flipoyo/MOLONARI1D/hardware/specs/README.md

# Hardware Specifications

This directory contains the hardware specifications and designs for MOLONARI1D monitoring devices.

## Contents

- **v1-until-2024/**: specifications of the first version of the MOLONARI1D device (v1) with all the developpments until 2024 
- **v2-2025/**: all the specifications of the new MOLONARI1D system (v2) developped by the 2025 team

For programming and firmware, see the `hardware/firmware/` subdirectory.
