flipoyo/MOLONARI1D/hardware/specs/v2-2025/sensors/README.md

# Specifications of the MOLONARI 1D device's sensors 

The sensors are all connected to one box that remains under water. The electronics is detailed in **hardware/firmware**

## Contents 

- **box/**: Building of the metal box 
- **differential pressure sensor/**: Specifications of the pressure sensor with calibration
- **shaft/**: Specifications and 3D printing files for the shaft
- **temperature sensor/**: Specifications of the temperature sensor with calibration
