flipoyo/MOLONARI1D/hardware/specs/v2-2025/relay/README.md

# Specifications of the relay 

The relay is constituted of a box on the riverbank in which an electronic circuit with an antenna and a 3.7V Li-ion battery is put. 

Here is a picture of the box on the riverbank : 

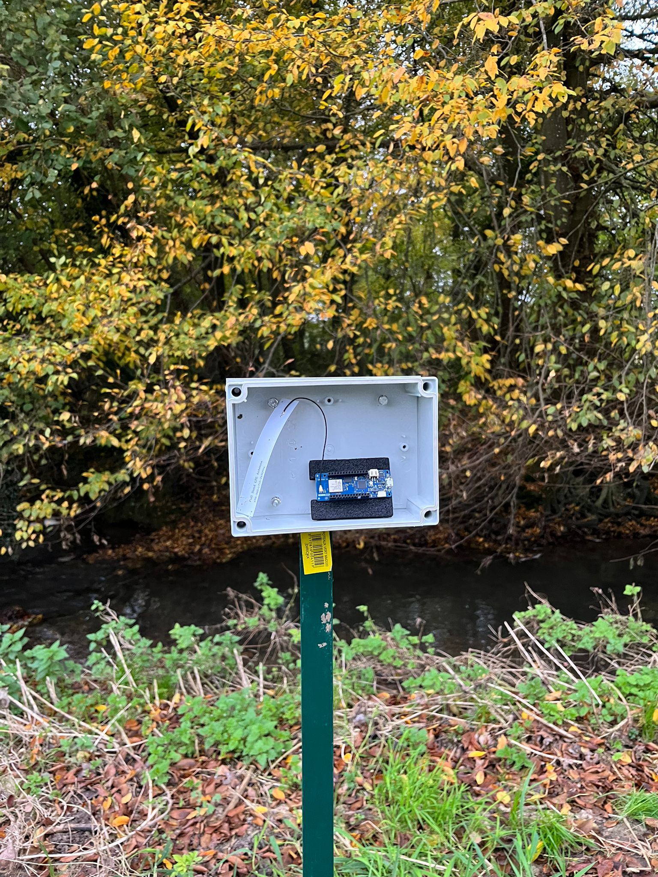
[picture p10: hardware/specs/v2-2025/relay/relai_box.jpeg]
Relay box


For specifications of the electronic circuit, please consult 'hardware/specs/v2-2025/electronic connexion/Readme.md'.
