flipoyo/MOLONARI1D/hardware/specs/v1-until-2024/differentialPressureSensor/README.md

# Building the differential pressure sensor

Find the component list in XXXX

The building scheme in XXXX

The device includes a pressure differential measurement system that needs a sacrificial tip. Its dimensions are given in dimensionSacrificialTip.JPG
