flipoyo/MOLONARI1D/hardware/specs/v1-until-2024/distributedTemperatureSensor/README.md

# Building the distributed temperature sensor

Find the component list in XXXX

3D printing files and dimensions for the thermometer shaft are available in the "shaft" folder.
