flipoyo/MOLONARI1D/hardware/docs/5bis - Gateway and server configurations.md

# Backup on the server

After having understood the Lora communication and managed to receive the data in our relay, we must continue with the following communication stages: *communicate with the gateway and send the information to the server*.

First, the configuration of the Gateway, the device we will use to connect our Relay (which is next to the river) with the Server (on the internet).

Second, the configuration of the Server, necessary to receive and process the information without needing to go to the field.

# Materials

The materials we will need are:

- A computer that allows ethernet connection (the classroom computer at Mines can be used)
- Two ethernet cables (one to connect the Gateway to the PC and another to connect to the internet)
- An antenna
- A power supply that provides between 9 and 60V DC

# Gateway Configuration (Robustel R3000 - LG4LA)

The steps to achieve a satisfactory connection with the Gateway are:

0) Start and connect to the Gateway
1) Update Firmware and Applications
2) Establish the internet connection
3) Configure the connection type
4) Extra configurations
5) Error visualization

It is **VERY IMPORTANT** to emphasize from the beginning that, for step (2) if you have any kind of problem, it is necessary to talk to the school's IT department, specifically with Riaz SYED, since the school blocks all types of connections outside the most common ports. Therefore, only they can enable internet connections through different ports.

**Email: riaz.syed@minesparis.psl.eu**

(We strongly recommend contacting Riaz SYED in case of any eventuality, we started talking to him late and if we had done it earlier, we would have saved a lot of time)

## Step 0 - Start and connect to the Gateway

To start, the first thing we need to do is connect the Gateway to the power supply.

Then we need to connect the ethernet cables:
- ETH1 port: connect it to the PC
- ETH0 port: connect it to the Internet

Once this is done, go to a browser and type in the search bar: 192.168.0.1

This should give us access to the Gateway's online interface.

Connection failure: if entering the IP in the browser does not find the page, reverse the connection of the cables in the ethernet ports, this will probably solve the error.

## Step 1 - Update Firmware and Applications

Next, we need to log in to the Gateway's online interface, for which the username and password will be:

- Username: admin
- Password: admin

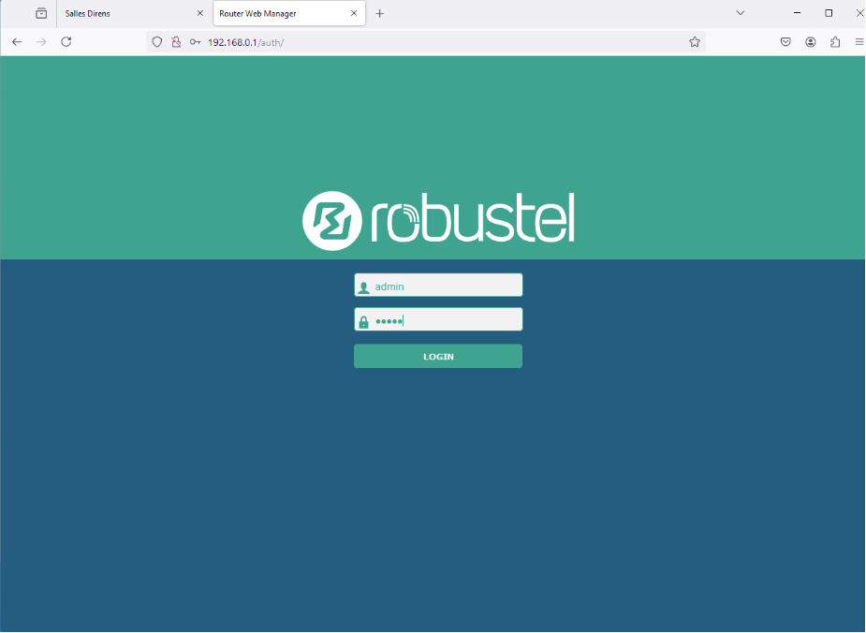
[picture p20: hardware/docs/Images/Robustel_login.png]


Once inside, we will look for the Firmware and applications version.

The Firmware version is in the "Status" section, which opens by default when entering the online interface. Therefore, in the "System Information" section, we can read "Firmware Version".

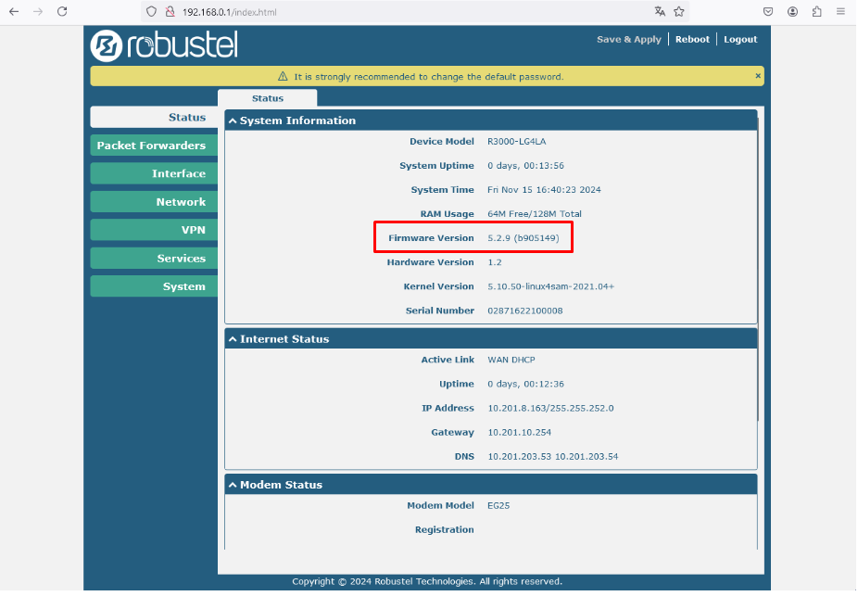
[picture p21: hardware/docs/Images/Firmware_version.png]


The applications version is in the "System" section, in the "App Center" sub-section. There we will see a table called "Installed Apps", where one of the columns is "Version".

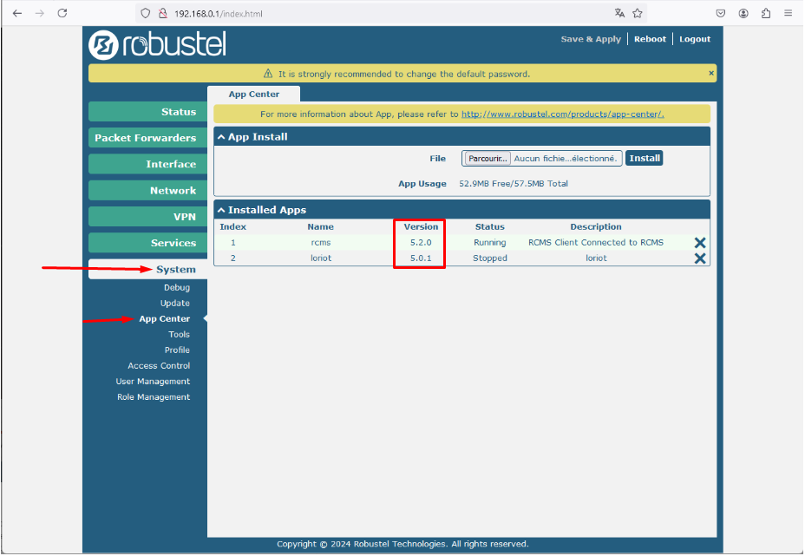
[picture p22: hardware/docs/Images/App_version.png]


Now that we know the versions installed on our device, we need to go to the following provider page:

https://rcms-cloud.robustel.net/rcms/index

Where we need to create an account (with the MINES email it is possible).

Once logged into the page, in the top bar there is a section called "App Center".

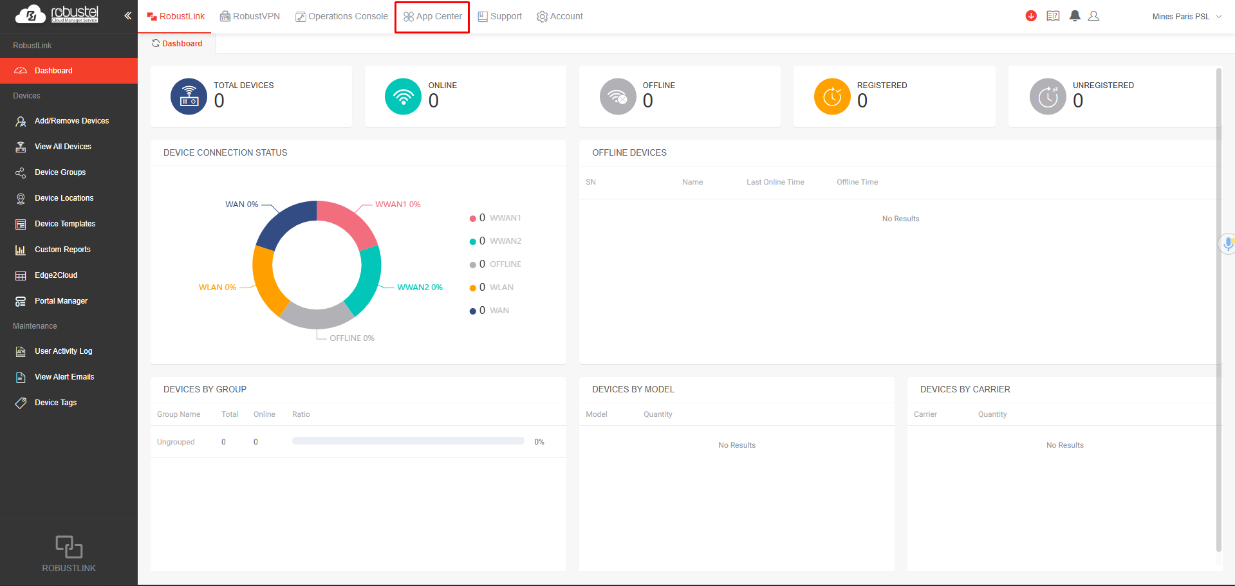
[picture p23: hardware/docs/Images/Robustel_page.png]


Inside there, we have three sections, of which the ones we are interested in are: Firmware and RobustOS App.

In both sections of interest, we must filter by "Series", choosing the option "R3000 LG Series". And what we will do, whether in Firmware or RobustOS App, is to see what is the latest available version compatible with our device.

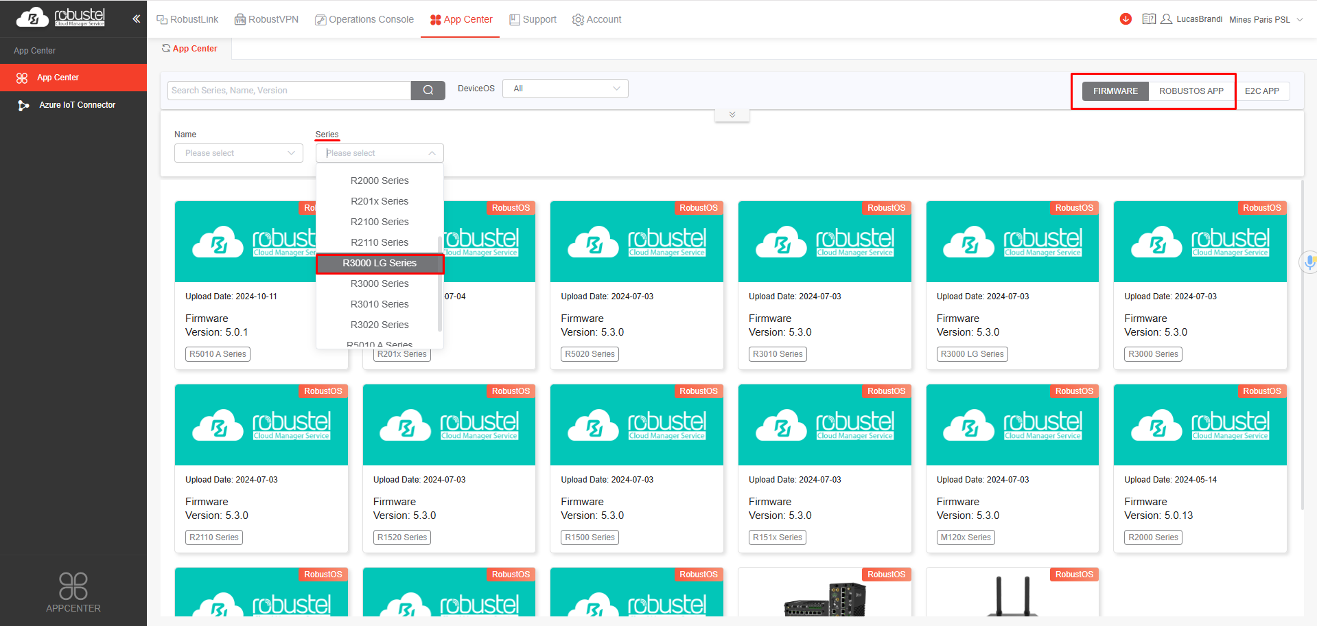
[picture p24: hardware/docs/Images/Uses_app_robustel.png]


If the installed version we saw before matches the latest available version compatible with our Gateway, this section ends here, you can move on to the next one.

If the installed version we saw before does not match the latest available version compatible with our Gateway, what we need to do is the following:

For the Firmware case, we will go to the "System" section, "Update" sub-section. Inside there, we will go to the "Firmware Update" tab, where we will upload the file we downloaded, by clicking on "Browse.." and then update by clicking on "Update".

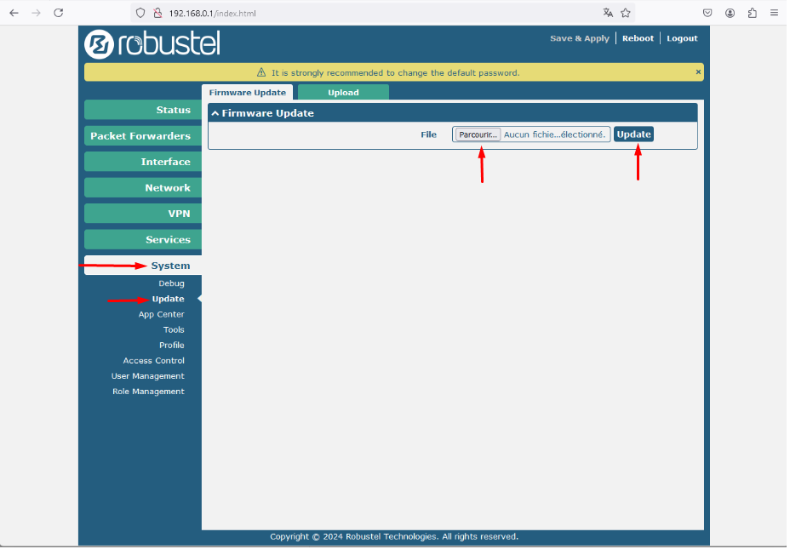
[picture p25: hardware/docs/Images/update_firmware.png]


For the applications case, we will go again to the "System" section, "App Center" sub-section, and there in the "Installed Apps" table we need to do the following:

First, click on the cross on the right to delete the installed versions.

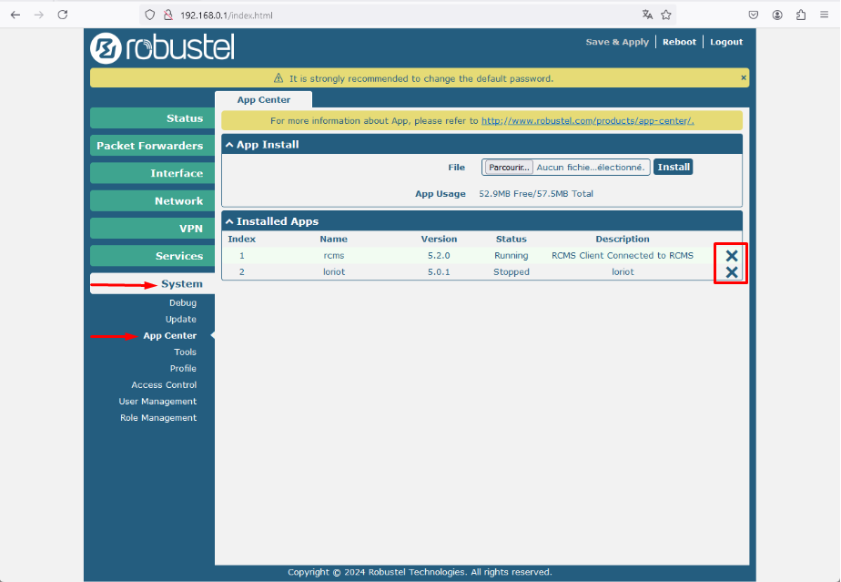
[picture p26: hardware/docs/Images/delete_apps.png]


Then, upload the downloaded files to install them. To do this, click on "Browse.." and then install by clicking on "Install".

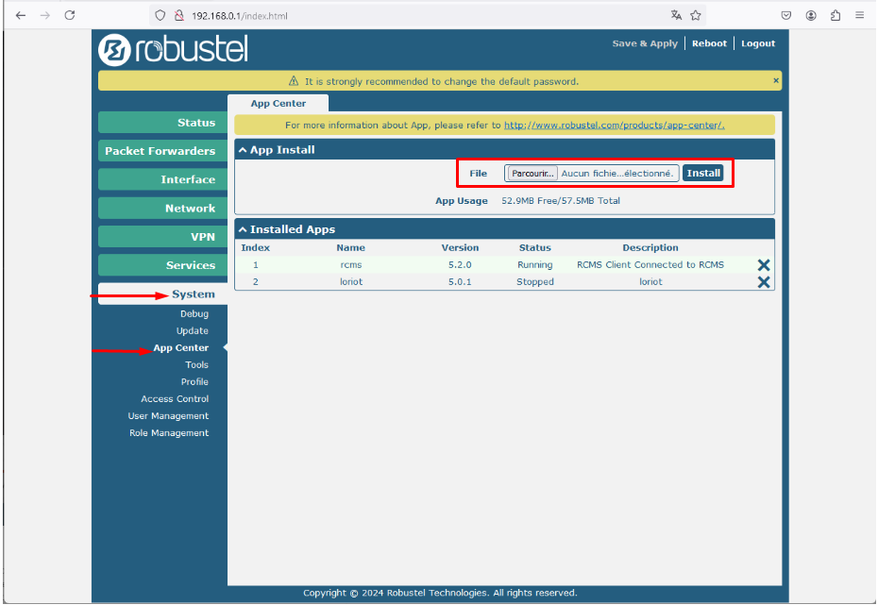
[picture p27: hardware/docs/Images/put_apps.png]


## Step 2 - Establish the internet connection

To verify internet access, we need to go back to the "Status" section of the Gateway's online interface and observe the "Internet Status" part. If it is blank as in the following image:

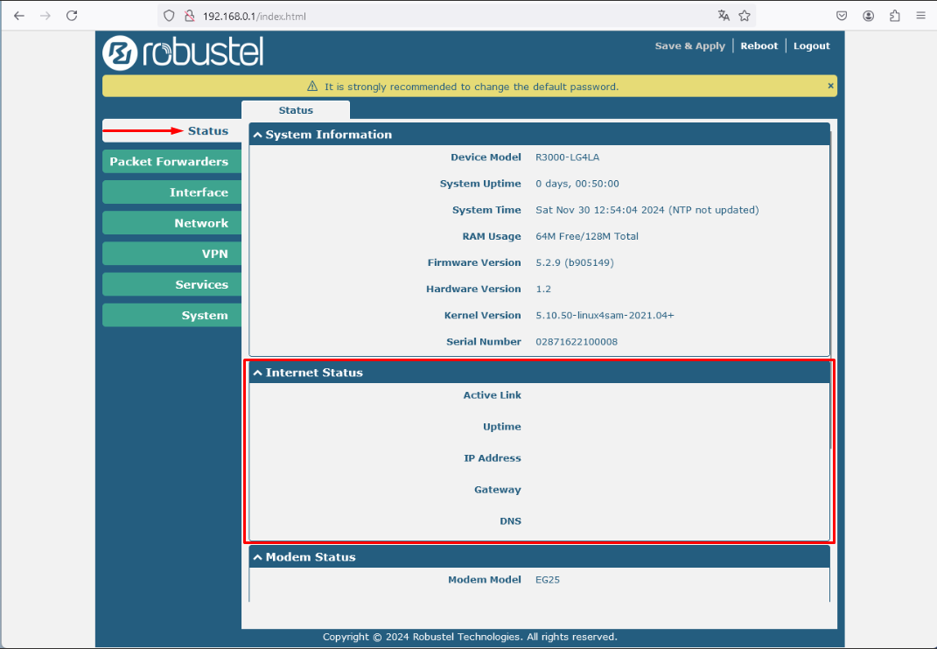
[picture p28: hardware/docs/Images/status_internet.png]


We need to configure the connection as indicated below.

If we see values, as in the following image:

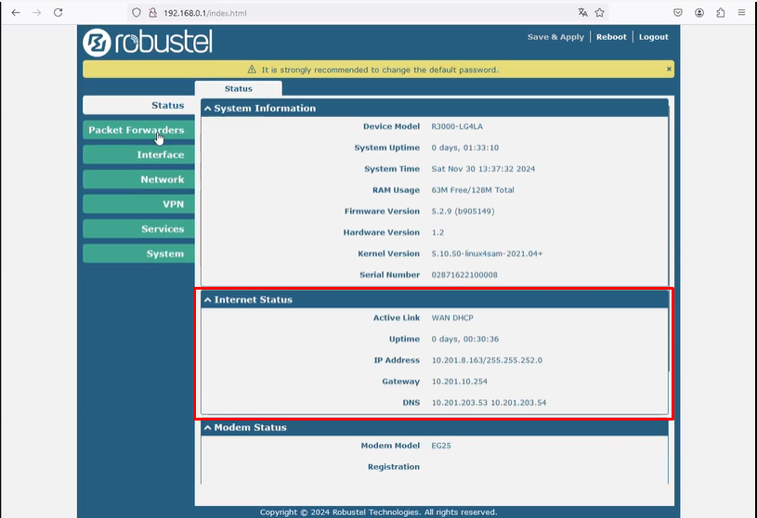
[picture p29: hardware/docs/Images/internet_connection2.png]


It means the connection is established. We can skip the next section and go directly to Verification using Ping.

### Connection configuration

To configure the internet connection, we need to go to the "Interface" section, "Ethernet" sub-section.

Once there, we will see a table called "Port Settings", where each row indicates the characteristics of each ethernet port. This table should look like the following image:

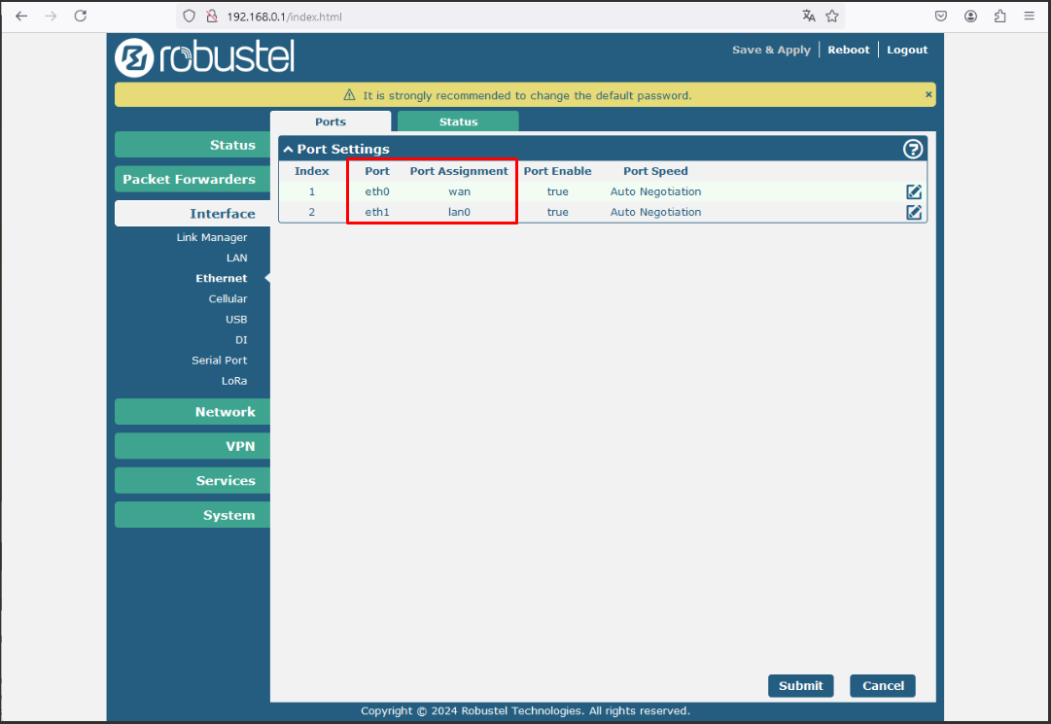
[picture p30: hardware/docs/Images/port_ethernet.png]


Where the most important thing is what the "Port Assignment" column indicates for each of the ports.

If you do not see a table identical to the one above, what we need to do is:

In the row of the "eth0" port, click on the pencil symbol on the right:

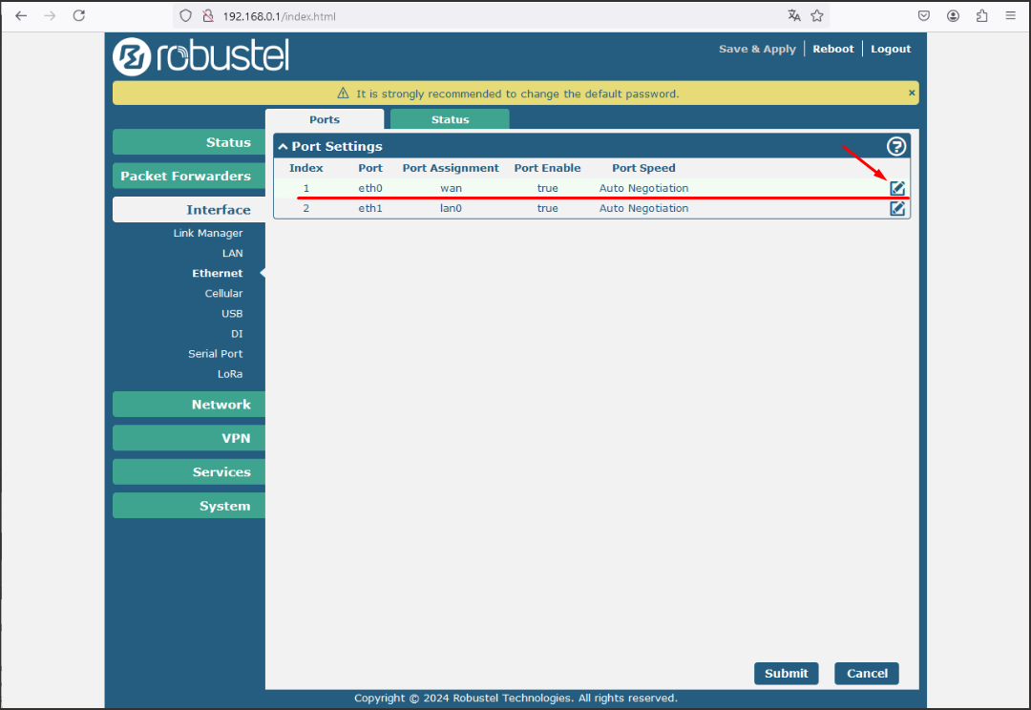
[picture p31: hardware/docs/Images/pencil_eth0.png]


This will open a window called "Port Settings", where what we are interested in is modifying the "Port Assignment", for which we must display the list of options and choose "wan".

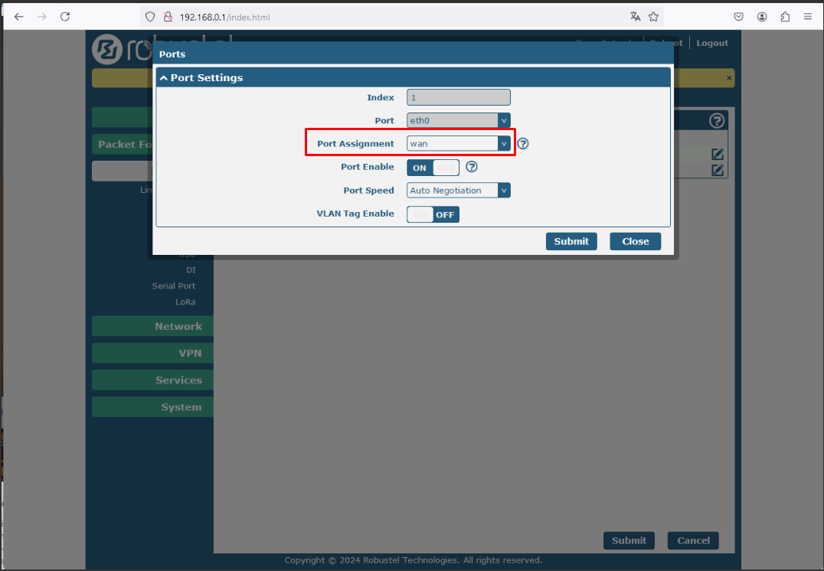
[picture p32: hardware/docs/Images/port_assignement.png]


Then, click on "Submit", and to finish, we must click on "Save & Apply" which we will see in yellow.

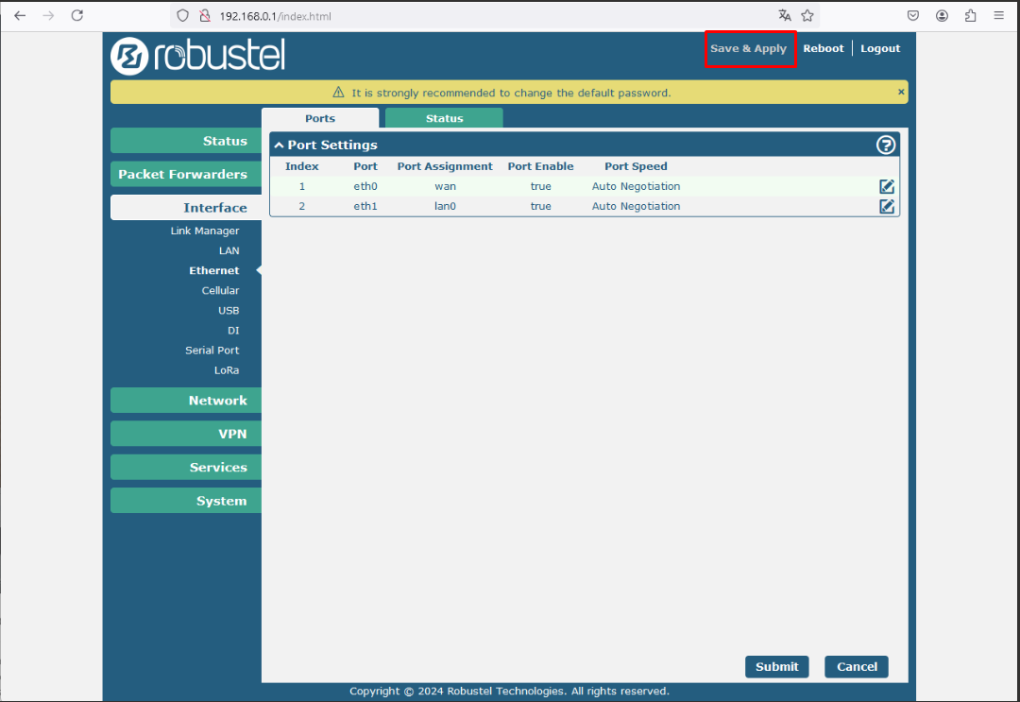
[picture p33: hardware/docs/Images/save_apply.png]


By doing this, the gateway will lose connection to the computer. What we need to do is reverse the connection of the ethernet cables in the ports, being the new connection as follows:

- ETH1 port: connect it to the PC
- ETH0 port: connect it to the Internet

Once this is done, we would have a connection to the Gateway's online interface again, and an internet connection.

To verify it, for safety, the steps indicated in Verification using Ping must be performed.

### Verification using Ping

We will perform the following verification for safety:

We will go to the "System" section, "Tools" sub-section, and in the "Ping" window, we must enter the value: 8.8.8.8 in IP Address.
Then click on "Start".

If the message we get is like the following:

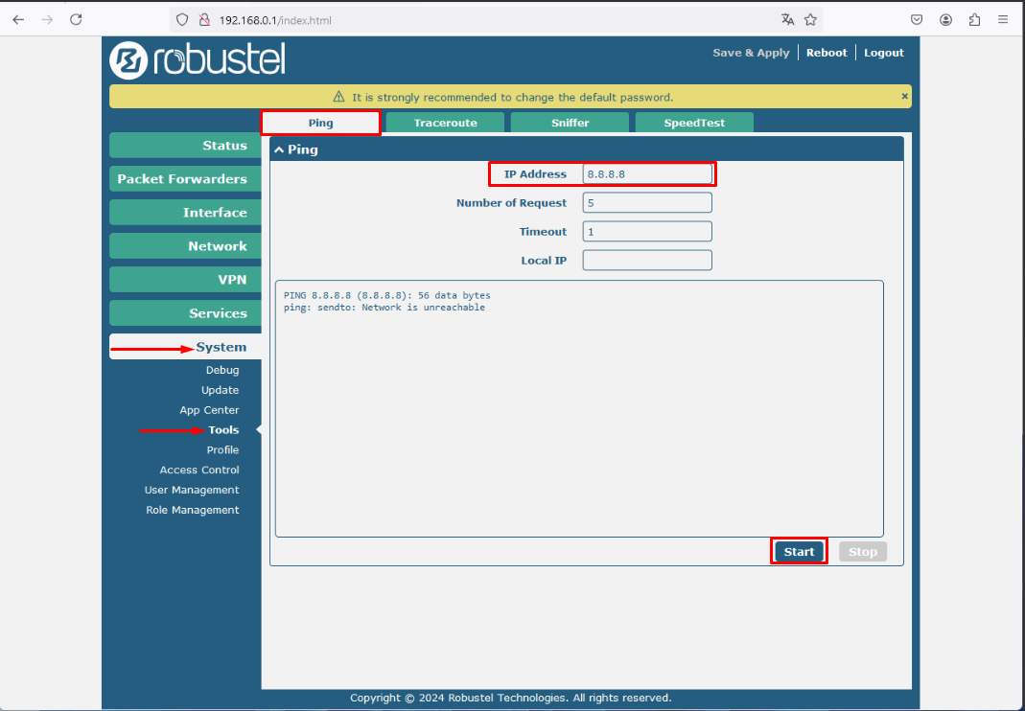
[picture p34: hardware/docs/Images/ping_try.png]


It means the connection was not successful, it is necessary to talk to Riaz SYED, because there is a connection problem and it is probably the school's Firewall.

If the message we get is like the following:

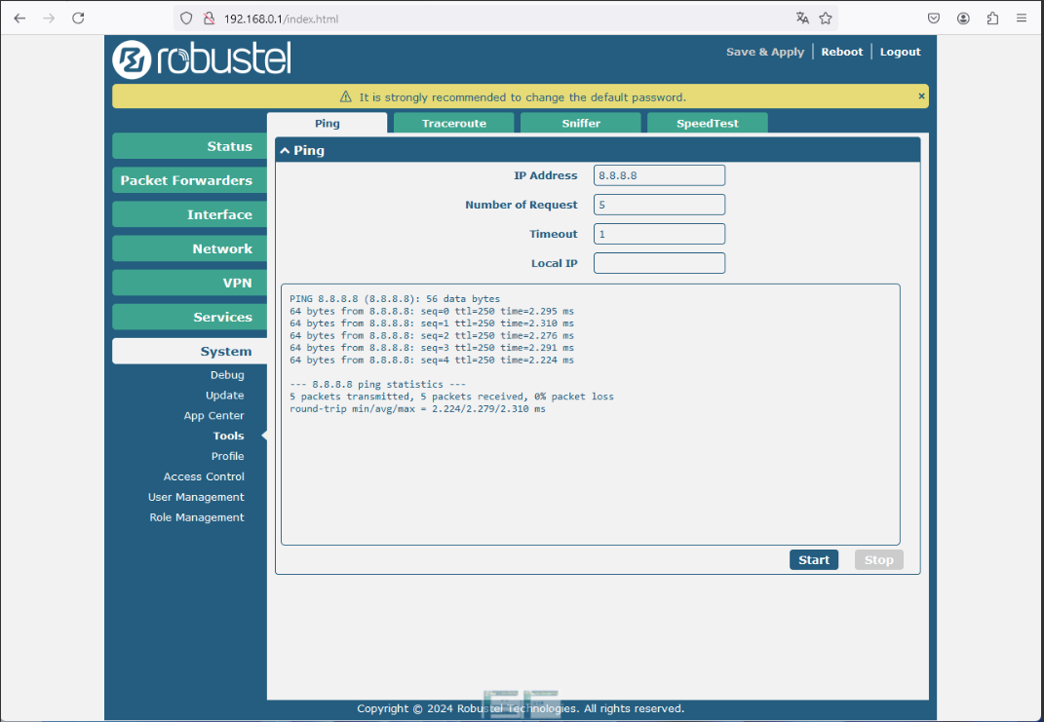
[picture p35: hardware/docs/Images/ping_works.png]


The connection was successful, no configuration changes are necessary, you can move on to the next section.

## Step 3 - Configure the connection type

Here we will configure the type of connection that will be established between the network and the Gateway.

To do this, we must go to the "Packet Forwarders" section, and the first thing we need to do is disable both "Loriot" and "Semtech UDP Forwarder" which we will not use. To do this, we will enter the corresponding sub-sections, and where it says "Enable" we must verify that it is indicated "OFF".

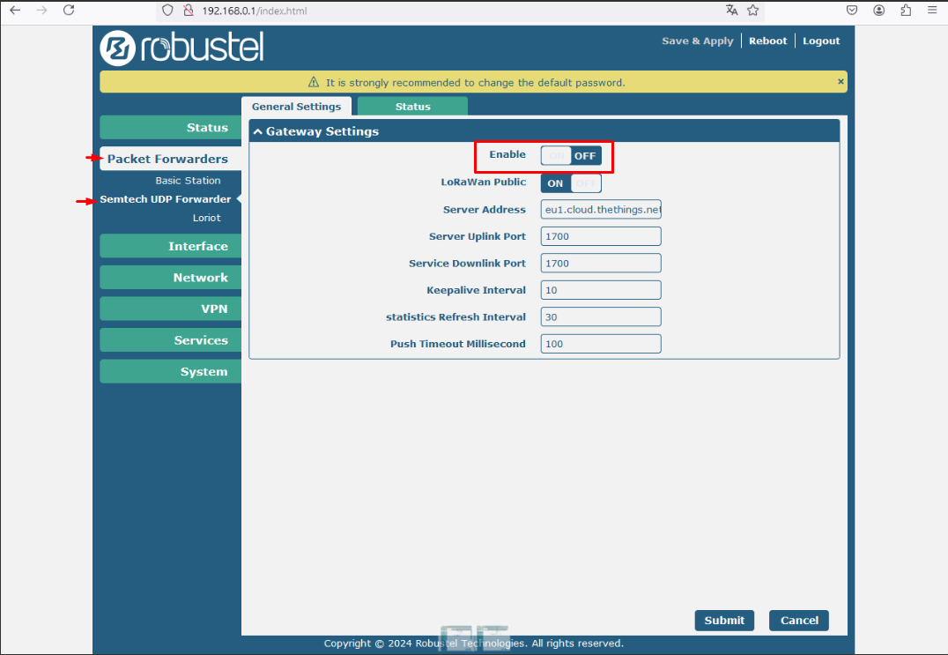
[picture p36: hardware/docs/Images/off_semtech.png]


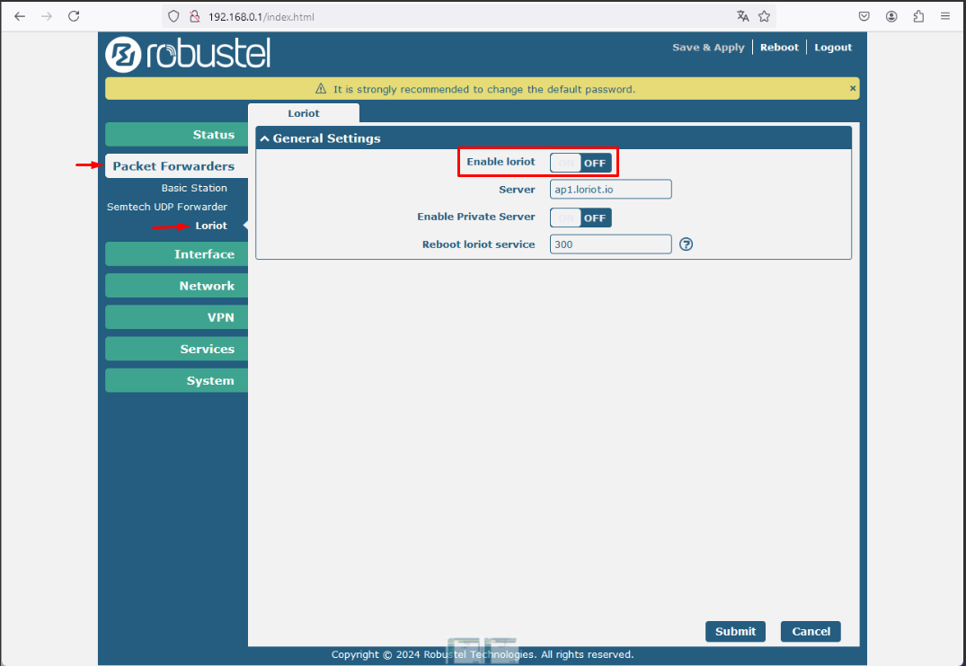
[picture p37: hardware/docs/Images/loriot_off.png]


Once this is done, we will go to the "Basic Station" section which is of interest. And there the necessary configuration is as follows:

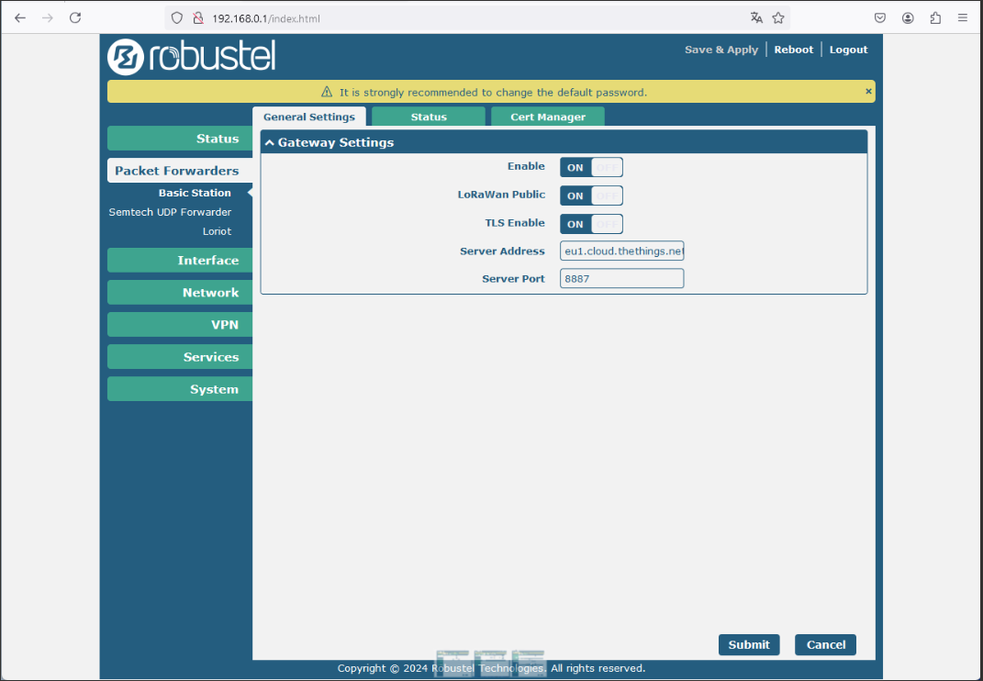
[picture p38: hardware/docs/Images/basic_station.png]


The information to complete is:

- Server Address: eu1.cloud.thethings.network
- Server Port: 8887

And it must be "ON" as seen in the image: Enable, LoRaWan Public, and TLS Enable.

Then, we must go to the "Cert Manager" tab, and there we must upload the "CA Cert" and the "Client Key".

To obtain the "CA Cert" we must go to the following link:

https://letsencrypt.org/certificates/

And download the file provided by the page by clicking on "pem", as indicated in the following image:

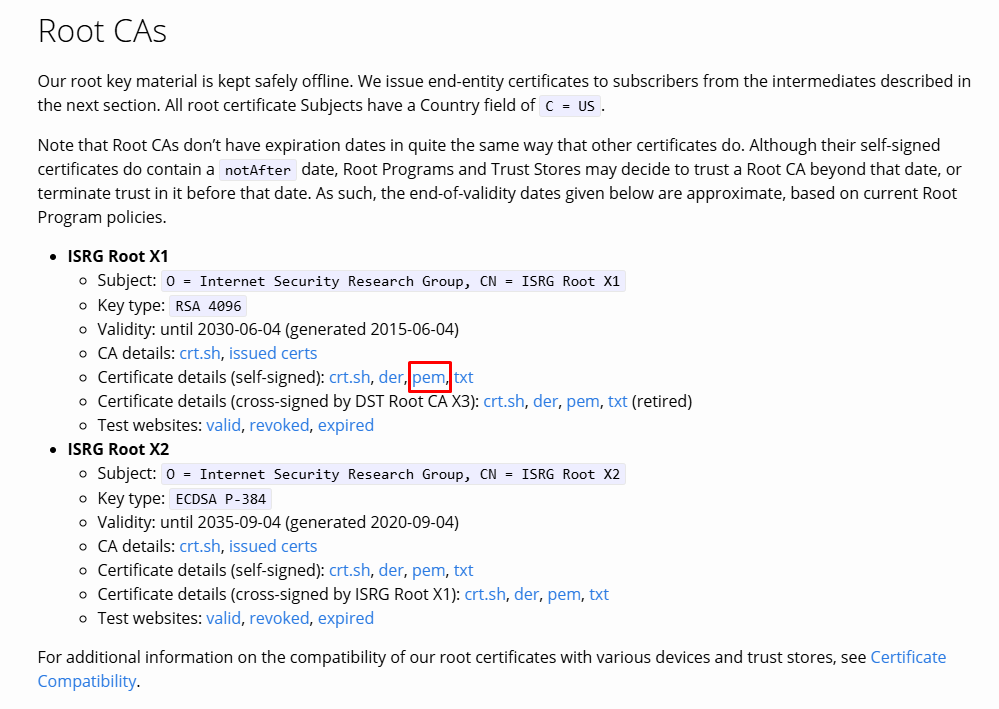
[picture p39: hardware/docs/Images/root_pem.png]


And to generate the "Client Key", we must follow the steps indicated in the following tutorial:

https://www.thethingsindustries.com/docs/gateways/concepts/lora-basics-station/lns/

With these two files downloaded/generated, we can upload them to our Gateway. To do this, we must click on "Browse" and then on "Import".

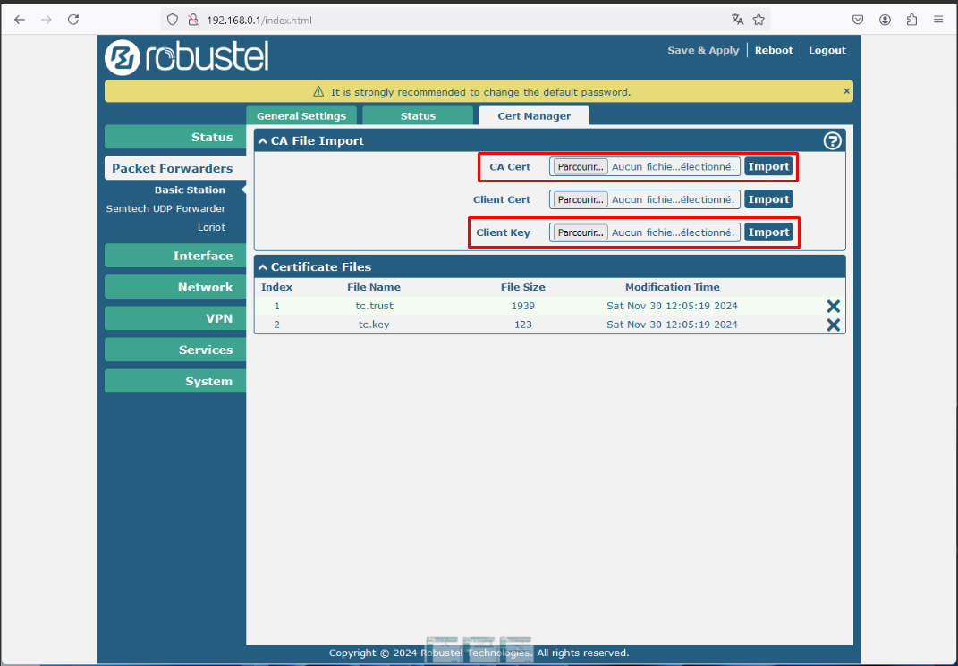
[picture p40: hardware/docs/Images/Cert_manager.png]


And finish by clicking on "Save & Apply", then on "Reboot".

Finally, it is necessary to contact Riaz SYED to request that the selected port associated with the server's IP address be enabled. Therefore, we must send him an email with:

- Server Address: eu1.cloud.thethings.network
- Server Port: 8887

And once Riaz SYED confirms that it has been enabled, we will consider this section finished.

## Step 4 - Extra configurations

Here we will detail some additional configurations that must be made for optimal operation.

An additional configuration for the better operation of the Gateway is to modify the NTP. To do this, we must go to the "Services" section, "NTP" sub-section.

There we will modify the "Time Zone" to: "UTC+01:00"

And in "NTP Client Setting", we must set "Enable" to "ON", and in "Primary NTP Server" the IP will be: pool.ntp.org

The configuration will be:

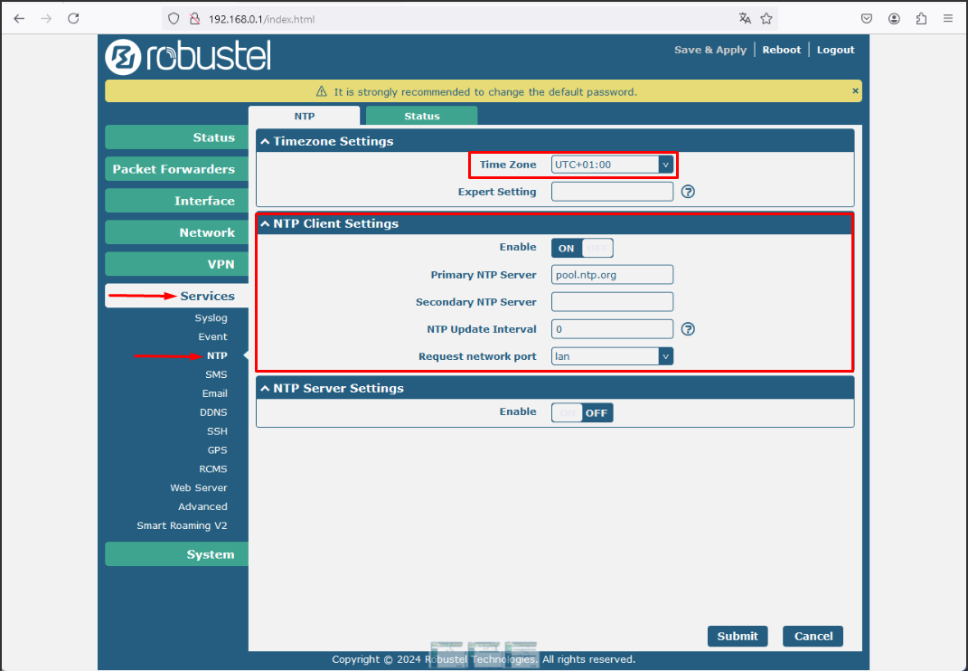
[picture p41: hardware/docs/Images/ntp_config.png]


Here we need to contact Riaz SYED again, because to access this server we need to enable UDP Port 123. Therefore, we must send him an email with the information:

- Server Address: pool.ntp.org
- Server Port: 123

To enable this server.

Another additional configuration, to avoid unnecessary error messages, is to disable the GPS that we will not use, for that we will go to the "Services" section, "GPS" sub-section, and disable all options:

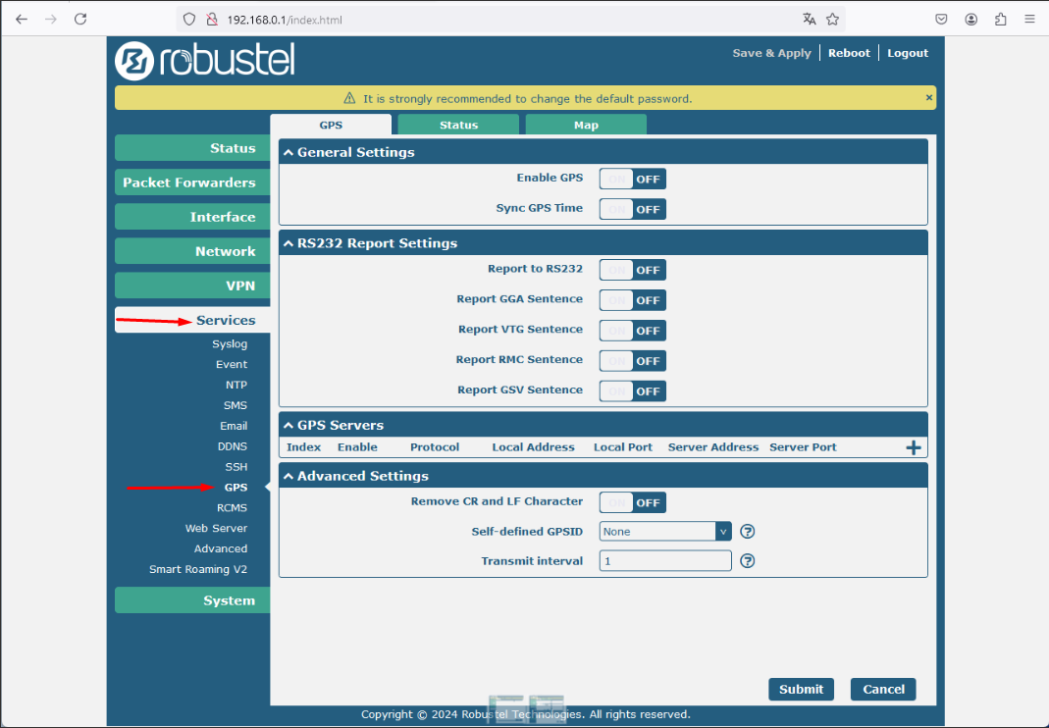
[picture p42: hardware/docs/Images/gps_off.png]


## Step 5 - Error visualization

To visualize that there are no errors, or what type of errors we are having, we must use the "Debug" tab.

To do this, we will go to the "System" section, "Debug" sub-section, and then click on the "Refresh" button to see the existing errors.

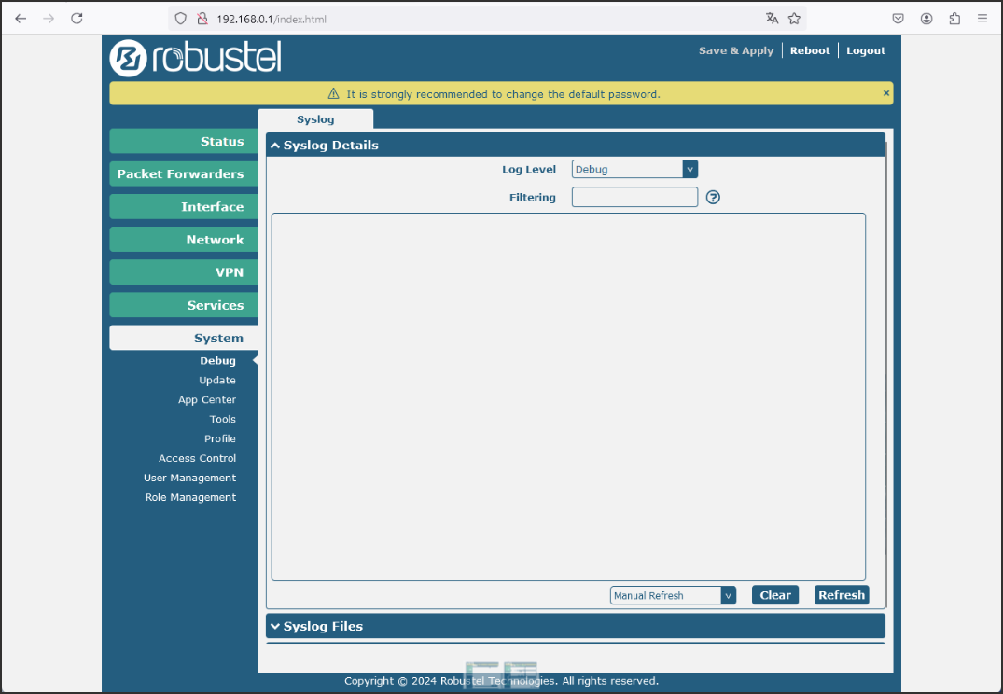
[picture p43: hardware/docs/Images/debug.png]


# Server - The Things Stack SANDBOX

## Server Configuration

### Create a TTN account

First, what we need to do is create an account on The Things Stack Network, for this we will enter the following link:

https://www.thethingsnetwork.org/

And in the upper right corner, click on "Login".

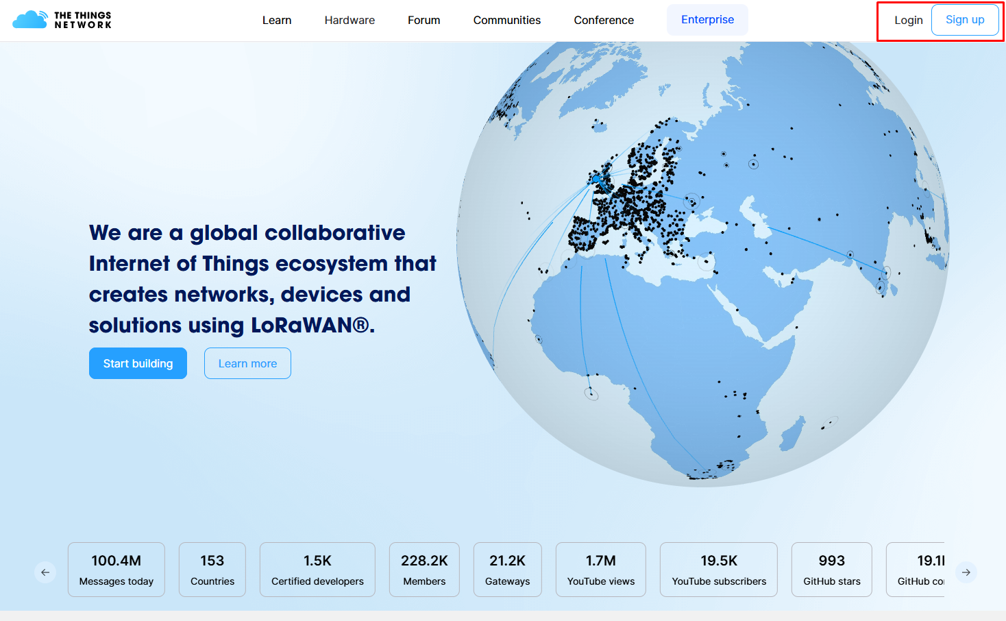
[picture p44: hardware/docs/Images/TTN_login.png]


Then, we choose the option "Login to The Things Network", and there we create an account.

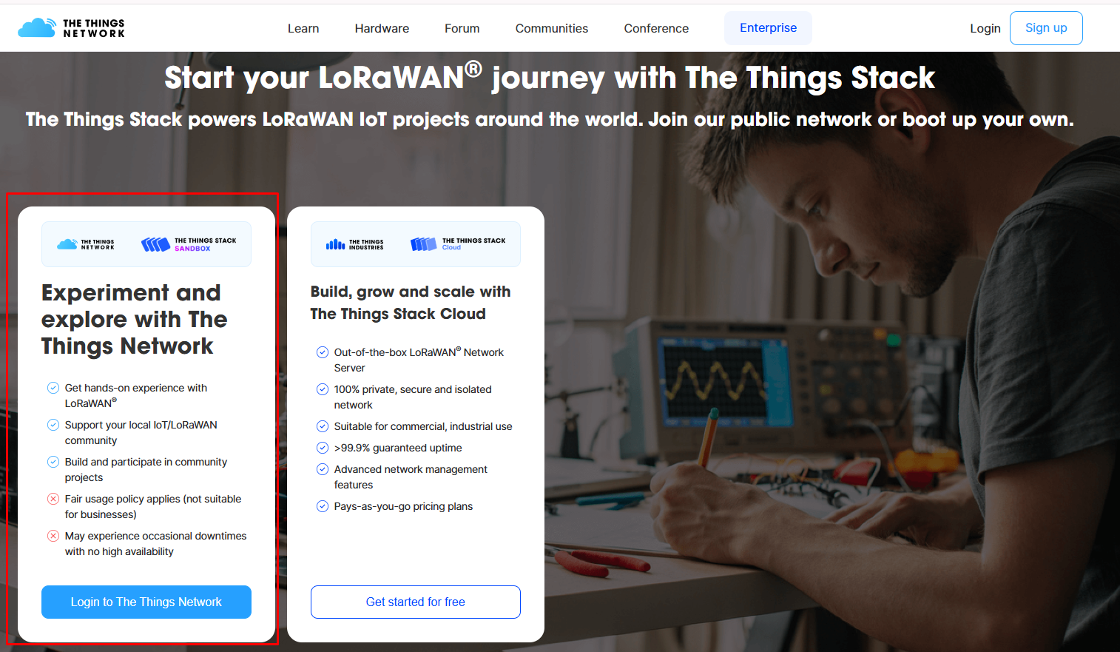
[picture p45: hardware/docs/Images/ttn_login_sesion.png]


Once the account is created, we must go to the upper right margin where the name we gave to the account appears, click, and choose the "Console" option. 

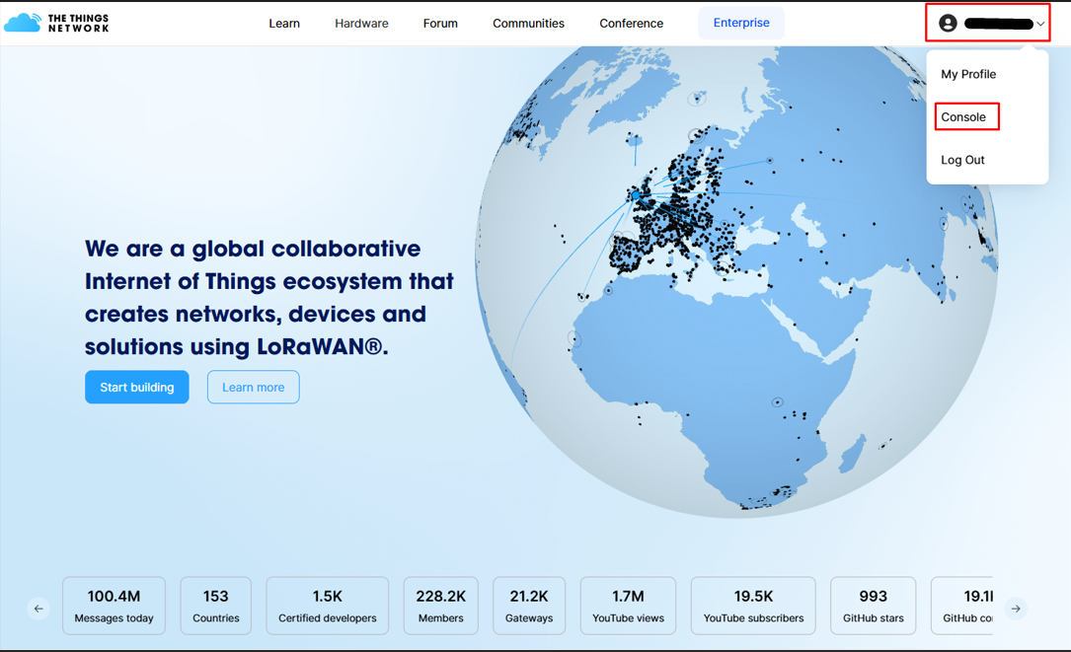
[picture p46: hardware/docs/Images/console2.png]


There, within the "Existing Clusters" we choose: Europe1

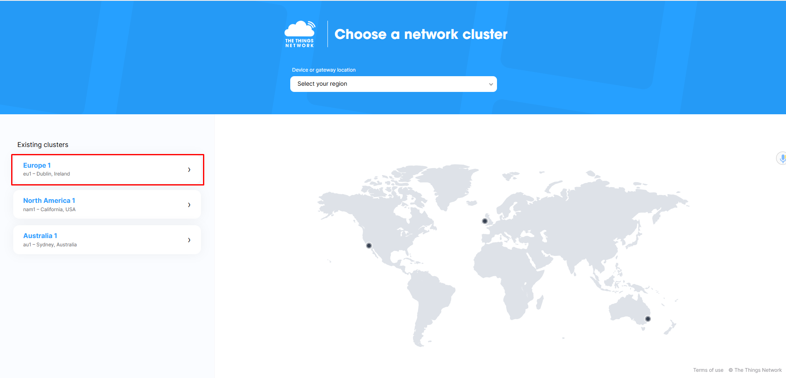
[picture p47: hardware/docs/Images/europe1.png]


Only here can we start configuring the devices, applications, and Gateway within the Server.

### Create the aplication

The first thing we will do is create an application, for this, on the left side we will see three options: Home, Applications, Gateways.

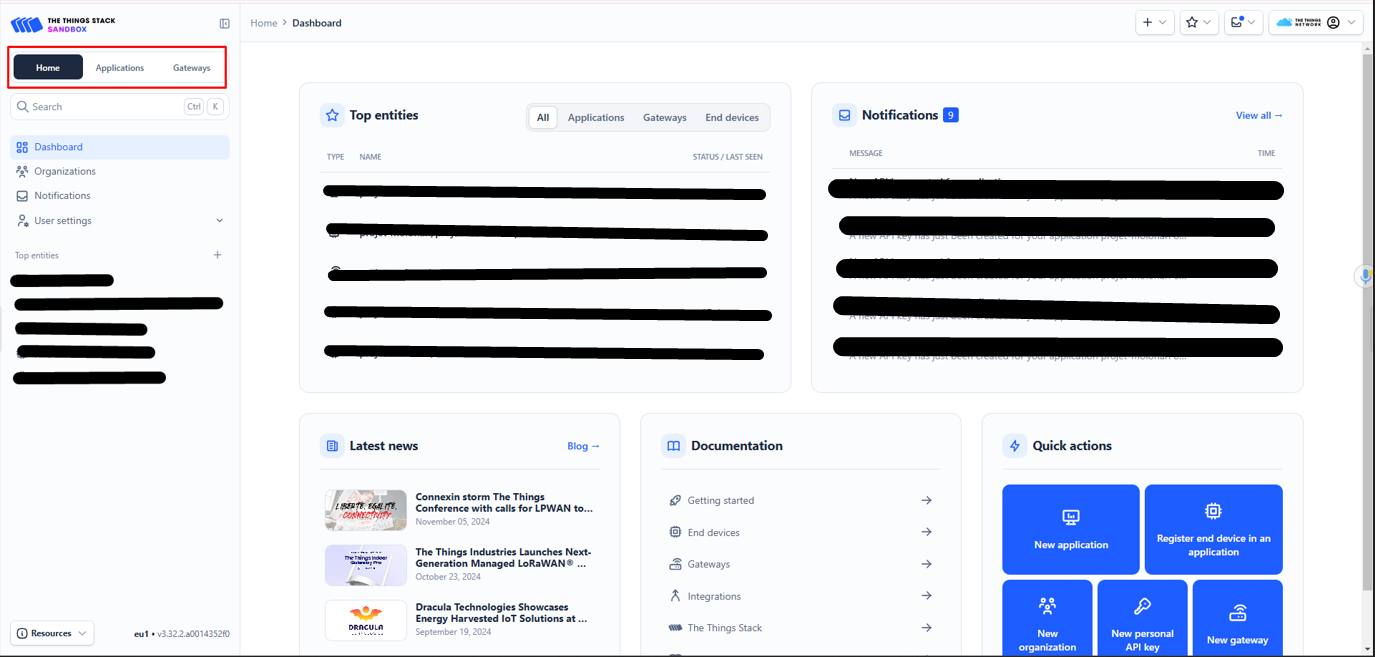
[picture p48: hardware/docs/Images/mainpage_TTN2.png]


Clicking on "Applications" and then on the "Add application" button.

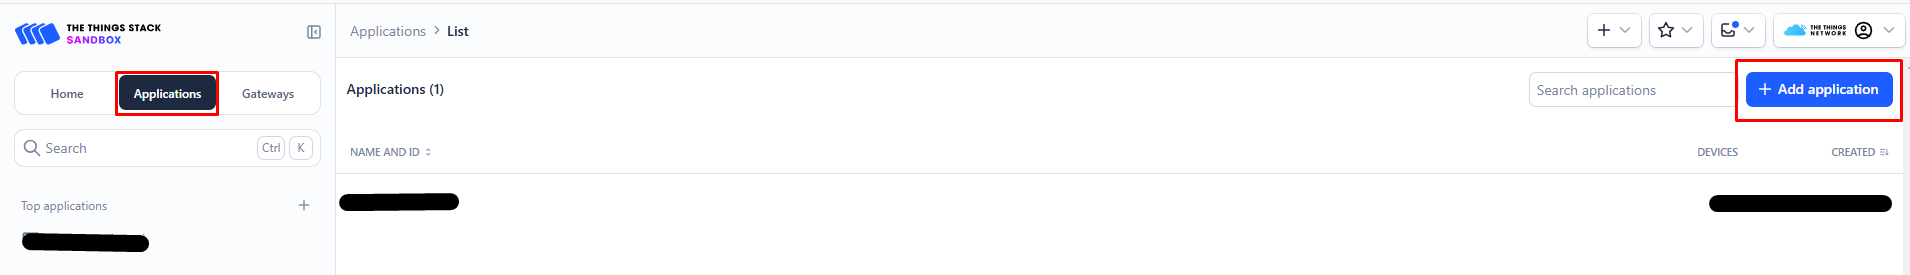
[picture p49: hardware/docs/Images/add_app.png]


We will give the application a name, the one we like the most (for example: "Molonari-Project") and to finish click on "Create application".

### Register the End Devices (the arduinos)

Once the application is created, within it we must register the "End devices", which in our case will be the Arduino that plays the role of the Relay. For this, in the right column, we will find the "End Devices" section, click there, and then on "Register End Device".

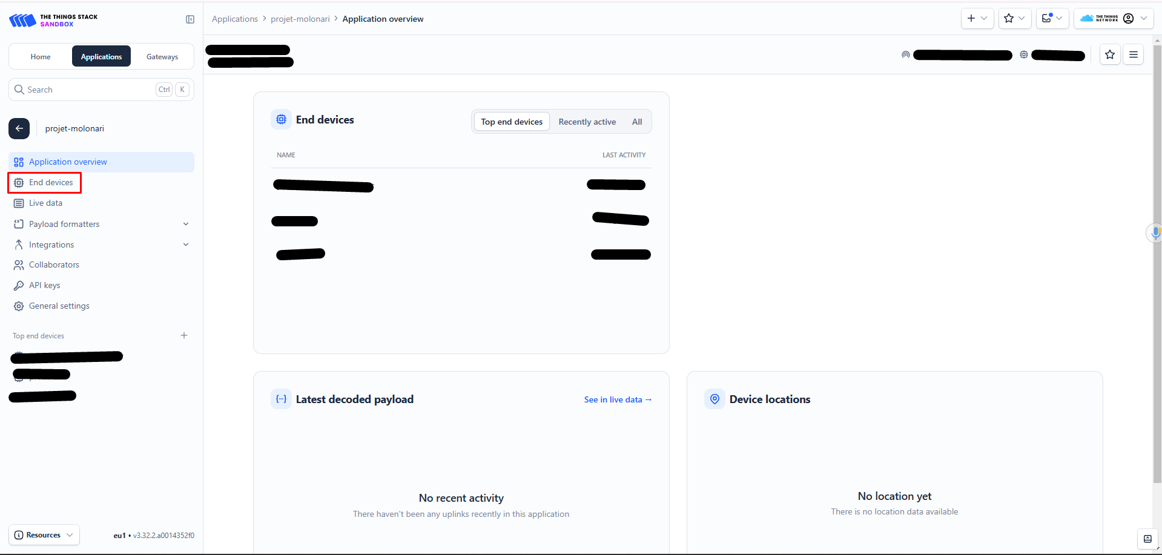
[picture p50: hardware/docs/Images/end_devices.png]


Once inside, we will choose the option "Enter end device specifics manually". And in the options they give us, we will put:

- Frequency plan: Europe 863-870 MHz (SF9 for RX2 - recommended)
- LoRaWAN version: LoRaWAN Specification 1.0.3

Then, within the "Provisioning information" section:

- JoinEUI: 00 00 00 00 00 00 00 00
- DevEUI: the value obtained by using the "DevEUI" code (found in the "Test Codes" folder, inside "testArduinoLoRaWAN") on the Arduino that will be our Relay.
- AppKey: we will generate it by clicking on "Generate"
- End device ID: we will give it the name we want (for example: Molonari-relay)

We will finish by pressing "Register end device".

It is IMPORTANT to emphasize here that the values of JoinEUI, AppKey, and DevEUI will be used in the Relay code to establish a connection with the server, so they must be saved and noted, to later place them in the Relay code. If these parameters are not modified in the code, the connection with the server will not be established.

### Register the Gateway

Finally, we must register the Gateway, for this in the right column we will change the section, and choose the "Gateways" option.

Once inside, click on the "Register gateway" button. 

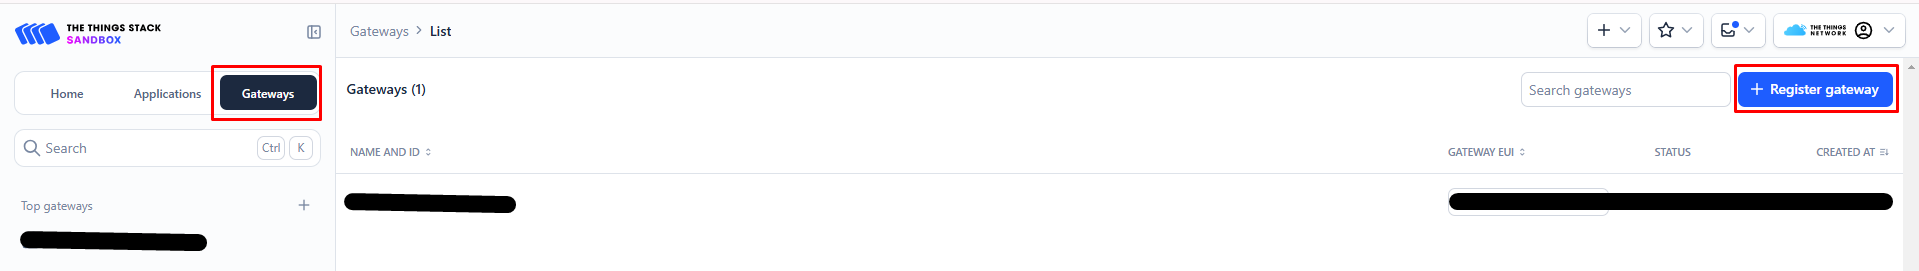
[picture p51: hardware/docs/Images/gateway_ttn.png]


There we must load:

Gateway EUI: this value will be found in the Gateway's online interface, in the "Interface" section, "LoRa" sub-section, it is the value called "Default Gateway ID".

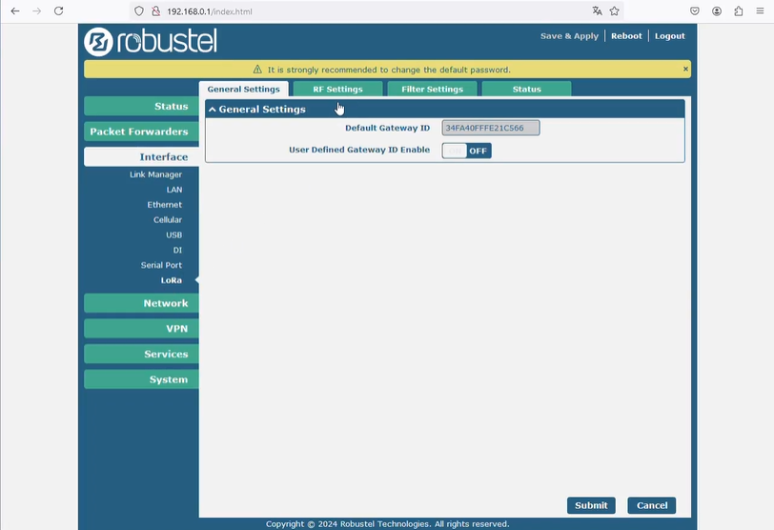
[picture p52: hardware/docs/Images/gateway_ID.png]


Once this value is registered, we must confirm it, and then complete:

- Gateway ID: we put the name we want (for example: Molonari-Gateway)
- Frequency plan: Europe 863-870 MHz (SF9 for RX2 - recommended)
- Require authenticated connection: we must check this option
- Share gateway information: both options are checked by default, we leave it that way.

With all this done, we will have our Gateway and Arduino registered, as well as our application created.
