flipoyo/MOLONARI1D/hardware/specs/v2-2025/README__#Overview_hardware_Molonari_1D_v2.0.md

# V2 Hardware Specifications

This directory contains the hardware specifications and designs for the version of MOLONARI1D monitoring devices (v2) developed by the 2025 team.

## Contents 

- **sensors/**: Specifications related to the pressure and temperature sensors
- **relay/**: Specifications of the relay
- **gateway/**: All the specifications related to the gateway
- **costs/**: Documents related to the costs audit
- **electronic connexion/**: Specifications of the electronic circuits (Arduino+Adalogger) used for the telecommunication and the taking of measurements 

## Overview of the complete MOLONARI1D System

## In the riverbed
### Metal Box with weight, seal and cover

Metal box with weight 

Seal and cover 

### Plastic hosepipe

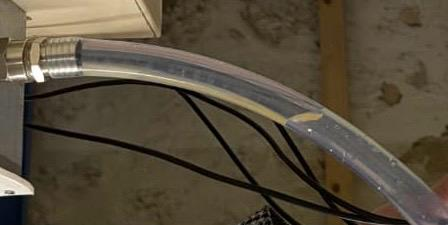
[picture p55: hardware/specs/v2-2025/Images/hose_pipe.jpg]
Hosepipe


It connects the shaft to the metal box.

### Shaft 

Shaft

### 5 Temperature Sensors

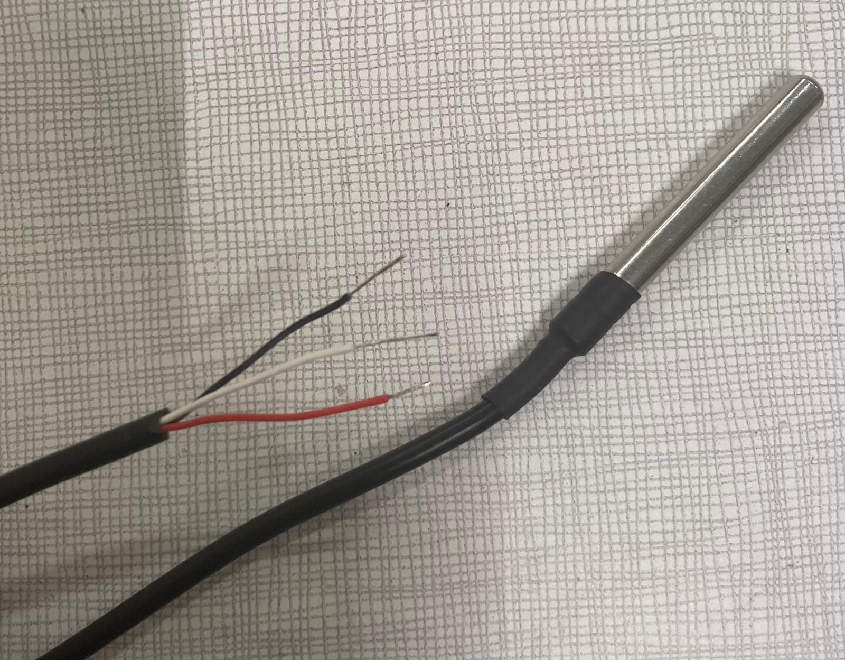
[picture p56: hardware/specs/v2-2025/Images/capteur_temperature_avec_cables.jpg]
Temperature sensor


### Electronic circuit with battery and waterproof antenna

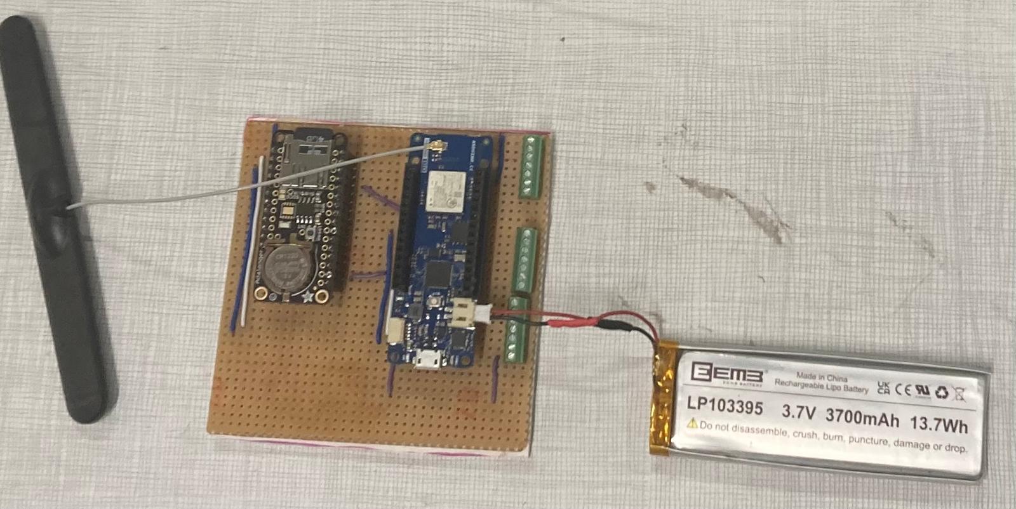
[picture p57: hardware/specs/v2-2025/Images/circuit_capteurs_avec_antenne_et_batterie.jpg]
Electronic circuit


It is inside the metal box.

### Pressure Sensor 

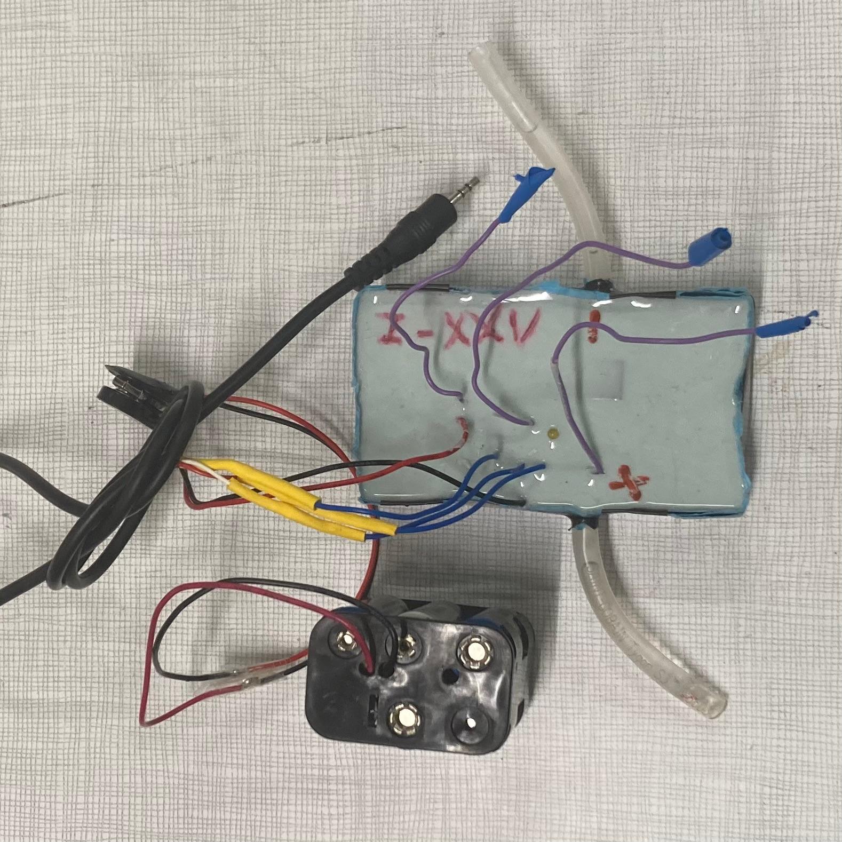
[picture p58: hardware/specs/v2-2025/Images/capteur_de_pression_avec_piles.jpg]
Pressure sensor


It is inside the metal box. 

### All components together

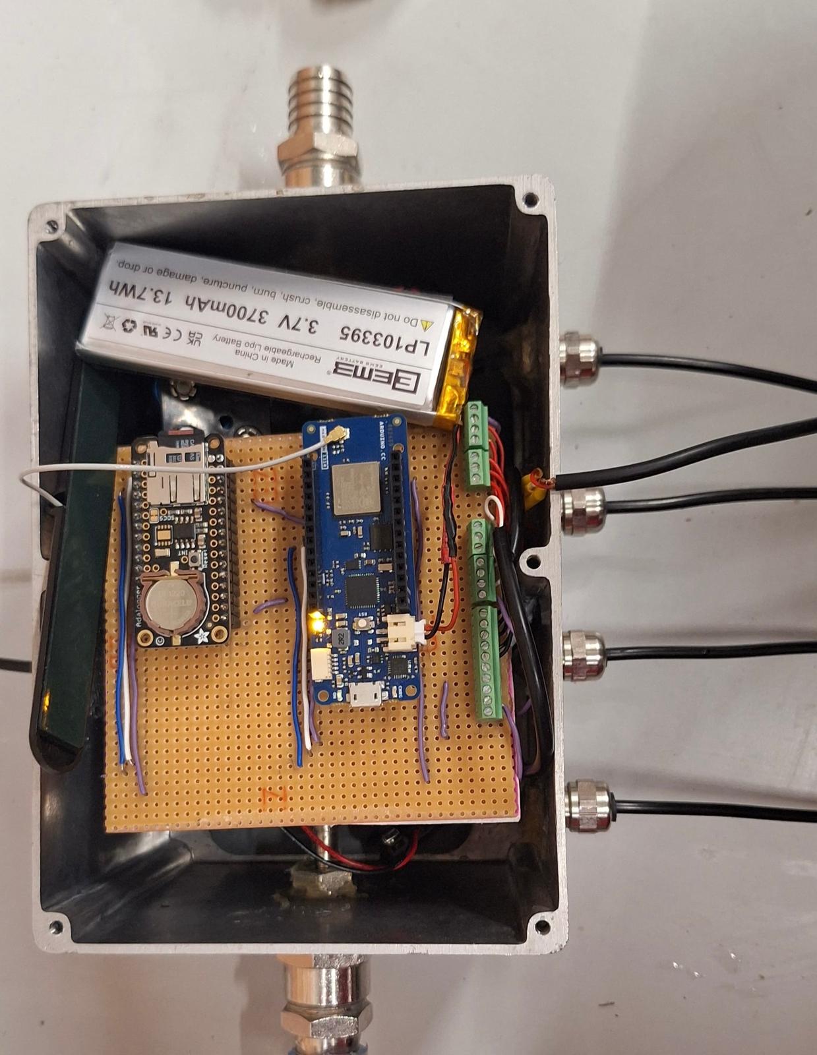
[picture p59: hardware/specs/v2-2025/Images/box_inside_1.jpg]
Box from inside


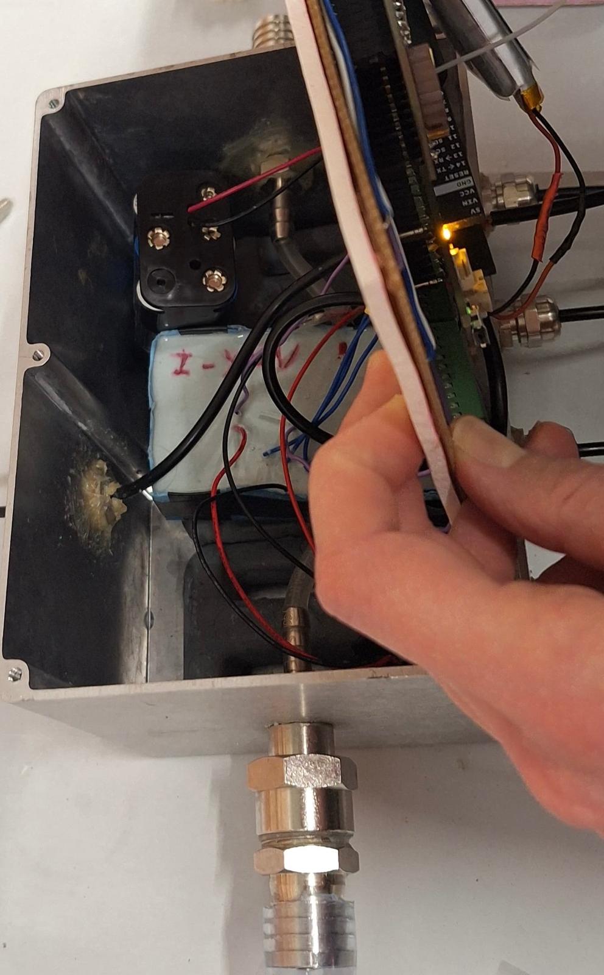
[picture p60: hardware/specs/v2-2025/Images/box_inside_2.jpg]
Box from inside 2


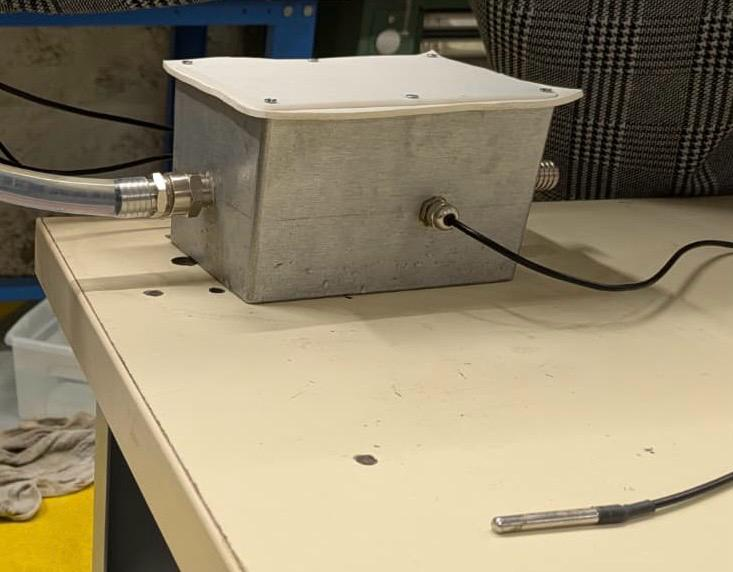
[picture p61: hardware/specs/v2-2025/Images/box_outside.jpg]
Box from outside


Complete MOLONARI1D System tested in laboratory

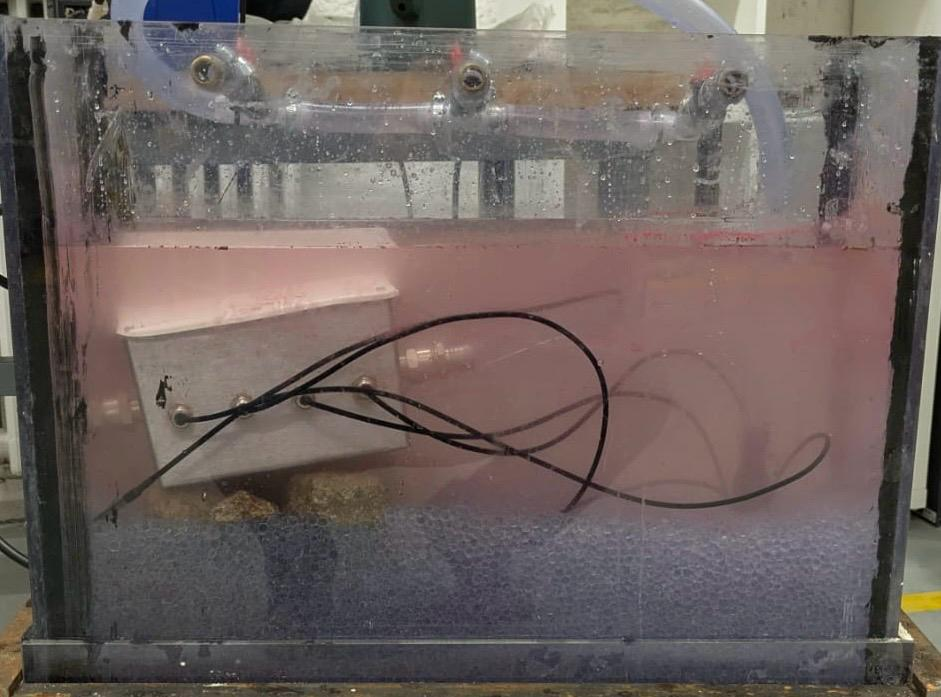
[picture p62: hardware/specs/v2-2025/Images/complete_molonari_system.jpg]
full system


## On the riverbank

### Electronic circuit with battery and antenna

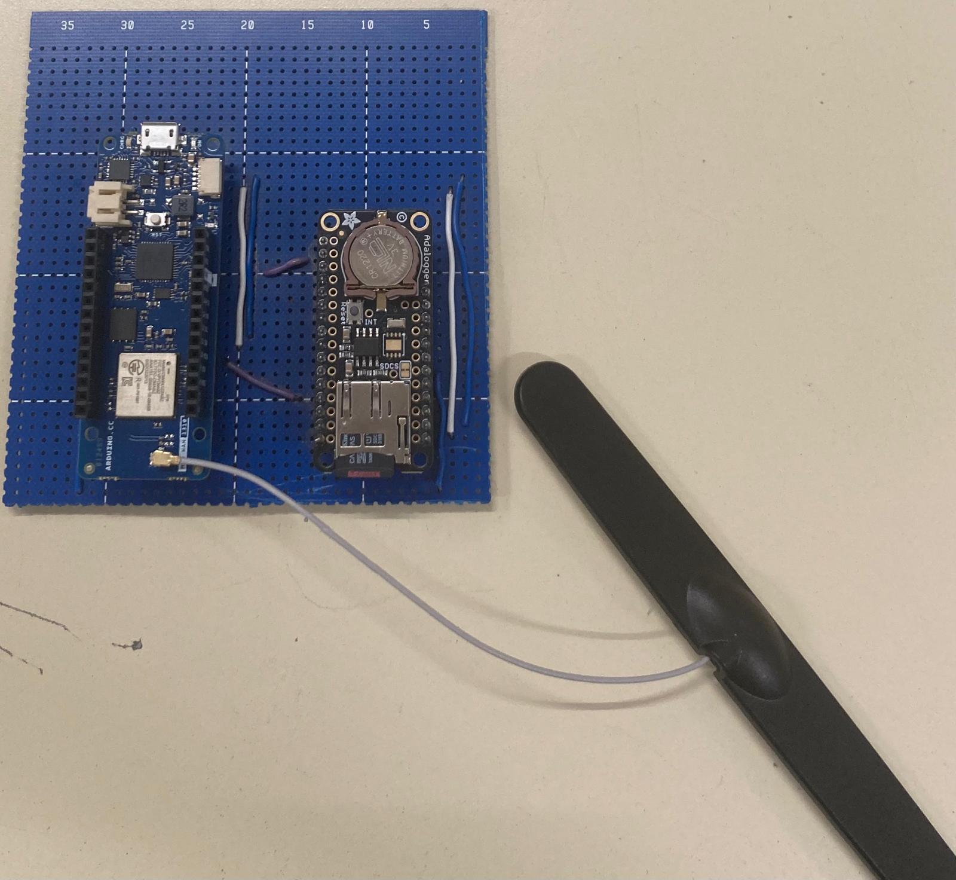
[picture p63: hardware/specs/v2-2025/Images/circuit_relai_antenne.jpg]
Electronic circuit


Relai picture
