flipoyo/MOLONARI1D/FUTURE_INITIATIVES.md

# Future Development Initiatives for MOLONARI1D

This document outlines additional initiatives and improvements that could further enhance the MOLONARI ecosystem for better collaboration and functionality.

## Completed in This Reorganization

✅ **Hardware Programming Restructure**: Organized into logical subprojects with shared libraries  
✅ **CI/CD for Hardware**: Arduino compilation validation and protocol testing  
✅ **Documentation Overhaul**: Comprehensive guides for different developer types  
✅ **Repository Structure**: Clear separation between hardware, software, and data components  
✅ **Shared Library System**: Eliminated code duplication across Arduino projects  

## Recommended Additional Initiatives

### 1. Advanced CI/CD Enhancements

**Hardware Testing Automation**
- [ ] **Hardware-in-the-Loop Testing**: Automated testing with real Arduino hardware
- [ ] **Power Consumption Validation**: Automated battery life estimation in CI
- [ ] **Communication Range Testing**: Automated LoRa range validation with test setups
- [ ] **Memory Usage Analysis**: Track firmware memory usage and optimize for constraints

**Software Quality Assurance**
- [ ] **Code Coverage Reports**: Track test coverage for Python components
- [ ] **Performance Benchmarking**: Automated performance regression testing for pyheatmy
- [ ] **Security Scanning**: Automated vulnerability scanning for all components
- [ ] **Documentation Generation**: Auto-generate API docs from code comments

### 2. Development Environment Improvements

**Containerized Development**
- [ ] **Docker Containers**: Standardized development environments for all components
- [ ] **Arduino Development Container**: Include Arduino CLI, libraries, and tools
- [ ] **Python Development Container**: Pre-configured environment with all dependencies
- [ ] **Database Development**: Containerized database for Molonaviz development

**IDE Integration**
- [ ] **VS Code Extensions**: Custom extensions for MOLONARI development
- [ ] **Arduino Debugging**: Hardware debugging support with proper breakpoints
- [ ] **Python Language Server**: Enhanced IntelliSense for scientific computing
- [ ] **Project Templates**: New project templates for sensors, analysis, etc.

### 3. Communication Protocol Enhancements

**Protocol Validation Framework**
- [ ] **Protocol Simulation**: Software simulation of LoRa network behavior
- [ ] **Automated Protocol Testing**: Test protocol edge cases and failure scenarios
- [ ] **Performance Analysis**: Measure protocol efficiency and reliability
- [ ] **Security Analysis**: Validate protocol security and implement encryption

**Advanced Networking Features**
- [ ] **Mesh Networking**: Multi-hop communication between sensors and relays
- [ ] **Adaptive Protocols**: Dynamic protocol adjustment based on conditions
- [ ] **Quality of Service**: Prioritized data transmission for critical measurements
- [ ] **Network Topology Discovery**: Automatic network mapping and optimization

### 4. Data Security and Quality Initiatives

**Data Integrity and Security**
- [ ] **End-to-End Encryption**: Secure data transmission from sensor to server
- [ ] **Digital Signatures**: Verify data authenticity and detect tampering
- [ ] **Audit Logging**: Complete audit trail for all data operations
- [ ] **Access Control**: Role-based access control for data and system management

**Advanced Data Quality Control**
- [ ] **Real-Time Anomaly Detection**: ML-based anomaly detection for sensor data
- [ ] **Automated Quality Flags**: Intelligent data quality assessment
- [ ] **Cross-Validation**: Validate measurements across multiple sensors
- [ ] **Metadata Management**: Enhanced metadata tracking for data provenance

### 5. Scientific Computing Enhancements

**Algorithm Development**
- [ ] **Advanced MCMC Methods**: Implement newer sampling algorithms (NUTS, HMC)
- [ ] **Parallel Computing**: Multi-core and GPU acceleration for large datasets
- [ ] **Uncertainty Propagation**: Enhanced uncertainty quantification methods
- [ ] **Model Comparison**: Automated model selection and comparison frameworks

**Research Integration**
- [ ] **Jupyter Integration**: Seamless integration with Jupyter notebooks
- [ ] **Data Visualization**: Advanced visualization tools for scientific analysis
- [ ] **External Tool Integration**: Connect with other hydrological modeling tools
- [ ] **Publication Support**: Export results in formats suitable for scientific publication

### 6. Hardware Ecosystem Expansion

**Additional Sensor Types**
- [ ] **pH Sensors**: Water chemistry monitoring capabilities
- [ ] **Conductivity Sensors**: Electrical conductivity measurement
- [ ] **Turbidity Sensors**: Water clarity and sediment monitoring
- [ ] **Flow Sensors**: Direct water velocity measurement

**Power Management Improvements**
- [ ] **Energy Harvesting**: Solar, thermal, and kinetic energy collection
- [ ] **Advanced Sleep Modes**: Ultra-low power modes for extended operation
- [ ] **Wireless Charging**: Inductive charging for underwater sensors
- [ ] **Battery Health Monitoring**: Predictive battery replacement scheduling

**Environmental Resilience**
- [ ] **Extreme Weather Hardening**: Enhanced protection for severe weather
- [ ] **Ice-Resistant Designs**: Hardware designed for freezing conditions
- [ ] **Self-Cleaning Mechanisms**: Automated sensor cleaning and maintenance
- [ ] **Redundant Systems**: Backup communication and power systems

### 7. User Experience and Interface Improvements

**Molonaviz GUI Enhancements**
- [ ] **Mobile Application**: Companion mobile app for field operations
- [ ] **Web Interface**: Browser-based access to system monitoring
- [ ] **Real-Time Dashboards**: Live monitoring and alert systems
- [ ] **3D Visualization**: 3D site visualization and sensor placement tools

**Installation and Configuration**
- [ ] **Automated Setup**: One-click installation and configuration scripts
- [ ] **Configuration Wizards**: Guided setup for new deployments
- [ ] **Remote Configuration**: Update sensor configurations remotely
- [ ] **Bulk Management**: Manage multiple deployments from single interface

### 8. Community and Collaboration Features

**Open Science Initiatives**
- [ ] **Data Sharing Platform**: Standardized data sharing with research community
- [ ] **Model Repository**: Share and version control scientific models
- [ ] **Collaboration Tools**: Multi-institution collaboration support
- [ ] **Educational Resources**: Teaching materials and tutorials

**Community Development**
- [ ] **Plugin Architecture**: Allow third-party extensions and sensors
- [ ] **API Development**: RESTful APIs for external tool integration
- [ ] **Documentation Website**: Comprehensive documentation portal
- [ ] **Community Forum**: Discussion forum for users and developers

### 9. Deployment and Operations Automation

**Field Deployment Support**
- [ ] **Deployment Planning Tools**: Site survey and deployment planning software
- [ ] **GPS Integration**: Automated location tracking and mapping
- [ ] **Maintenance Scheduling**: Automated maintenance reminder system
- [ ] **Field Technician App**: Mobile app for field personnel

**System Monitoring and Alerting**
- [ ] **Predictive Maintenance**: ML-based failure prediction
- [ ] **Health Monitoring**: Comprehensive system health dashboards
- [ ] **Alert Management**: Intelligent alert routing and escalation
- [ ] **Performance Analytics**: Long-term system performance analysis

### 10. Integration with External Systems

**Environmental Monitoring Networks**
- [ ] **USGS Integration**: Connect with USGS water monitoring systems
- [ ] **Weather Service Integration**: Integrate meteorological data
- [ ] **Satellite Data**: Incorporate satellite-based environmental data
- [ ] **IoT Platform Integration**: Connect with broader IoT ecosystems

**Research Tool Integration**
- [ ] **GIS Integration**: Geographic Information System connectivity
- [ ] **Statistical Software**: Direct integration with R, MATLAB, etc.
- [ ] **Cloud Computing**: Integration with cloud-based computing platforms
- [ ] **Machine Learning Platforms**: Connect with ML/AI development tools

## Implementation Priorities

### Phase 1 (Short-term, 3-6 months)
1. **Hardware-in-the-Loop Testing**: Improve hardware validation reliability
2. **Docker Development Environment**: Standardize development setup
3. **Protocol Simulation Framework**: Validate communication protocols
4. **Mobile Field App**: Basic field operation support

### Phase 2 (Medium-term, 6-12 months)
1. **Advanced Data Quality Control**: ML-based anomaly detection
2. **Additional Sensor Types**: pH and conductivity sensors
3. **Energy Harvesting**: Solar power for relay stations
4. **Real-Time Dashboards**: Enhanced monitoring interfaces

### Phase 3 (Long-term, 12+ months)
1. **Mesh Networking**: Advanced communication topologies
2. **Predictive Maintenance**: AI-based system health monitoring
3. **Community Platform**: Data sharing and collaboration tools
4. **Advanced Scientific Computing**: GPU acceleration and new algorithms

## Resource Requirements

### Human Resources
- **Hardware Engineers**: For advanced sensor development and power systems
- **Software Developers**: For GUI, mobile apps, and platform integration
- **DevOps Engineers**: For CI/CD, containerization, and automation
- **Data Scientists**: For ML-based quality control and predictive analytics
- **Field Technicians**: For deployment testing and validation

### Infrastructure
- **Test Hardware**: Arduino boards, sensors, and communication equipment
- **CI/CD Infrastructure**: Runners for automated testing and deployment
- **Cloud Resources**: Computing and storage for development and testing
- **Field Test Sites**: Locations for real-world validation and testing

### Partnerships
- **Academic Institutions**: Collaboration with hydrology and engineering departments
- **Technology Companies**: Partnerships for advanced sensors and communication
- **Environmental Agencies**: Collaboration with monitoring organizations
- **Open Source Community**: Engagement with broader scientific computing community

## Contribution Guidelines

For teams interested in implementing these initiatives:

1. **Select Initiative**: Choose an initiative that aligns with your expertise and interests
2. **Create Implementation Plan**: Develop detailed technical specifications
3. **Community Discussion**: Discuss approach with community via GitHub issues
4. **Proof of Concept**: Develop small-scale proof of concept
5. **Testing and Validation**: Validate approach with existing system
6. **Documentation**: Create comprehensive documentation and examples
7. **Integration**: Integrate with main codebase following review process

## Measuring Success

### Technical Metrics
- **System Reliability**: Uptime and failure rates
- **Data Quality**: Accuracy and completeness of collected data
- **Development Velocity**: Speed of new feature development
- **Community Engagement**: Number of contributors and users

### Scientific Impact
- **Research Publications**: Papers using MOLONARI data and tools
- **Deployment Scale**: Number and size of monitoring installations
- **Data Availability**: Amount of high-quality data available to researchers
- **Tool Adoption**: Usage by other research groups and institutions

### Educational Outcomes
- **Student Involvement**: Number of students participating in development
- **Skill Development**: Technical skills gained by contributors
- **Knowledge Transfer**: Dissemination to broader scientific community
- **Collaborative Projects**: Multi-institution collaborative research

This roadmap provides a framework for continued development of the MOLONARI ecosystem, ensuring it remains at the forefront of environmental monitoring technology while serving the needs of the research community.
