flipoyo/MOLONARI1D/dataAnalysis/README.md

# MOLONARI_projet
Ce code a été réalisé par les étudiants du groupe terrain dans le cadre du TI MOLONARI 2023. 
Voir la notice d'utilisation [Notice et interprétation.pdf](https://github.com/flipoyo/MOLONARI1D/dataAnalysis/NoticeEtInterpretation.pdf)
