flipoyo/MOLONARI1D/molonari.io/deployment/vps115892/INCIDENT_20260817.md

# MOLONARI.io — Note d’incident

**Date :** 18 août 2026
**VPS :** `vps115892.serveur-vps.net` — HOST
**Service affecté :** `https://molonari.io`
**Statut :** certificat TLS recréé ; remise en service nginx à confirmer
**Nature :** récidive d’un incident de disparition des certificats Let's Encrypt

## 1. Symptôme

Nouvel incident d’accès public à `molonari.io`.

Diagnostic système :

```text
● dovecot.service loaded failed failed Dovecot IMAP/POP3 email server
● nginx.service   loaded failed failed A high performance web server and a reverse proxy server
```

Le test de configuration nginx identifie immédiatement la cause du blocage :

```text
cannot load certificate "/etc/letsencrypt/live/molonari.io/fullchain.pem":
No such file or directory

nginx: configuration file /etc/nginx/nginx.conf test failed
```

**Conséquence directe : nginx refuse de démarrer et MOLONARI.io devient inaccessible en HTTPS.**

---

## 2. Diagnostic Let's Encrypt

État initial du répertoire :

```text
/etc/letsencrypt/live/
└── README
```

Aucun répertoire `molonari.io` n’est présent.

Confirmation par Certbot :

```text
sudo certbot certificates

No certificates found.
```

Il ne s’agit donc **pas simplement d’un lien symbolique cassé ou d’un certificat expiré**.

L’ensemble de la *certificate lineage* `molonari.io` n’est plus enregistré par Certbot :

```text
/etc/letsencrypt/live/molonari.io/
/etc/letsencrypt/archive/molonari.io/
/etc/letsencrypt/renewal/molonari.io.conf
```

étaient absents.

---

## 3. Configuration nginx

La configuration nginx n’a pas été récemment modifiée :

```text
/etc/nginx/sites-enabled/molonari.io
    -> /etc/nginx/sites-available/molonari.io

Modification : 29 octobre 2025
```

nginx continue donc normalement à rechercher :

```text
/etc/letsencrypt/live/molonari.io/fullchain.pem
```

**La panne n’est pas provoquée par une modification récente du virtual host nginx.**

---

## 4. Certbot automatique

Le journal système montre une exécution automatique de Certbot :

```text
18 août 13:22:11 Starting certbot.service
18 août 13:22:11 certbot.service: Deactivated successfully.
18 août 13:22:11 Finished certbot.service
```

Cette exécution s’est terminée normalement.

À ce stade, aucune preuve n’indique que cette exécution a supprimé le certificat. Au contraire, l’hypothèse la plus probable est que Certbot ne disposait déjà plus de la configuration `molonari.io` et n’avait donc aucun certificat à renouveler.

---

## 5. Restauration du certificat

Un nouveau certificat `molonari.io` a été demandé à Let's Encrypt via Certbot.

À **17:23**, l’arborescence Certbot a été recréée :

```text
/etc/letsencrypt/archive/molonari.io/
/etc/letsencrypt/renewal/molonari.io.conf
/etc/letsencrypt/live/molonari.io/
```

Cette opération restaure la structure nécessaire au fonctionnement HTTPS de nginx.

La validation finale doit être effectuée par :

```bash
sudo nginx -t
sudo systemctl restart nginx
sudo systemctl status nginx --no-pager
curl -I https://molonari.io
```

---

## 6. Incident Dovecot associé

`dovecot.service` est également en échec.

Les journaux montrent de manière répétée :

```text
postfix/smtpd:
SASL: Connect to Dovecot auth socket 'private/auth' failed:
Connection refused
```

Ces erreurs étaient déjà présentes avant l’exécution automatique de Certbot à 13:22.

Dovecot pouvant lui aussi dépendre de certificats TLS Let's Encrypt, **une origine commune aux pannes nginx et Dovecot est plausible mais non encore démontrée**.

---

## 7. Caractère récurrent

Cet incident présente le **même symptôme fondamental que l’incident précédent de MOLONARI.io** :

> disparition de l’état Certbot associé à `molonari.io` → certificat attendu par nginx absent → échec du démarrage nginx → indisponibilité HTTPS.

La répétition de cette disparition constitue désormais le problème principal.

Un simple échec de renouvellement Let's Encrypt n’explique normalement pas la disparition complète de la configuration et des certificats existants.

---

## 8. Cause racine — non déterminée

À ce stade, **aucune preuve ne permet d’attribuer formellement la suppression à HOST**.

Cependant, compte tenu :

* de la récidive d’un incident similaire ;
* de la disparition complète de la *certificate lineage* Certbot ;
* de l’absence de modification récente de la configuration nginx ;
* du fonctionnement normal apparent du timer Certbot ;
* de la panne simultanée de Dovecot ;

l’hypothèse d’une **opération d’administration, maintenance, restauration ou modification de l’environnement VPS** doit être investiguée.

HOST devra notamment indiquer si des opérations ont été effectuées sur le VPS autour des périodes concernées : maintenance de l’hôte, migration, restauration de snapshot, modification du système ou toute intervention susceptible d’affecter `/etc/letsencrypt`.

---

## 9. Actions différées

Lorsque du temps pourra être consacré à l’incident :

1. confirmer le fonctionnement de nginx et de `https://molonari.io` après restauration ;
2. diagnostiquer et redémarrer Dovecot ;
3. tester le renouvellement avec `certbot renew --dry-run` ;
4. analyser les journaux Certbot et système autour de l’incident précédent et de celui du 18 août ;
5. demander à HOST l’historique des interventions effectuées sur le VPS ;
6. mettre en place une surveillance indépendante de `/etc/letsencrypt` afin d’horodater toute suppression future ;
7. réévaluer le maintien du VPS MOLONARI chez HOST si l’intégrité de l’état système ne peut pas être garantie.

## Conclusion

**Incident technique identifié et réparable ; cause racine non résolue.**

La panne immédiate est due à la disparition du certificat TLS `molonari.io`, qui empêche nginx de démarrer.

Le caractère désormais **récurrent** de la disparition de l’état Certbot transforme toutefois cet incident en problème d’infrastructure. Une investigation de l’administration du VPS, notamment côté HOST, est nécessaire avant de considérer le problème comme définitivement clos.
