flipoyo/MOLONARI1D/API_MOLONARI.docx

# Application Programming Interface - 2022

Projet MOLONARI

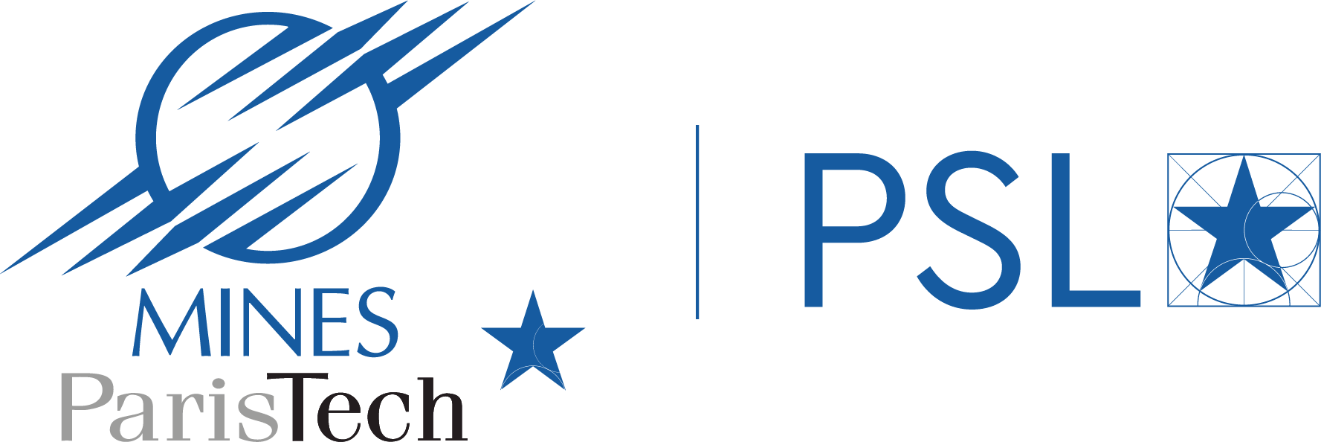
[picture p69: figure]
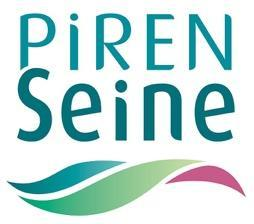
[picture p70: figure]
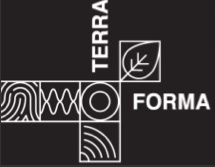
[picture p71: figure]

# Table des matières

Table des matières 2

Introduction 3

IHM vers Calcul 4

Classe Prior 4

Classe Layer 4

Fonction layersListCreator 5

Classe Column 5

Calcul vers IHM 9

Méthodes disponibles après un appel du modèle direct 9

Méthodes disponibles après un appel de la MCMC 12

# Introduction

Cette bibliothèque spécifie les interfaces d’échanges entre les trois pôles capteurs, calculs et IHM afin de mener le projet à bien.

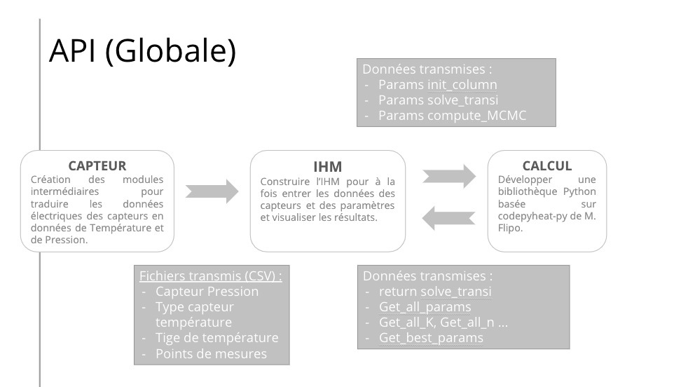
[picture p72: figure]

# IHM vers Calcul

Cette partie décrit les informations que IHM doit envoyer à Calcul pour définir les objets et utiliser les méthodes de calcul principales.

Les seuls objets que IHM a besoin de définir sont :

- Les instances de la classe Column. C’est la classe principale. Elle regroupe les mesures de charge et de températures réalisées sur un point de mesure, puis elle permet d’exécuter le modèle direct et d’exécuter une MCMC. À l’issue de ces calculs, elle contient les informations utiles, que l’on peut récupérer avec des méthodes décrites dans la partie suivante.
- Les instances de la classe Layer. Cette classe sert à définir une strate du milieu. Elle est utilisée par le modèle stratifié.
- Les instances de la classe Prior. Cette classe sert à définir, dans le cadre de la MCMC, les informations utiles pour un paramètre : son intervalle de variations (range), l’écart type de la marche aléatoire pour ce paramètre (sigma), et, dans le cas où sa loi a priori n’est pas uniforme, sa densité (density).

## Classe Prior

- Définition d’un objet Prior :

Paramètres :

- range : tuple, intervalle dans lequel le paramètre peut varier
- sigma : float, écart type de la gaussienne utilisée pour la marche aléatoire pour ce paramètre
- density : callable, densité de la loi a priori. Par défaut, c’est une fonction constante, correspondant à une loi uniforme.

Remarque : Le seul moment où l’utilisateur a potentiellement besoin de définir lui-même un Prior est pour la MCMC avec estimation du paramètre sigma2 (voir exemple ci-après).

## Classe Layer

- Définition d’un objet Layer :

Paramètres :

- name : string
- zLow : float, profondeur en m du bas de la couche (attention, repère orienté du haut vers le bas, donc il s’agit d’un nombre positif qui grandit à mesure que l’on s’enfonce dans le sol)
- moinslog10K : float, valeur de -log10(K) où K est la perméabilité
- n : float, porosité
- lambda_s : float
- rhos_cs : float

Exemple :

my_layer = Layer(“Couche 1”, 0.2, 4.0, 0.1, 2.0, 4e6)

Remarque : le groupe IHM créera des objets de la classe Layer uniquement via la fonction layersListCreator décrite ci-après.

## Fonction layersListCreator

Pour définir directement une liste d’objets de la classe Layer, on dispose de la fonction layersListCreator. Attention, ce n’est pas une méthode de la classe Layer.

- Définition d’une liste d’objets de Layer avec la fonction layersListCreator

Paramètres :

- layersListInput : list, liste de tuples où chaque tuple contient les six arguments nécessaires à la définition d’un objet Layer

Retourne :

- une liste d’objets de la classe Layer

Exemple :

my_layer_list = layersListCreator(

[(“Couche 1”, 0.1, 4, 0.1, 2, 4e6),

(“Couche 2”, 0.25, 4.2, 0.1, 3, 4e7)]

)

Remarque : c’est cette liste d’objets de la classe Layer qui est utilisée par la suite dans le code.

## Classe Column

- Définition d’un objet Column avec la méthode de classe from_dict :

On peut définir un objet de la classe Column à partir d’un dictionnaire à l’aide de la méthode de classe from_dict :

Paramètres : un dictionnaire de la forme (format clé : valeurs) :

- river_bed : float, altitude du lit de la rivière, en m (inutilisé actuellement)
- depth_sensors : Sequence[float], liste des profondeurs des capteurs de la tige (au nombre de 4), en m
- offset : float, enfoncement excédentaire de la tige, en m (si la tige est enfoncée 10 cm trop profondément, offset = 0.1)
- dH_measures : list, liste contenant des tuples avec la date, la charge et la température au sommet de la colonne (voir exemple)
- T_measures : list, liste contenant des tuples avec la date, les températures aux points de mesure sur la tige (voir exemple)
- sigma_meas_P : float, erreur de mesure sur la pression (inutilisé actuellement)
- sigma_meas_T : float, erreur de mesure sur la température (inutilisé actuellement)
- inter_mode : str, définit le type d’interpolation utilisé pour calculer les températures initiales le long de la colonne. Deux modes possibles : “linear” (par défaut), et “lagrange”

Retourne : objet de type Column

Exemple :

dH_measures = [

(Timestamp('2016-06-28 06:45:00'), (0.84556517, 287.165)),

(Timestamp('2016-06-28 07:00:00'), (0.84559872, 287.159)),

…

]

T_measures = [

(Timestamp('2016-06-28 06:45:00'), array([287.272, 287.344, 287.272, 287.08 ])),

(Timestamp('2016-06-28 07:00:00'), array([287.248, 287.32 , 287.272, 287.08 ]))

]

col_dict = {

“river_bed”: 1.,

“depth_sensors”: [.1, .2, .3, .4],

“offset”: .0,

“dH_measures”: dH_measures,

“T_measures”: T_measures,

“sigma_meas_P”: None, #float

“sigma_meas_T”: None, #float

“inter_mode” : “linear”

}

col = Column.from_dict(col_dict)

- Appel du modèle direct via la méthode compute_solve_transi :

Cette méthode exécute le modèle direct, en version stratifiée (si on donne une liste d’objets de type Layer en argument) ou en homogène (si on donne seulement un tuple contenant les 4 paramètres). Cette méthode met à jour les attributs de l’objet de type Column, elle ne renvoie rien. D’autres méthodes “getteurs” permettront de récupérer ces résultats.

Paramètres :

- layersList : liste d’objets de la classe Layer (créée par la fonction layersListCreator par exemple) ou tuple avec les 4 paramètres
- nb_cells : int : nombre de cellules de la discrétisation
- verbose : booléen

Retourne :

- rien (calcul du modèle direct avec les paramètres associés aux layers de layersList)

Exemple :

# Appel en homogène avec un tuple de paramètres

col.compute_solve_transi((4, 0.1, 2, 4e6), 100)

# Appel en stratifié avec une liste d’objets Layer

col.compute_solve_transi(my_layer_list, 100)

- Calcul de l’inversion bayésienne via la méthode compute_mcmc :

Cette méthode réalise la MCMC. Elle ne renvoie rien, mais elle stocke la liste des états qu’elle a créés. Des “getteurs” permettront de récupérer les résultats.

Paramètres :

- nb_iter : int, nombre d’itérations
- all_priors : list, dont chaque élément est une liste de la forme [Nom de couche, zLow de la couche, et un dictionnaire décrivant les priors des paramètres de la couche]
- nb_cells : int,
- quantile : tuple,
- sigma2 : float, None par défaut. Si sigma2 vaut None, la MCMC est lancée en estimant sigma2, dont la distribution a priori est donnée par sigma2_temp_prior. Sinon, la MCMC est lancée avec sigma2 fixé.
- sigma2_temp_prior : Prior, distribution a priori de sigma2

Retourne :

- rien (calcul de l’inversion bayésienne)

Exemple : pour une colonne à deux strates, de profondeur 0.4m

priors_couche_1 = {

“moinslog10K”: ((1.5, 6), .01),

“n”: ((.01, .25), .01),

“lambda_s”: ((1, 5), .1),

“rhos_cs”: ((1e6,1e7), 1e5),

}

priors_couche_2 = {

“moinslog10K”: ((1.5, 6), .01),

“n”: ((.01, .25), .01),

“lambda_s”: ((1, 5), .1),

“rhos_cs”: ((1e6,1e7), 1e5),

}

all_priors = [

[“Couche 1”, 0.2, priors_couche_1],

[“Couche 2”, 0.4, priors_couche_2]

]

# MCMC sans estimation de sigma2

col.compute_mcmc(

nb_iter = 5000,

all_priors = all_priors,

nb_cells = 100,

quantile = (0.05, 0.5, 0.95),

sigma2 = 1.0

)

# MCMC avec estimation de sigma2

col.compute_mcmc(

nb_iter = 5000,

all_priors = all_priors,

nb_cells = 100,

quantile = (0.05, 0.5, 0.95),

sigma2_temp_prior = Prior((0.1, np.inf), 0.1, lambda x : 1/x)

)

# Calcul vers IHM

Cette partie décrit les méthodes que IHM peut utiliser sur un objet de type Column pour récupérer des informations issues des méthodes de calcul décrites précédemment.

## Méthodes disponibles après un appel du modèle direct

Ces méthodes permettent de récupérer les informations calculées par le dernier appel du modèle direct, que cet appel ait été lancé par l’utilisateur directement (via compute_solve_transi) ou indirectement (via compute_mcmc). Les fonctions détaillées dans cette partie sont des méthodes de la classe Column, et elles ne peuvent pas être utilisées avant d’avoir appelé le modèle direct une première fois.

- Récupérer les indices des cellules contenant un capteur : get_id_sensors

Paramètres :

- aucun

Retourne :

- liste des indices des cellules contenant des capteurs (hors capteurs rivière et aquifère).

Exemple :

>>> col.get_id_sensors()

[24, 49, 74]

- Récupérer les RMSE : get_RMSE

Paramètres :

- aucun

Retourne :

- array contenant les RMSE pour chaque capteur, puis la RMSE globale.

Exemple :

>>> col.get_RMSE()

array([0.0763115 , 0.09875992, 0.04563868, 0.0767243])

- Récupérer les profondeurs des milieux des cellules : get_depths_solve

Paramètres :

- aucun

Retourne :

- array contenant les profondeurs des milieux des cellules.

Exemple :

>>> col.get_depths_solve()

array([0.002, 0.006, 0.01 , 0.014, …, 0.394, 0.398])

- Récupérer les temps : get_times_solve

Paramètres :

- aucun

Retourne :

- self._times : liste contenant les dates des mesures (et donc les dates où les températures sont calculées)

Exemple :

>>> col.get_times_solve()

[Timestamp('2016-06-28 06:45:00'),

Timestamp('2016-06-28 07:00:00'),

…,

Timestamp('2016-07-11 21:45:00')]

- Récupérer les températures : get_temps_solve

Paramètres :

- z : float, profondeur à laquelle on souhaite récupérer les températures calculées. Argument optionnel (voir ci-après).

Retourne :

- si z est précisé : array unidimensionnel contenant les températures au cours du temps à la profondeur z. Si z n’est pas fourni, renvoie le tableau bidimensionnel des températures pour toutes les profondeurs et tous les temps. Une ligne de ce tableau correspond à une profondeur fixée, une colonne est une date fixée.

Exemple :

>>> col.get_temps_solve(0.12)

array([287.29245, 287.16483, 287.1529 , ..., 289.0312 , 288.9903 ,

288.94864], dtype=float32)

- Récupérer les flux advectifs : get_advec_flows_solve

Paramètres :

- aucun

Retourne :

- array bidimensionnel contenant les flux advectifs. Une ligne de ce tableau correspond à une profondeur fixée, une colonne est une date fixée.

Exemple :

>>> col.get_advec_flows_solve()

array([[254048.15919553, 254022.16654971, 254048.32720796, ...,

261296.83775776, 261262.13761012, 261198.36194832],

[254049.67349804, 254021.29928274, 254047.85319433, ...,

261298.47274618, 261265.90944973, 261197.28451545],

...,

[253990.50543789, 254190.74094686, 254150.33887346, ...,

261391.05108739, 261367.21750146, 261317.35701802],

[253975.52151344, 254124.1002343 , 254101.98530373, ...,

261054.38735068, 261032.7279476 , 261001.42568484]])

- Récupérer les flux conductifs : get_conduc_flows_solve

Paramètres :

- aucun

Retourne :

- array bidimensionnel contenant les flux advectifs. Une ligne de ce tableau correspond à une profondeur fixée, une colonne est une date fixée.

Exemple :

>>> col.get_conduc_flows_solve(0.12)

array([[ 1.1068530e+00, -3.5365844e-01, 1.4527908e-01, ...,

3.7912127e-01, 3.8149682e-01, 3.6746627e-01],

[ 1.3292813e+00, -3.5493898e-01, 1.1135341e-01, ...,

3.6885816e-01, 3.6885816e-01, 3.6885816e-01],

...,

[-3.8695312e+00, -1.1552916e+00, 8.0731219e-01, ...,

-1.7398970e-01, -7.6555468e-02, 0.0000000e+00],

[-3.8561687e+00, -6.3866383e+01, -5.0049278e+01, ...,

-3.3558313e+02, -3.3403745e+02, -3.1533536e+02]])

- Récupérer les débits : get_flows_solve

Paramètres :

- z : float, profondeur à laquelle on souhaite récupérer les débits calculés. Argument optionnel (voir ci-après).

Retourne :

- si z est précisé : array unidimensionnel contenant les débits au cours du temps à la profondeur z. Si z n’est pas fourni, renvoie le tableau bidimensionnel des débits pour toutes les profondeurs et tous les temps. Une ligne de ce tableau correspond à une profondeur fixée, une colonne est une date fixée.

Exemple :

>>> col.get_conduc_flows_solve(0.12)

array([0.00021139, 0.00021139, 0.0002114 , ..., 0.00021605, 0.00021605,

0.00021603], dtype=float32)

## Méthodes disponibles après un appel de la MCMC

Ces méthodes permettent de récupérer les informations calculées par la MCMC. Les fonctions détaillées dans cette partie sont des méthodes de la classe Column, et elles ne peuvent pas être utilisées avant d’avoir appelé la MCMC une première fois.

- Récupérer les profondeurs des milieux des cellules : get_depths_mcmc

Paramètres :

- aucun

Retourne :

- array contenant les profondeurs des milieux des cellules utilisées dans la MCMC.

Exemple :

>>> col.get_depths_mcmc()

array([0.002, 0.006, 0.01 , 0.014, …, 0.394, 0.398])

- Récupérer les temps : get_times_mcmc

Paramètres :

- aucun

Retourne :

- self._times : liste contenant les dates des mesures (et donc les dates où les températures sont calculées)

Exemple :

>>> col.get_times_mcmc()

[Timestamp('2016-06-28 06:45:00'),

Timestamp('2016-06-28 07:00:00'),

…,

Timestamp('2016-07-11 21:45:00')]

- Récupérer des paramètres aléatoirement : sample_param

Paramètres :

- aucun

Retourne :

- liste dont le n-ième élément est un named tuple contenant les 4 paramètres de la n-ième couche, pour un état de la MCMC choisi aléatoirement.

Exemple :

>>> col.sample_param()

[Parametres(moinslog10K=5.829515999088784, n=0.13098899589086638, lambda_s=4.575026012425696, rhos_cs=1986067.5639966507),

Parametres(moinslog10K=5.977343374859448, n=0.02849317033859023, lambda_s=3.6471541965577563, rhos_cs=9082662.883385323),

Parametres(moinslog10K=5.9652309551915135, n=0.02789212956577023, lambda_s=4.783013898493102, rhos_cs=3841935.090947748)]

- Récupérer le meilleur sigma2 : get_best_sigma2

Paramètres :

- aucun

Retourne :

- float correspondant au sigma2 du “meilleur” état de la MCMC : celui d’énergie minimale, le maximum a posteriori (MAP).

Exemple :

>>> col.get_best_sigma2()

1.0

- Récupérer les meilleurs layers : get_best_layers

Paramètres :

- aucun

Retourne :

- liste de layers, correspondant aux layers du “meilleur” état de la MCMC : celui d’énergie minimale, le maximum a posteriori (MAP).

Exemple :

>>> col.get_best_layers()

[Couche 1 : ends at 0.15 m. Parametres(moinslog10K=5.978658479245687, n=0.09435452260035626, lambda_s=4.030363094208517, rhos_cs=4535824.342980439),

Couche 2 : ends at 0.25 m. Parametres(moinslog10K=5.987688039256958, n=0.05392840931238012, lambda_s=4.842472761269677, rhos_cs=2980844.628387417),

Couche 3 : ends at 0.4 m. Parametres(moinslog10K=5.974161875812504, n=0.02942429514593753, lambda_s=3.3324680740689945, rhos_cs=9492712.639617197)]

- Récupérer tous les paramètres : get_all_params

Paramètres :

- aucun

Retourne :

- liste dont le n-ième élément est une matrice correspondant au n-ième layer. Cette matrice a 4 colonnes, une pour chaque paramètre, qui contiennent donc les distributions de ce paramètre.

Exemple :

>>> col.get_all_params()[0]

[[8.56239173e+00 1.93875163e-01 5.37909268e+00 8.27597016e+06],

[8.46043895e+00 1.94392128e-01 5.42383332e+00 8.27329793e+06],

…,

[8.46043895e+00 1.94392128e-01 5.42383332e+00 8.27329793e+06],

[8.56239173e+00 1.93875163e-01 5.37909268e+00 8.27597016e+06]]

- Récupérer tous les moinslog10K : get_all_moinslog10K

Paramètres :

- aucun

Retourne :

- liste dont le n-ième élément est une liste contenant les moinslog10K de chaque layer du n-ième état de la MCMC.

Exemple :

>>> col.get_all_moinslog10K()

[[5.975034735454937, 5.964062746233368, 5.933199009193335],

[5.975034735454937, 5.964062746233368, 5.933199009193335],

…,

[5.977080913309422, 5.974830357957307, 5.924773341826041]]

- Récupérer tous les n : get_all_n

Paramètres :

- aucun

Retourne :

- liste dont le n-ième élément est une liste contenant les n de chaque layer du n-ième état de la MCMC.

Exemple :

>>> col.get_all_n()

[[0.09770101340142129, 0.05446545145441365, 0.03449298581974063],

[0.09770101340142129, 0.05446545145441365, 0.03449298581974063],

…,

[0.0980698732891378, 0.04571794145513558, 0.023430662346356088]]

- Récupérer tous les lambda_s : get_all_lambda_s

Paramètres :

- aucun

Retourne :

- liste dont le n-ième élément est une liste contenant les lambda_s de chaque layer du n-ième état de la MCMC.

Exemple :

>>> col.get_all_lambda_s()

[[1.7652159243433618, 4.896081607512383, 3.3698558559669176],

[1.7652159243433618, 4.896081607512383, 3.3698558559669176],

…,

[1.8533628159142332, 4.931031104270697, 3.2884156594266707]]

- Récupérer tous les rhos_cs : get_all_rhos_cs

Paramètres :

- aucun

Retourne :

- liste dont le n-ième élément est une liste contenant les rhos_cs de chaque layer du n-ième état de la MCMC.

Exemple :

>>> col.get_all_rhos_cs()

[[4163009.985443604, 2838640.4878082406, 1213370.888916834],

[4163009.985443604, 2838640.4878082406, 1213370.888916834],

…,

[4041559.6303990236, 2870287.58466214, 1242895.5038242743]]

- Récupérer tous les sigma2 : get_all_sigma2

Paramètres :

- aucun

Retourne :

- liste dont le n-ième élément est le sigma2 du n-ième état de la MCMC.

Exemple :

>>> col.get_all_sigma2()

[1.0,

…,

1.0]

- Récupérer toutes les énergies : get_all_energy

Paramètres :

- aucun

Retourne :

- liste dont le n-ième élément est l’énergie du n-ième état de la MCMC.

Exemple :

>>> col.get_all_energy()

[584.5139625238698,

…,

522.2160627948176]

- Récupérer tous les acceptance ratio : get_all_acceptance_ratio

Paramètres :

- aucun

Retourne :

- array dont le n-ième élément est l’acceptance ratio à la n-ième itération de la MCMC (la proportion d’états acceptés à cet instant).

Exemple :

>>> col.get_all_acceptance_ratio()

array([0. , 0.5 , 0.33333333, 0.25 , 0.2 ,

…,

0.33333333, 0.28571429, 0.25 , 0.22222222, 0.2 ]

- Récupérer les quantiles : get_quantiles

Paramètres :

- aucun

Retourne :

- objet contenant les quantiles que l’utilisateur a donné lors de la MCMC.

Exemple :

>>> quantiles = col.get_quantiles()

>>> for q in quantiles:

… print(q)

0.25

0.5

0.95

- Récupérer un quantile de température : get_temps_quantile

Paramètres :

- quantile : float, quantile que l’on souhaite récupérer. Ce quantile devait faire partie de l’argument quantiles de la MCMC.

Retourne :

- array bidimensionnel des températures pour toutes les profondeurs et tous les temps. Une ligne de ce tableau correspond à une profondeur fixée, une colonne est une date fixée.

Exemple :

>>> col.get_temps_quantile(0.5)

array([[287.16714478, 287.16143799, 287.1600647 , ..., 289.01049805,

288.96957397, 288.92938232],

[287.17141724, 287.16622925, 287.16427612, ..., 289.01473999,

288.9760437 , 288.93743896],

...,

[287.09152222, 287.09268188, 287.09283447, ..., 287.99795532,

287.98400879, 287.99719238],

[287.08383179, 287.08425903, 287.08432007, ..., 287.97644043,

287.95648193, 287.97613525]])

- Récupérer un quantile de débit : get_flows_quantile

Paramètres :

- quantile : float, quantile que l’on souhaite récupérer. Ce quantile devait faire partie de l’argument quantiles de la MCMC.

Retourne :

- array bidimensionnel des débits pour toutes les profondeurs et tous les temps. Une ligne de ce tableau correspond à une profondeur fixée, une colonne est une date fixée.

Exemple :

>>> col.get_flows_quantile(0.5)

array([[3.22657797e-06, 3.22676533e-06, 3.22708661e-06, ...,

3.29926229e-06, 3.29849968e-06, 3.29725276e-06],

[3.22656911e-06, 3.22674373e-06, 3.22708479e-06, ...,

3.29921249e-06, 3.29854151e-06, 3.29726799e-06],

...,

[2.26208385e-06, 2.26209750e-06, 2.26214274e-06, ...,

2.31107947e-06, 2.31133708e-06, 2.31154718e-06],

[2.26208385e-06, 2.26209750e-06, 2.26214229e-06, ...,

2.31107947e-06, 2.31133731e-06, 2.31154672e-06]])

- Récupérer la RMSE d’un quantile : get_RMSE_quantile

Paramètres :

- quantile : float, quantile dont on souhaite calculer la RMSE. Ce quantile devait faire partie de l’argument quantiles de la MCMC.

Retourne :

- array contenant les RMSE pour chaque capteur, puis la RMSE globale.

Exemple :

>>> col.get_RMSE_quantile(0.5)

array([0.14360852, 0.16400421, 0.08305708, 0.13468391])

- détail données transmis / Return solve_transi :

Return get_..._solve() | Exemple

pas de retours lors de l’appel de la fonction compute_solve_transi qui prend comme argument params compute_solve_transi mais on peut accéder à la liste des profondeurs / temps et matrices des Températures / débits en faisant comme dans l’exemple à droite

- Liste des profondeurs
- Liste des Temps
- Matrice des températures en fonction de la profondeur (en ligne) et du temps (en colonnes)
- Matrice des débits en fonction de la profondeur et du temps
- Matrice des flux de chaleurs Advectifs
- Matrice des flux de chaleurs conductifs

→ format numpy.array

- Pas de noms

#il faut compute_solve_transi avant et les valeurs récupérées après sont les dernières compute

depths = get_depths_solve()

[0, 02, 04, …], listes_indices_capteurs (unité m)

times = get_times_solve()

[…](unité s)

temps= get_temps_solve()

[[123, 123, 123, …], température pour profondeur 0

[123, 123, 123, …], …

[123, 123, 123, …], en °C

…

]

flows = get_flows_solve()

[[d1, d2 ….] débit à la profondeur 0

[...]

… en m^3.s-1

]

advec = get_advec_flows_solve()

[[1, 3, 1, …], température pour profondeur 0

[ …], … en °C.s-1

…

]

conduc = get_conduc_flows_solve()

[[1, 3, 1, …], température pour profondeur 0

[ …], … en °C.s-1

…

]

- détail données transmis / get_quantile() :

Return get_quantile(...) | Exemple
Méthode à suivre pour récupérer les quantiles voulu - Liste des profondeurs - Liste des temps - Matrices des températures pour les quantiles demandés - liste de Matrices des débits pour les quantiles demandés - Paramètres pour les quantiles 🡪 format numpy.array | #il faut compute_mcmc avant avec les quantiles mis en paramètres lors du compute depths = get_depths_mcmc() [0, 02, 04, …] (unité m) times = get_times_mcmc() […](unité s) flows50 = get_flows_quantile(0.5) pour le quantile à 50% des débits [[d1, d2 ….] débit à la profondeur 0 [...] … en m^3.s-1 ], temps95 = get_temps_quantile(0.95) pour le quantile à 95% des températures [[T1, T2 ….] température à la profondeur 0 [...] … en K ], moinslog10K_50 = get_moinslog10K_quantile(0.5) par ex pour K

# Générateur des données et visualisation de la solution analytique

Cette partie décrit deux modules développés en 2022 qui pourront être ajoutés dans de futures versions de MOLONARI à l’IHM pour permettre à l’utilisateur de préparer des simulations de réponses de signaux.

Le module gen_test.py permet de préparer des chroniques de signaux pour les conditions aux bords de l’objet column de core.py, c’est-à-dire des chroniques de température pour la rivière et pour l’aquifère et des chroniques de différence de charge qui permettent de simuler des conditions météo. Le format de sortie de la classe time_series de gen_test.py sont au bon format pour initialiser l’objet column.

L’utilisateur aura également accès aux solutions analytiques proposées par Goto et al. dans la classe val_analy.py et il pourra comparer des sorties de température entre ces valeurs analytiques de température et ces valeurs de modèle direct.

Les deux modules sont aussi documentés dans deux notebook de démo : demo_gen_test.ipynd et demo_val_direct.ipynb. Le second présente l’accord en termes de RMSE entre les résultats du modèle direct et la solution analytique de Goto et al. selon une excitation bien particulière.

## Générateur des données

- Définir un objet time_series() : Certains paramètres de l’init ressemblent à ceux de colonne. Si les prochains développeurs de calcul souhaitent changer cette rchitecture, c’est possible sans trop de difficulté.

Paramètres :

- offset : un float, même signification que pour Column
- depth_sensors : la liste de float des profondeurs des capteurs, la même que pour Column
- param_time_dates : [t_debut, t_fin, dt], les paramètres de la fenêtre temporelle. Le format demandé pour t_debut et t_fin est celui-ci : (y,m,d,h,mn,s) compatible avec la librairie datetime, dt est un scalaire exprimé en seconde
- param_dH_signal : [dH_amp, P_dh, dH_offset], avec des scalaires permettant de calibrer le signal sinusoïdal
- param_T_riv_signal : [T_riv_amp, P_T_riv, T_riv_offset]
- param_T_aq_signal : [T_aq_amp, P_T_aq, T_aq_offset]
- sigma_meas_P : float, indique l’erreur de mesure simulée par un bruit gaussien sur les chroniques de pression
- sigma_meas_T : float, indique l’erreur de mesure simulée par un bruit gaussien sur les chroniques de température

Retourne :

- un objet time_series() avec de nombreux attribut qui seront explicités plus bas.

Exemple :

"""Fenêtre temporelle"""

# le format demandé est celui-ci : (y,m,d,h,mn,s) compatible avec la librairie datetime

t_debut = (2010, 1, 1)

t_fin = (2010, 5, 30, 23, 59, 59)

dt = 15*60 # pas de temps en (s) # A AMELIORER AVEC UN CONVERTISSEUR AUTOMATIQUE D'UNITES

"""Conditions limites"""

# Température de la rivière

T_riv_amp = 5

T_riv_offset = 20 +K_offset

P_T_riv = 28*24*4*dt

# Température de l'aquifère

T_aq_amp = 0

T_aq_offset = 12 + K_offset

P_T_aq = -9999 # à mettre dans le init

# Pression différentielle

dH_amp = 0

dH_offset = 1

P_dh = -9999 #14*24*4*dt

"""Bruit de mesure"""

sigma_meas_P = 0.5

sigma_meas_T = 0.5

"""Instanciation de l'objet Time_series"""

# un dictionnaire qui facilite le paramétrage avec des variables globales définies plus haut

time_series_dict_user1 = {

"offset":.0,

"depth_sensors":[.25, .5, .75, 1],

"param_time_dates": [t_debut, t_fin, dt],

"param_dH_signal": [dH_amp, P_dh, dH_offset],

"param_T_riv_signal": [T_riv_amp, P_T_riv, T_riv_offset],

"param_T_aq_signal": [T_aq_amp, P_T_aq, T_aq_offset],

"sigma_meas_P": sigma_meas_P,

"sigma_meas_T": sigma_meas_T, #float

}

# instanciation du simulateur de données

emu_observ_test_user1 = Time_series.from_dict(time_series_dict_user1)

NB : le formatage du pas de temps est à revoir, donner par exemple le choix d’une variable dt_day == un pas de temps en jour, dt_hour == un pas de temps en heures, dt_min == un pas de temps en minutes, dt_s == un pas de temps en seconde. L’utilisateur choisit un pas de temps et le simulateur fait la somme des dt et fait les calculs avec un dt en secondes.

- Générer les dates des chroniques au bon format : generate_dates_series()

Paramètres :

- méthode sans paramètres, les attributs self._dates et self._time_array se mettent à jour grâce au init

Retourne :

- l’objet time_series avec les dates mises au bon format dans self._dates et self._time_array

Exemple :

>>>emu_observ_test_user1._dates # il n'y a pas de date encore

array([None], dtype=object)

>>>emu_observ_test_user1._generate_dates_series()

emu_observ_test_user1._dates # les dates sont remplies au format demandé par la classe colonne

>>>emu_observ_test_user1._dates # retourne les dates sont remplies au format demandé par la classe colonne

array([datetime.datetime(2010, 1, 1, 0, 0),

datetime.datetime(2010, 1, 1, 0, 15),

datetime.datetime(2010, 1, 1, 0, 30), ...,

datetime.datetime(2010, 5, 30, 23, 15),

datetime.datetime(2010, 5, 30, 23, 30),

datetime.datetime(2010, 5, 30, 23, 45)], dtype=object)

>>>emu_observ_test_user1._time_array #retourne un array avec les dates depuis le début de l’expérience en seconde

array([ 0, 900, 1800, ..., 12957300, 12958200, 12959100])

- Générer les chroniques de pression/charge : _generate_dH_series()

Paramètres :

- méthode sans paramètres

Retourne :

- l’objet time_series avec les attributs self._dH et self._time_array mis à jour au format array = chronique de charge au cours du temps.

Exemple :

>>>emu_observ_test_user1._dH #ici on a mis une différence de charge constante au cours du temps

array([1., 1., 1., ..., 1., 1., 1.])

- Générer les chroniques de température de la rivière : _generate_Temp_riv_series()

Paramètres :

- méthode sans paramètres

Retourne :

- l’objet time_series avec les attributs self._T_riv, self._dates et self._time_array mis à jour au format array = chronique de charge au cours du temps.

Exemple :

>>>emu_observ_test_user1._T_riv #ici on a mis une température sinusoïdale

array([293.15 , 293.16168746, 293.17337486, ..., 297.08092218,

297.07368868, 297.06643375]) # ici températures en Kelvin

- Générer le fichier de chroniques de pression/température du capteur de pression différentielle MOLONARI au format du datalogger: _generate_T_riv_dH_series()

Paramètres :

- méthode sans paramètres

Retourne :

- l’objet time_series avec les attributs self._T_riv, self._dH, self._dates et self._time_array mis à jour au format array = chronique cours du temps.
- l’attribut self._T_riv_dH_measures est mis à jour et peut être utilisé pour instancier un objet Column dans l’init “dH_measure”

Exemple :

emu_observ_test_user1._T_riv_dH_measures

[(datetime.datetime(2010, 1, 1, 0, 0), (1.0, 293.15)),

(datetime.datetime(2010, 1, 11, 9, 45), (1.0, 296.759124700894)),

...]

- Générer les chroniques de températures sur les capteurs du shaft au format du datalogger :_generate_Shaft_Temp_series()

Paramètres :

- méthode sans paramètres

Retourne :

- l’objet time_series avec les attributs self._T_shaft, self._dates et self._time_array mis à jour au format array = chronique cours du temps.
- l’attribut self._T_shaft_measures, est mis à jour et peut être utilisé pour instancier un objet Column dans l’init “T_measures”

Exemple :

>>>col._T_measures # valeurs par défaut très élevée à 9e5 des températures des capteurs T1, T2 et T3

array([[2.91150e+02, 2.89150e+02, 2.87150e+02],

[9.59595e+05, 9.59595e+05, 9.59595e+05],

[9.59595e+05, 9.59595e+05, 9.59595e+05],

...,

[9.59595e+05, 9.59595e+05, 9.59595e+05],

[9.59595e+05, 9.59595e+05, 9.59595e+05],

[9.59595e+05, 9.59595e+05, 9.59595e+05]])

# valeurs maj des températures de T_shaft np.array([[T1, T2, T3, Taq](t=0), [T1, T2, T3, Taq](t=1), ... ])

>>>emu_observ_test_user1._T_Shaft

array([[291.15 , 289.15 , 287.15 , 285.15 ],

[291.19003296, 289.19003296, 287.19003296, 285.15 ],

[291.19006348, 289.19003296, 287.19009399, 285.15 ],

...,

[294.45544434, 291.38296509, 288.27304077, 285.15 ],

[294.45306396, 291.38290405, 288.27349854, 285.15 ],

[294.45068359, 291.3828125 , 288.27386475, 285.15 ]])

>>>emu_observ_test_user1._T_Shaft_measures # le fichier de température du shaft par défaut au format de la colonne

[(datetime.datetime(2010, 1, 1, 0, 0),

array([291.15, 289.15, 287.15, 285.15])),

(datetime.datetime(2010, 1, 1, 0, 15),

array([9.59595e+05, 9.59595e+05, 9.59595e+05, 2.85150e+02])),

(datetime.datetime(2010, 1, 1, 0, 30),

array([9.59595e+05, 9.59595e+05, 9.59595e+05, 2.85150e+02])),

(datetime.datetime(2010, 1, 1, 0, 45),

array([9.59595e+05, 9.59595e+05, 9.59595e+05, 2.85150e+02])),

(datetime.datetime(2010, 1, 1, 1, 0),

array([9.59595e+05, 9.59595e+05, 9.59595e+05, 2.85150e+02])),

(datetime.datetime(2010, 1, 1, 1, 15),

array([9.59595e+05, 9.59595e+05, 9.59595e+05, 2.85150e+02])),

…

(datetime.datetime(2010, 1, 1, 1, 30),

array([9.59595e+05, 9.59595e+05, 9.59595e+05, 2.85150e+02]))]

- Générer le fichier de chroniques de température du shaft MOLONARI au format du datalogger avec perturbations de mesures de température avec erreur de mesures de température simulée: _generate_perturb_Shaft_Temp_series()

Paramètres :

- méthode sans paramètres

Retourne :

- l’objet time_series avec les attributs self._T_shaft_perturb, self._dates et self._time_array mis à jour au format array = chronique cours du temps.
- l’attribut self._T_shaft_measures_perturb, est mis à jour et peut être utilisé pour instancier un objet Column dans l’init “T_measures”

Exemple :

>>>emu_observ_test_user1._generate_perturb_Shaft_Temp_series()

>>>emu_observ_test_user1._T_shaft_measures_perturb

array([[18.31054887, 17.07740364, 15.58220471, 14.13629319],

[18.42680324, 16.85507814, 15.53947417, 13.90031993],

[18.45884315, 17.02728014, 15.62675485, 13.96020251],

...,

[21.03653478, 18.56741759, 16.0042066 , 13.9411373 ],

[21.01353776, 18.28902244, 16.01057728, 14.14870168],

[21.14024195, 18.50122474, 15.95205776, 14.09108076]])

- Générer le fichier de chroniques de température du capteur de pression/température MOLONARI au format du datalogger avec erreur de mesures de température/pression simulées: _generate_perturb_T_riv_dH_series()

Paramètres :

- méthode sans paramètres

Retourne :

- l’objet time_series avec les attributs self._dH_perturb, self._T_riv_perturb, self._dates et self._time_array mis à jour au format array = chronique cours du temps.
- l’attribut self.self._T_riv_dH_perturb, est mis à jour et peut être utilisé pour instancier un objet Column dans l’init “T_measures”

Exemple :

>>>emu_observ_test_user1._generate_perturb_T_riv_dH_series()

>>>emu_observ_test_user1._T_riv_dH_measures_perturb() # ici charge constante à 1 m perturbée

[(datetime.datetime(2011, 8, 1, 0, 0),

(0.9662380752020394, 20.07225019743682)),

(datetime.datetime(2011, 8, 1, 0, 15),

(0.9855601212803974, 20.131963026647753)),

(datetime.datetime(2011, 8, 1, 0, 30),

(1.0164725331138886, 20.22847129485494)),

(datetime.datetime(2011, 8, 1, 0, 45),

(0.9891967134434072, 20.156322318820703)),

(datetime.datetime(2011, 8, 1, 1, 0),

(1.0297360996475038, 20.360987284654527)),

(datetime.datetime(2011, 8, 1, 1, 15),

(0.9688234643816331, 20.392391087765752)),

(datetime.datetime(2011, 8, 1, 1, 30),

(0.9719296831820816, 20.41472299672638))]

- Interaction entre time_series et les objets Layers(), Column() et Time_series() pour mettre à jour l’objet Column() avec les profils de température calculés par le modèle direct à partir des observations simulées :_measures_column_one_layer()

Paramètres :

- Coulumn, un objet colonne
- liste de Layer,
- nb_cells, le nombre de cellules pour le modèle direct

Retourne :

- aucun retour, les objets sont mis à jour notamment pour Time_series qui met à jour avec les valeur de compute_solve_transi : self._T_measures, self._T_Shaft, self._T_Shaft_measures

Exemple :

>>>emu_observ_test_user1._T_Shaft_measures # le fichier de température du shaft par défaut au format de la colonne

[(datetime.datetime(2010, 1, 1, 0, 0),

array([291.15, 289.15, 287.15, 285.15])),

(datetime.datetime(2010, 1, 1, 0, 15),

array([9.59595e+05, 9.59595e+05, 9.59595e+05, 2.85150e+02])),

(datetime.datetime(2010, 1, 1, 0, 30),

array([9.59595e+05, 9.59595e+05, 9.59595e+05, 2.85150e+02])),

(datetime.datetime(2010, 1, 1, 0, 45),

array([9.59595e+05, 9.59595e+05, 9.59595e+05, 2.85150e+02])),

(datetime.datetime(2010, 1, 1, 1, 0),

array([9.59595e+05, 9.59595e+05, 9.59595e+05, 2.85150e+02])),

(datetime.datetime(2010, 1, 1, 1, 15),

array([9.59595e+05, 9.59595e+05, 9.59595e+05, 2.85150e+02])),

…

(datetime.datetime(2010, 1, 1, 1, 30),

array([9.59595e+05, 9.59595e+05, 9.59595e+05, 2.85150e+02]))]

>>>emu_observ_test_user1._measures_column_one_layer(col, layers_list, nb_cells)

>>>emu_observ_test_user1._T_Shaft_measures # les mesures d’observations sont bien mises à jour et peuvent être utilisées par la MCMC

[(datetime.datetime(2010, 1, 1, 0, 0),

array([291.15, 289.15, 287.15, 285.15])),

(datetime.datetime(2010, 1, 1, 0, 15),

array([291.19003296, 289.19003296, 287.19003296, 285.15 ])),

(datetime.datetime(2010, 1, 1, 0, 30),

array([291.19006348, 289.19003296, 287.19009399, 285.15 ])),

(datetime.datetime(2010, 1, 1, 0, 45),

array([291.19012451, 289.19006348, 287.19015503, 285.15 ])),

(datetime.datetime(2010, 1, 1, 1, 0),

array([291.19015503, 289.19006348, 287.19018555, 285.15 ])),

(datetime.datetime(2010, 1, 1, 1, 15),

array([291.19021606, 289.19012451, 287.19024658, 285.15 ])),

(datetime.datetime(2010, 1, 1, 1, 30),

array([291.19024658, 289.19015503, 287.19024658, 285.15 ])),

(datetime.datetime(2010, 1, 1, 1, 45),

## Solution analytique

Ces méthodes permettent de visualiser la solution analytique et la comparer avec des données sorties du modèle direct. Les fonctions détaillées dans cette partie sont des méthodes de la classe Column, et elles ne peuvent pas être utilisées avant d’avoir appelé le modèle direct une première fois.

La solution analytique en cas général est :

θ(z,t)=θ_μ +θ_(amp) ∗e^(−az) ∗cos((2π)/Pt−bz)

avec a=1/(2κ_e) , b=1/(2κ_e) , v_t =−α_e (∂H)/(∂z)

La solution analytique en cas conductif est :

θ(z,t)=θ_μ +θ_(amp) ∗e^(−√())

- Définir un objet Analy_Sol() :

Paramètres :

- column_exp
- time_series
- monolayer
- nb_cells

Retourne :

- un objet analy_sol avec certains attributs.

Exemple :

analy_sol_dict = {

"column_exp" : colonne_exp,

"time_series" : time_series,

"monolayer" : monolayer,

"nb_cells" : nb_cells,

- Récupérer les coefficients utilisés dans la solution analytique : compute_a, compute_b

Paramètres :

- aucun

Retourne :

- valeur des coefficients calculés d’après les propriétés hydro-thermiques et la période de signal.

Exemple :

>>> analy_sol_exp.compute_a()

3.3823968938956313

>>> analy_sol_exp.compute_b()

3.3825115862919444

- Calculer la température calculée par la solution analytique en cas général : compute_temps_general

Paramètres :

- aucun

Retourne :

- tableau des températures calculées analytiquement en cas général.

Exemple :

>>> analy_sol_exp.compute_temp_general()

array([[19.93348742, 19.97025726, 20.00702969, ..., 21.86397401,

21.83151255, 21.79889098],

[19.80717211, 19.842684 , 19.87820964, ..., 21.91417479,

21.88337573, 21.85241202],

[19.68954571, 19.72380338, 19.75808519, ..., 21.95685757,

21.9276803 , 21.89833451],

...,

[20.02302351, 20.02165697, 20.02028854, ..., 19.91251124,

19.91362946, 19.91475523],

[20.02701995, 20.02570645, 20.0243907 , ..., 19.9115726 ,

19.91262644, 19.91368792],

[20.03069522, 20.02943418, 20.02817058, ..., 19.91089097,

19.91188231, 19.91288135]])

- Calculer la température calculée par la solution analytique en cas conductif : compute_temp_cond

Paramètres :

- aucun

Retourne :

- tableau des températures calculées analytiquement en cas conductif.

Exemple :

>>> analy_sol_exp.compute_temp_cond()

array([[19.93348746, 19.97025727, 20.00702969, ..., 21.86397294,

21.8315115 , 21.79888994],

[19.80717244, 19.84268427, 19.87820985, ..., 21.9141715 ,

21.88337249, 21.85240884],

[19.6895466 , 19.72380417, 19.75808588, ..., 21.95685196,

21.92767477, 21.89832907],

...,

[20.02302094, 20.02165455, 20.02028627, ..., 19.91252102,

19.91363912, 19.91476476],

[20.0270169 , 20.02570355, 20.02438794, ..., 19.91158259,

19.91263631, 19.91369767],

[20.03069171, 20.02943082, 20.02816736, ..., 19.91090114,

19.91189236, 19.91289129]])

- Calculer la RMSE du modèle direct par rapport aux solutions analytiques sur des conditions aux limites simples et dans un cas de monocouche : generate_RMSE_analytical

Paramètres :

- time_series : déjà expliqué dans la partie précédente
- colonne_exp : un objet de Colonne
- monolayer : un objet de Layer

Retourne :

- array contenant les RMSE du modèle direct par rapport aux solutions analytiques.

Exemple :

"""Colonne"""

col_dict = {

"river_bed": 1.,

"depth_sensors": depth_sensors, #En vrai y aura une 4e valeur ici mais ca prendra en charge pareil

"offset": .0,

"dH_measures": time_series._T_riv_dH_measures,

"T_measures": time_series._T_Shaft_measures,

"sigma_meas_P": time_series._sigma_P, #float

"sigma_meas_T": time_series._sigma_T, #float

}

colonne_exp = Column.from_dict(col_dict)

"""Layer"""

monolayer_dict = {

"name": "sable",

"zLow": depth_sensors[-1],

"moinslog10K": moinslog10K,

"n": n,

"lambda_s": lambda_s,

"rhos_cs": rho_cs

}

monolayer = Layer.from_dict(monolayer_dict)

>>> analy_sol_exp.generate_RMSE_analytical(time_series, colonne_exp, monolayer)

--- Compute Solve Transi ---

One layer : moinslog10K = 12, n = 0.1, lambda_s = 2, rhos_cs = 4000000.0

Done.

array([0.00123811, 0.00315148, 0.00548253, 0.00372034])

NB : Dans le module val_analy.py nous n’avons pas créé des plotteurs. Cependant, nous avons créé une démo où nous faisons la comparaison visuelle du modèle direct et de la solution analytique avec une durée choisie.

Exemple :

>>> t_fin =1500

>>> for i,id_sens in enumerate(analy_sol_exp._id_sensors) : plt.plot(analy_sol_exp.analy_temp_general[id_sens,:t_fin],label="Tanaly{}".format(i+1))

plt.plot(time_series._T_Shaft[:t_fin,i],linestyle="--",label="Tmd{}".format(i+1))

plt.legend()

plt.grid()

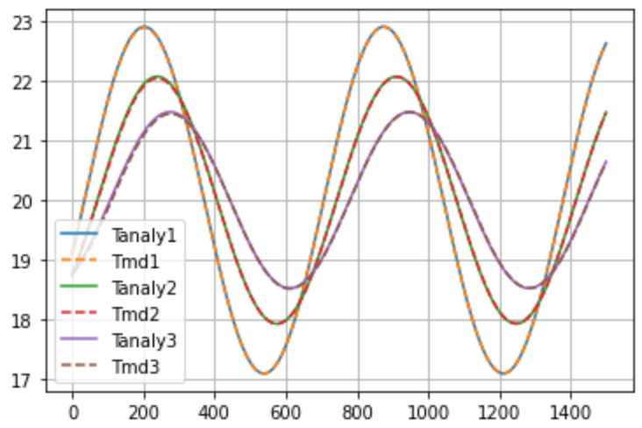
[picture p73: figure]
