flipoyo/MOLONARI1D/hardware/archived/deployment_v1/Kit_Système_MOLONARI.md

# This document review all the components of the MOLONARI System and paths to find how to design them 

## Components 
### To put in the RiverBed
- 3D printed shaft (glue needed?)
- Plastic piece of tube (to connect the shaft to the box) 
- Metallic box 
- Temperature sensors
- Pressure sensor
- Arduino Electronic Circuit with a Waterproof Antenna and a battery 
- Spec sheet with parameters for pressure sensor's and temperature sensors' calibration 
### To put in the relay 
- Arduino Electronic Circuit with a Waterproof Antenna and a battery 
### To get the datas remotly 
- Gateway
