flipoyo/MOLONARI1D/data/Laboratory/pressure_sensors/2024-1.jpg

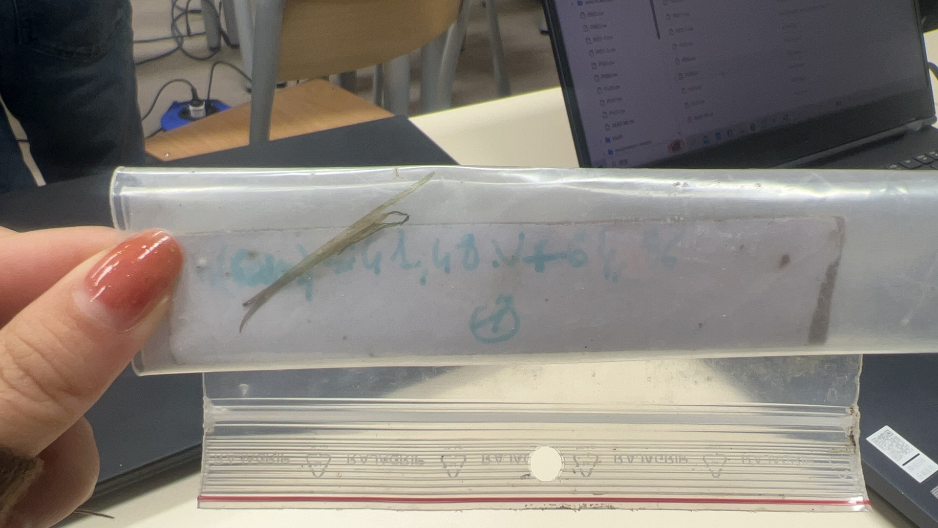
data/Laboratory/pressure_sensors/2024-1.jpg
