flipoyo/MOLONARI1D/data/Laboratory/pressure_sensors/2024-2.jpg

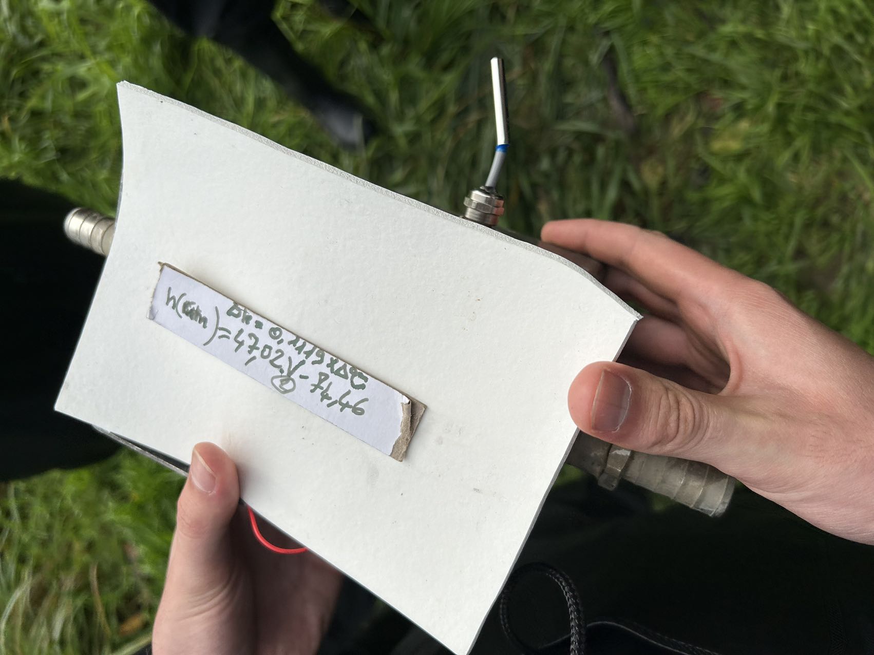
data/Laboratory/pressure_sensors/2024-2.jpg
