flipoyo/MOLONARI1D/data/SamplingPoints/Point034/point34_schema.png

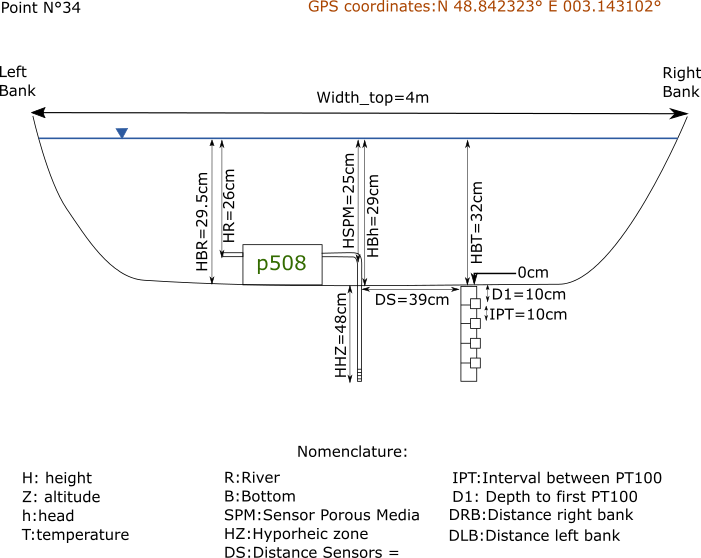
data/SamplingPoints/Point034/point34_schema.png
