flipoyo/MOLONARI1D/data/SamplingPoints/Point047/point47_schema.png

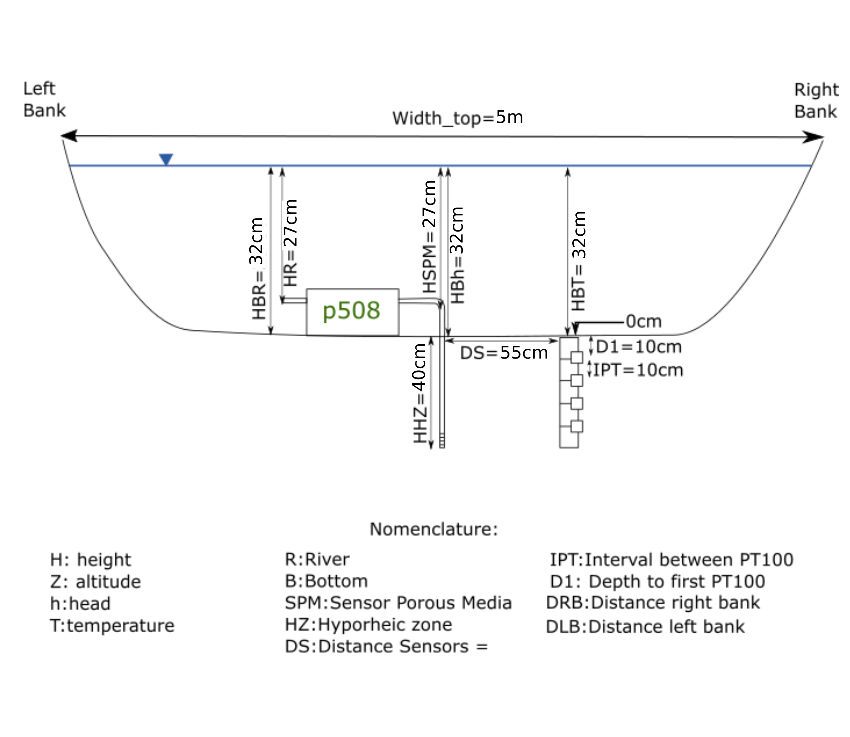
data/SamplingPoints/Point047/point47_schema.png
