flipoyo/MOLONARI1D/data/SamplingPoints/Point051-1/point051-1_schema.png

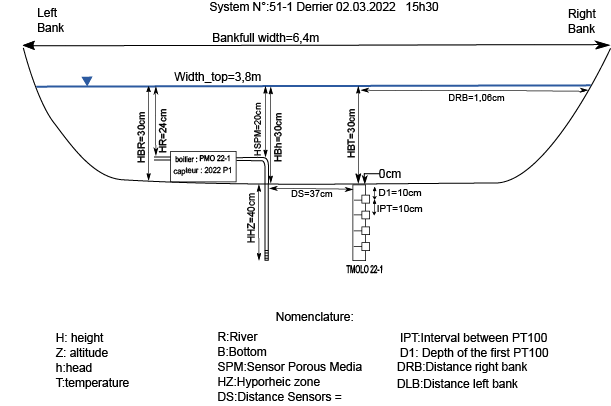
data/SamplingPoints/Point051-1/point051-1_schema.png
