flipoyo/MOLONARI1D/data/SamplingPoints/Point051-2/point051-2_schema.png

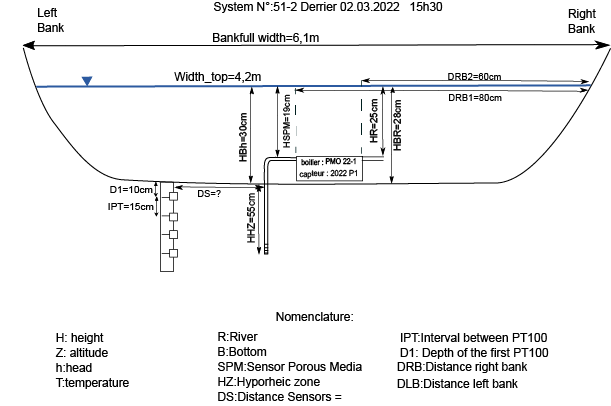
data/SamplingPoints/Point051-2/point051-2_schema.png
