flipoyo/MOLONARI1D/data/SamplingPoints/point53_13_10_23_pressureBrokenAfterMonitoring/point52_schema.png

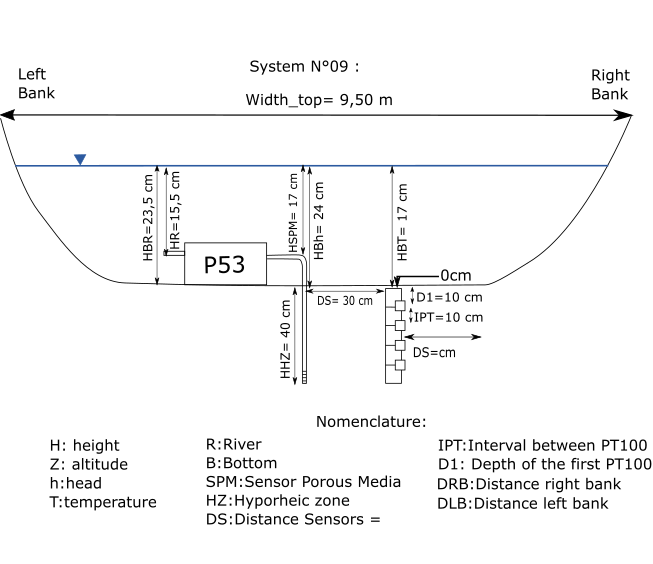
data/SamplingPoints/point53_13_10_23_pressureBrokenAfterMonitoring/point52_schema.png
