flipoyo/MOLONARI1D/data/SamplingPoints/Point2024-1(up_gauche)/point2024-1_schema.png

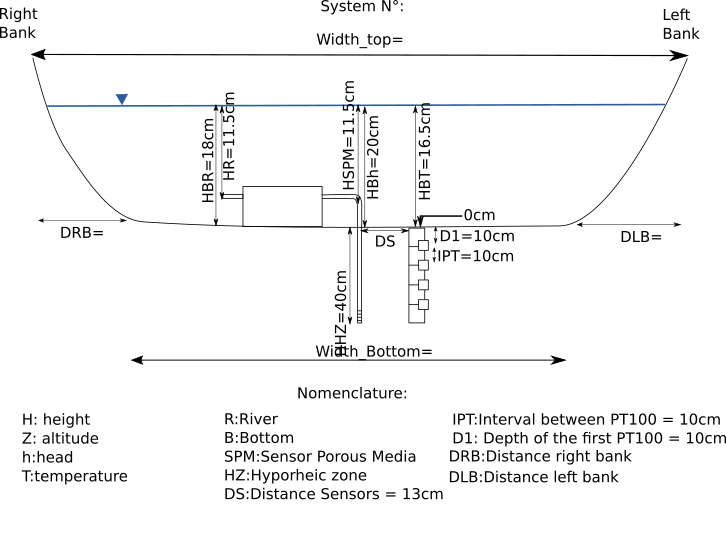
data/SamplingPoints/Point2024-1(up_gauche)/point2024-1_schema.png
