flipoyo/MOLONARI1D/dataAnalysis/inversion/Inversé/Point_13/calculs.png

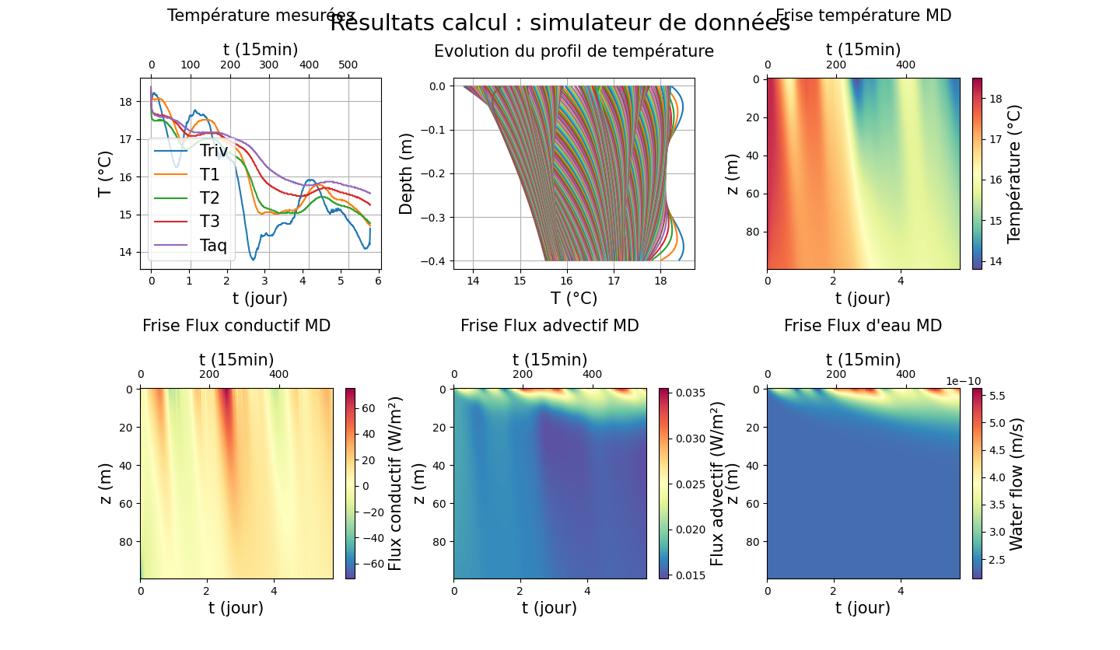
dataAnalysis/inversion/Inversé/Point_13/calculs.png
