flipoyo/MOLONARI1D/dataAnalysis/inversion/Inversé/Point_13/distrib.png

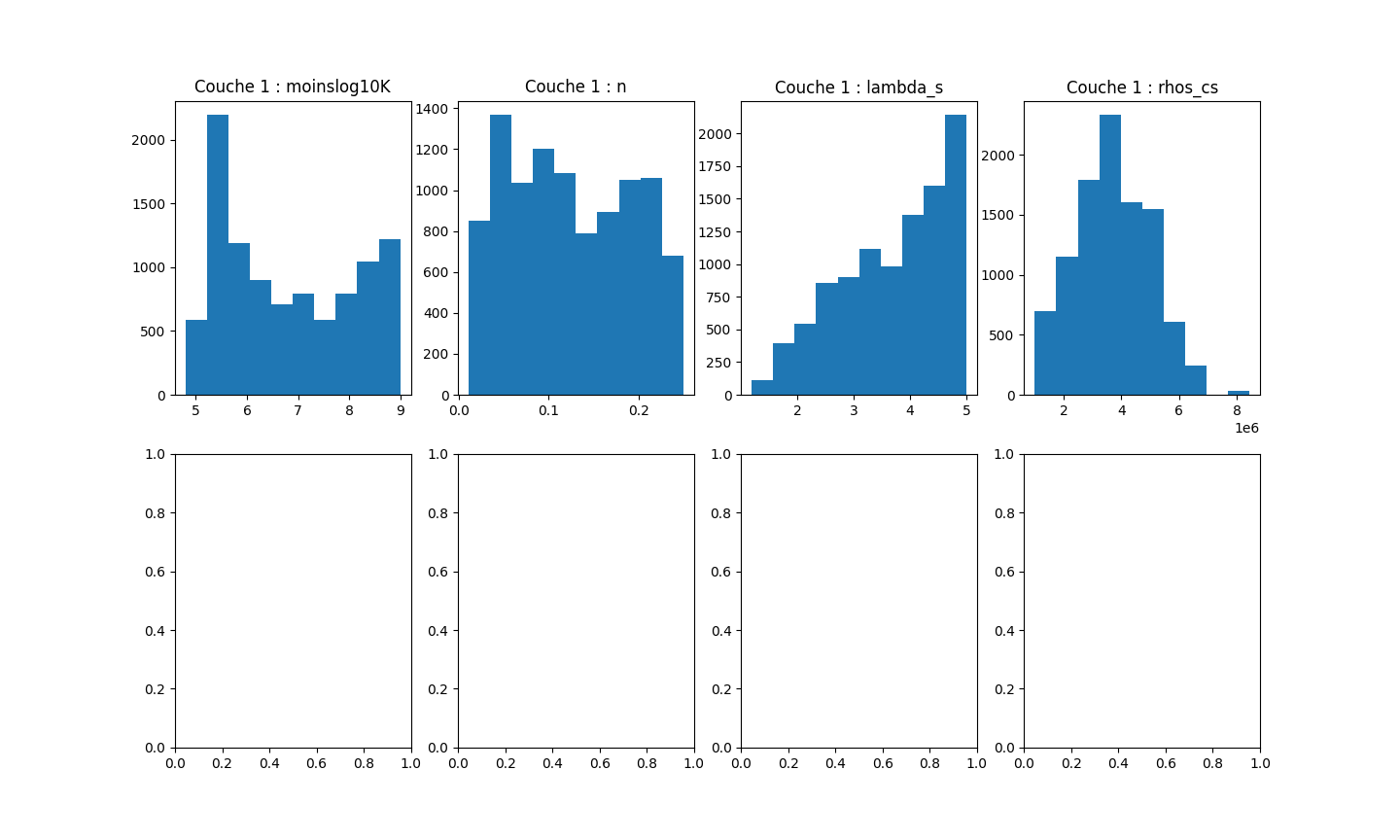
dataAnalysis/inversion/Inversé/Point_13/distrib.png
