flipoyo/MOLONARI1D/dataAnalysis/inversion/Inversé/Point_13/modele.png

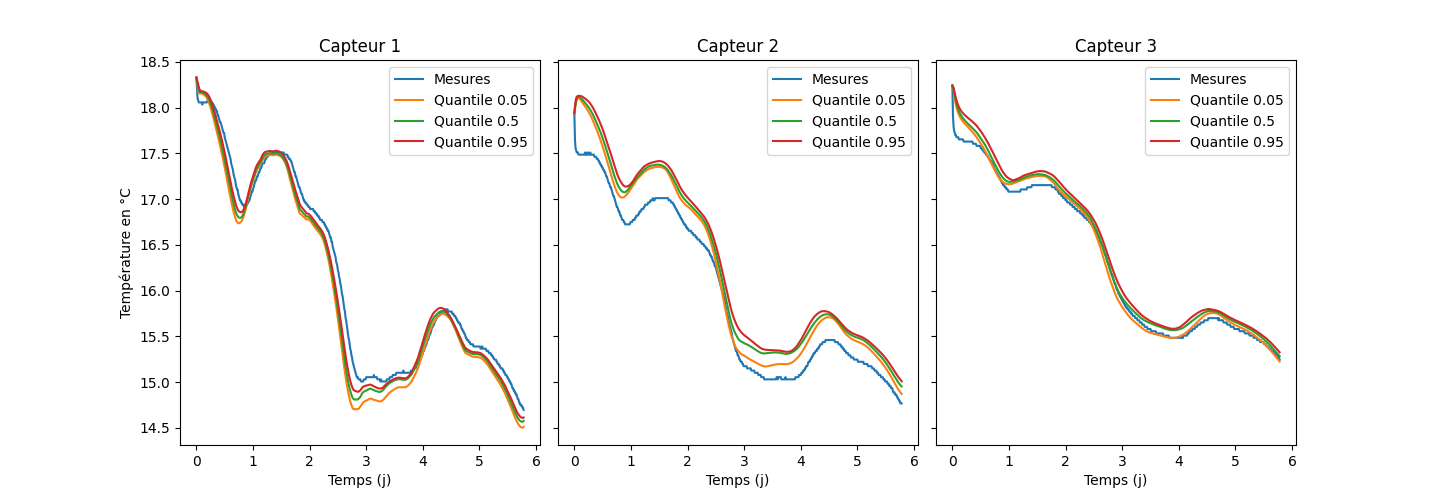
dataAnalysis/inversion/Inversé/Point_13/modele.png
