flipoyo/MOLONARI1D/dataAnalysis/inversion/Inversé/Point_13/quantiles.png

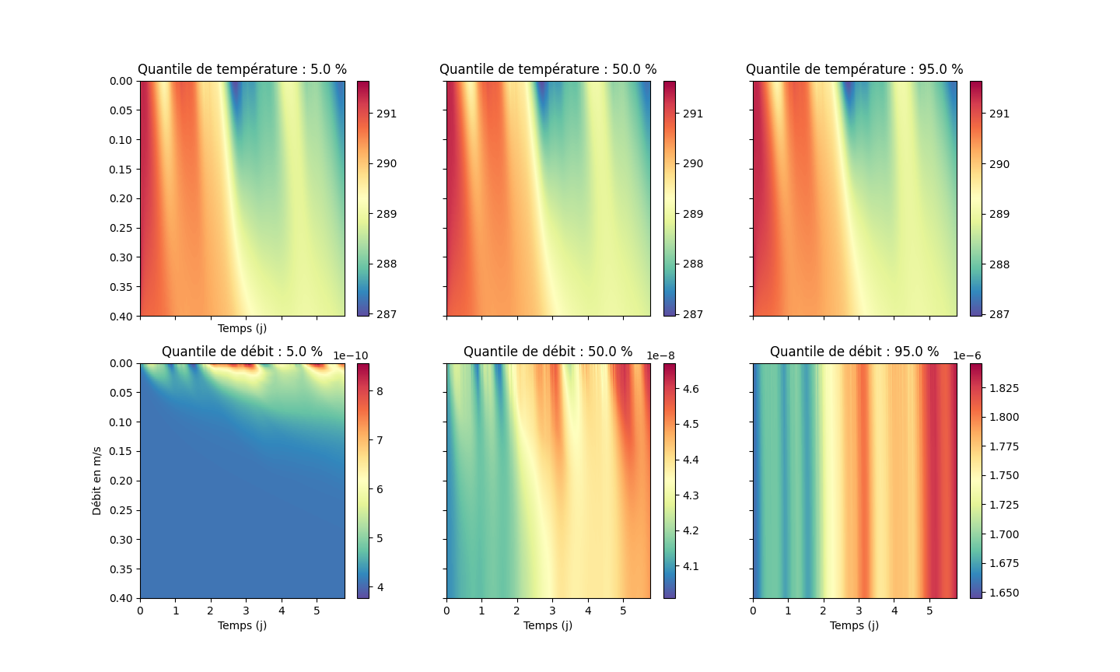
dataAnalysis/inversion/Inversé/Point_13/quantiles.png
