flipoyo/MOLONARI1D/dataAnalysis/inversion/Inversé/Point_14/calculs.png

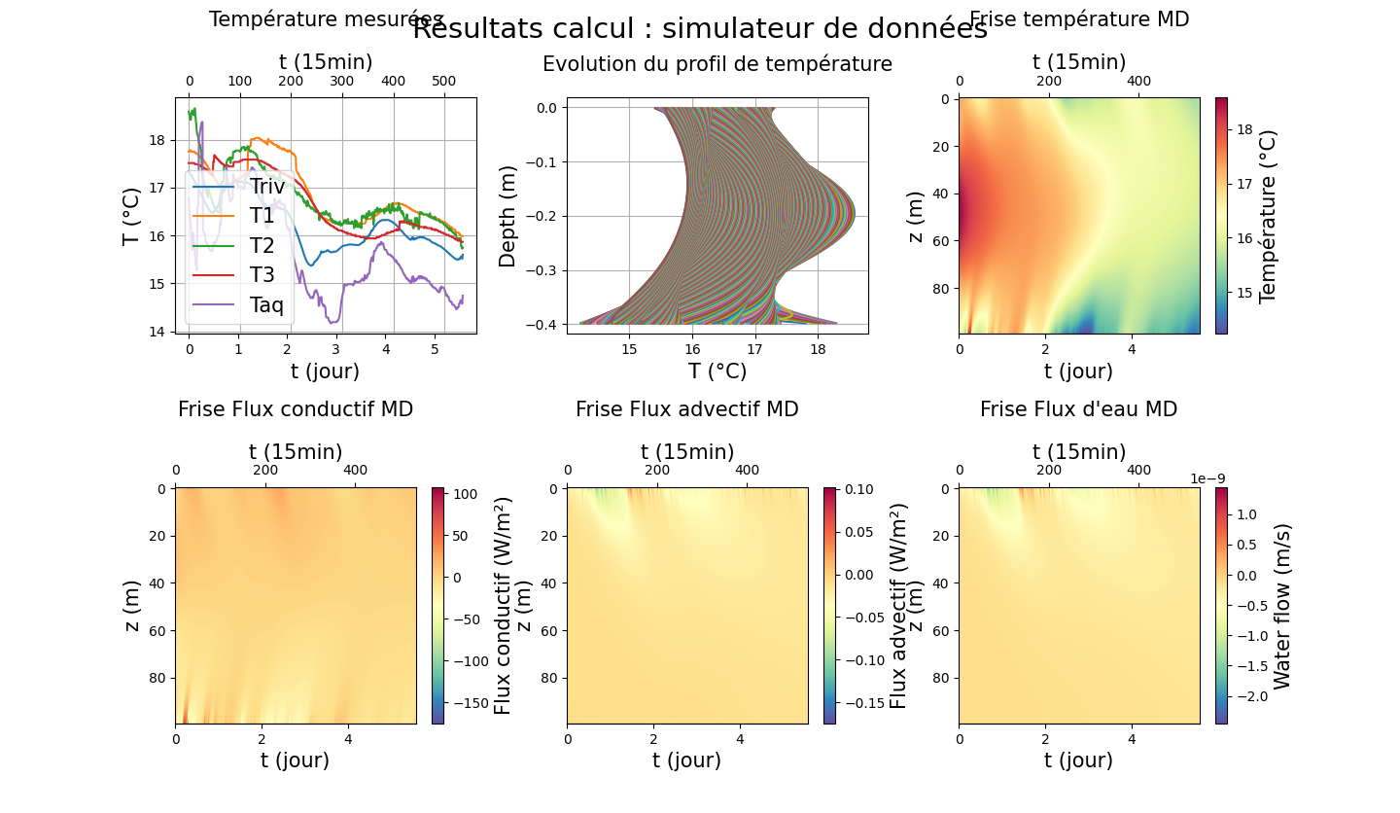
dataAnalysis/inversion/Inversé/Point_14/calculs.png
