flipoyo/MOLONARI1D/dataAnalysis/inversion/Inversé/Point_14/distrib.png

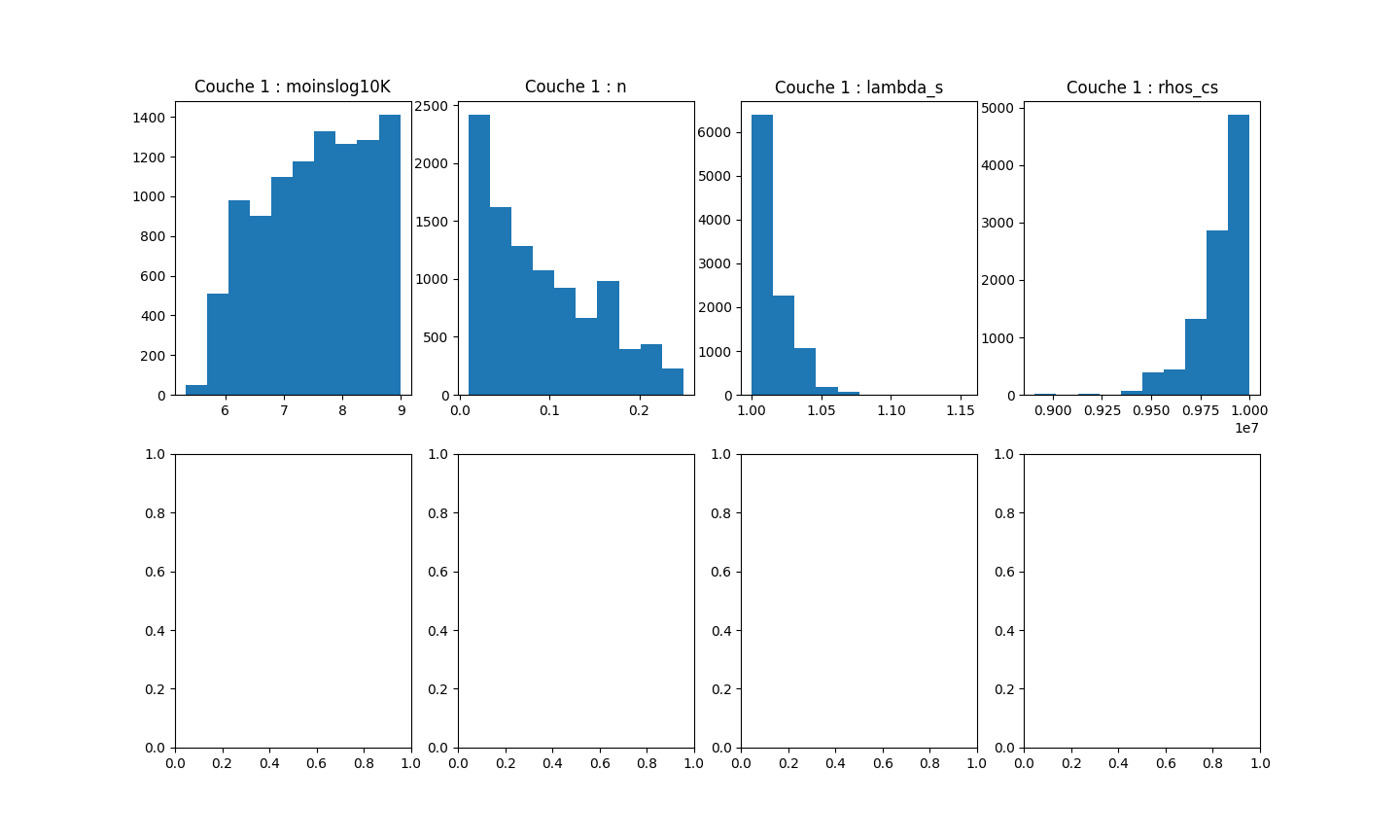
dataAnalysis/inversion/Inversé/Point_14/distrib.png
