flipoyo/MOLONARI1D/dataAnalysis/inversion/Inversé/Point_14/modele.png

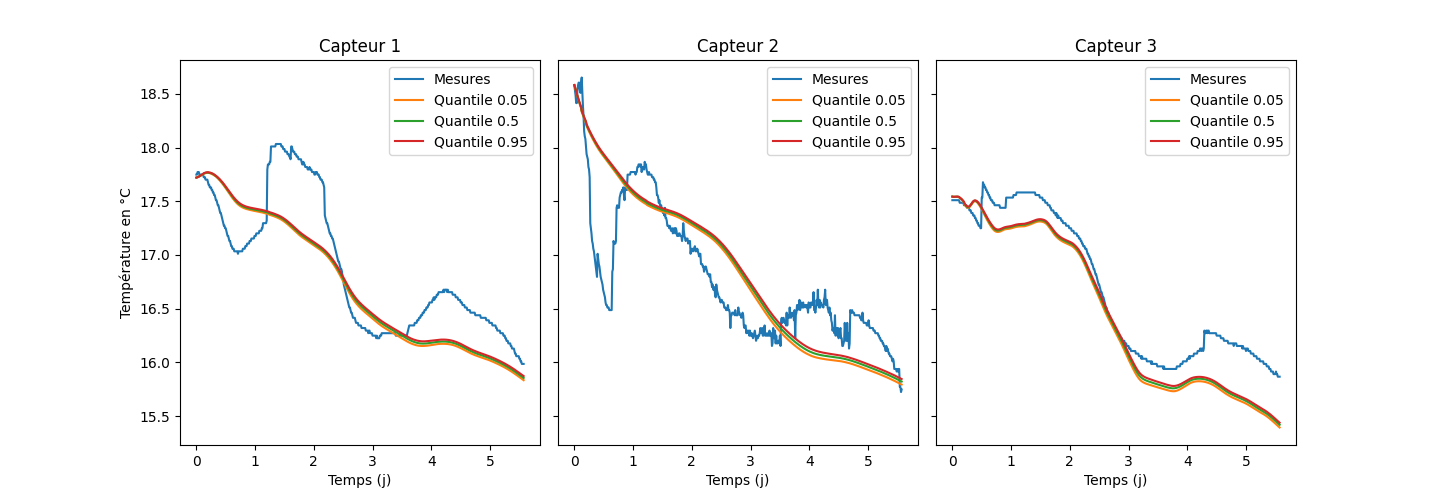
dataAnalysis/inversion/Inversé/Point_14/modele.png
