flipoyo/MOLONARI1D/dataAnalysis/inversion/Inversé/Point_14/q_débits.png

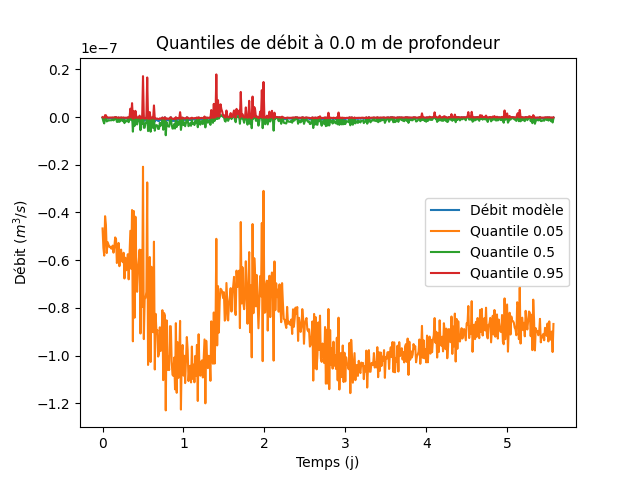
dataAnalysis/inversion/Inversé/Point_14/q_débits.png
