flipoyo/MOLONARI1D/dataAnalysis/inversion/Inversé/Point_14/quantiles.png

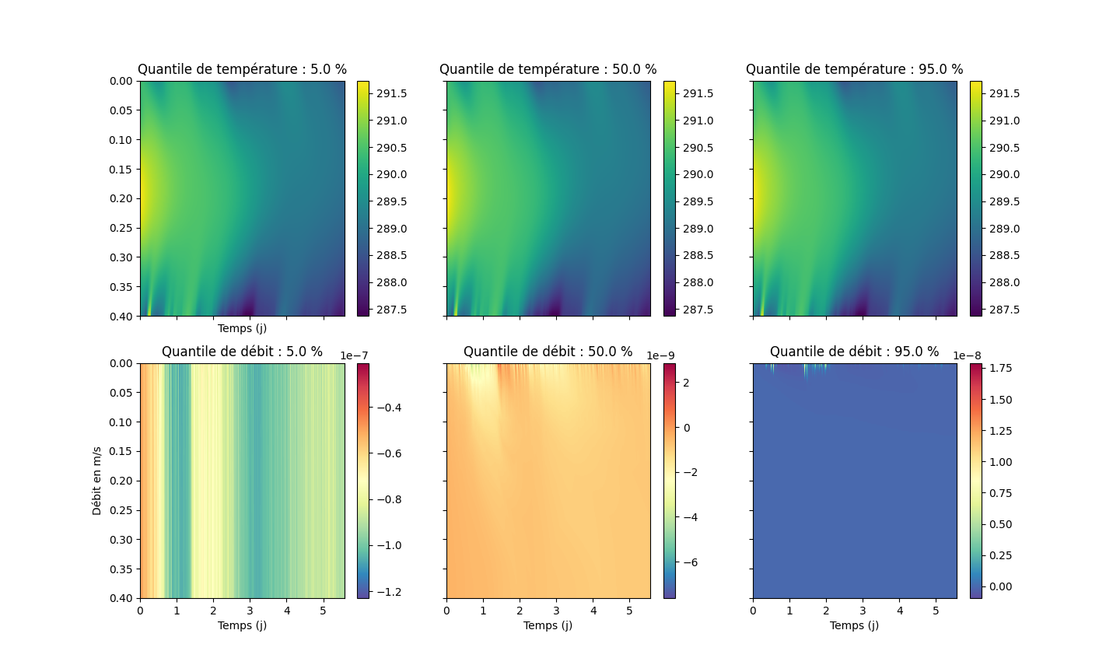
dataAnalysis/inversion/Inversé/Point_14/quantiles.png
