flipoyo/MOLONARI1D/dataAnalysis/inversion/Inversé/Point_34/calculs.png

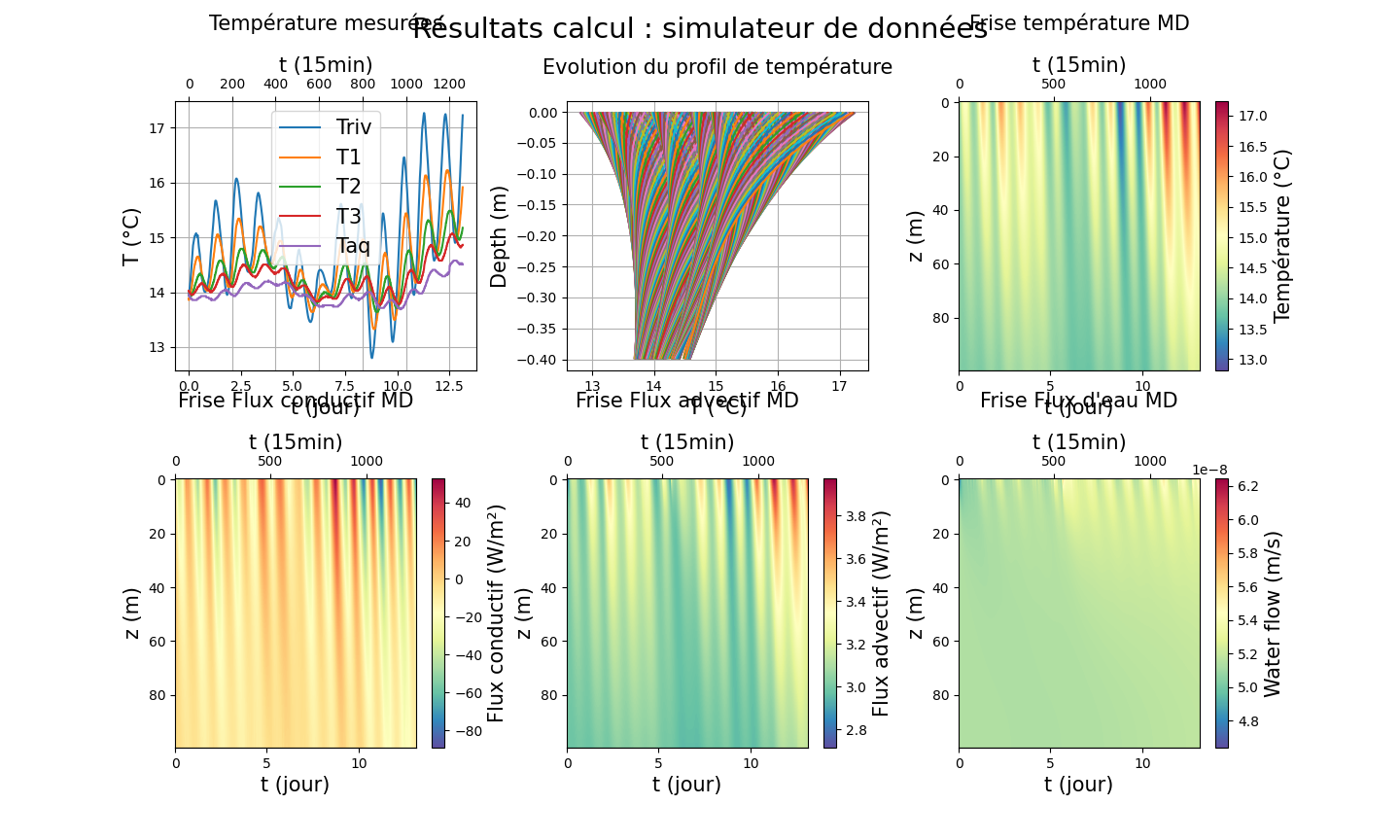
dataAnalysis/inversion/Inversé/Point_34/calculs.png
