flipoyo/MOLONARI1D/dataAnalysis/inversion/Inversé/Point_34/modèle.png

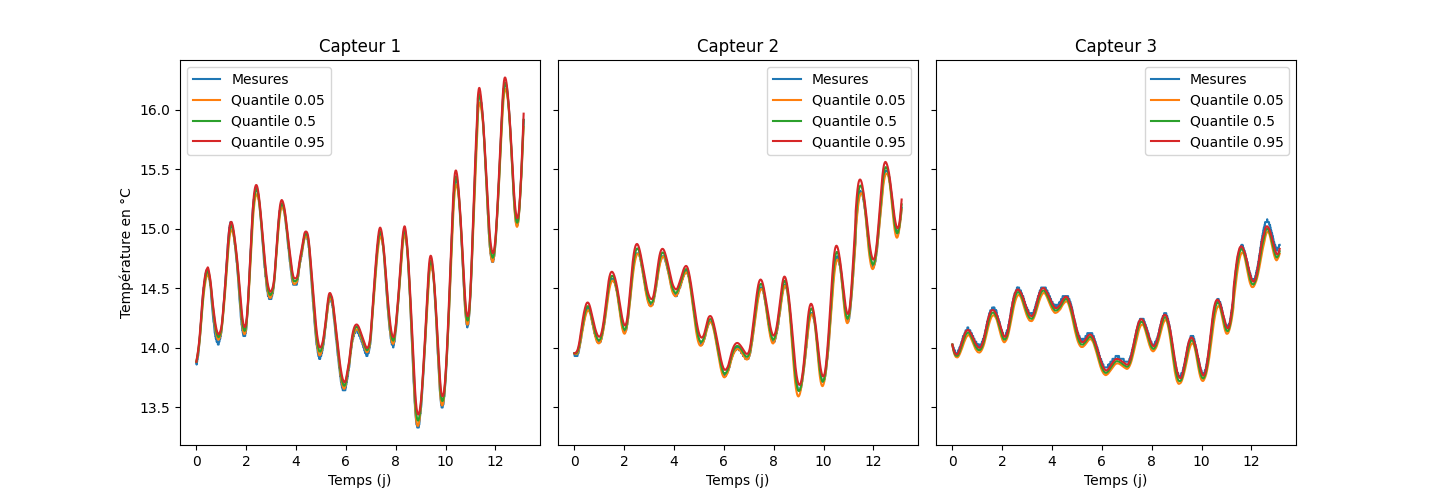
dataAnalysis/inversion/Inversé/Point_34/modèle.png
