flipoyo/MOLONARI1D/dataAnalysis/inversion/Inversé/Point_34/q_débit.png

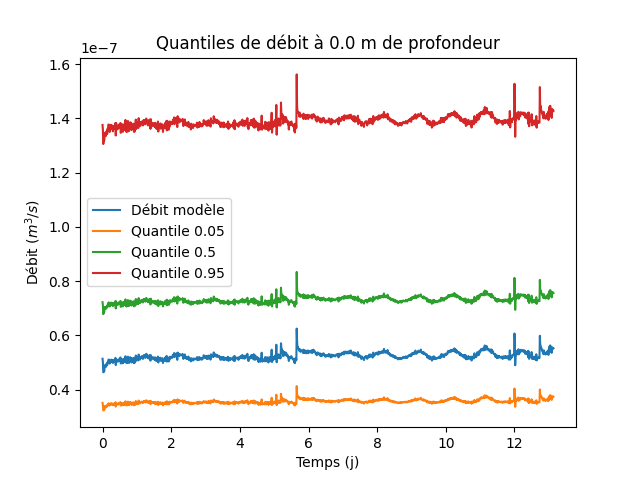
dataAnalysis/inversion/Inversé/Point_34/q_débit.png
