flipoyo/MOLONARI1D/dataAnalysis/inversion/Inversé/Point_34/quantiles.png

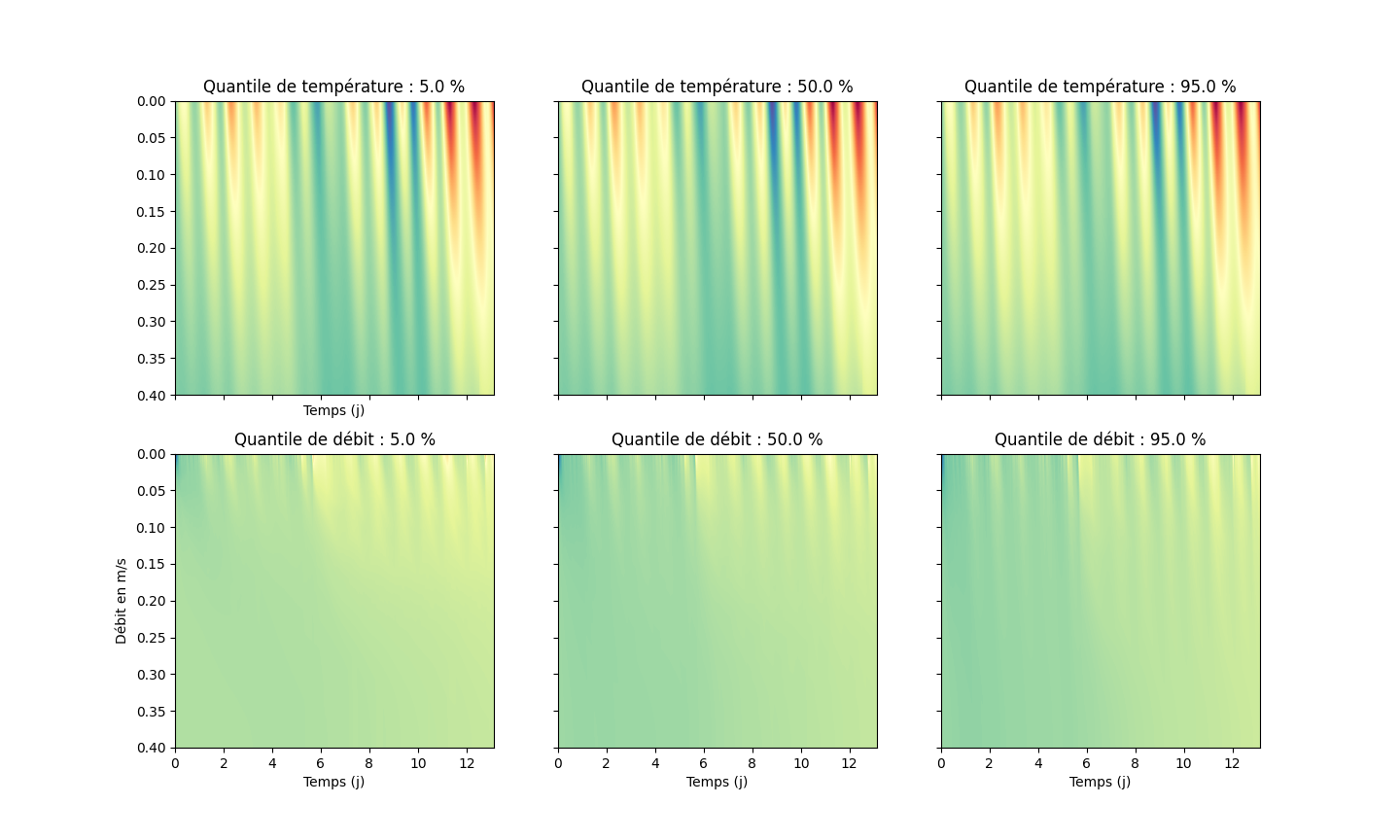
dataAnalysis/inversion/Inversé/Point_34/quantiles.png
