flipoyo/MOLONARI1D/dataAnalysis/inversion/Inversé/Point_35/calculs.png

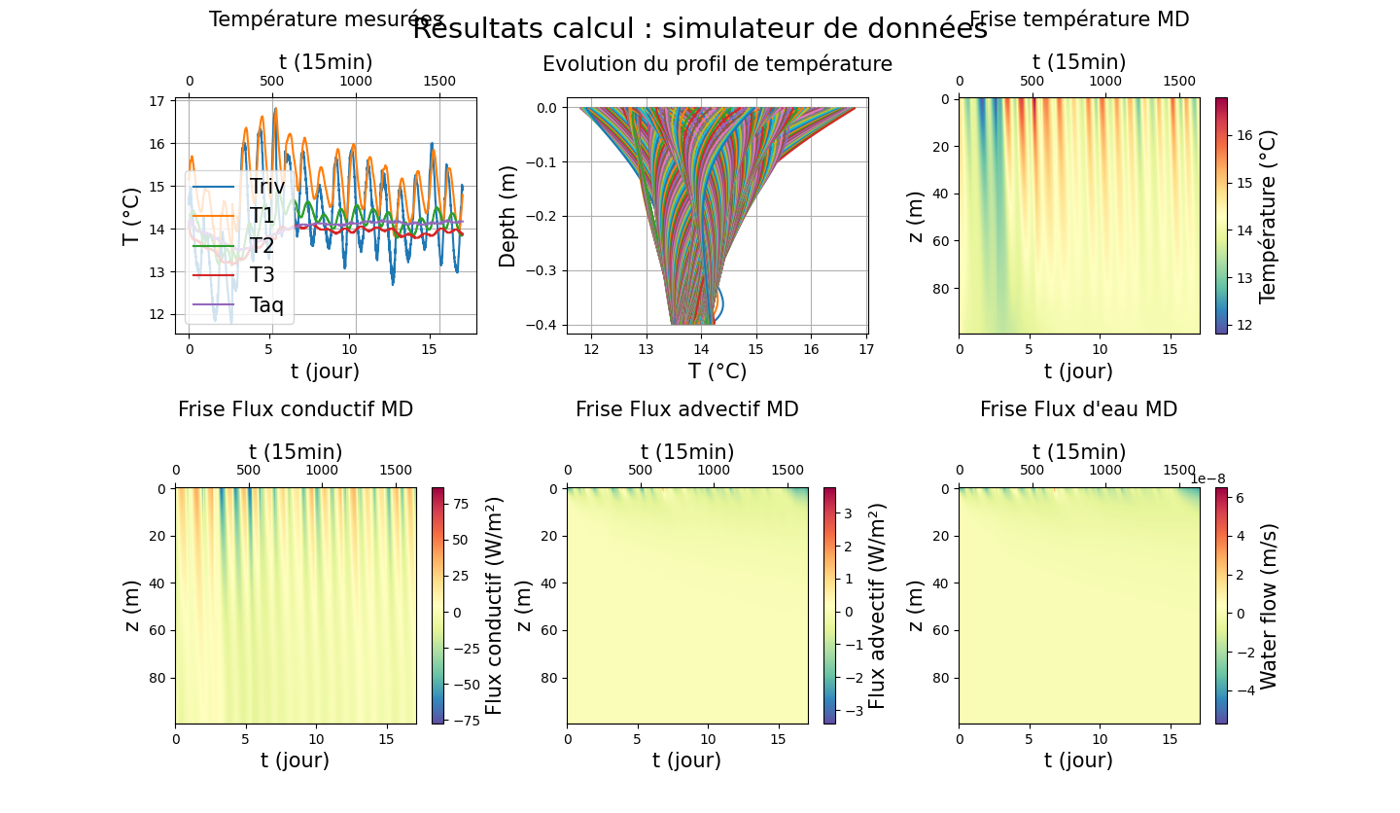
dataAnalysis/inversion/Inversé/Point_35/calculs.png
