flipoyo/MOLONARI1D/dataAnalysis/inversion/Inversé/Point_35/distrib.png

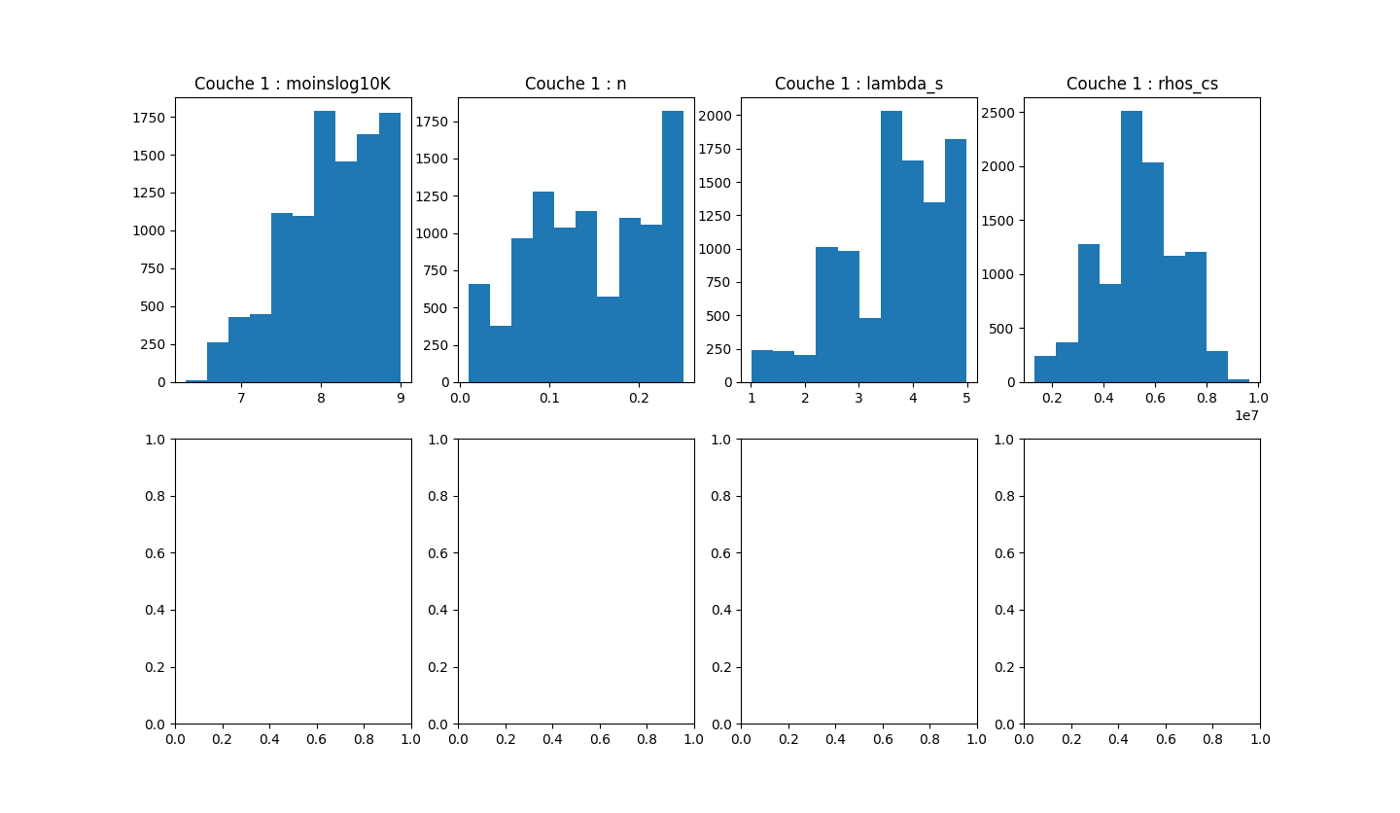
dataAnalysis/inversion/Inversé/Point_35/distrib.png
