flipoyo/MOLONARI1D/dataAnalysis/inversion/Inversé/Point_35/modele.png

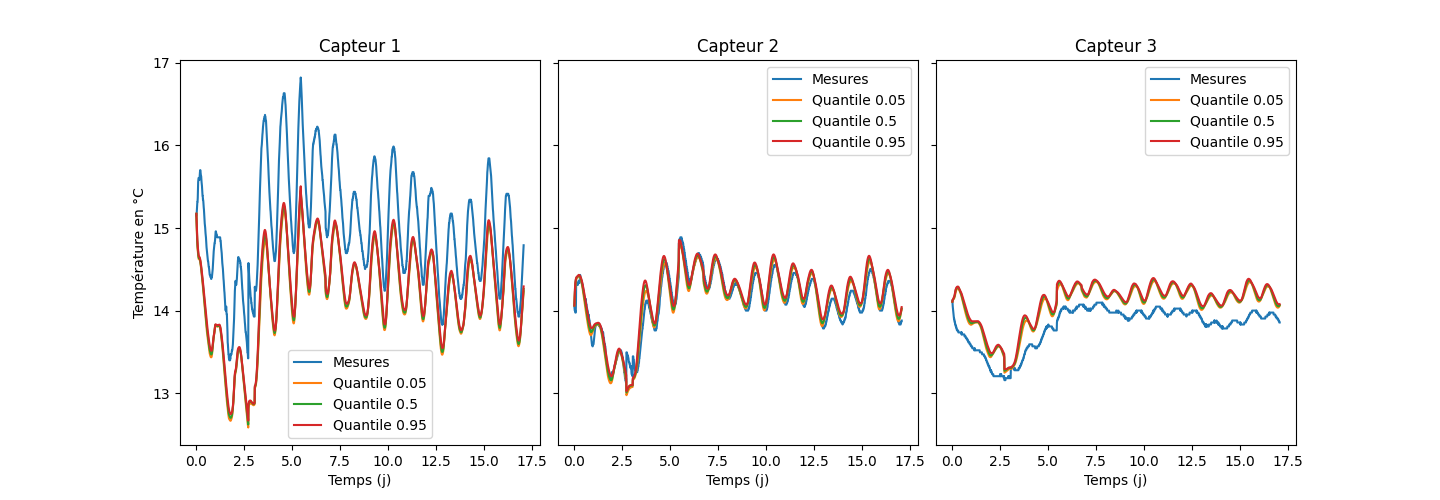
dataAnalysis/inversion/Inversé/Point_35/modele.png
