flipoyo/MOLONARI1D/dataAnalysis/inversion/Inversé/Point_35/q_débit.png

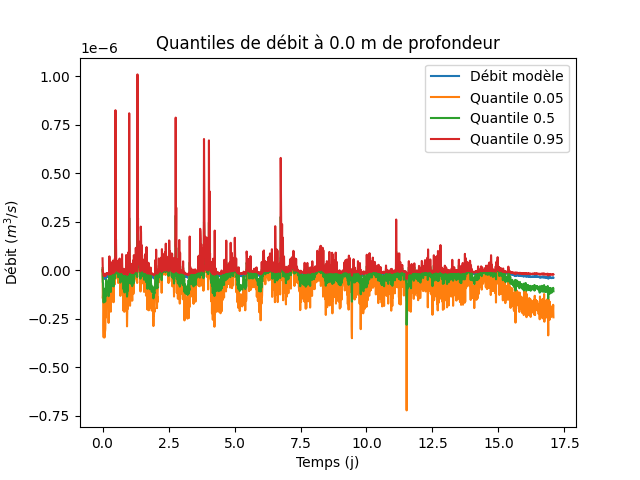
dataAnalysis/inversion/Inversé/Point_35/q_débit.png
