flipoyo/MOLONARI1D/dataAnalysis/inversion/Inversé/Point_38_4000/calculs.png

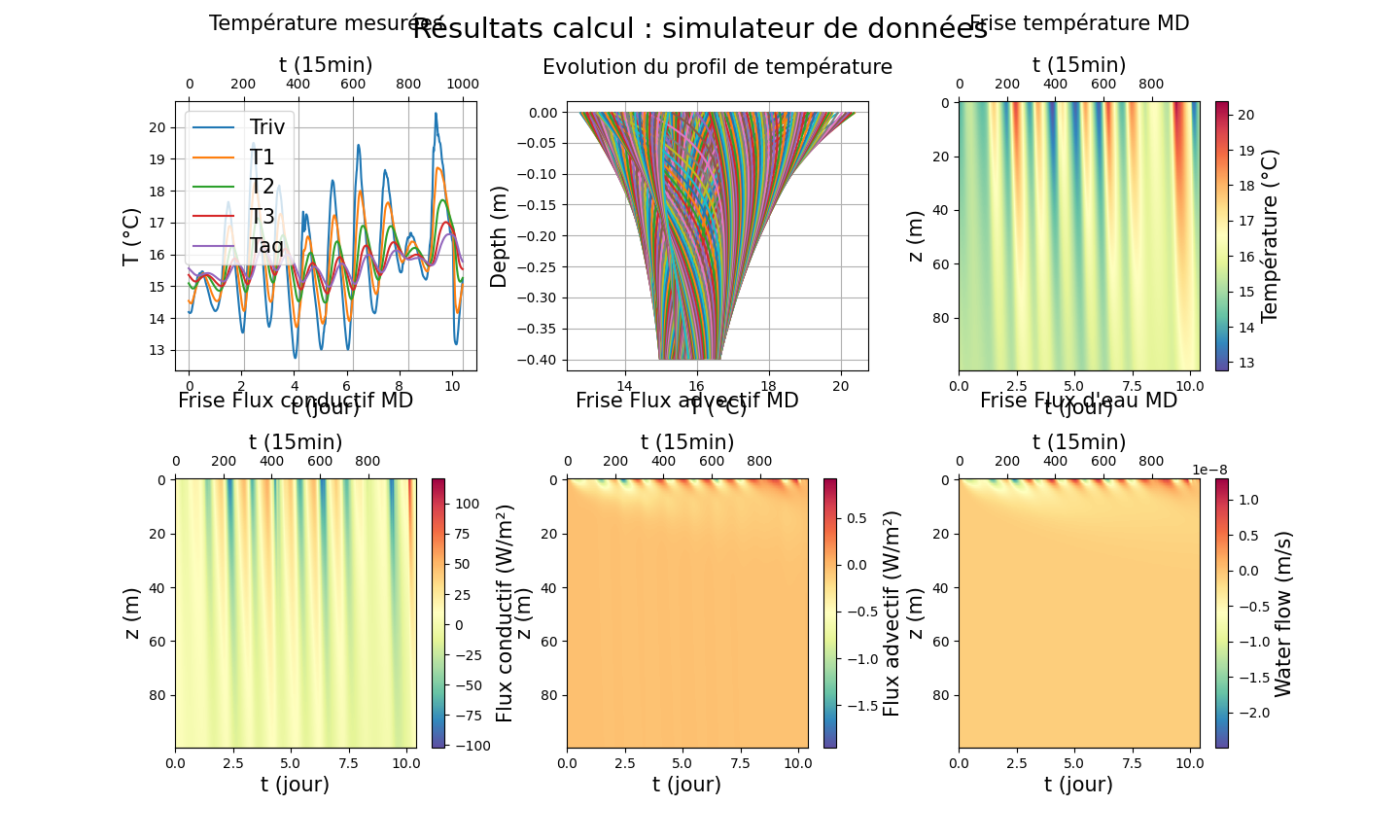
dataAnalysis/inversion/Inversé/Point_38_4000/calculs.png
