flipoyo/MOLONARI1D/dataAnalysis/inversion/Inversé/Point_38_4000/q_débit.png

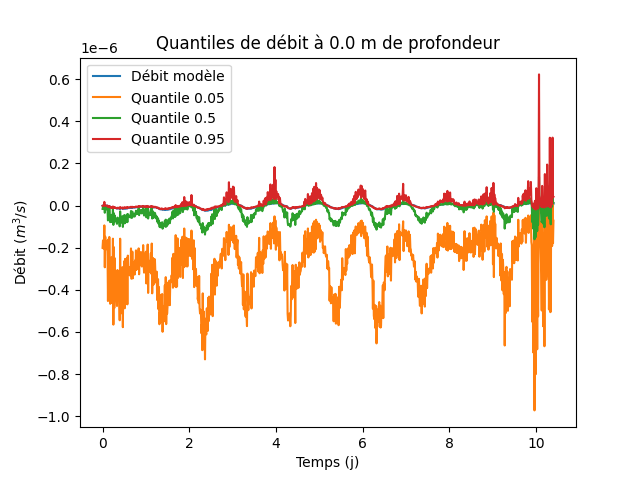
dataAnalysis/inversion/Inversé/Point_38_4000/q_débit.png
