flipoyo/MOLONARI1D/dataAnalysis/inversion/Inversé/Point_38_4000/quantiles.png

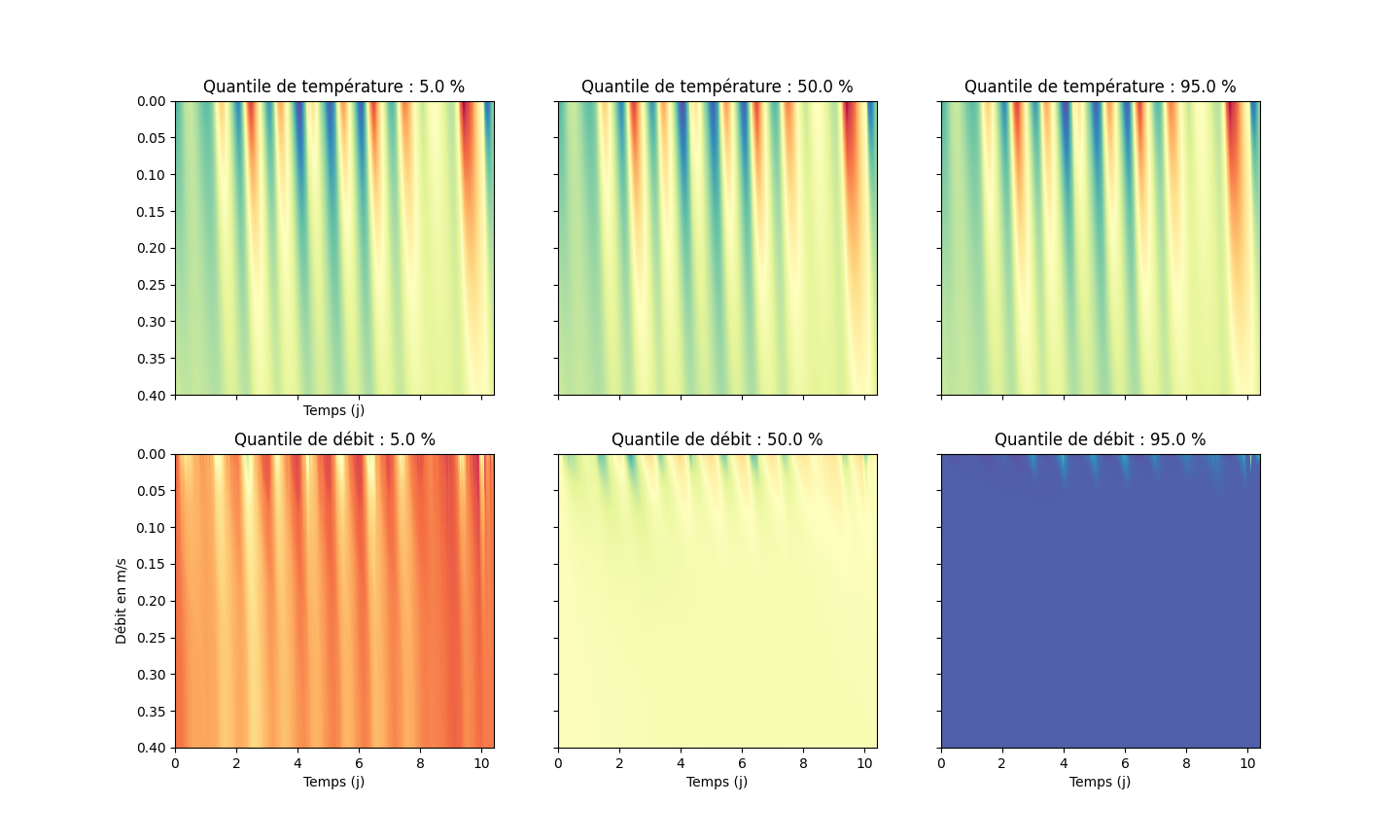
dataAnalysis/inversion/Inversé/Point_38_4000/quantiles.png
