flipoyo/MOLONARI1D/dataAnalysis/inversion/Inversé/Point_46/calculs.png

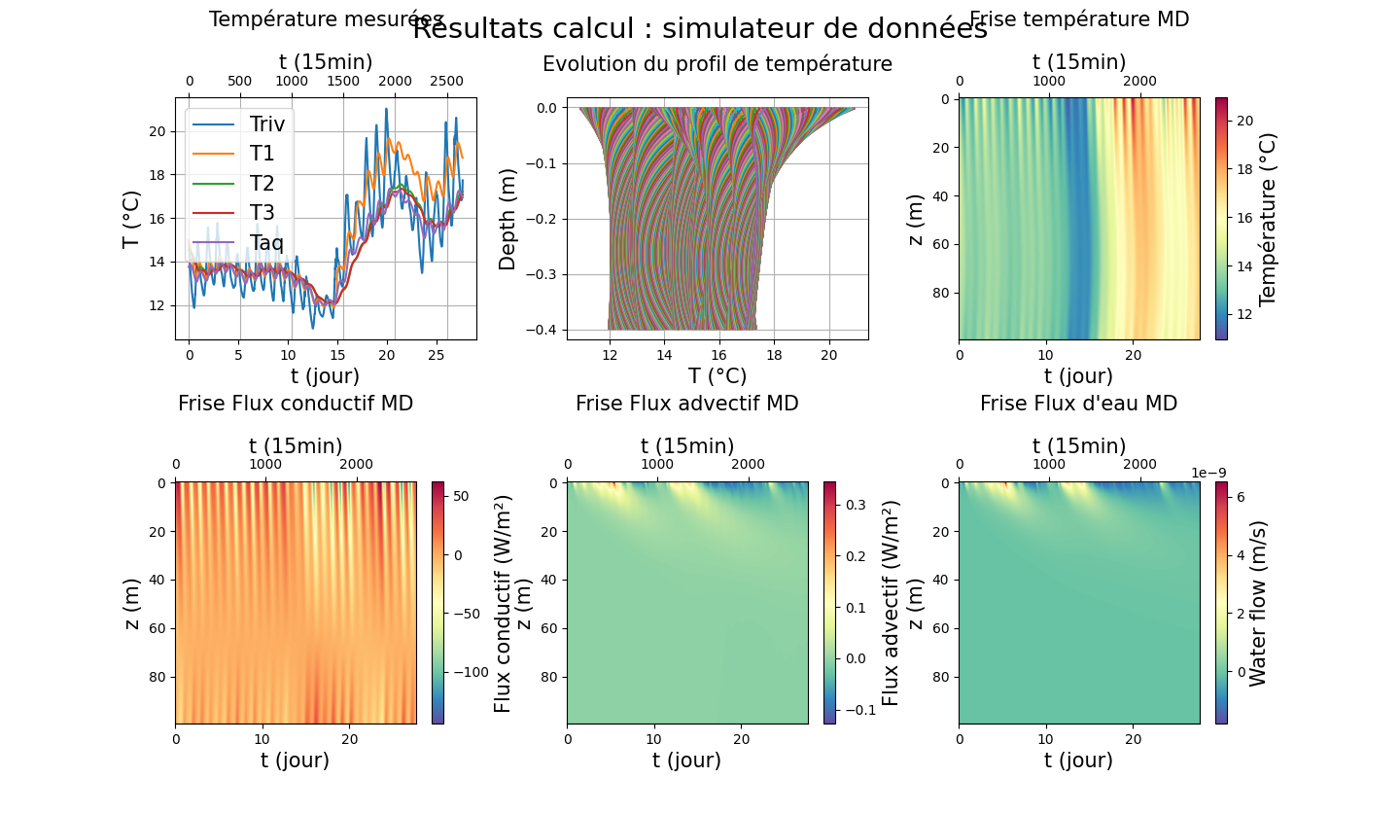
dataAnalysis/inversion/Inversé/Point_46/calculs.png
