flipoyo/MOLONARI1D/dataAnalysis/inversion/Inversé/Point_46/distrib.png

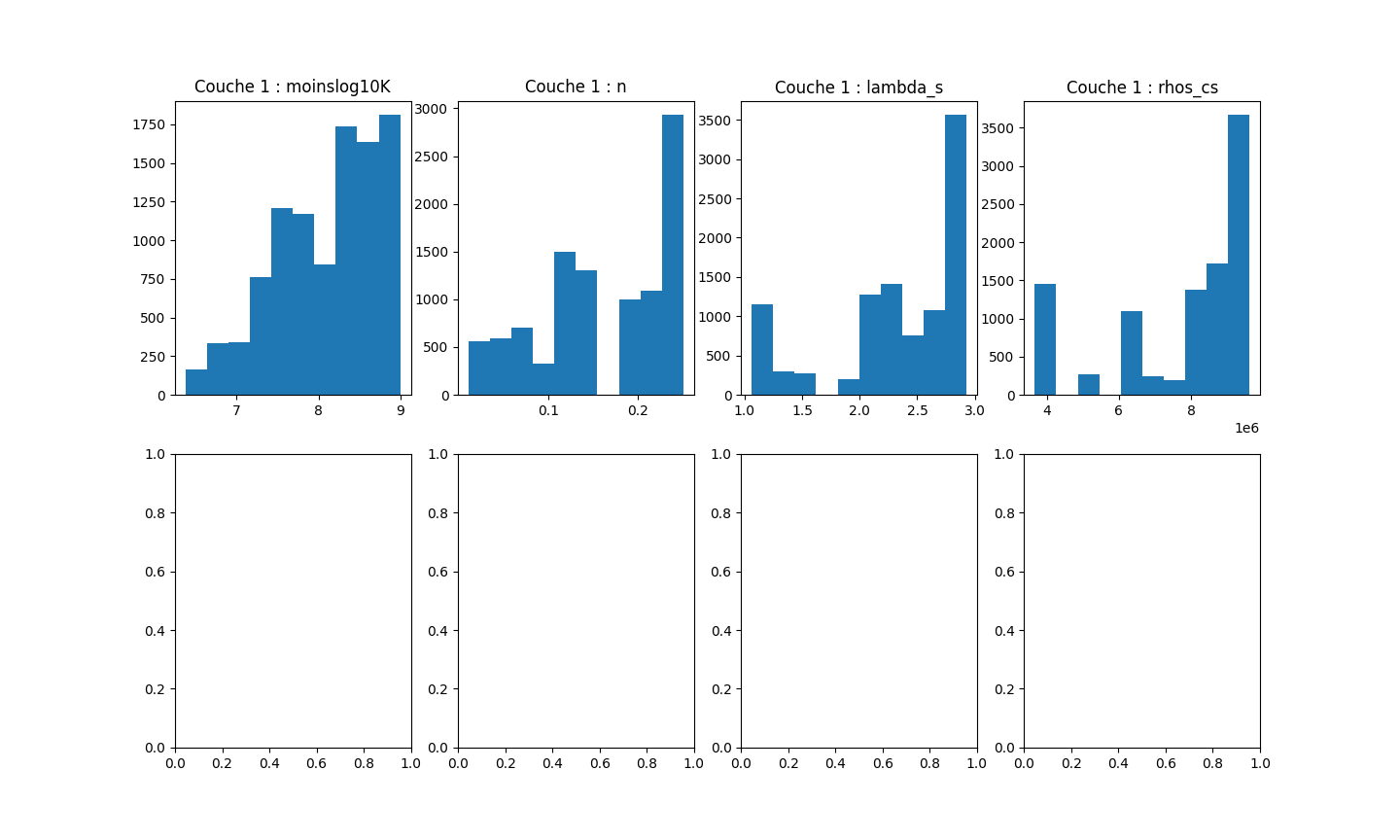
dataAnalysis/inversion/Inversé/Point_46/distrib.png
