flipoyo/MOLONARI1D/dataAnalysis/inversion/Inversé/Point_46/modele.png

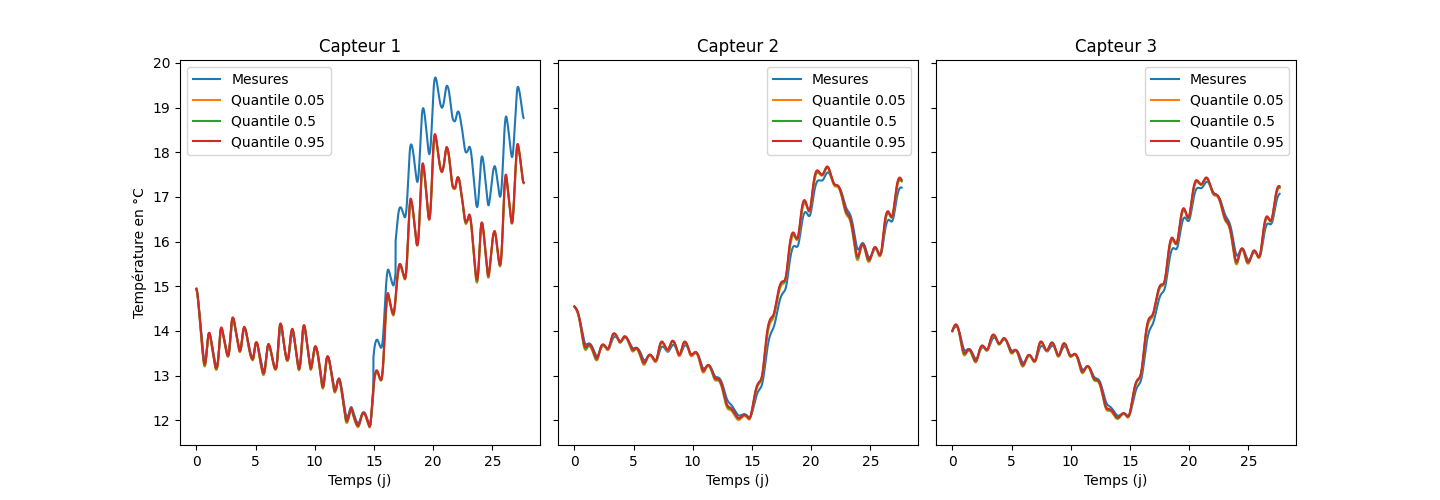
dataAnalysis/inversion/Inversé/Point_46/modele.png
