flipoyo/MOLONARI1D/dataAnalysis/inversion/Inversé/Point_46/q_debit.png

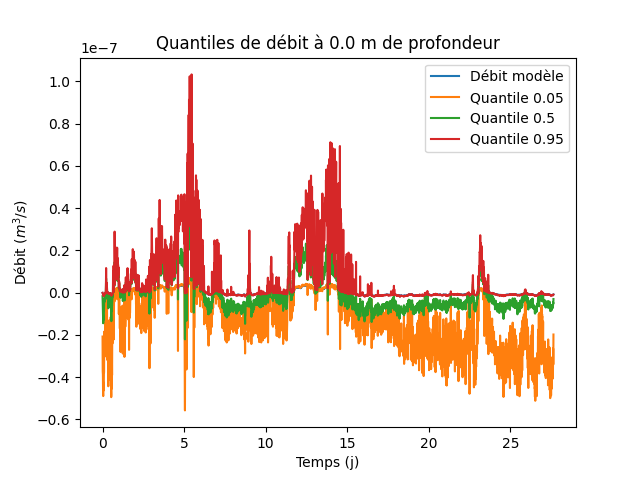
dataAnalysis/inversion/Inversé/Point_46/q_debit.png
