flipoyo/MOLONARI1D/dataAnalysis/inversion/Inversé/Point_46/quantiles.png

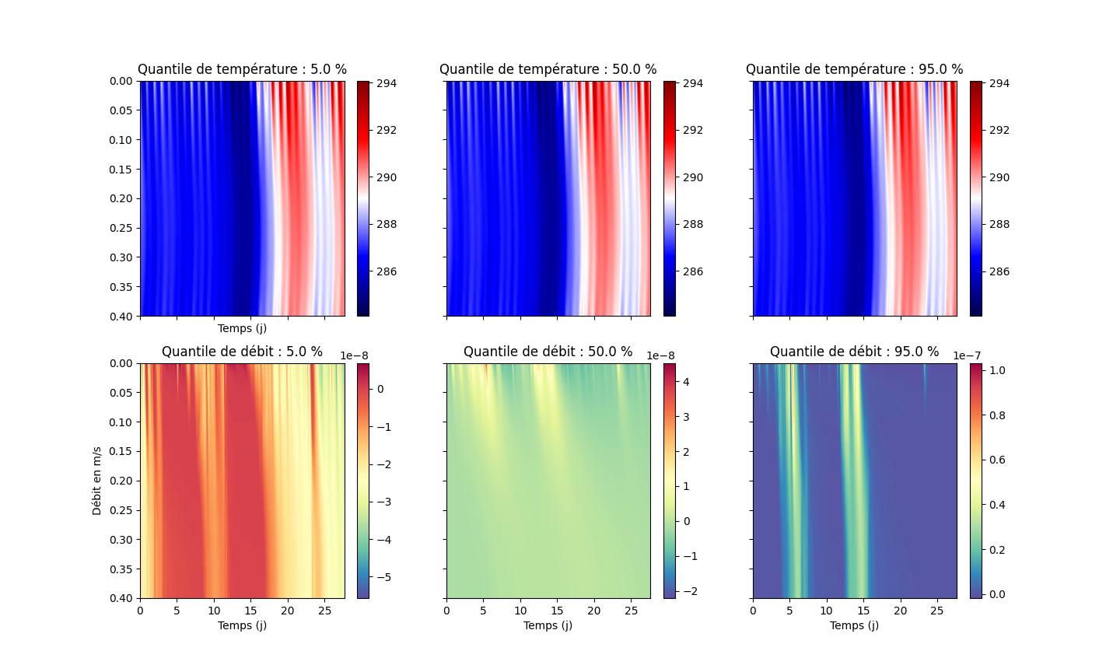
dataAnalysis/inversion/Inversé/Point_46/quantiles.png
