flipoyo/MOLONARI1D/dataAnalysis/inversion/Inversé/Point_48/calculs_tot.png

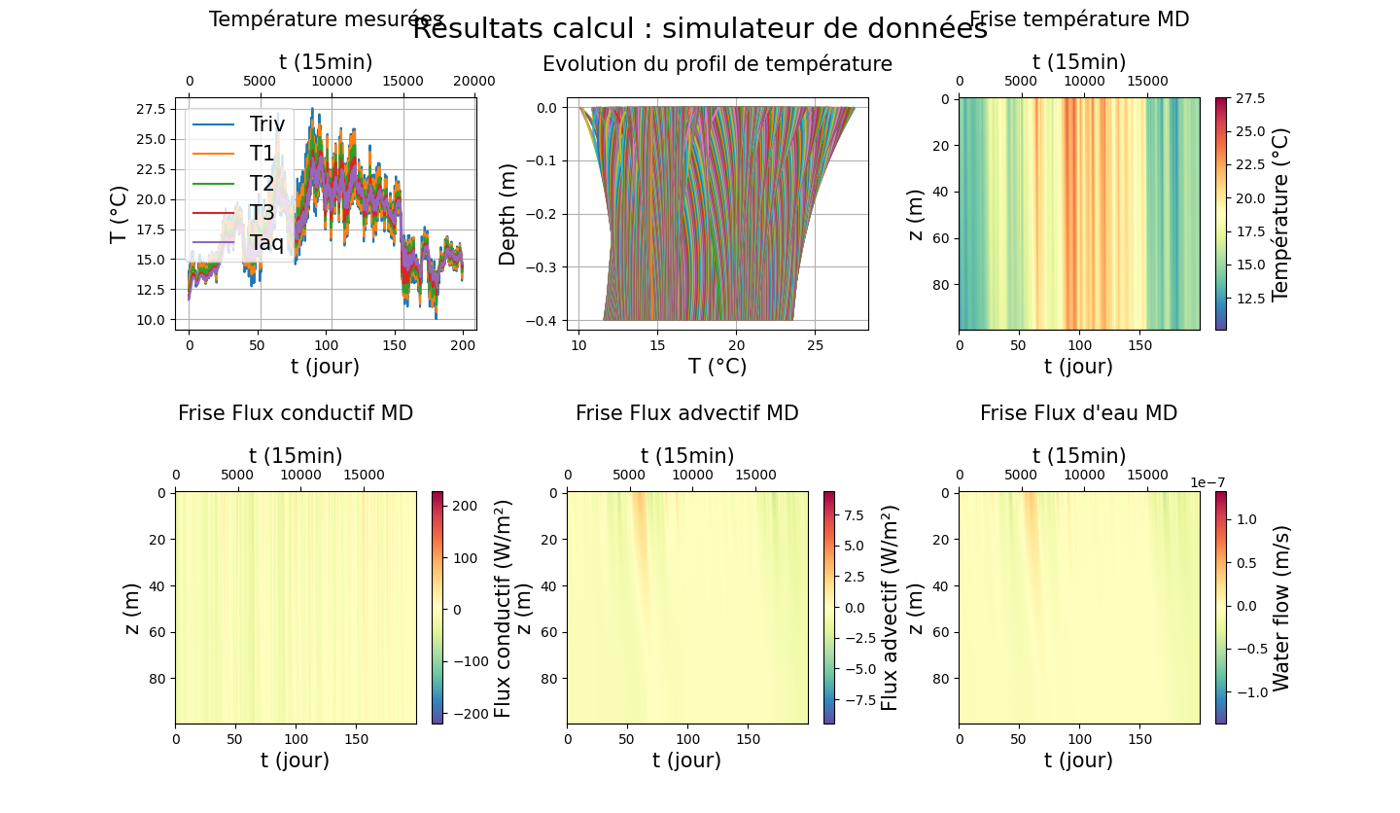
dataAnalysis/inversion/Inversé/Point_48/calculs_tot.png
