flipoyo/MOLONARI1D/dataAnalysis/inversion/Inversé/Point_48/debit_tot.png

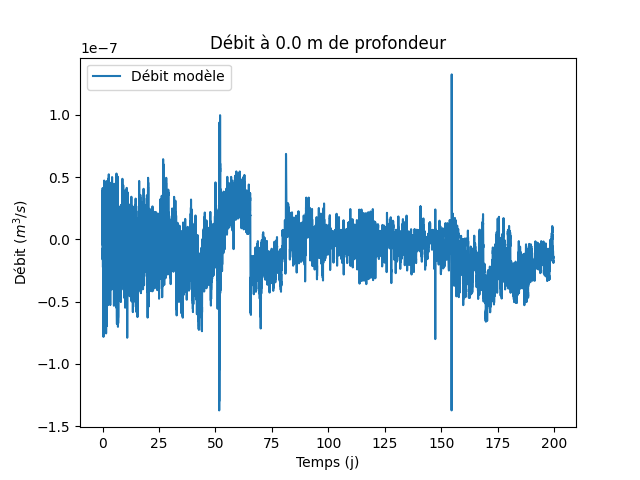
dataAnalysis/inversion/Inversé/Point_48/debit_tot.png
