flipoyo/MOLONARI1D/dataAnalysis/inversion/Inversé/Point_48/modele_tot.png

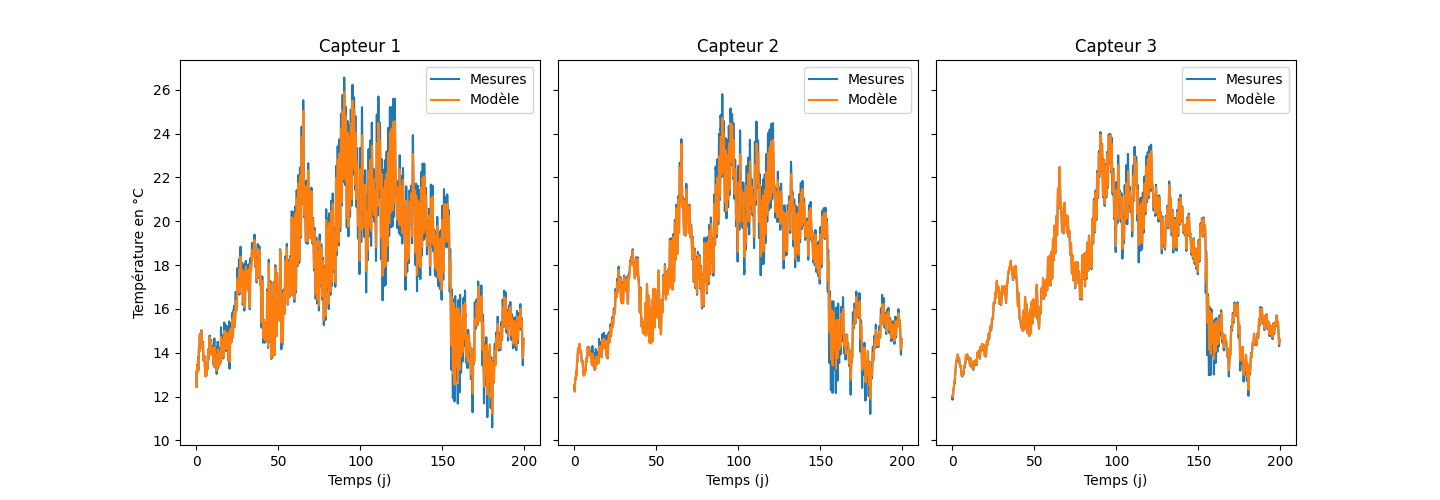
dataAnalysis/inversion/Inversé/Point_48/modele_tot.png
