flipoyo/MOLONARI1D/dataAnalysis/inversion/Inversé/Point_48/q_debit.png

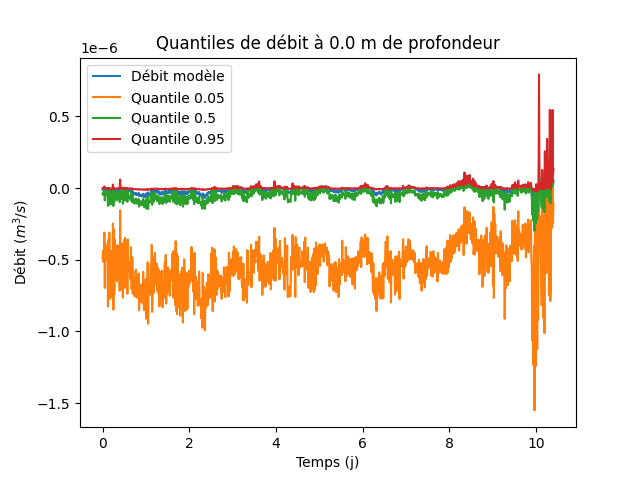
dataAnalysis/inversion/Inversé/Point_48/q_debit.png
