flipoyo/MOLONARI1D/dataAnalysis/inversion/Inversé/Point_48/quantiles_part.png

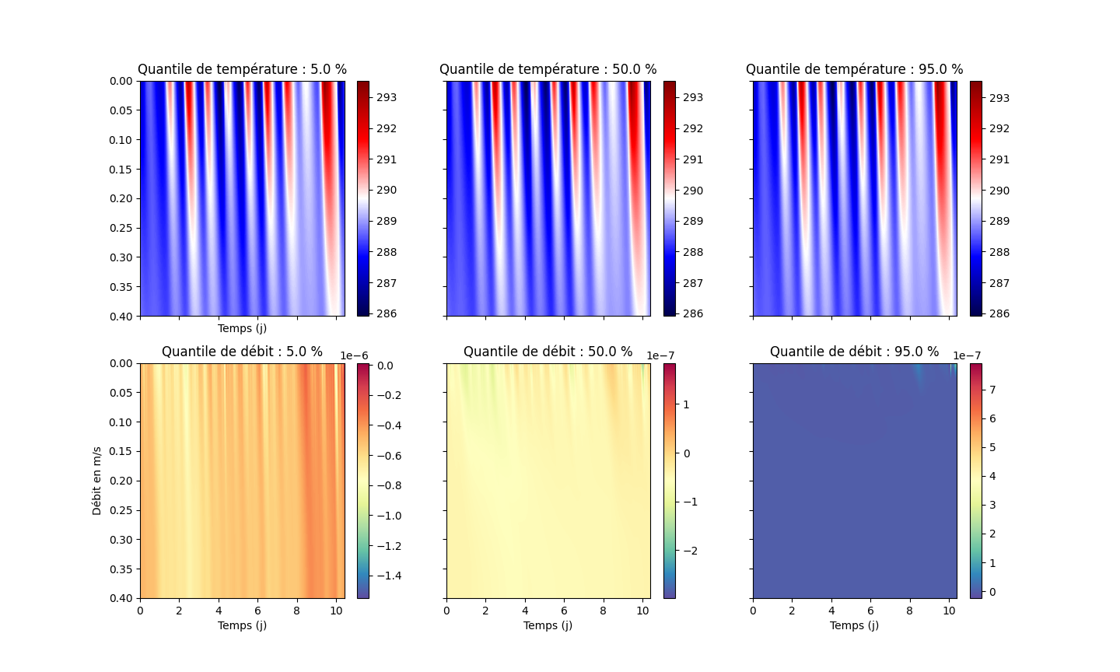
dataAnalysis/inversion/Inversé/Point_48/quantiles_part.png
