flipoyo/MOLONARI1D/dataAnalysis/inversion/Inversé/Point_48/temp_tot.png

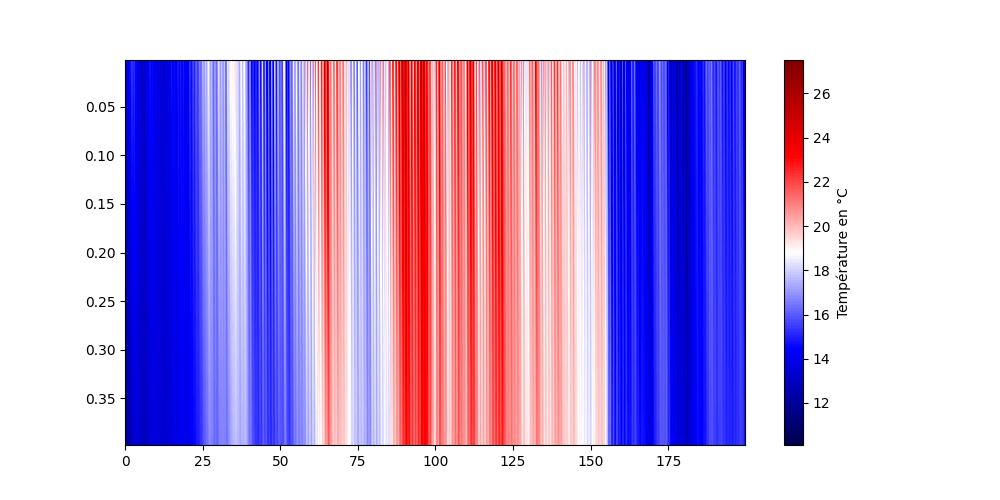
dataAnalysis/inversion/Inversé/Point_48/temp_tot.png
