flipoyo/MOLONARI1D/dataAnalysis/inversion/Inversé/Point_52/calculs2.png

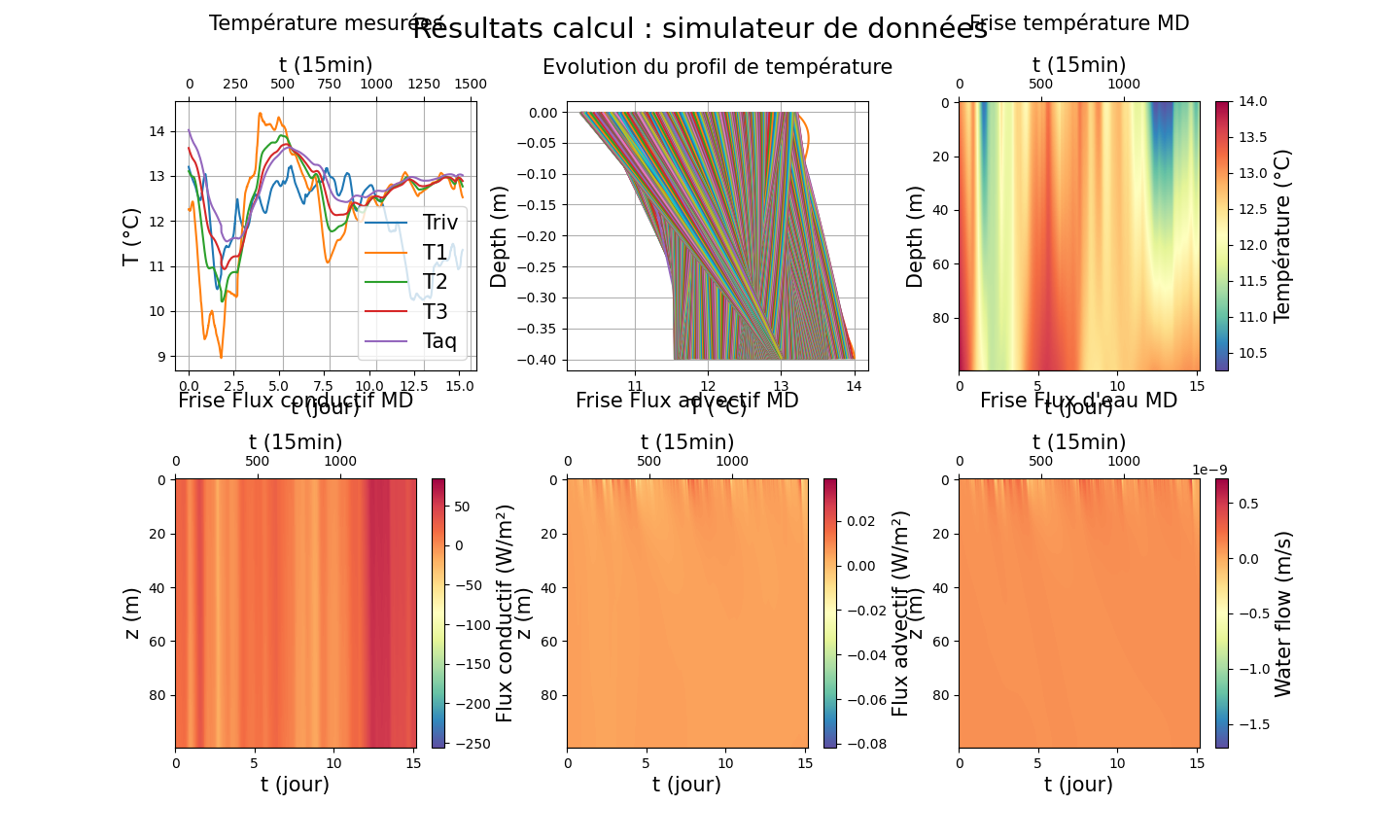
dataAnalysis/inversion/Inversé/Point_52/calculs2.png
