flipoyo/MOLONARI1D/dataAnalysis/inversion/Inversé/Point_52/distrib2.png

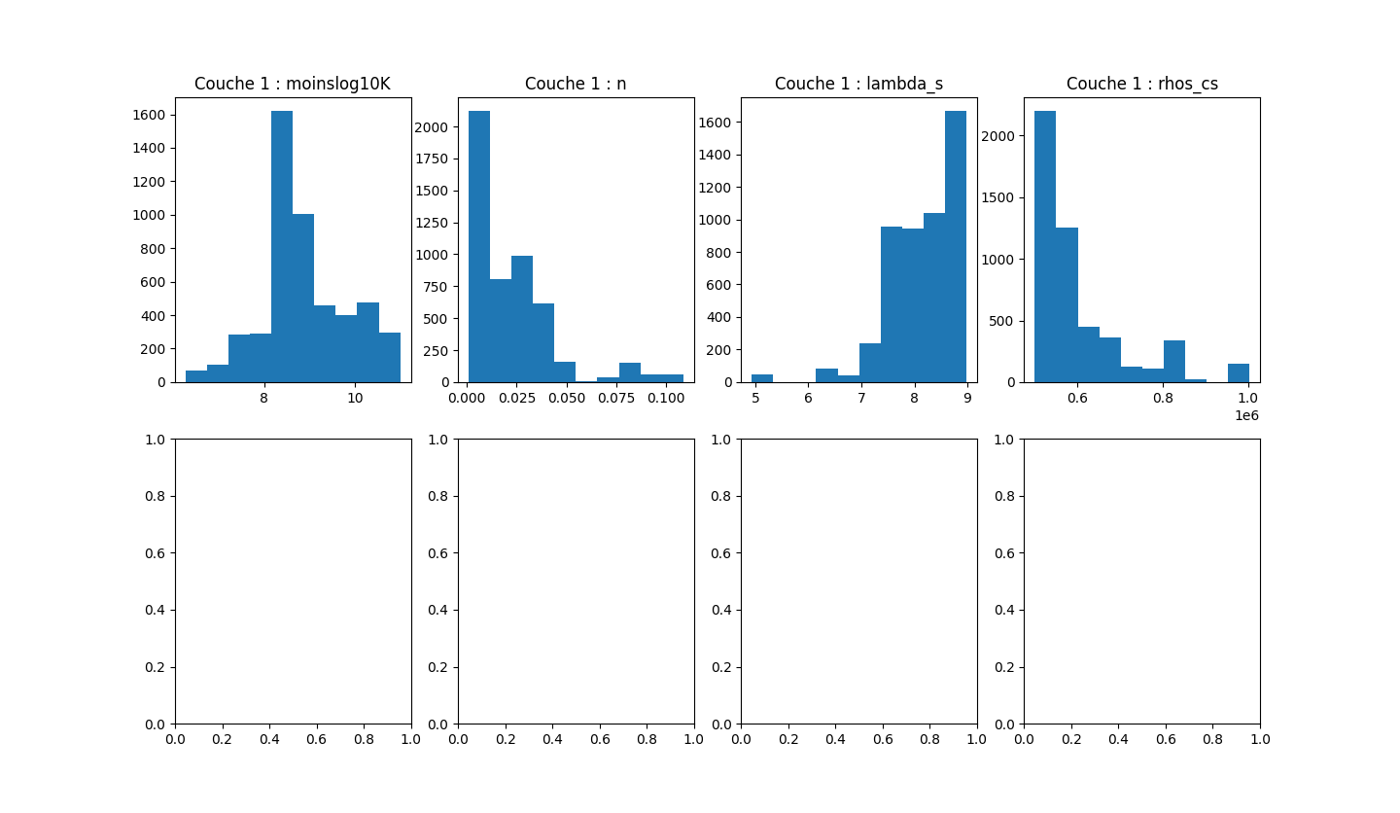
dataAnalysis/inversion/Inversé/Point_52/distrib2.png
