flipoyo/MOLONARI1D/dataAnalysis/inversion/Inversé/Point_52/modele2.png

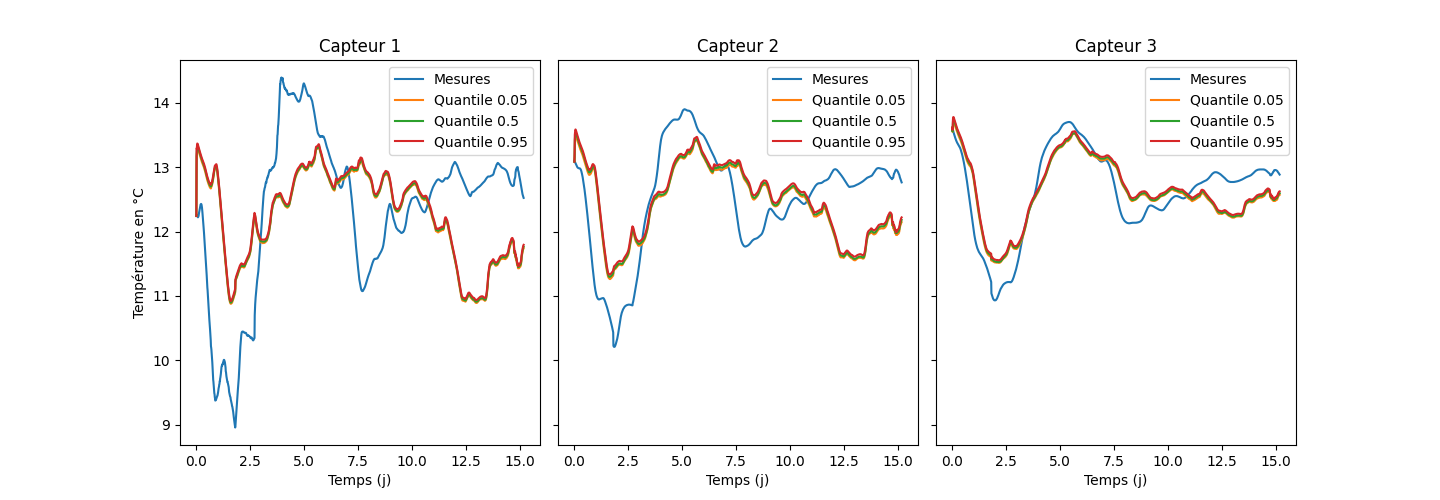
dataAnalysis/inversion/Inversé/Point_52/modele2.png
