flipoyo/MOLONARI1D/dataAnalysis/inversion/Inversé/Point_52/q_debit2.png

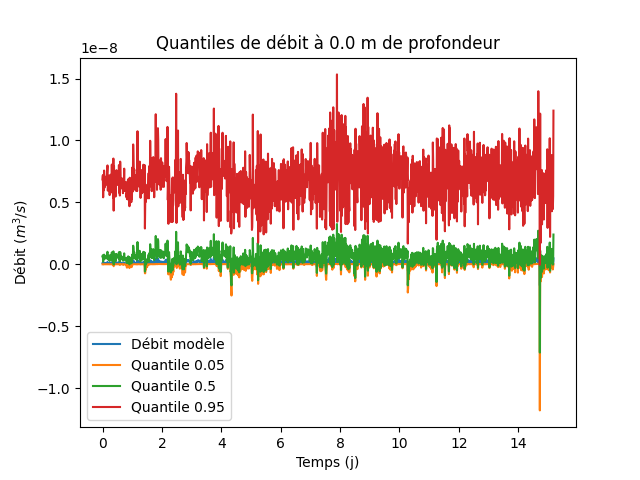
dataAnalysis/inversion/Inversé/Point_52/q_debit2.png
