flipoyo/MOLONARI1D/dataAnalysis/inversion/Inversé/Point_52/quantiles2.png

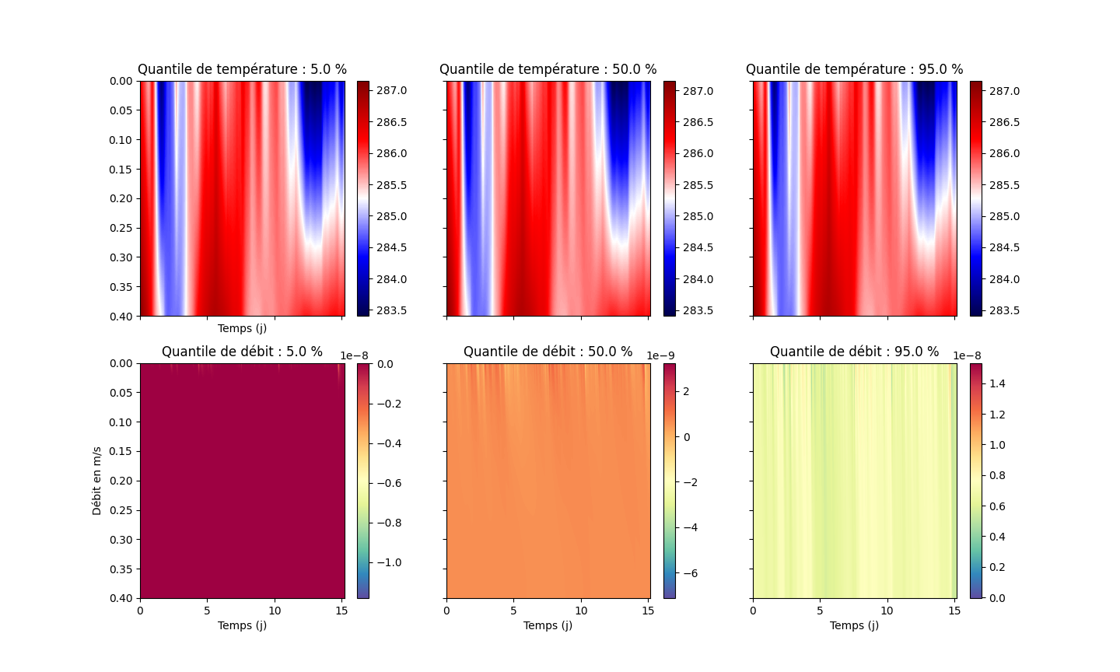
dataAnalysis/inversion/Inversé/Point_52/quantiles2.png
