flipoyo/MOLONARI1D/dataAnalysis/inversion/Inversé/Point_53/calcul2.png

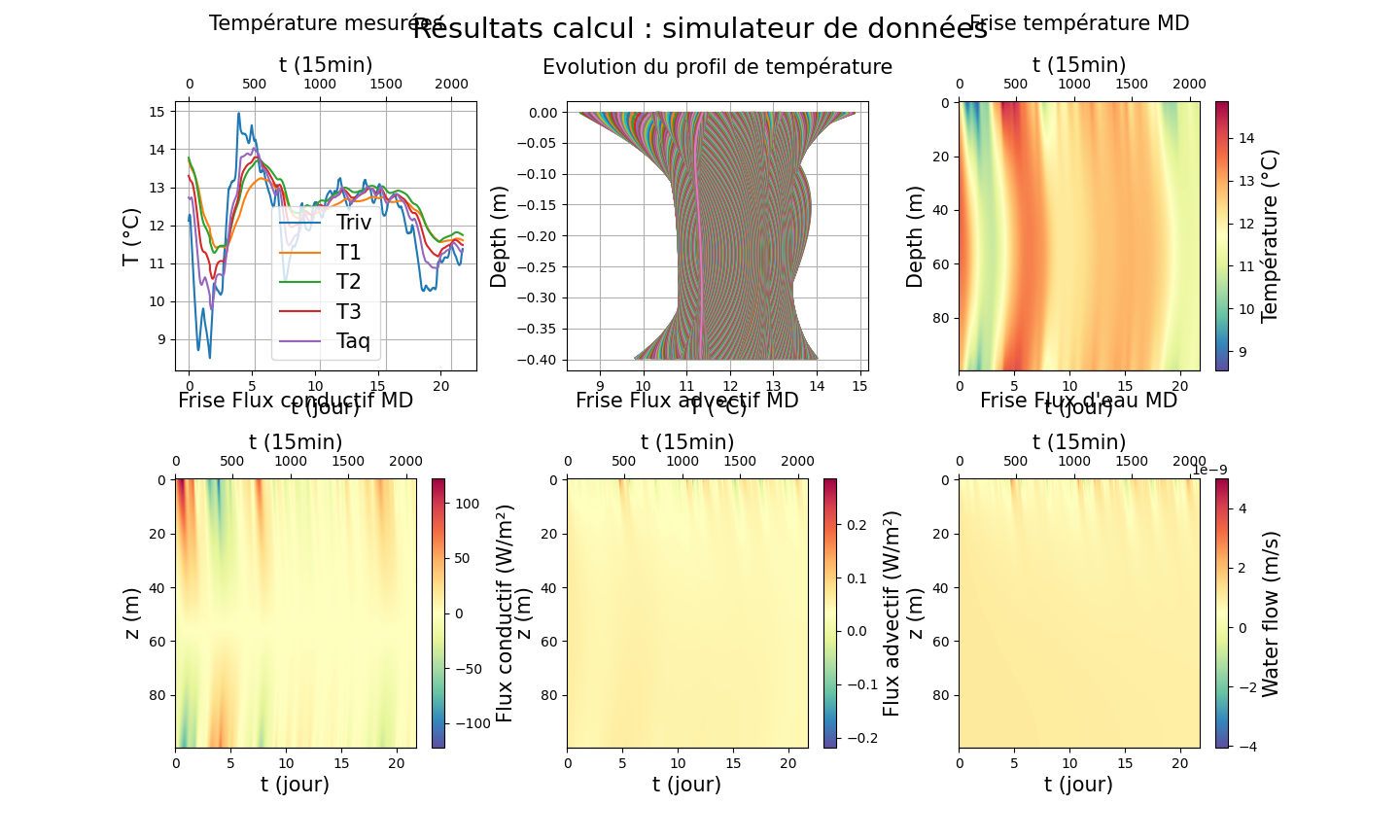
dataAnalysis/inversion/Inversé/Point_53/calcul2.png
