flipoyo/MOLONARI1D/dataAnalysis/inversion/Inversé/Point_53/calculs.png

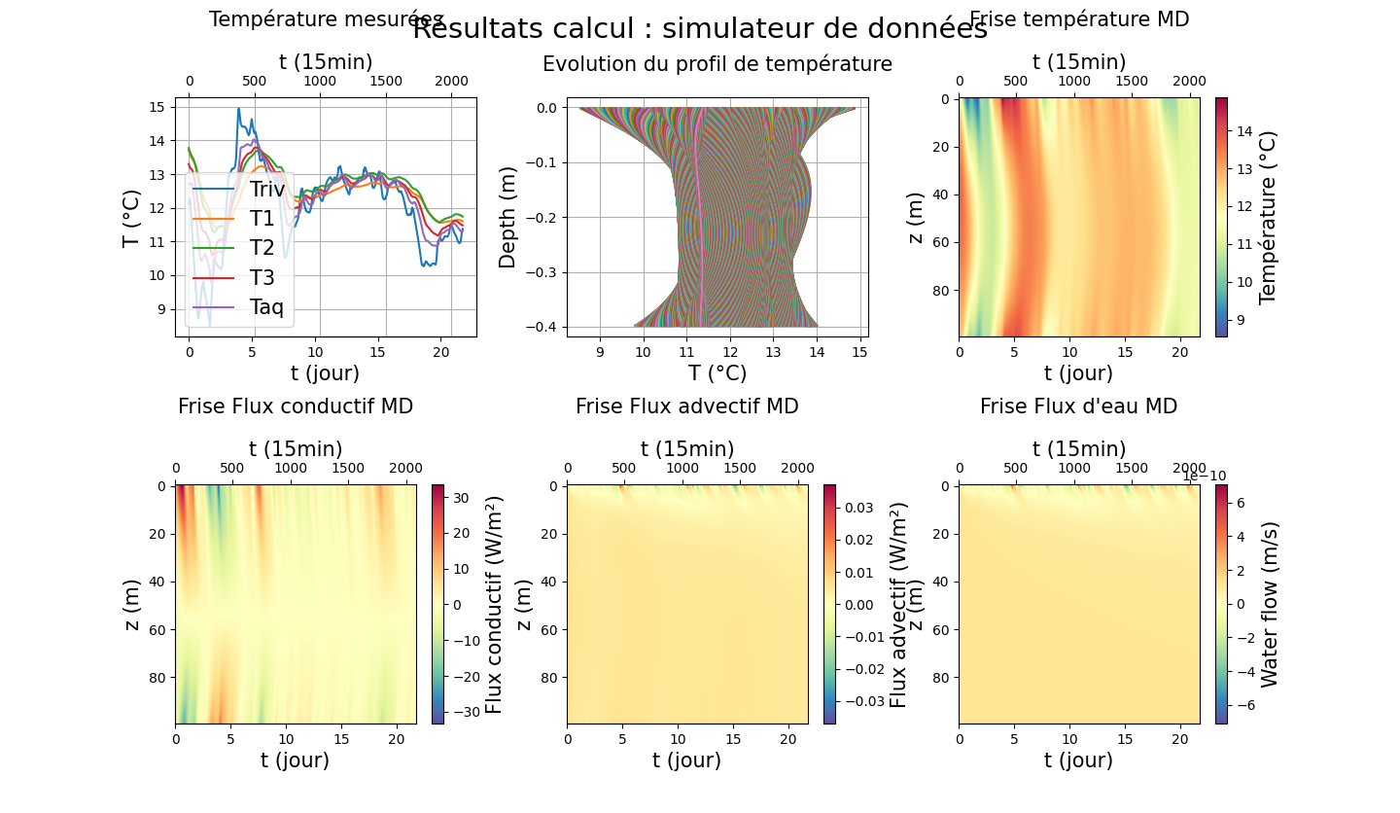
dataAnalysis/inversion/Inversé/Point_53/calculs.png
