flipoyo/MOLONARI1D/dataAnalysis/inversion/Inversé/Point_53/distrib2.png

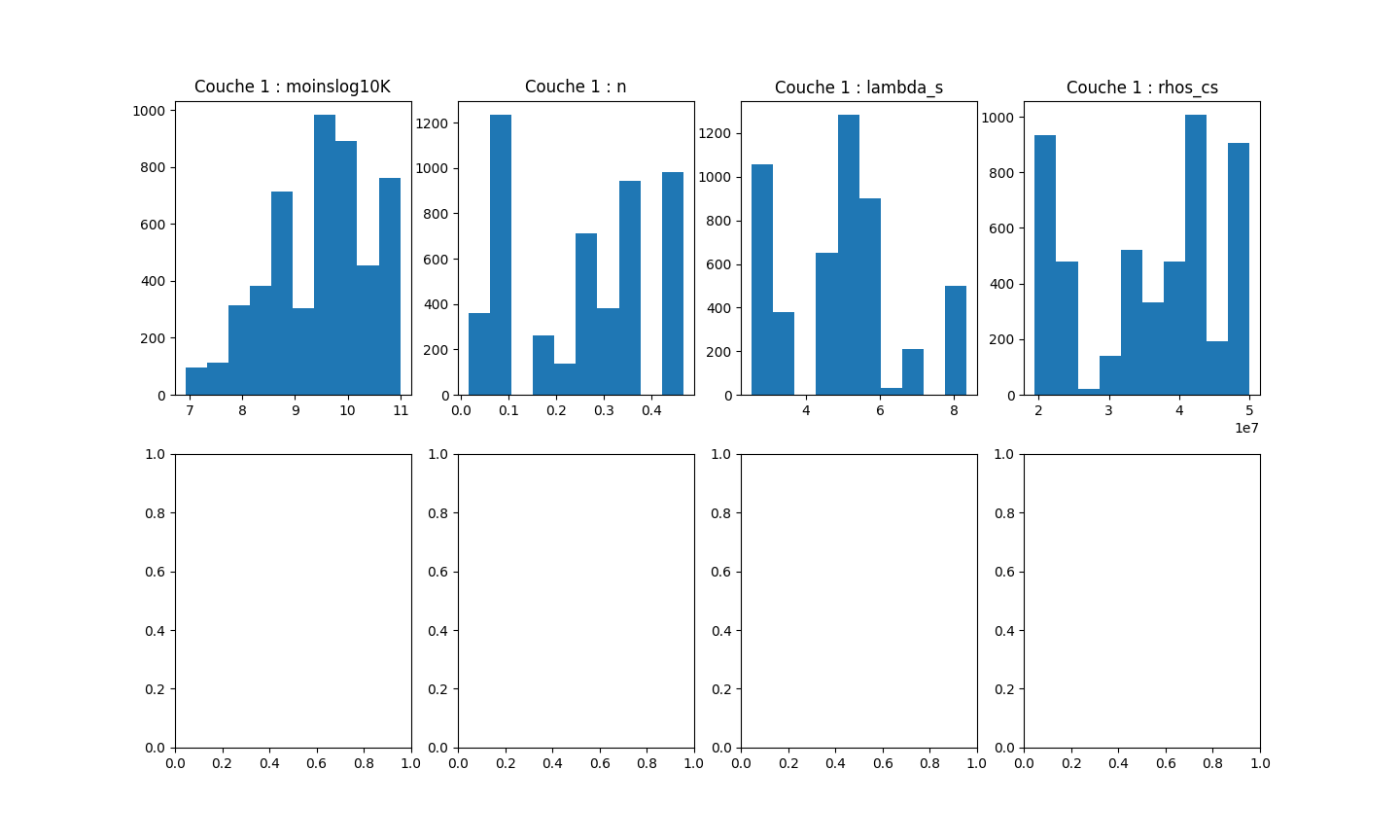
dataAnalysis/inversion/Inversé/Point_53/distrib2.png
