flipoyo/MOLONARI1D/dataAnalysis/inversion/Inversé/Point_53/modele2.png

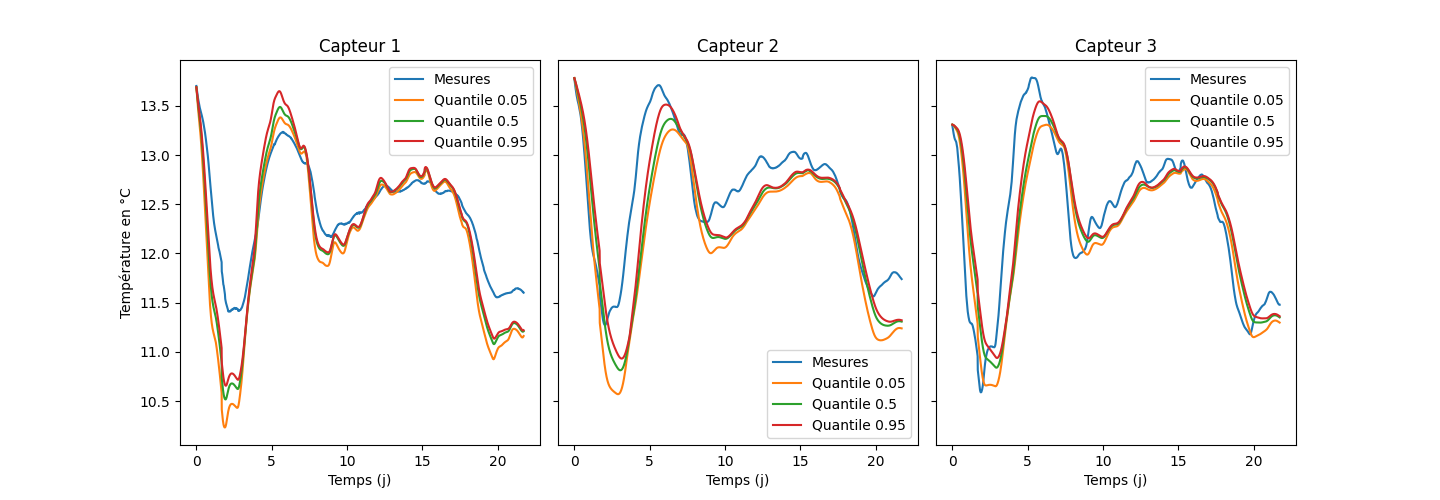
dataAnalysis/inversion/Inversé/Point_53/modele2.png
