flipoyo/MOLONARI1D/dataAnalysis/inversion/Inversé/Point_53/modele.png

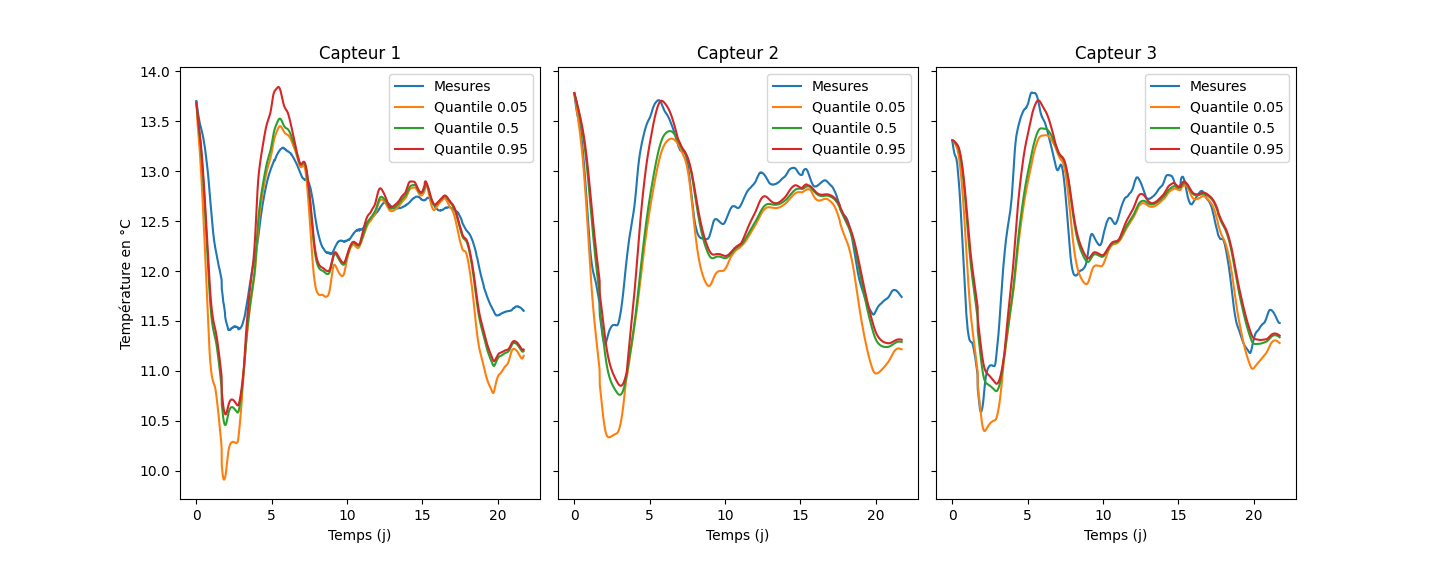
dataAnalysis/inversion/Inversé/Point_53/modele.png
