flipoyo/MOLONARI1D/dataAnalysis/inversion/Inversé/Point_53/q_débit2.png

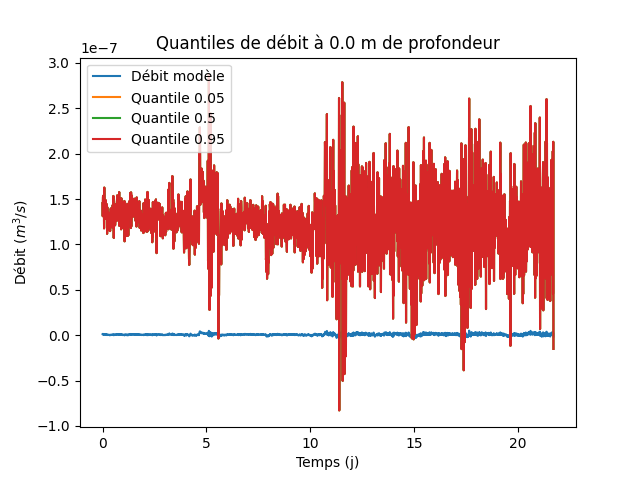
dataAnalysis/inversion/Inversé/Point_53/q_débit2.png
