flipoyo/MOLONARI1D/dataAnalysis/inversion/Inversé/Point_53/q_débit.png

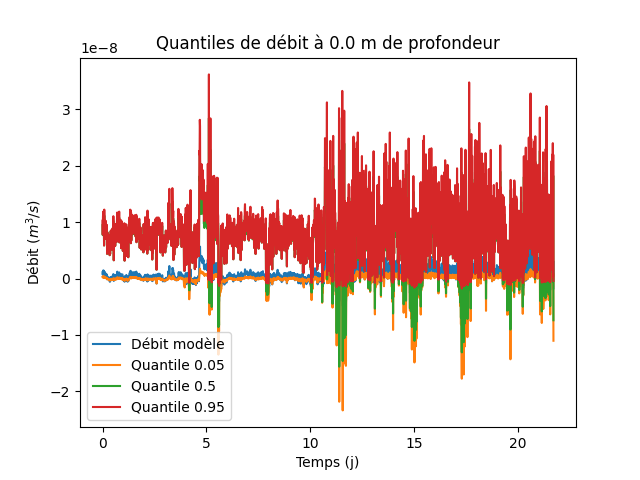
dataAnalysis/inversion/Inversé/Point_53/q_débit.png
