flipoyo/MOLONARI1D/dataAnalysis/inversion/Inversé/Point_53/quantiles2.png

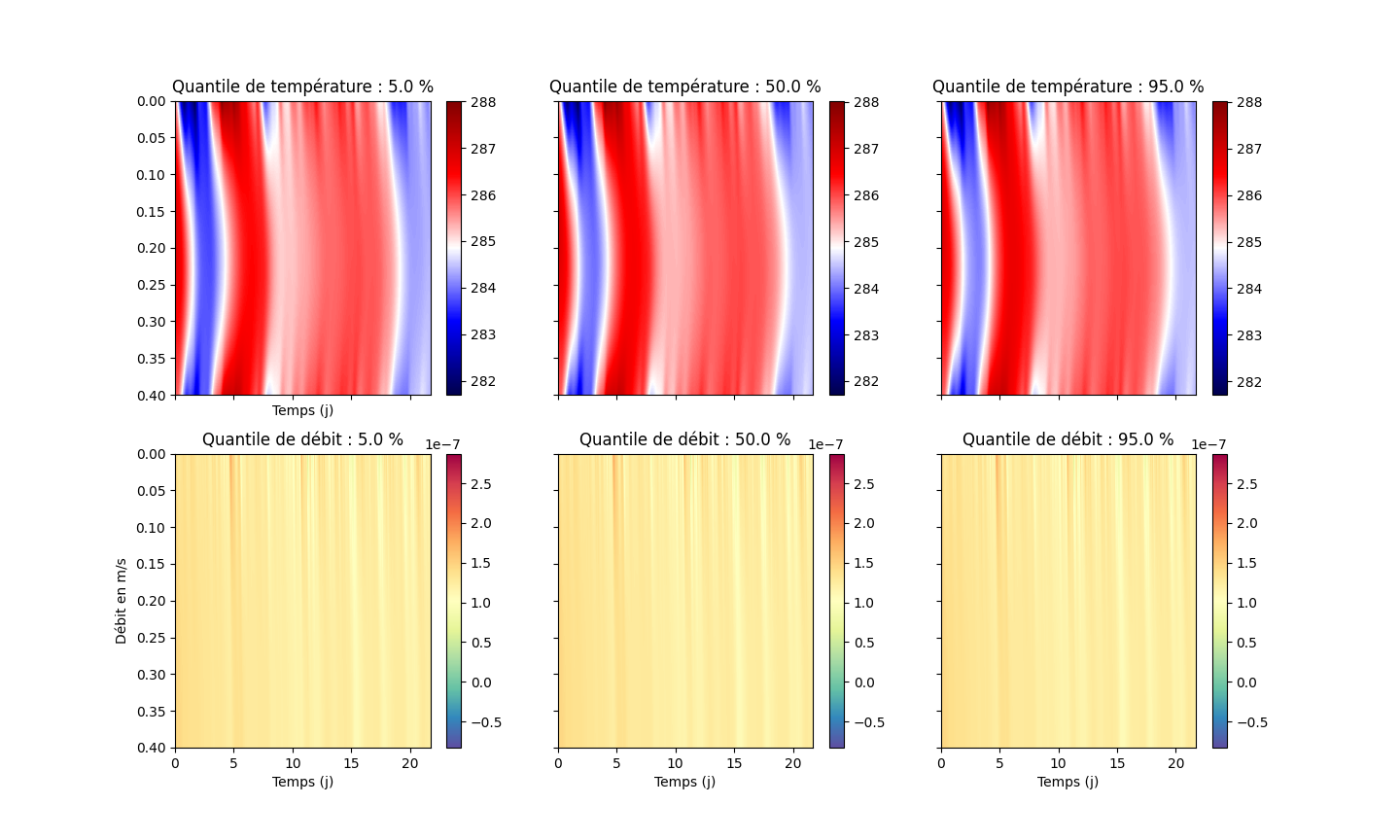
dataAnalysis/inversion/Inversé/Point_53/quantiles2.png
