flipoyo/MOLONARI1D/dataAnalysis/inversion/Inversé/Point_53/quantiles.png

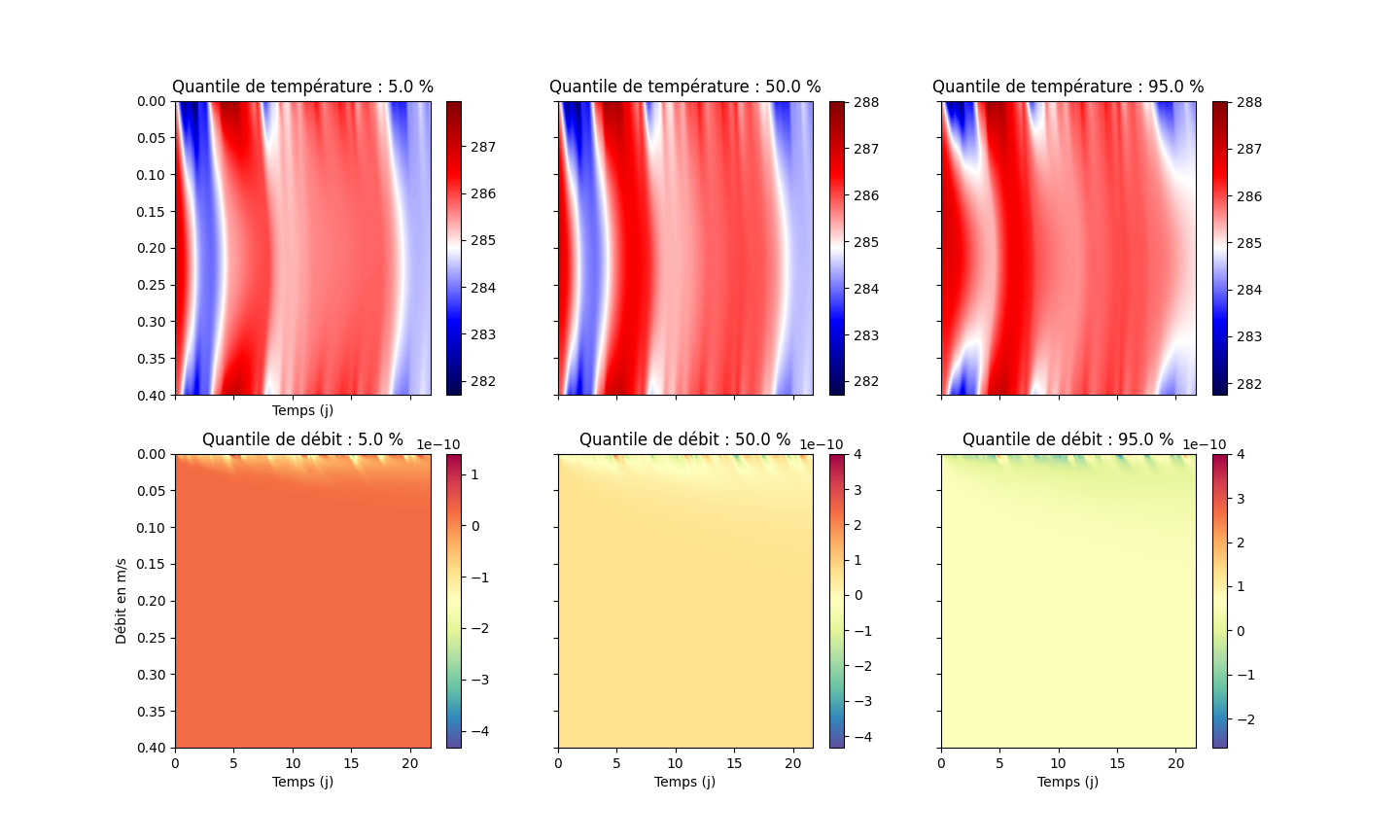
dataAnalysis/inversion/Inversé/Point_53/quantiles.png
