flipoyo/MOLONARI1D/dataAnalysis/map/dates.png

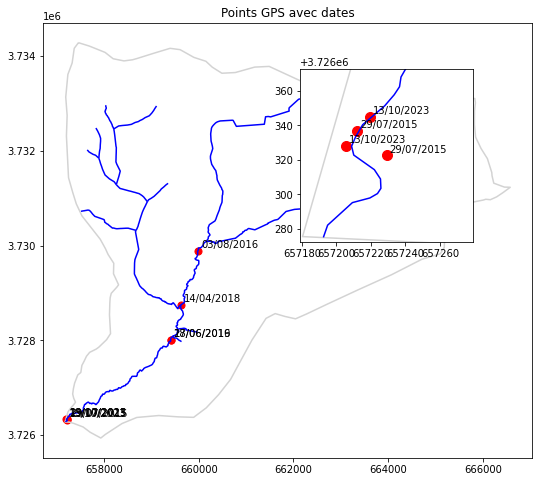
dataAnalysis/map/dates.png
