flipoyo/MOLONARI1D/dataAnalysis/map/K.png

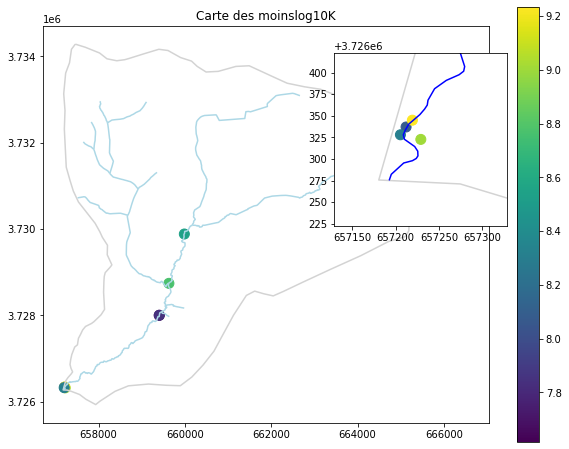
dataAnalysis/map/K.png
