flipoyo/MOLONARI1D/dataAnalysis/map/lambda.png

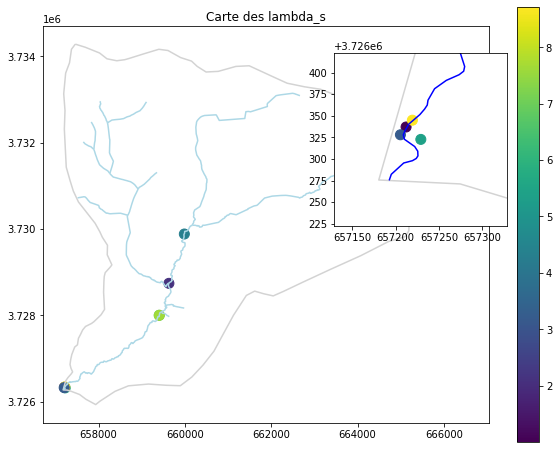
dataAnalysis/map/lambda.png
