flipoyo/MOLONARI1D/dataAnalysis/map/n.png

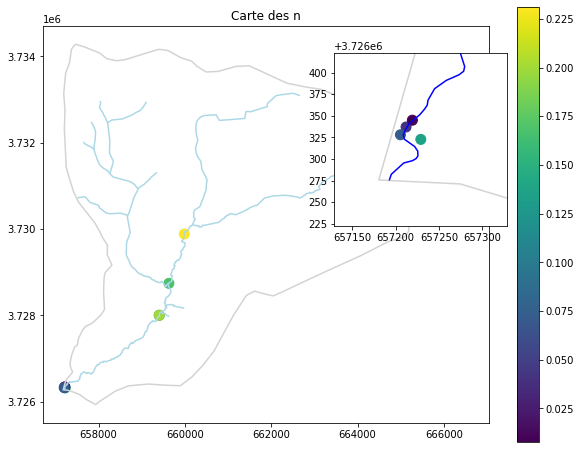
dataAnalysis/map/n.png
