flipoyo/MOLONARI1D/dataAnalysis/map/regime.png

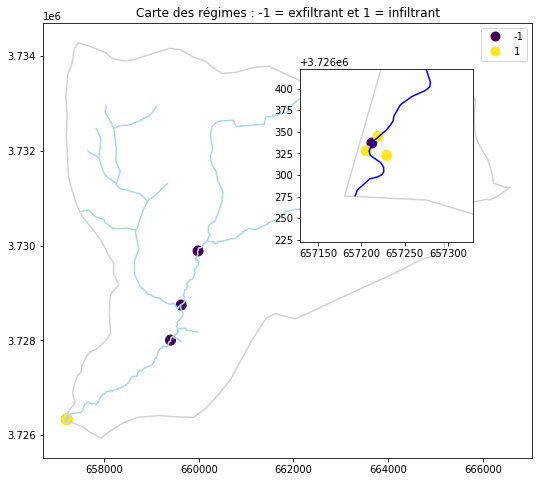
dataAnalysis/map/regime.png
