flipoyo/MOLONARI1D/dataAnalysis/raw_data/point13_29_07_15/point13_schema.png

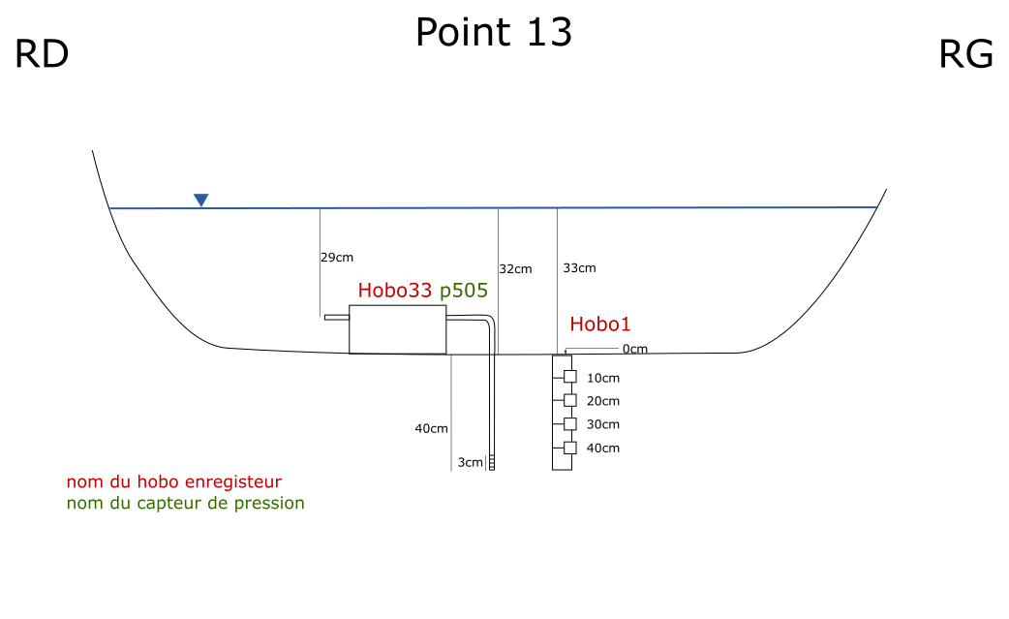
dataAnalysis/raw_data/point13_29_07_15/point13_schema.png
