flipoyo/MOLONARI1D/dataAnalysis/raw_data/point14_29_07_15/point14_coupe.png

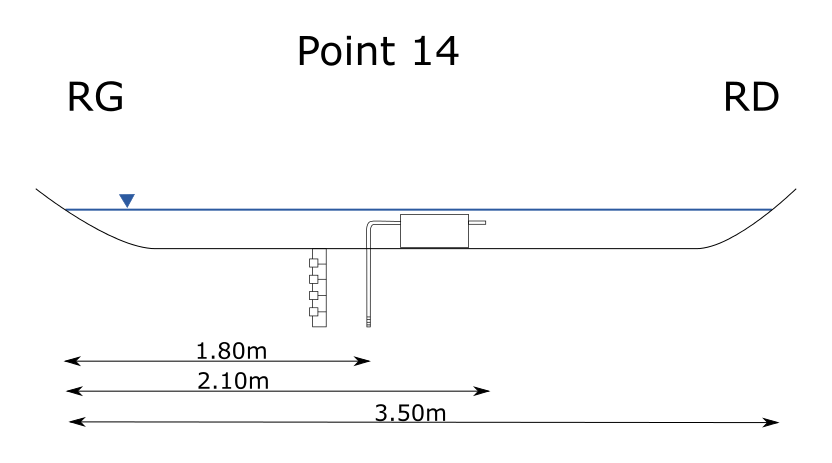
dataAnalysis/raw_data/point14_29_07_15/point14_coupe.png
