flipoyo/MOLONARI1D/dataAnalysis/raw_data/point36_12_07_16/point36_schema.png

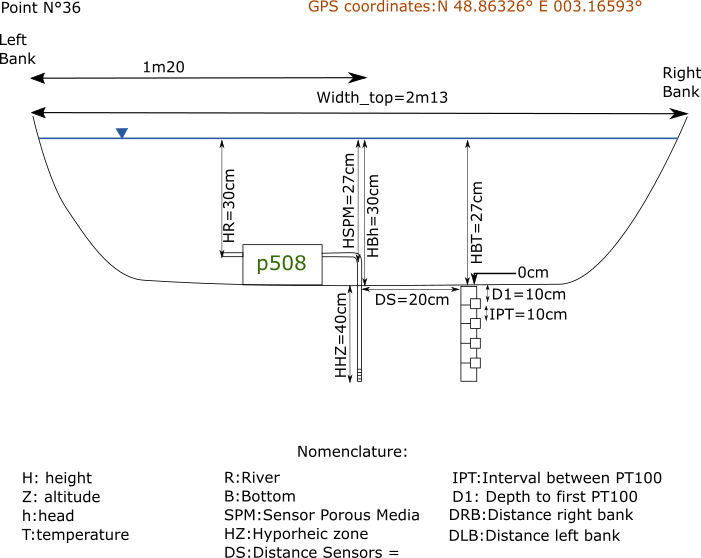
dataAnalysis/raw_data/point36_12_07_16/point36_schema.png
