flipoyo/MOLONARI1D/dataAnalysis/raw_data/point46_17_06_19/point46_schema.png

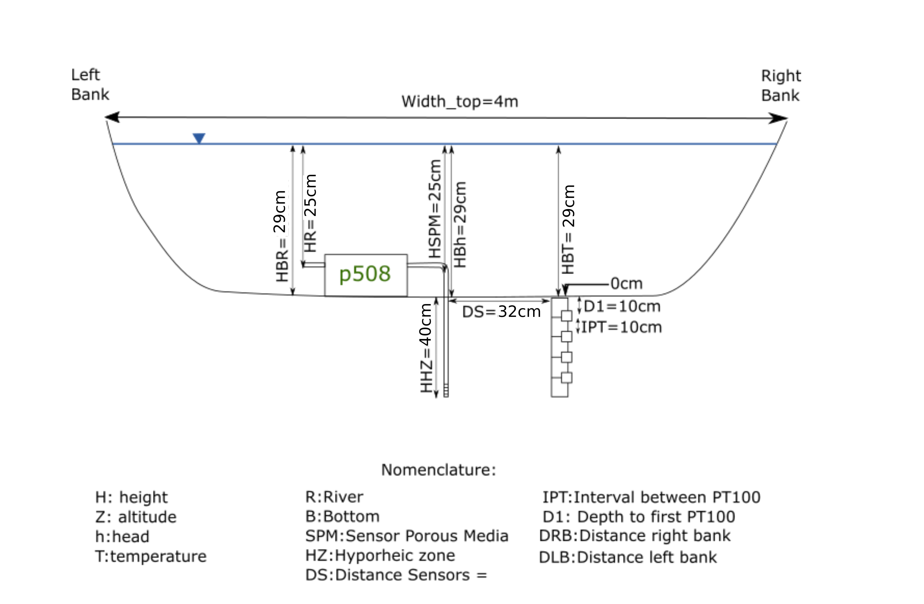
dataAnalysis/raw_data/point46_17_06_19/point46_schema.png
