flipoyo/MOLONARI1D/dataAnalysis/raw_data/point48_14_04_18/point46_schema.png

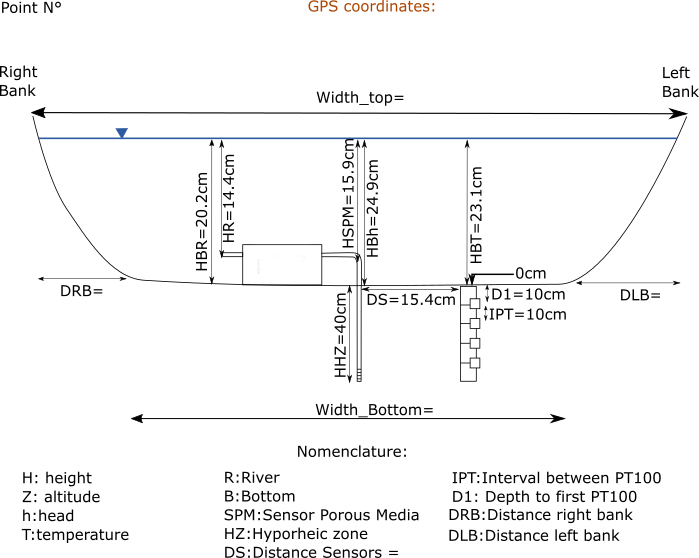
dataAnalysis/raw_data/point48_14_04_18/point46_schema.png
