flipoyo/MOLONARI1D/dataAnalysis/raw_data/schema_dispositif_AvAv_23_07_15.png

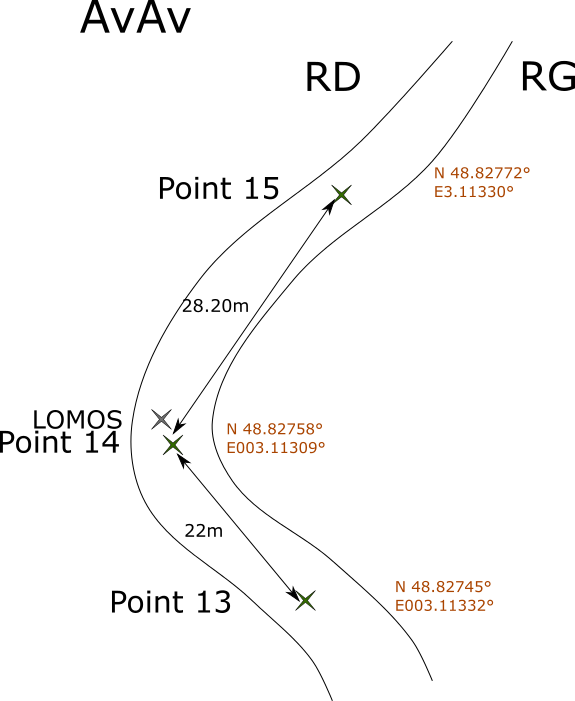
dataAnalysis/raw_data/schema_dispositif_AvAv_23_07_15.png
