flipoyo/MOLONARI1D/Device/hardwareProgramming/Documentation 2023/Images/depha.png

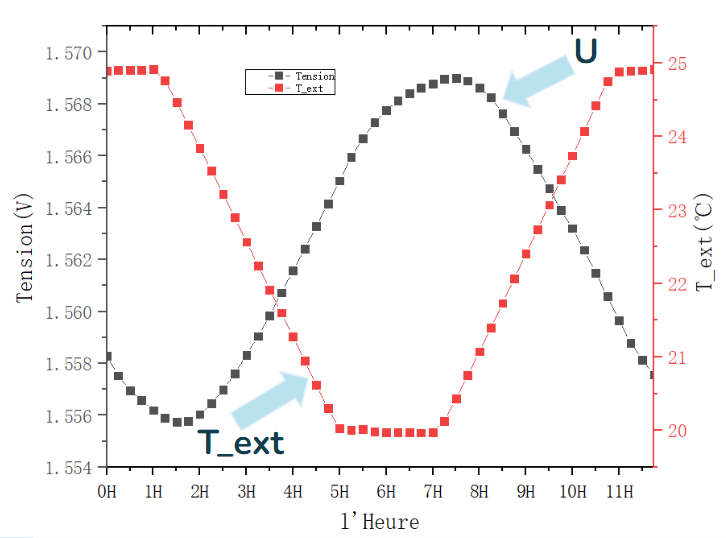
Device/hardwareProgramming/Documentation 2023/Images/depha.png
