flipoyo/MOLONARI1D/Device/hardwareProgramming/Documentation 2023/Images/inver.png

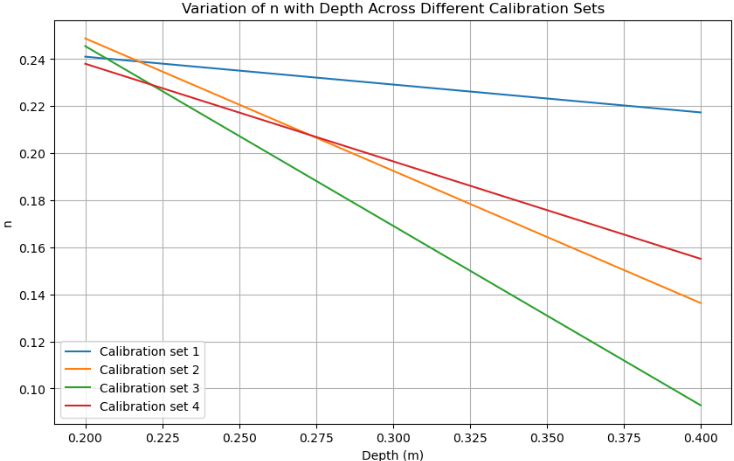
Device/hardwareProgramming/Documentation 2023/Images/inver.png
