flipoyo/MOLONARI1D/Device/hardwareProgramming/Documentation 2023/Images/pressure.png

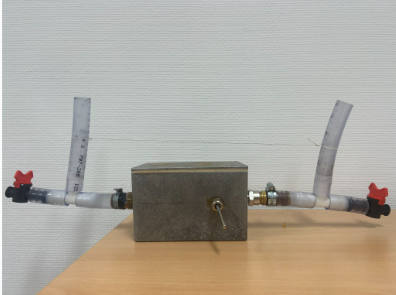
Device/hardwareProgramming/Documentation 2023/Images/pressure.png
