flipoyo/MOLONARI1D/Device/hardwareProgramming/Documentation 2023/Images/PUformule.png

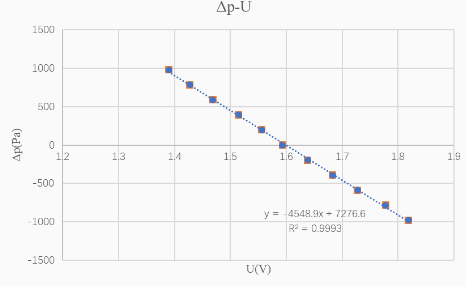
Device/hardwareProgramming/Documentation 2023/Images/PUformule.png
