flipoyo/MOLONARI1D/hardware/docs/Images/json_data.png

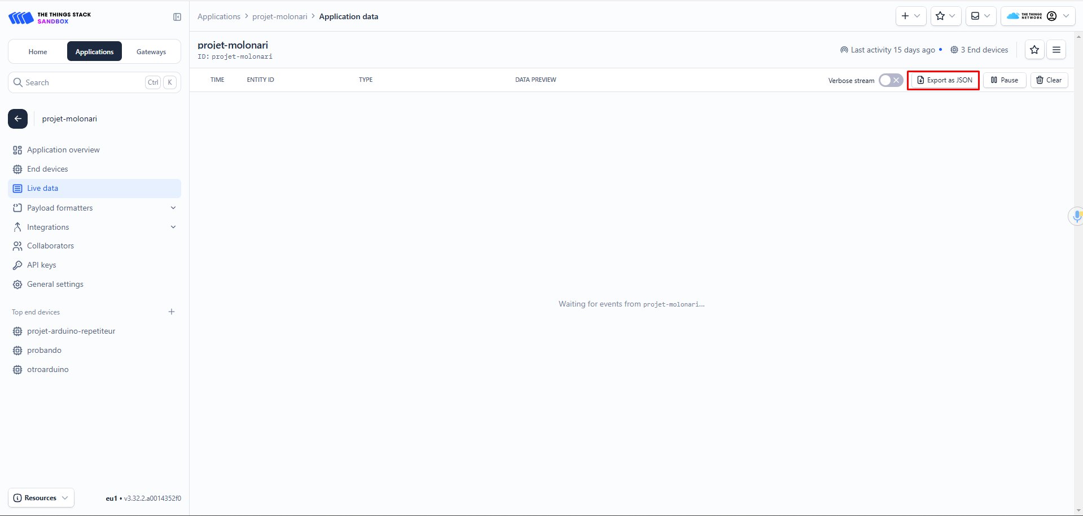
hardware/docs/Images/json_data.png
