flipoyo/MOLONARI1D/hardware/docs/Images/parameters.png

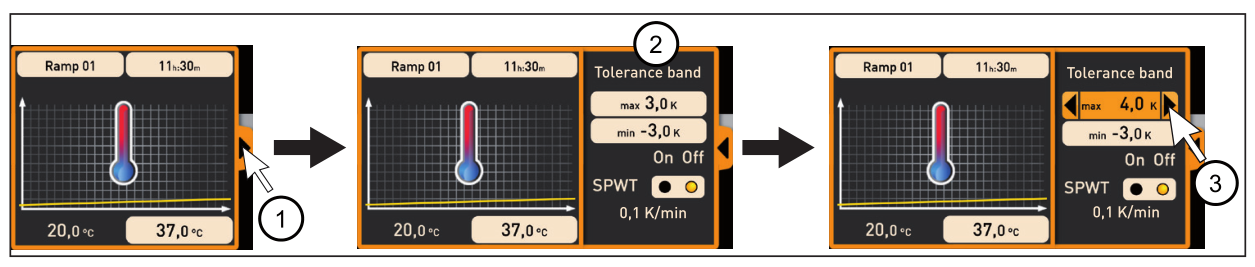
hardware/docs/Images/parameters.png
