flipoyo/MOLONARI1D/hardware/specs/v1-until-2024/differentialPressureSensor/dimensionSacrificialTip.JPG

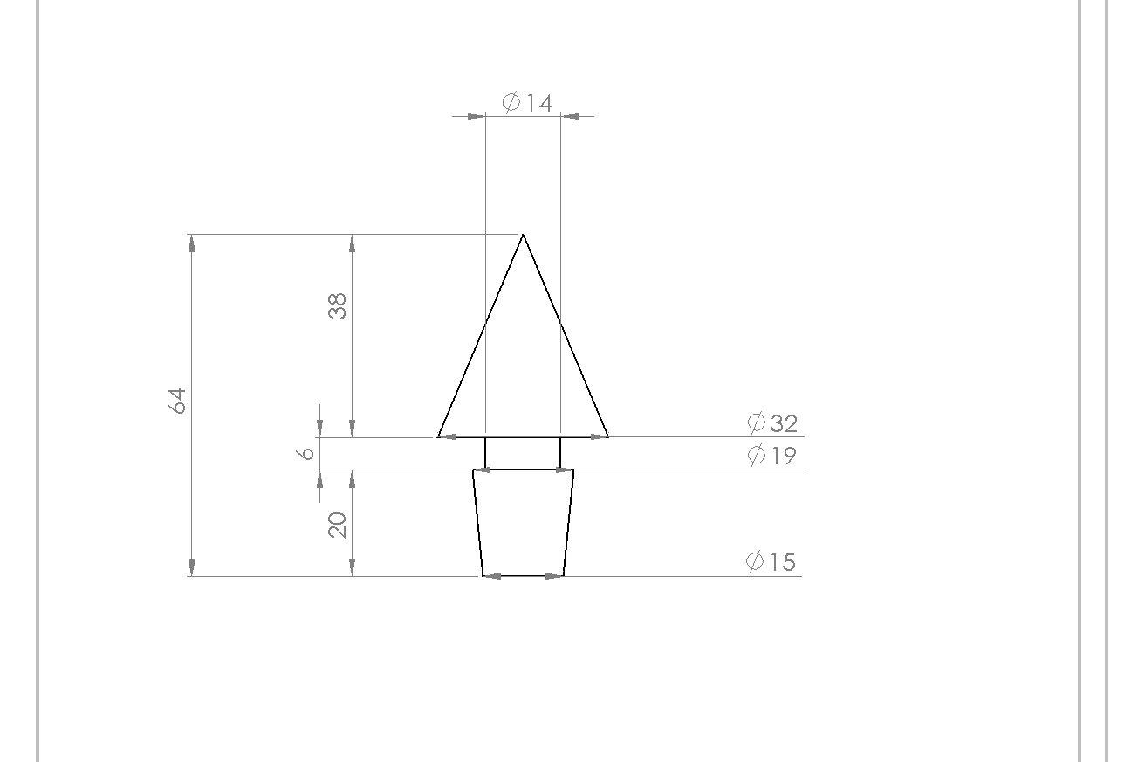
hardware/specs/v1-until-2024/differentialPressureSensor/dimensionSacrificialTip.JPG
