flipoyo/MOLONARI1D/hardware/specs/v2-2025/gateway/Images/chirpstack_gateways.png

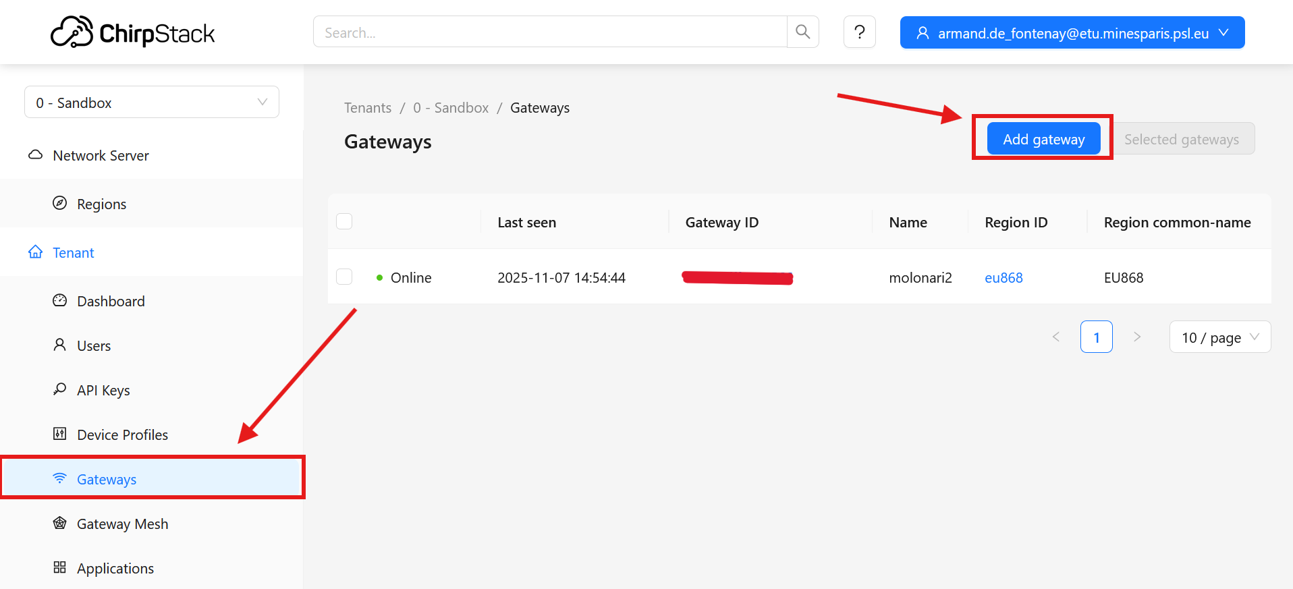
hardware/specs/v2-2025/gateway/Images/chirpstack_gateways.png
