flipoyo/MOLONARI1D/hardware/specs/v2-2025/gateway/Images/chirpstack_generate_certificates1.png

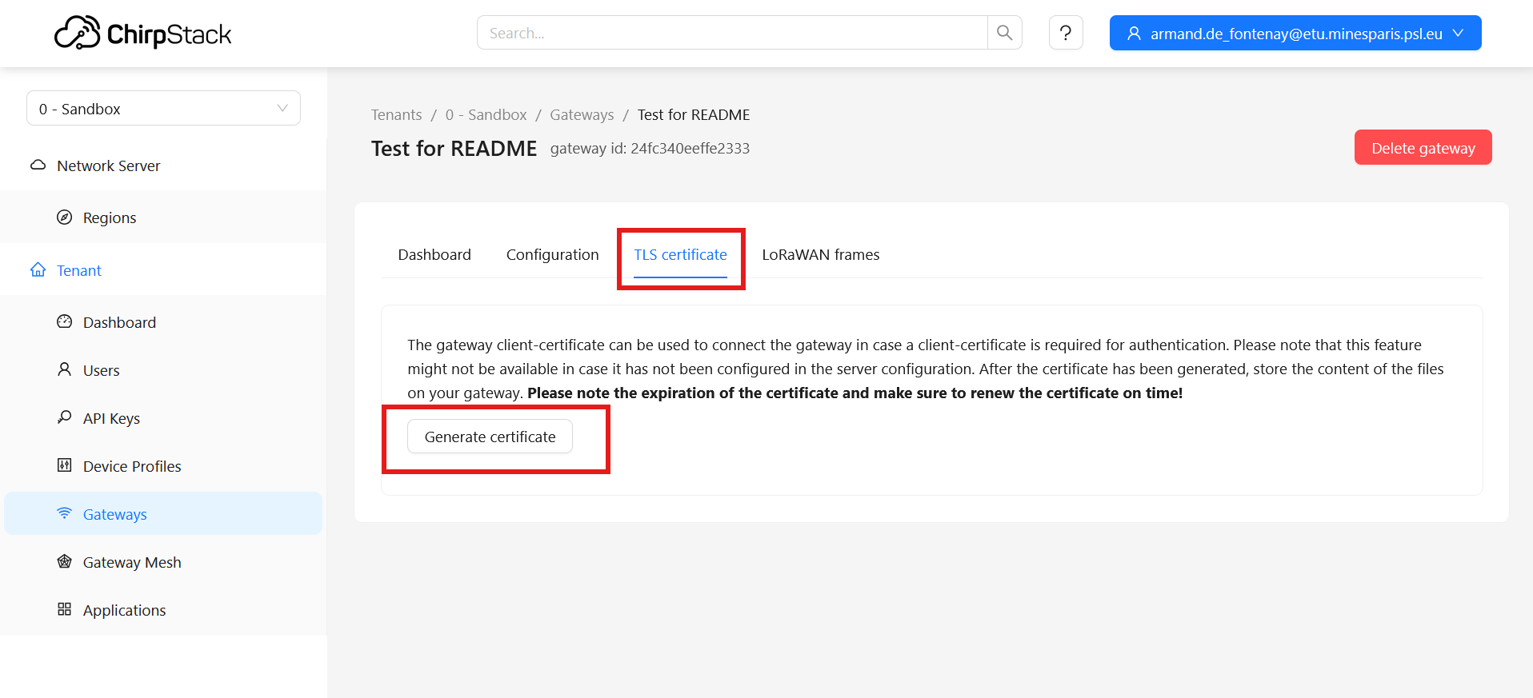
hardware/specs/v2-2025/gateway/Images/chirpstack_generate_certificates1.png
