flipoyo/MOLONARI1D/hardware/specs/v2-2025/gateway/Images/chirpstack_login.png

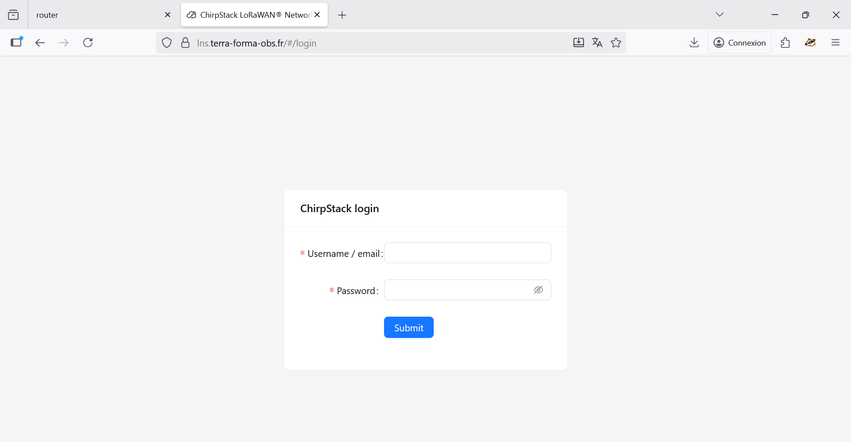
hardware/specs/v2-2025/gateway/Images/chirpstack_login.png
