flipoyo/MOLONARI1D/hardware/specs/v2-2025/gateway/Images/chirpstack_seeing_messages.png

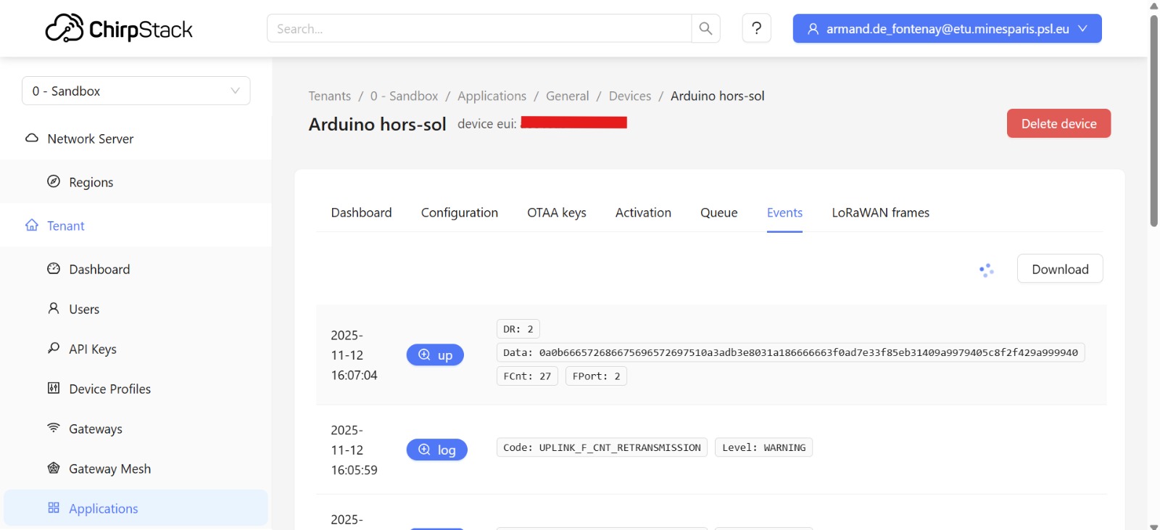
hardware/specs/v2-2025/gateway/Images/chirpstack_seeing_messages.png
