flipoyo/MOLONARI1D/hardware/specs/v2-2025/gateway/Images/chirpstack_sensor_appkey.png

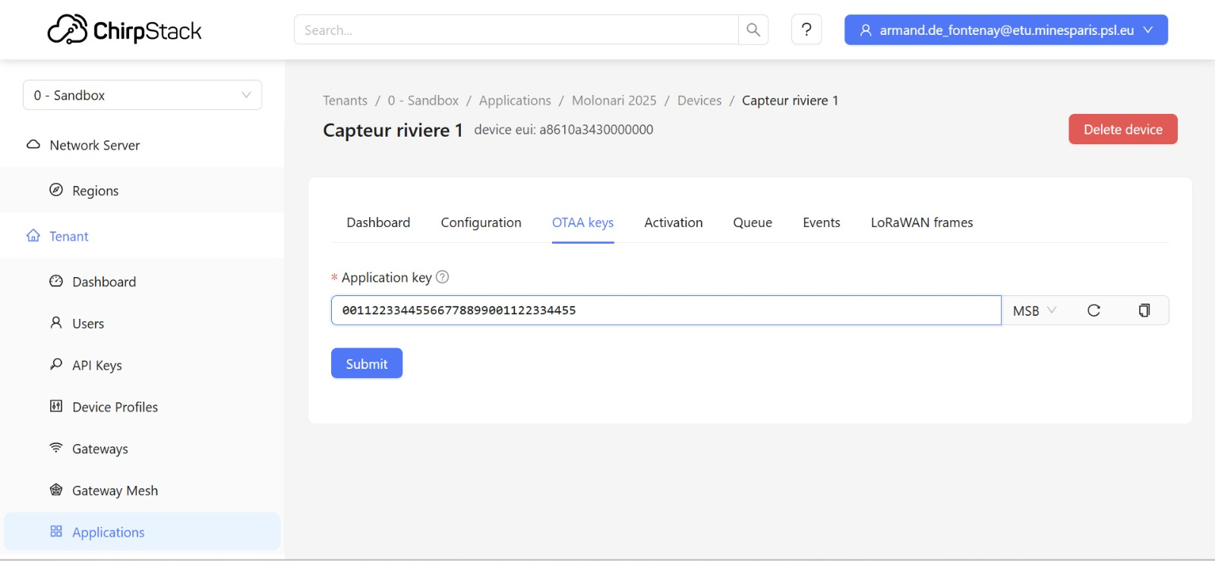
hardware/specs/v2-2025/gateway/Images/chirpstack_sensor_appkey.png
