flipoyo/MOLONARI1D/hardware/specs/v2-2025/gateway/Images/obtain_gateway_id.png

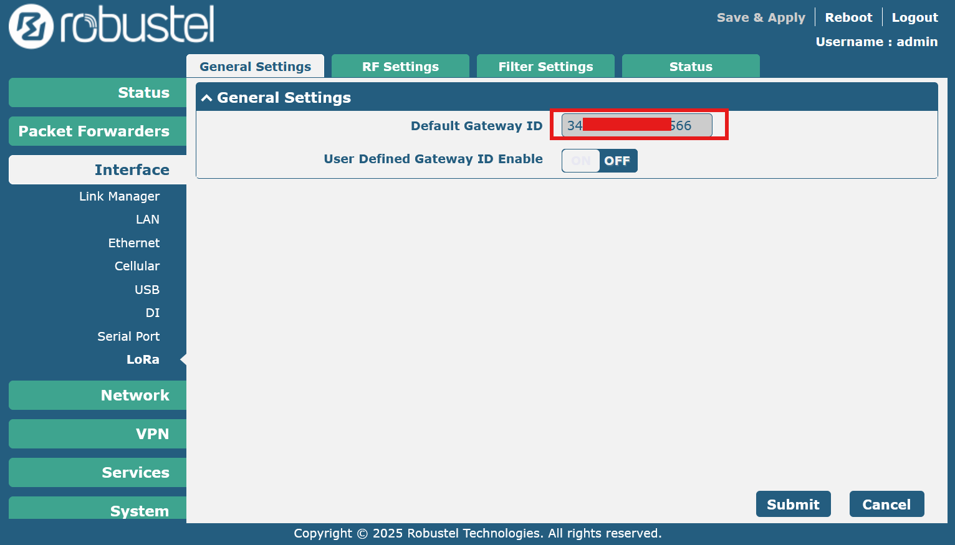
hardware/specs/v2-2025/gateway/Images/obtain_gateway_id.png
