flipoyo/MOLONARI1D/hardware/specs/v2-2025/gateway/Images/robustel_adding_certificates.png

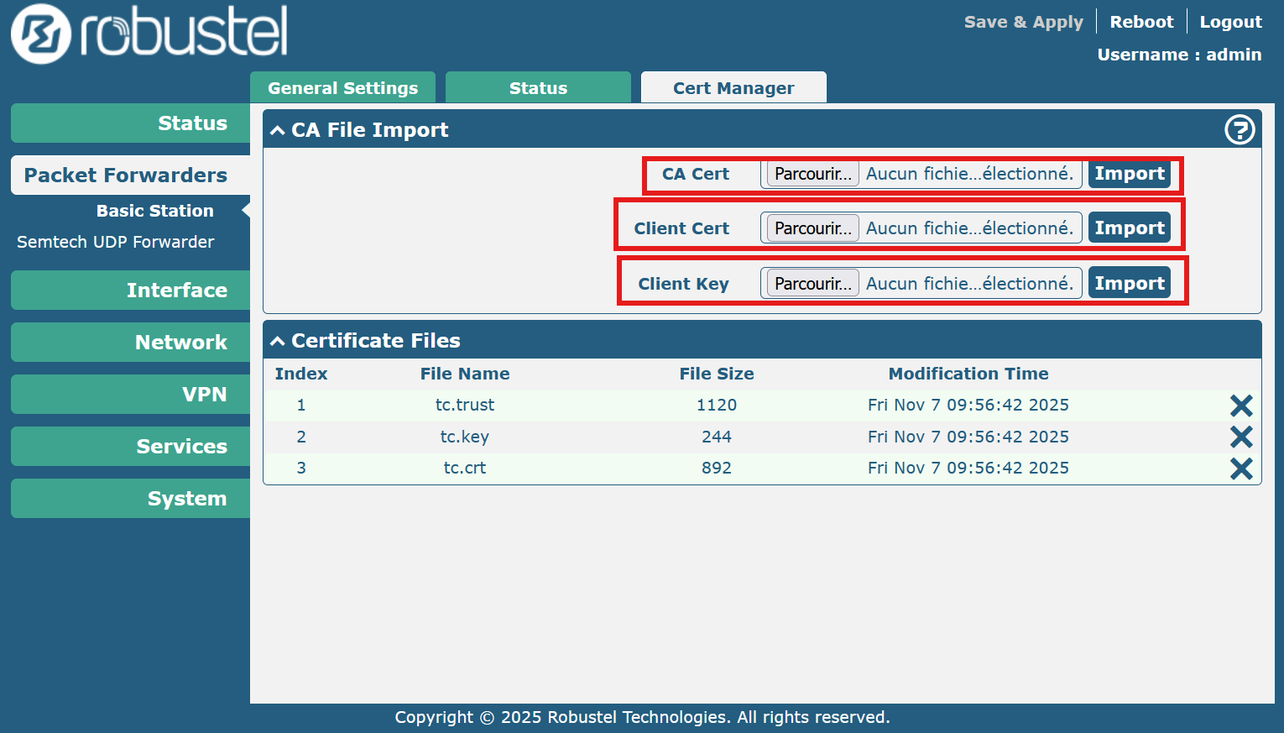
hardware/specs/v2-2025/gateway/Images/robustel_adding_certificates.png
