flipoyo/MOLONARI1D/hardware/specs/v2-2025/Images/tige_en_vissage.jpg

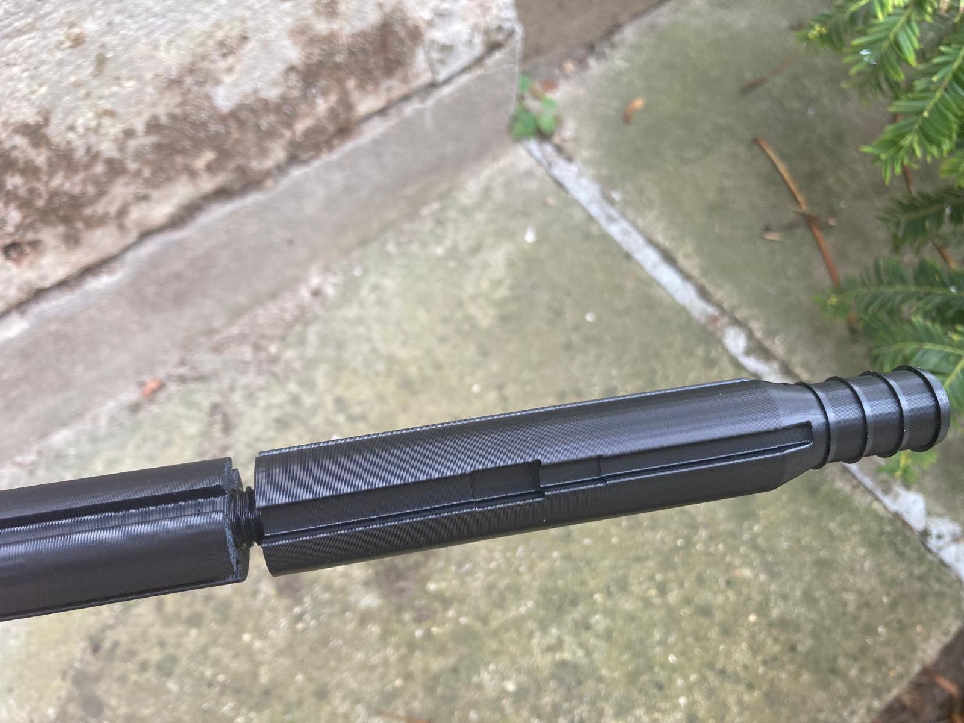
hardware/specs/v2-2025/Images/tige_en_vissage.jpg
