flipoyo/MOLONARI1D/hardware/specs/v2-2025/sensors/differential pressure sensor/Circuit_scheme_credit_Greswell.jpg

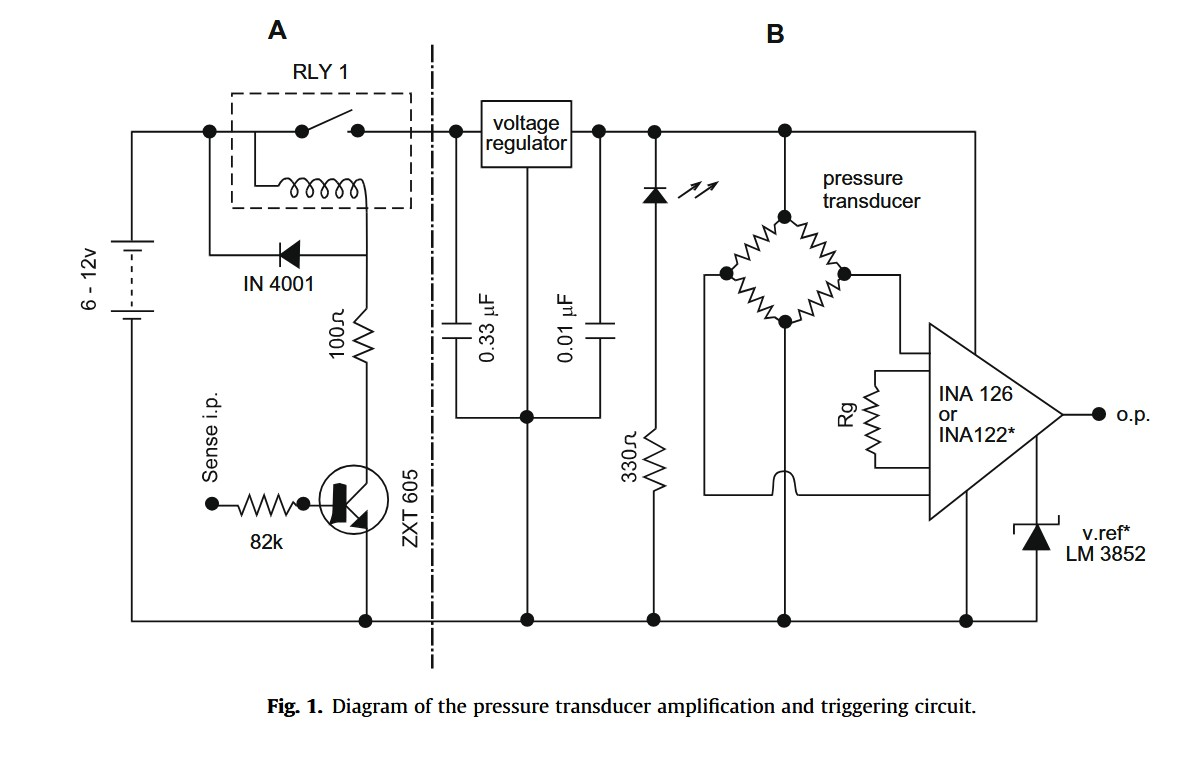
hardware/specs/v2-2025/sensors/differential pressure sensor/Circuit_scheme_credit_Greswell.jpg
