flipoyo/MOLONARI1D/Molonaviz/src/molonaviz/docs/erd.png

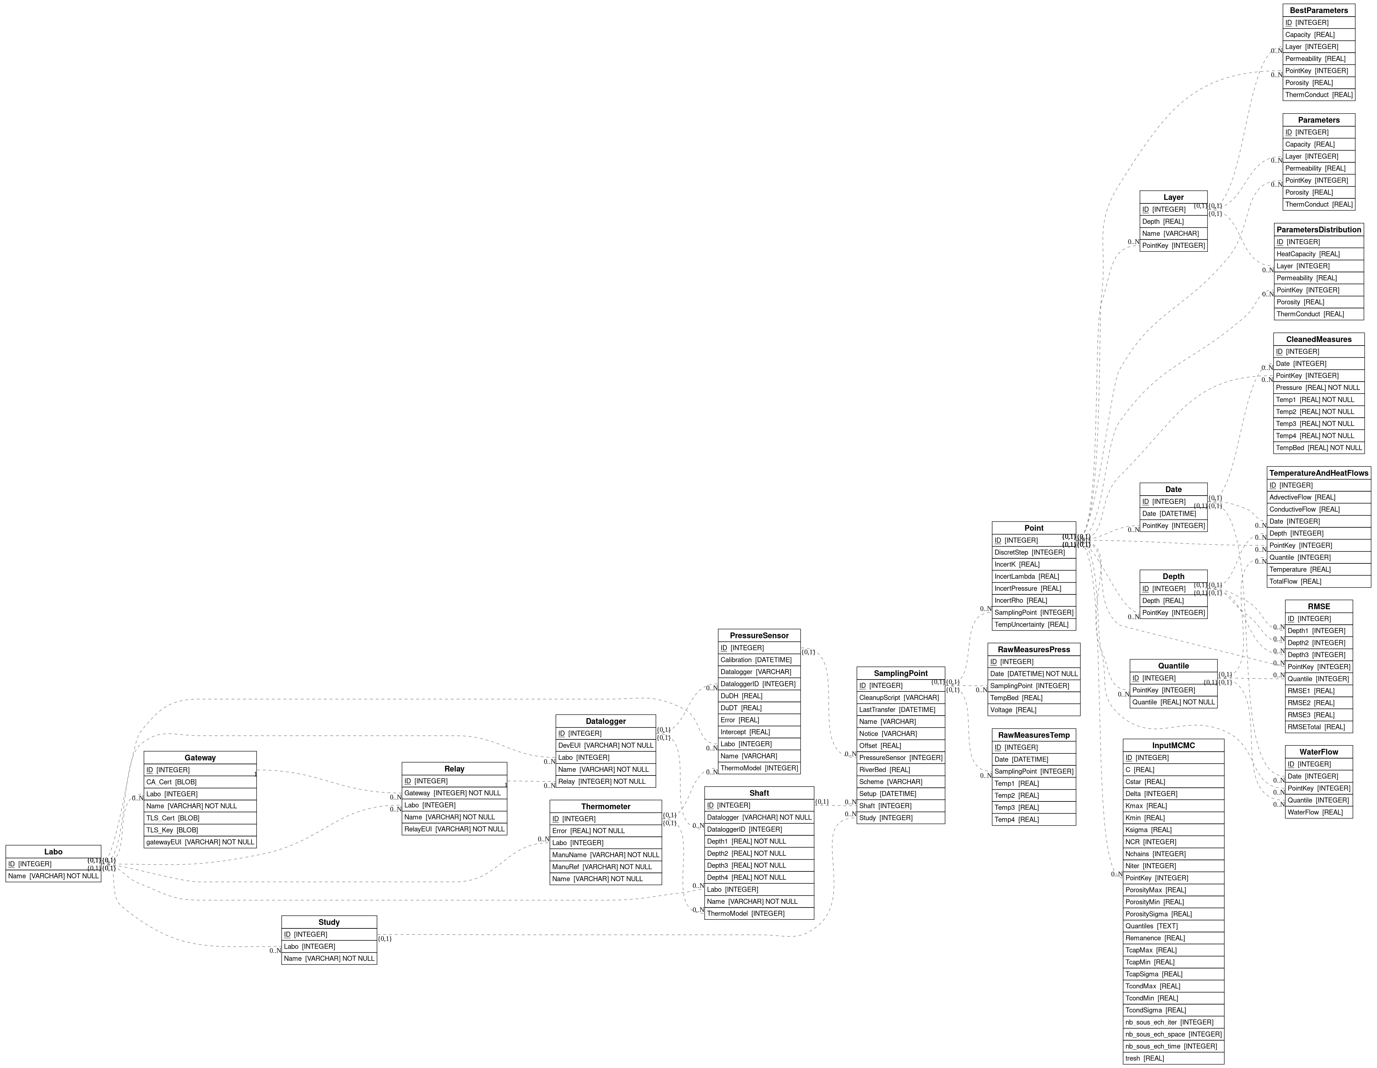
Molonaviz/src/molonaviz/docs/erd.png
