flipoyo/MOLONARI1D/Molonaviz/src/molonaviz/docs/ERD_ORIGINAL.png

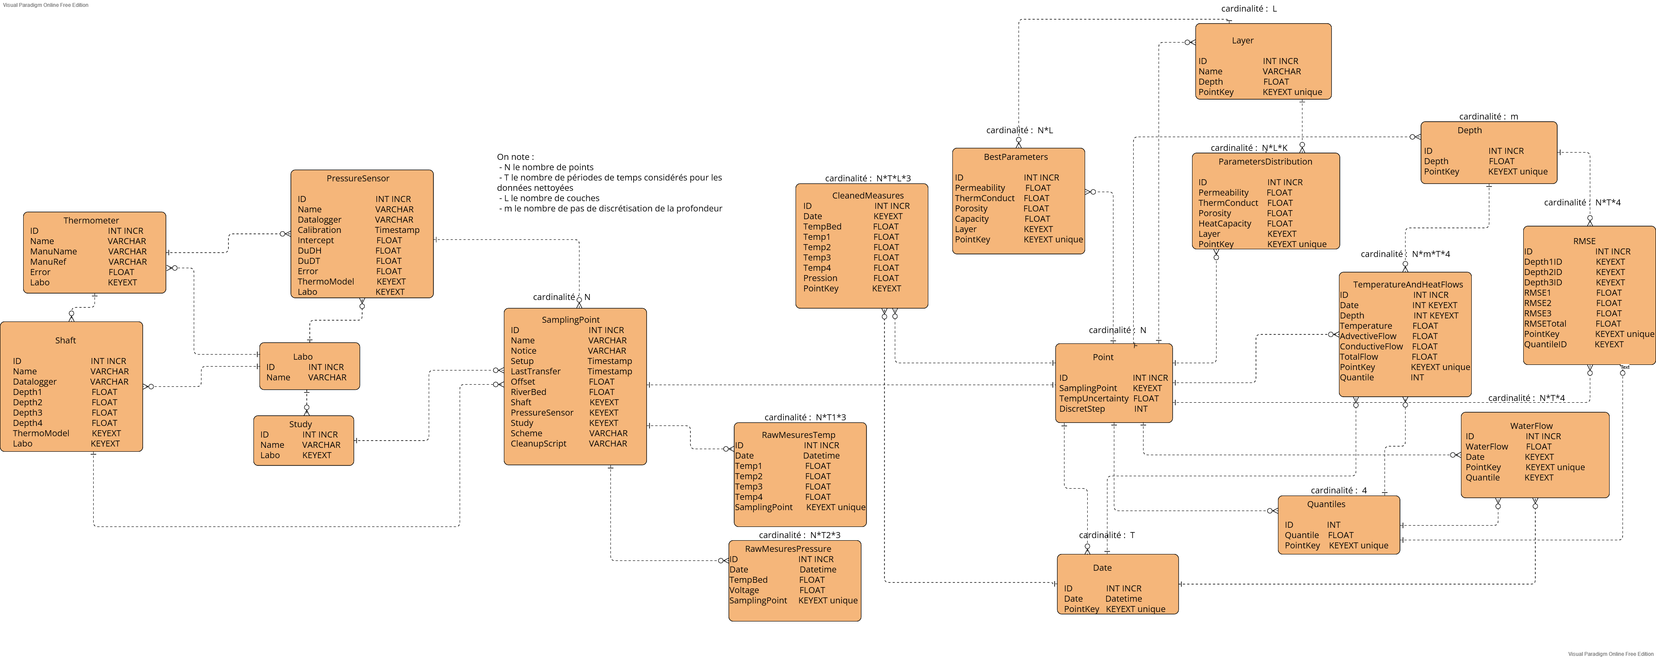
Molonaviz/src/molonaviz/docs/ERD_ORIGINAL.png
