flipoyo/MOLONARI1D/Molonaviz/src/molonaviz/docs/SQL_map_REF.png

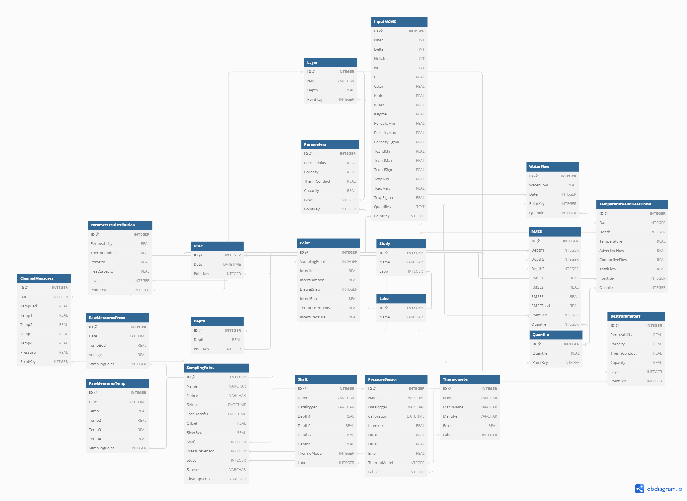
Molonaviz/src/molonaviz/docs/SQL_map_REF.png
