flipoyo/MOLONARI1D/hardware/specs/v2-2025/electronic connexion/Components_Arduino_Card.md

# Components of the Arduino Card

Here are the links to the documentation about the components of the Arduino Card used in the MOLONARI System, the Arduino MKR WAN 1310. This document could be useful to integrate the electronic circuit. 

- [The whole card](https://docs.arduino.cc/hardware/mkr-wan-1310/#tutorials)
- [The pinouts](https://docs.arduino.cc/resources/pinouts/ABX00029-full-pinout.pdf)
- [The microcontroller](https://www.micros.com.pl/mediaserver/info-atsamd21g17a-au.pdf)
- [The coprocessor](https://ww1.microchip.com/downloads/aemDocuments/documents/OTH/ProductDocuments/DataSheets/20005928A.pdf)
- [The charger](https://www.ti.com/product/BQ24195L/part-details/BQ24195LRGER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)
- [The JST-connector](https://www.jst-connector.com/datasheet/jst-connector/SM05B-SRSS-TB(LF)(SN)(PP).pdf)
