flipoyo/MOLONARI1D/dataAnalysis/raw_data/point52_13_10_23/p529_06_11_23.csv

Titre de tracé : p052
# | Date Heure, GMT+01:00 | Tension, V (LGR S/N: 21065779, SEN S/N: 21065779, LBL: pression) | Temp., °C (LGR S/N: 21065779, SEN S/N: 21065779, LBL: temperature) | Hôte connecté (LGR S/N: 21065779) | Arrêté (LGR S/N: 21065779) | Fin de fichier (LGR S/N: 21065779)
1 | 10/19/23 06:00:00 PM | 2.11601 | 14.828
2 | 10/19/23 06:15:00 PM | 1.81380 | 14.782
3 | 10/19/23 06:30:00 PM | 1.67681 | 14.731
4 | 10/19/23 06:45:00 PM | 1.63451 | 14.688
5 | 10/19/23 07:00:00 PM | 1.61761 | 14.647
6 | 10/19/23 07:15:00 PM | 1.60945 | 14.605
7 | 10/19/23 07:30:00 PM | 1.60597 | 14.577
8 | 10/19/23 07:45:00 PM | 1.60334 | 14.548
9 | 10/19/23 08:00:00 PM | 1.60094 | 14.518
10 | 10/19/23 08:15:00 PM | 1.60117 | 14.496
11 | 10/19/23 08:30:00 PM | 1.59937 | 14.486
12 | 10/19/23 08:45:00 PM | 1.59823 | 14.475
13 | 10/19/23 09:00:00 PM | 1.59834 | 14.465
14 | 10/19/23 09:15:00 PM | 1.59773 | 14.445
15 | 10/19/23 09:30:00 PM | 1.59651 | 14.433
16 | 10/19/23 09:45:00 PM | 1.59522 | 14.423
17 | 10/19/23 10:00:00 PM | 1.59564 | 14.417
18 | 10/19/23 10:15:00 PM | 1.59724 | 14.412
19 | 10/19/23 10:30:00 PM | 1.59564 | 14.411
20 | 10/19/23 10:45:00 PM | 1.59705 | 14.405
21 | 10/19/23 11:00:00 PM | 1.59766 | 14.400
22 | 10/19/23 11:15:00 PM | 1.59705 | 14.396
23 | 10/19/23 11:30:00 PM | 1.59556 | 14.390
24 | 10/19/23 11:45:00 PM | 1.59461 | 14.385
25 | 10/20/23 12:00:00 AM | 1.59442 | 14.385
26 | 10/20/23 12:15:00 AM | 1.59861 | 14.387
27 | 10/20/23 12:30:00 AM | 1.59384 | 14.390
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
1723 | 11/06/23 04:30:00 PM | 2.49996 | 13.559
1724 | 11/06/23 04:45:00 PM | 2.49996 | 13.769
1725 | 11/06/23 05:00:00 PM | 2.49996 | 14.699
1726 | 11/06/23 05:15:00 PM | 2.49996 | 15.100
1727 | 11/06/23 05:30:00 PM | 2.49996 | 15.088
1728 | 11/06/23 05:45:00 PM | 2.49996 | 15.263
1729 | 11/06/23 06:00:00 PM | 2.49996 | 15.579
1730 | 11/06/23 06:15:00 PM | 2.49996 | 13.946
1731 | 11/06/23 06:21:30 PM |  |  | Enregistré
1732 | 11/06/23 06:21:45 PM |  |  | Enregistré
1733 | 11/06/23 06:22:09 PM |  |  |  | Enregistré | Enregistré
