flipoyo/MOLONARI1D/dataAnalysis/raw_data/point53_13_10_23/p538_06_11_23.csv

Titre de tracé : p053
# | Date Heure, GMT+01:00 | Tension, V (LGR S/N: 21065769, SEN S/N: 21065769, LBL: tension) | Temp., °C (LGR S/N: 21065769, SEN S/N: 21065769, LBL: temperature) | Hôte connecté (LGR S/N: 21065769) | Arrêté (LGR S/N: 21065769) | Fin de fichier (LGR S/N: 21065769)
1 | 10/13/23 12:45:00 PM | 1.55264 | 24.459
2 | 10/13/23 01:00:00 PM | 1.64973 | 15.602
3 | 10/13/23 01:15:00 PM | 1.64954 | 15.675
4 | 10/13/23 01:30:00 PM | 1.66194 | 15.748
5 | 10/13/23 01:45:00 PM | 1.66579 | 15.837
6 | 10/13/23 02:00:00 PM | 1.64473 | 15.897
7 | 10/13/23 02:15:00 PM | 1.66178 | 15.922
8 | 10/13/23 02:30:00 PM | 1.66300 | 15.982
9 | 10/13/23 02:45:00 PM | 1.65843 | 16.026
10 | 10/13/23 03:00:00 PM | 1.65572 | 16.055
11 | 10/13/23 03:15:00 PM | 1.65061 | 16.134
12 | 10/13/23 03:30:00 PM | 1.65042 | 16.149
13 | 10/13/23 03:45:00 PM | 1.65156 | 16.172
14 | 10/13/23 04:00:00 PM | 1.64820 | 16.187
15 | 10/13/23 04:15:00 PM | 1.64904 | 16.204
16 | 10/13/23 04:30:00 PM | 1.64649 | 16.220
17 | 10/13/23 04:45:00 PM | 1.64771 | 16.244
18 | 10/13/23 05:00:00 PM | 1.64652 | 16.266
19 | 10/13/23 05:15:00 PM | 1.64485 | 16.274
20 | 10/13/23 05:30:00 PM | 1.64420 | 16.277
21 | 10/13/23 05:45:00 PM | 1.64164 | 16.277
22 | 10/13/23 06:00:00 PM | 1.64065 | 16.272
23 | 10/13/23 06:15:00 PM | 1.63836 | 16.268
24 | 10/13/23 06:30:00 PM | 1.64084 | 16.262
25 | 10/13/23 06:45:00 PM | 1.64069 | 16.260
26 | 10/13/23 07:00:00 PM | 1.63790 | 16.263
27 | 10/13/23 07:15:00 PM | 1.63691 | 16.266
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
2320 | 11/06/23 04:30:00 PM | 1.48405 | 14.789
2321 | 11/06/23 04:45:00 PM | 1.50252 | 15.655
2322 | 11/06/23 05:00:00 PM | 1.49920 | 16.237
2323 | 11/06/23 05:15:00 PM | 1.68746 | 14.563
2324 | 11/06/23 05:19:50 PM |  |  | Enregistré
2325 | 11/06/23 05:20:08 PM |  |  |  | Enregistré | Enregistré
