flipoyo/MOLONARI1D/data/SamplingPoints/Point047/point047_P_measures.csv

Titre de tracé : point_46
# | Date Heure, GMT+01:00 | Tension, V (LGR S/N: 10831978, SEN S/N: 10831978, LBL: dh) | Temp., °C (LGR S/N: 10831978, SEN S/N: 10831978, LBL: T°C) | Hôte connecté (LGR S/N: 10831978) | Arrêté (LGR S/N: 10831978) | Fin de fichier (LGR S/N: 10831978)
1 | 27/08/2019 14:00 | 1.1758897 | 25.154
2 | 27/08/2019 14:15 | 1.173473137 | 25.122
3 | 27/08/2019 14:30 | 1.171214633 | 25.071
4 | 27/08/2019 14:45 | 1.166001548 | 24.947
5 | 27/08/2019 15:00 | 1.160738947 | 24.825
6 | 27/08/2019 15:15 | 1.160312742 | 24.705
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
