flipoyo/MOLONARI1D/hardware/specs/v2-2025/sensors/shaft/building/tige full (sans vis) - fichier à imprimer.stl

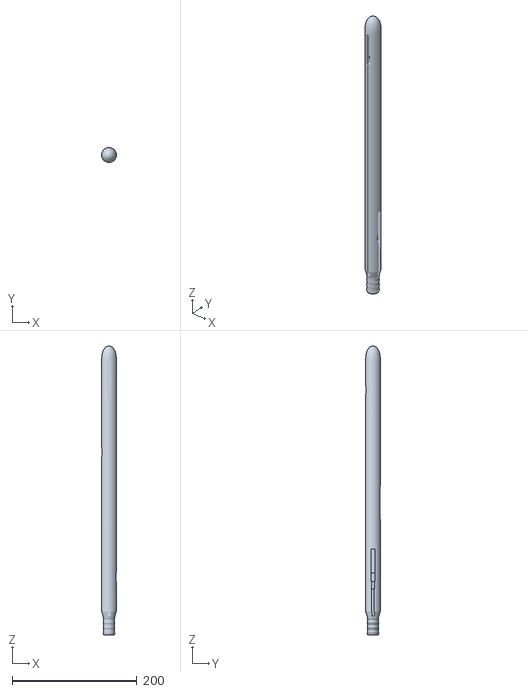
[picture p165: CAD file, 2025-11-14]
hardware/specs/v2-2025/sensors/shaft/building/tige full (sans vis) - fichier à imprimer.stl
24.0 x 24.0 x 463.0
