flipoyo/MOLONARI1D/hardware/specs/v1-until-2024/distributedTemperatureSensor/shaft_2024version/printTemperatureShaft.STL

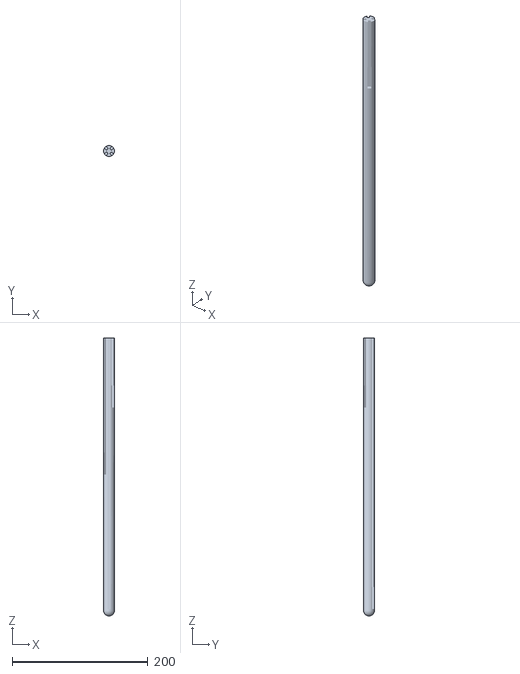
[picture p166: CAD file, 2025-11-03]
hardware/specs/v1-until-2024/distributedTemperatureSensor/shaft_2024version/printTemperatureShaft.STL
16.0 x 16.0 x 410.0
