flipoyo/MOLONARI1D/hardware/specs/v2-2025/sensors/box/cover.stl

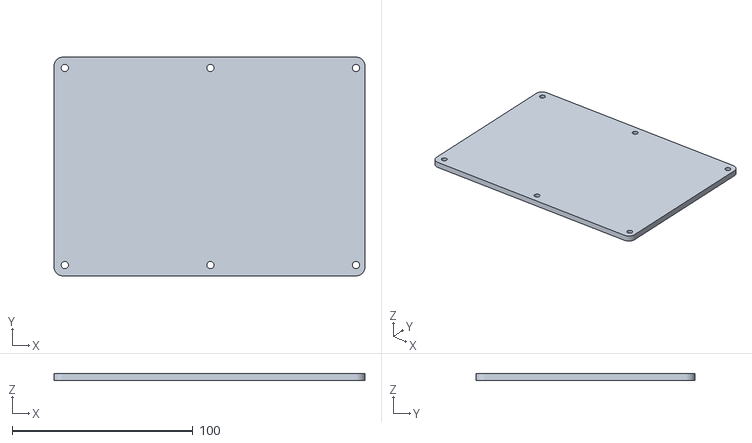
[picture p167: CAD file, 2025-11-14]
hardware/specs/v2-2025/sensors/box/cover.stl
172.0 x 121.0 x 4.00
