flipoyo/MOLONARI1D/hardware/specs/v2-2025/sensors/shaft/building/tige à vis/fichiers stl (pour l'impression)/Bout tige.stl

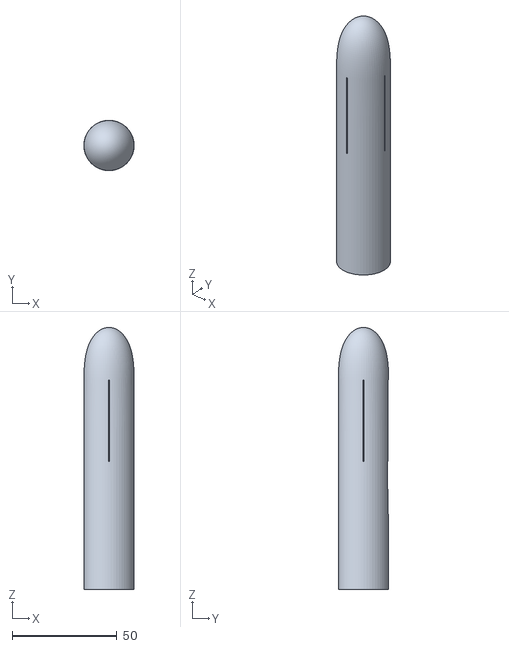
[picture p168: CAD file, 2025-11-14]
hardware/specs/v2-2025/sensors/shaft/building/tige à vis/fichiers stl (pour l'impression)/Bout tige.stl
24.0 x 24.0 x 125.0
