flipoyo/MOLONARI1D/hardware/specs/v2-2025/sensors/shaft/building/tige à vis/modèles fusion/Partie centrale.step

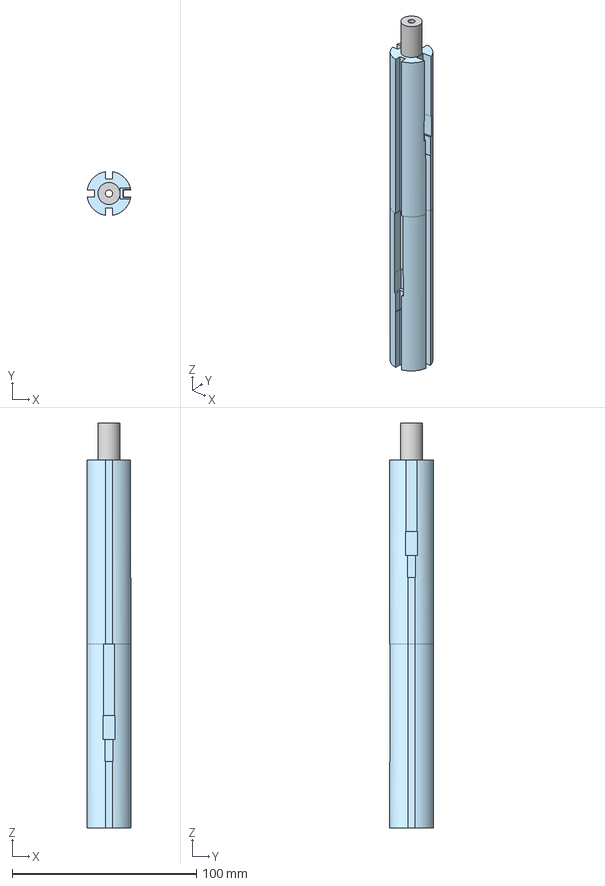
[picture p169: CAD file, 2025-11-14]
hardware/specs/v2-2025/sensors/shaft/building/tige à vis/modèles fusion/Partie centrale.step
23.7 x 23.7 x 220.0 mm
