flipoyo/MOLONARI1D/hardware/specs/v2-2025/sensors/shaft/building/tige à vis/modèles fusion/Embout tige.step

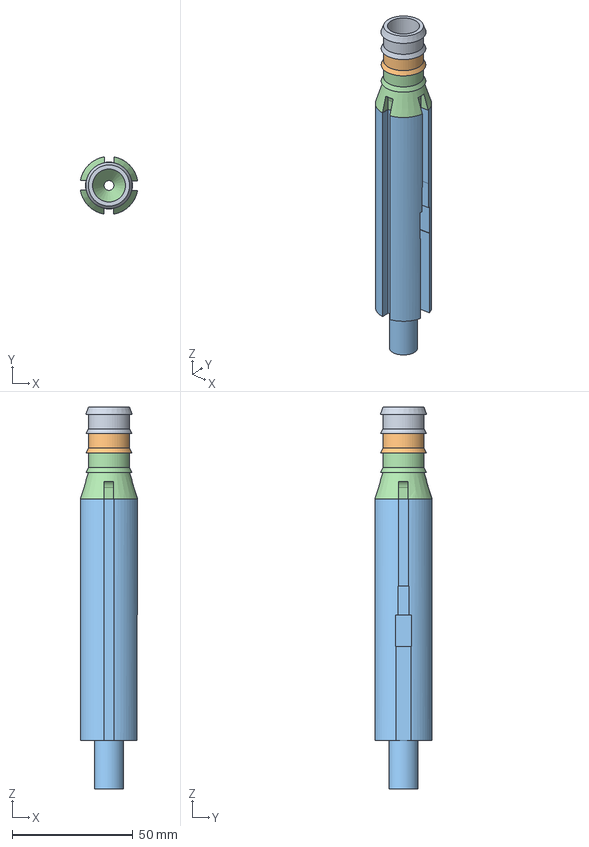
[picture p170: CAD file, 2025-11-14]
hardware/specs/v2-2025/sensors/shaft/building/tige à vis/modèles fusion/Embout tige.step
23.7 x 23.7 x 158.0 mm
