flipoyo/MOLONARI1D/hardware/specs/v2-2025/sensors/shaft/building/tige à vis/fichiers stl (pour l'impression)/Embout tige.stl

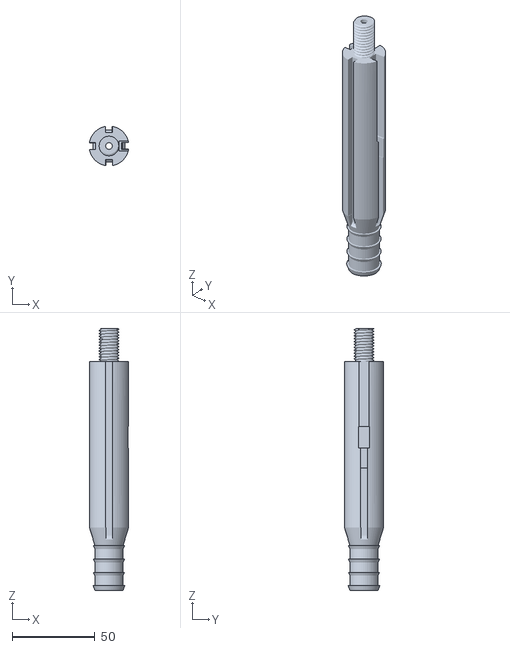
[picture p171: CAD file, 2025-11-14]
hardware/specs/v2-2025/sensors/shaft/building/tige à vis/fichiers stl (pour l'impression)/Embout tige.stl
23.7 x 23.7 x 158.0
