flipoyo/MOLONARI1D/(list of files, cad)

Other CAD files:
hardware/specs/v2-2025/sensors/shaft/building/tige à vis/fichiers stl (pour l'impression)/Partie centrale.stl
hardware/specs/v2-2025/sensors/shaft/building/tige à vis/modèles fusion/Bout tige.step
