flipoyo/MOLONARI1D/hardware/specs/v2-2025/electronic connexion/Electronic circuit soldering diagram.pdf

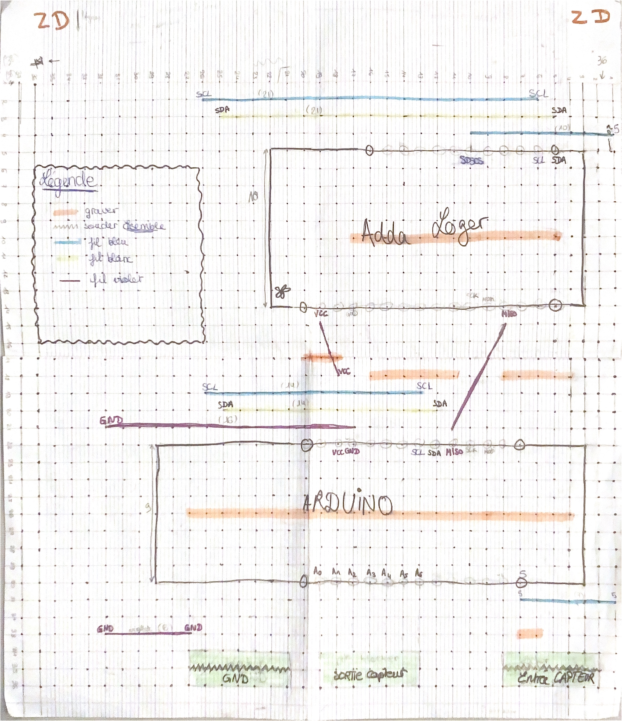
[picture p211: page 1]
