flipoyo/MOLONARI1D/data/SamplingPoints/Point034/point034_T_measures.csv

Titre de tracé : T520
# | Date Heure, GMT+01:00 | Temp., °C (LGR S/N: 10117166, SEN S/N: 10117166, LBL: Température) | Temp., °C (LGR S/N: 10117166, SEN S/N: 10117166, LBL: Température) | Temp., °C (LGR S/N: 10117166, SEN S/N: 10117166, LBL: Température) | Temp., °C (LGR S/N: 10117166, SEN S/N: 10117166, LBL: Température) | Hôte connecté (LGR S/N: 10117166) | Arrêté (LGR S/N: 10117166) | Fin de fichier (LGR S/N: 10117166)
1 | 06/27/16 12:00:00 PM | 13.810 | 13.834 | 13.858 | 13.810
2 | 06/27/16 12:15:00 PM | 13.834 | 13.858 | 13.882 | 13.834
3 | 06/27/16 12:30:00 PM | 13.930 | 13.954 | 14.050 | 14.002
4 | 06/27/16 12:45:00 PM | 13.882 | 13.954 | 14.026 | 13.954
5 | 06/27/16 01:00:00 PM | 13.858 | 13.930 | 14.026 | 13.954
6 | 06/27/16 01:15:00 PM | 13.882 | 13.930 | 14.002 | 13.930
7 | 06/27/16 01:30:00 PM | 13.882 | 13.930 | 14.002 | 13.930
8 | 06/27/16 01:45:00 PM | 13.906 | 13.930 | 14.002 | 13.930
9 | 06/27/16 02:00:00 PM | 13.906 | 13.930 | 14.002 | 13.906
10 | 06/27/16 02:15:00 PM | 13.930 | 13.930 | 13.978 | 13.906
11 | 06/27/16 02:30:00 PM | 13.930 | 13.930 | 13.978 | 13.906
12 | 06/27/16 02:45:00 PM | 13.954 | 13.930 | 13.978 | 13.906
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
