flipoyo/MOLONARI1D/data/SamplingPoints/Point047/point047_T_measures.csv

Titre de tracé : T46
# | Date Heure, GMT+01:00 | Temp., °C (LGR S/N: 10117166, SEN S/N: 10117166, LBL: Température) | Temp., °C (LGR S/N: 10117166, SEN S/N: 10117166, LBL: Température) | Temp., °C (LGR S/N: 10117166, SEN S/N: 10117166, LBL: Température) | Temp., °C (LGR S/N: 10117166, SEN S/N: 10117166, LBL: Température) | Hôte connecté (LGR S/N: 10117166) | Arrêté (LGR S/N: 10117166) | Fin de fichier (LGR S/N: 10117166)
1 | 27/08/2019 14:00 | 34.60782259 | 34.53903289 | 34.48648351 | 34.075
2 | 27/08/2019 14:15 | 34.59623088 | 34.53435968 | 34.47810728 | 34.075
3 | 27/08/2019 14:30 | 34.58709678 | 34.5306288 | 34.4460472 | 34.075
4 | 27/08/2019 14:45 | 34.57732416 | 34.52730119 | 34.38967691 | 34.075
5 | 27/08/2019 15:00 | 34.56545047 | 34.52401829 | 34.31129907 | 34.075
6 | 27/08/2019 15:15 | 34.55074675 | 34.52044343 | 34.21498057 | 34.075
7 | 27/08/2019 15:30 | 34.53292189 | 34.51622555 | 34.10530395 | 34.075
8 | 27/08/2019 15:45 | 34.51194727 | 34.51100582 | 33.98656459 | 34.075
9 | 27/08/2019 16:00 | 34.48780048 | 34.5044369 | 33.86239413 | 34.075
10 | 27/08/2019 16:15 | 34.46058542 | 34.49620211 | 33.73566539 | 34.075
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
