flipoyo/MOLONARI1D/data/SamplingPoints/Point051-1/point051-1_P_measures.csv

Titre de tracé : 21065769
# | Date Heure, GMT+01:00 | Tension, V (LGR S/N: 21065769, SEN S/N: 21065769, LBL: tension) | Temp., °F (LGR S/N: 21065769, SEN S/N: 21065769, LBL: temperature) | Temp., °F (LGR S/N: 21065769, SEN S/N: 21065769, LBL: temperature boite) | Hôte connecté (LGR S/N: 21065769) | Arrêté (LGR S/N: 21065769) | Fin de fichier (LGR S/N: 21065769)
1 | 03/02/22 03:00:00 PM | 0.00835 | 487.387 | 472.748
2 | 03/02/22 03:15:00 PM | 1.47040 | 54.275 | 305.368
3 | 03/02/22 03:30:00 PM | 1.22023 | 47.131 | 284.706
4 | 03/02/22 03:45:00 PM | 1.29114 | 47.181 | 250.734
5 | 03/02/22 04:00:00 PM | 1.35817 | 47.255 | 236.385
6 | 03/02/22 04:15:00 PM | 1.45903 | 47.307 | 226.292
7 | 03/02/22 04:30:00 PM | 1.44312 | 47.370 | 220.467
8 | 03/02/22 04:45:00 PM | 1.44053 | 47.431 | 220.354
9 | 03/02/22 05:00:00 PM | 1.43664 | 47.502 | 223.441
10 | 03/02/22 05:15:00 PM | 1.43561 | 47.568 | 227.115
11 | 03/02/22 05:30:00 PM | 1.43400 | 47.629 | 231.141
12 | 03/02/22 05:45:00 PM | 1.42954 | 47.676 | 235.456
13 | 03/02/22 06:00:00 PM | 1.42863 | 47.714 | 239.486
14 | 03/02/22 06:15:00 PM | 1.42763 | 47.746 | 242.539
15 | 03/02/22 06:30:00 PM | 1.42859 | 47.772 | 245.619
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
