flipoyo/MOLONARI1D/(threads)

Thread 4 (2023-11-30):

3 bugs to fix before to go

flipoyo, 2023-11-30:
Dear calculation and software team,

I found bugs in your final version in the main branch.

Most important
The multi-layer calculation doesn't work

The other bug are explained in a file bugReport.md in the main branch:

# Bug Report for MOLONARI Edition 2023

To be fixed asap by the 2023 Team

## Major bug in pyheatmy

Multi-layer doesn't work in direct modelling

When launching a stratified computation, a Figure appears for the visualisation of an initial state, which shouldn't, and then MolonaviZ freezes (no computation done, while it works in a monolayer configuration)

When trying to launch a new simulation, the message "Please wait while for the previous computation to end" always appears in the dialog box

## MolonaviZ

Compute window --> permeability value stated in m/s while it is set up at 1e-12 by default, which is an intrinsec permeability value. Do you confirm that it is intrinsec permeability, if yes the unit need to be changed in m2

Temperature window
The comparison of simulated temperatures with observed temperatures has not been merged (check Etienne Debricon branch please)

Please correct those last three bugs as soon as you can.
Many thanks

flipoyo, 2023-12-04:
Dear calculation and software team,

Thank you Zhan for fixing the multilayer issue.

There are still critical bugs:

# Bug Report for MOLONARI Edition 2023

bugs remain, mostly in MolonaviZ

To be fixed asap by the 2023 Team

## MolonaviZ

Not all the advances of the MolonaviZ team are merged in the main branch:

+ Temperature window : The comparison of simulated temperatures with observed temperatures has not been merged (check Etienne Debricon branch please)

+ The compute window doesn't display properly the last values of parameters :
- After a mono-layer forward model, only the default parameter values are displayed in the compute window
- After a multi-layer forrward model permeability is not displayed properly. Using 4 layers, the two intermediate ones display None for the parameter values
- There is nowhere to view the best MCMC results (parameters that correspond to quantile 0). I am surprise because the MolonaviZ team showed me this facility once.
- After a mono-layer MCMC, only the default parameter values are displayed in the compute window
- After a multi-layer MCMC, same issue than for a multi-layer forward model

+ Compute window --> permeability value stated in m/s while it is set up at 1e-12 by default, which is an intrinsec permeability value. Do you confirm that it is intrinsec permeability, if yes the unit need to be changed in m2. There is then a pb in the Fluxes windows. The value of the advective fluxes is always very low as well as the water flow. I think the intrinsec permeability, k [m2], is used directly in the flux calculation, rather than the permeability K [m/s]. --> __To be Done jointly with pyheatmy team__

+ Data arrays and plots: The display of the Temperatures is upside down. Sensor 0 displays Temp1, .... 3 Temp4 and sensor 4 displays RiverBed. Riverbed must be sensor 0 and then sensotr i is temp i

Major bug for next team (ie 2024) concerns the fact that once a MCMC inversion has been lauch, MCMC is always launched whatever the user request, which is calculated after a MCMC calculation. For instance, if i ask for a direct simulation after a MCMC, the programm will repeat the MCMC and then perform the direct simulation and update the figures in accordance with the direct calculation only (pdfd disappear in the distribution window)

## pyheatmy

Last bug to check is the unit of permeability which should be intrinsec permeability in [m2] in compute windows, and then check calculation of advective and conductive fluxes in Fluxes window, which units are for now wrong

Multi-layer works in both forward modelling and multi-chain MCMC --> bravo

Can you please correct the bugs or at least let me know in which branch to check for finding the fixes.
Thank you

flipoyo, 2024-09-27:
I defined specific issues for the MOLONARI2024 project.

Closed 2024-09-27.

Thread 10 (2024-09-26):

MOLONAVIZ comparison data simulation

flipoyo, 2024-09-26:
The comparison of data with simulated temperature doesn't work.
It should be effective for the first graph of temperature tab

It worked in the development of Etienne Debricon for the monolayer case.

Everything got bugged when the 2023 group developped the multi layer algorithm, which should be in Fibo72 branches as well as in 2023Thune one. But not clear what happened. Must investigate the 2023lambert3branch

Thread 12 (2024-09-27):

I don't understand the merges of branch 2023lambert3

flipoyo, 2024-09-27:
est-ce que l'on pourrait en discuter car je pense qu'une partie des bugs SQL viennent de cette branche qui avait était mergée de manière pirate via Thune (avec des copier coller dans ces sources).

fabien-ors, 2024-09-27:
La structure de la base de données dans la branche main a très peu évolué en 2023 :
https://github.com/flipoyo/MOLONARI1D/commits/main/Molonaviz/src/molonaviz/docs/ERD_structure.sql

Les modifications de la structure de la BDD présentes dans la branche 2023lambert3 depuis le 6 novembre
https://github.com/flipoyo/MOLONARI1D/commits/2023lambert3/Molonaviz/src/molonaviz/docs/ERD_structure.sql
(création de la table InputMCMC par exemple)
... n'ont jamais été mergées.

La code proposé dans SPointCoordinator.py (méthode get_table_model par exemple):
https://github.com/flipoyo/MOLONARI1D/compare/main...2023lambert3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
est visiblement obsolète quand on voit la tête de la même méthode dans la branche main:
https://github.com/flipoyo/MOLONARI1D/blob/main/Molonaviz/src/molonaviz/backend/SPointCoordinator.py

fabien-ors, 2024-10-10:
@flipoyo veut-on conserver les démos dans cette branche : https://github.com/flipoyo/MOLONARI1D/tree/2023lambert3/Demo ?

Closed 2024-10-14.

Thread 16 (2024-09-27):

Debug the multi-layer case

flipoyo, 2024-09-27:
Multiple problems linked to the SQL layer handling need to be fixed.

This is a priority. Here is a message from Fibo72 about unfixed issues:
"Nos travaux sont bel et bien intégrés dans Molonaviz.

Seulement, nous avons tenté vers la fin du trimestre d'implémenter certaines modifications supplémentaires qui n'ont pas aboutie faute de temps. Le code sur ces branches est instable mais peut servir de ressources pour les prochaines éditions de Molonaviz.( Par exemple ma branche tente de sauvegarder les saisies utilisateur dans la base de données, mais l'utilisation de layer comme clé pour beaucoup d'éléments de la table m'a empêché de terminer.

Par ailleurs, nous avons choisi de faire des merges d'une branche relativement à une autre. Cela nous évitait d'avoir à recréer une branche à chaque merge. C'est pourquoi certaines branches existent bien que leur contenu à été téléversé dans main. (Nous ne savions pas si elles allaient encore nous servir).

En résumé, le contenu additionnel de ces branches est bien dans main. Si elle vous semblent inutiles, il est tout à fait possible de les supprimer."

See the remaining 2023lambert3 branch for more details.

This issue is related to issue #12

Closed 2024-10-14.

Thread 17 (2024-09-27):

PYHEATMY : implement adimensionnal multi-layer case in src

flipoyo, 2024-09-27:
After issues 13, 14, 15, implement the adimensionnal multi-layer case in src.

It needs to add the divK term in the equation system of pyheatmy. See message below :+1:
J'ai retravaillé les deux dernières semaines sur le modèle multicouche avec le div(K). Le modèle que j'ai implémenté ne gère pas bien l'interface (H à le bon profil en deux pentes mais le saut de dérivé est incorrect à l'interface) et je pense avoir compris pourquoi. Si ce que j'ai compris est correct, la prise en compte de l'interface réalisée par Zhan ne suffira pas à corriger l'erreur.
Pour trouver la source de l'erreur, j'ai utilisé un cas où la dérivée temporelle de H est nulle. Il suffit donc de résoudre div(K * dH/dz) = 0 donc dK/dz * dH/dz + K d²H/dz². Dans cette équation, la solution est de la forme K *dH/dz = cte donc K et dH/dz sont censés jouer des rôles symétriques. Cependant notre schéma numérique entraîne une dissymétrie car dH/dz est calculé au point k avec les valeurs de H en k+1 et k-1. Donc si la frontière est en k elle influence 3 valeurs de dH/dz: en k-1, k et k+1. On a une frontière en trois points sur H et en un seul point sur K.
J'ai trouvé une solution au problème. En effet, il est possible de mieux gérer la frontière en la lissant (une fonction tanh fonctionne très bien) et en changeant le pas de discrétisation spatiale autour de la frontière. Cette solution n'est pas facilement implémentable et je n'ai pas eu le temps de la mettre en oeuvre. Je pense écrire une note sur le sujet pour que les prochains puissent le faire.

Il convient ainsi d'introduire divK dans pyheatmy/research/Note_adimensionnement.ipynb

et de reprendre les formulations de pyheatmy/research/demo_H_strat_zhanJING.ipynb

Thread 20 (2024-09-27):

MOLONAVIZ Temperature upside down

flipoyo, 2024-09-27:
In tab temperature

Data arrays and plots: The display of the Temperatures is upside down. Sensor 0 displays Temp1, .... 3 Temp4 and sensor 4 displays RiverBed. Riverbed must be sensor 0 and then sensotr i is temp i

Thread 24 (2024-09-30):

PYHEATMY: add the new fonctionnality of the column class to the API.

flipoyo, 2024-09-30:
Add the new functionnality of the column class in core.py in the API, especially getting an array of temperature at each sensor of the column, as well as the graphical printings or the text file printing.

All the function to generate synthetic case studies must also be added

Thread 25 (2024-10-01):

Verify the @checker in core.py

flipoyo, 2024-10-01:
I think checkers handling is not completed for the DREAM method, also for a few ones that I added, such as the Temperatures at sensors recollection.

flipoyo, 2024-11-06:
OK after refactoring

Closed 2024-11-06.

Thread 28 (2024-10-02):

MOLONAVIZ: Cannot manipulate de-docked window

fabien-ors, 2024-10-02:
Once de-docked, the "Data Points" window (for example) is resizeable (that's a good point). But it cannot be moved. I clicked on the title bar and tried to drag the window to the right but nothing happened. Such window cannot be re-docked as well. That means that we cannot come back to the initial state.

Usually dockable windows can be moved and docked to other sides of the client window. This feature should be fixed. Currently, there is no interest in using docking feature.

Thread 29 (2024-10-02):

MOLONAVIZ: stucked when clicking OK in "Change Database" window

fabien-ors, 2024-10-02:
Assume that a database is currently opened.
Using the "Change database" menu option, in the "Choose the path of the database" window, all the fields are kept empty:

if I click on OK, i get the following error message (indeed!):
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

But if I click OK, the error message doesn't disappear and Molonaviz is stuck.
The only way to stop Molonaviz is to kill the process.

Thread 34 (2024-10-02):

MOLONAVIZ: Cannot import cleaned measures from exported CSV

fabien-ors, 2024-10-02:
After cleaning up the measures, I export them into 2 CSV files using "Export cleaned measures" button.
In the "Import cleaned measures" tab of the "Clean-up..." window, I browse to one out of the 2 exported files and I obtain the following error:
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

When exporting, it creates 2 files. I assume that for importing cleaned measures, we should ask for two CSV files as well.

Thread 36 (2024-10-03):

Set up pyheatmy printing directory with MolonaviZ

flipoyo, 2024-10-03:
when initialising a column with MolonaviZ, please add the proper value for the new rac argument (see core.py), which is the directory where pyheatmy prints files with the new printing commands

Thread 42 (2024-10-03):

Laboratory editor

fabien-ors, 2024-10-03:
A graphical user interface (based on QtGui) should be invented for creating or editing a Laboratory.
With the following features:
- List available laboratories
- Add / Edit / Remove a laboratory
- And for each laboratory: Add / Edit / Remove a Thermometer / Pressure Sensor / Shaft
Take care that modifying a Laboratory in the database could impact an existing Study.
The consistency with existing studies and sampling points must be guaranteed in the database.
You may need to prevent the user from deleting something that is currently used in the database.

A first version for this GUI could be envisaged separated from Molonaviz (no database access).
The aim of this first version could be to generate or update the directories and the configuration files that are currently imported in Molonaviz as a Laboratory description.

Thread 44 (2024-10-03):

Temperature unit preference option doesn't work

fabien-ors, 2024-10-03:
Switching between Kelvin or Celcius degrees display doesn't work. Note that this option is a display option only. The database must not be modified when clicking of this option.

Thread 45 (2024-10-03):

Main menu cometic

fabien-ors, 2024-10-03:
Molonaviz top menu should be removed and the menu should be reorganized like that (in that order):

Database
  - Open Database
  - Change Database
  - Quit Molonaviz

Laboratory
  - Import Laboratory
  - Laboratory Editor _(not yet existing)_

Study
  - Create Study
  - Open Study
  - Close Study

Point
  - Import Sampling Point
  - Open Sampling Point
  - Remove Sampling Point _(see issue #30)_

Windows
  - Switch to Tabbed View
  - Switch to SubWindow View
  - Switch to Cascade View
  ------------------------------------
  - Points
  - Sensors _(should be renamed "Laboratory")_
  - Application Messages

Preferences
  - Temperature Unit _(see issue #44)_
  - Mode Sombre _(should be translated to Dark Mode)_

Help
  - About Molonaviz
  - Open Userguide

Thread 47 (2024-10-03):

Add a button to restore "Best Parameters" in Compute dialog

fabien-ors, 2024-10-03:
In the "Compute" dialog, next to "Restore Default" button, we should add a button named "Restore Best Parameters".
This button is active only if an inversion has already been performed. In that case, the `BestParamaters` table has some records for the current sampling point.
When clicked, the direct model parameters displayed at the top of the dialog, are reset to the best ones from the database.
This feature doesn't alter the database. It's only a graphical option.

Thread 50 (2024-10-03):

Impossible to import Virtual lab in MOLONAVIZ

flipoyo, 2024-10-03:
I create a virtual Lab and Sampling Point in $HOME/OUTPUT_MOLONARI1D/generated_files with the ipynb demo_genData.ipynb

I add in VirtualPoint the notice.txt and .jpg and .png from data/Point035

Then I start molonaviz, create a new DB, import the virtual Lab, create a new study.

I then import the Virtual Sampling Point but no point charges in the point area of molonaviz

The only major difference is in Pvirtual where I put intercept to 0, as well as the derivatives (maybe there is a division by zero somewhere ?

flipoyo, 2024-10-03:
very urgent, I want to do a demo wednesday morning. I am in Fontainebleau tomorrow october 4th to discuss the issue
Thx

fabien-ors, 2024-10-04:
I obtain a date conversion issue:
ValueError: Cannot convert dates: No known formats match your data!

The format "01/08/11 12:00:00 AM" in pressure measure files is not known by the function convertDates in general.py.
This should corresponds to "%d/%m/%y %I:%M:%S %p". It is not in the list of known formats.

But adding this format to the list dose not permits to fix the bug.
I continue to investigate

fabien-ors, 2024-10-04:
Possible workaround: Modify your generator to use the same format than Point35:
"%m/%d/%y %I:%M:%S %p"

flipoyo, 2024-10-04:
I found the conversion of voltage into pressure in dialogsCleanup.py:
    def convertVoltagePressure(self):
        """
        Convert the Voltage column into a (differential) Pressure field, taking into account the calibration information.
        This should only be called once, as we'd rather have the user speak in terms of differential pressure than in Voltage.
        """
        self.data["Pressure"] = (
            self.data["Voltage"] - self.data["TempBed"] * self.dUdT - self.intercept
        ) / self.dUdH
        self.data.drop(labels="Voltage", axis=1, inplace=True)

So the values in Ptest are correct and permits to state H = U cause intercept = 0, DuDt = 0 and DuDh=1
This is not the origin of the problem

flipoyo, 2024-10-04:
Your workaround works, i close the issue.

Closed 2024-10-04.

Thread 55 (2024-10-09):

adding the functionnality to test the 1D flow hypothesis

flipoyo, 2024-10-09:
Use Munz paper to check the 1D hypothesis. It will be necessary to add FFT and polygon adjustement

flipoyo, 2024-10-11:
[munz2016_JH_1DFlux.pdf](https://github.com/user-attachments/files/17343003/munz2016_JH_1DFlux.pdf)

alexandrenoel20, 2024-11-15:
methods added to time_series_multiperiodic class, plotting Pearson coef to test whether 1D hypothesis is relevant. Needs to add a clear function (hence a clear criteria) that returns whether 1D hypothesis is relevant or not for a dataset. Issue seems closed to me

Closed 2024-11-15.

Thread 56 (2024-10-09):

Modify the direct model and the mcmc engine to integrate lateral flow

flipoyo, 2024-10-09:
It will be done by adding a flow and heat source term in the column where the 1D hypothesis is not valid

Closed 2024-11-06.

Thread 59 (2024-10-09):

Numerous issues with dark mode

fabien-ors, 2024-10-09:
- Cleanup and Compute dialog switch to dark/light mode only if the option is activated **before** opening the study. In order to make this works, one needs to add a slot in SamplingPointViewer window for toggling dark/light mode and connect that slot to a signal which is emitted each time the user clicks on the "Dark mode" menu.

- Other dialogs are not in dark mode (about, import points, etc...)

- Disabled buttons or menus (like "compute" if no cleaned data) are not distinguishable.

Thread 64 (2024-10-14):

Check and correct 2023 configurationfor temperature

flipoyo, 2024-10-14:
Communication with hardware fails.

Closed 2024-11-15.

Thread 67 (2024-10-14):

building new sensors and calibrate them

flipoyo, 2024-10-14:
Building new pressure sensors and add the calibration law in the virtual lab

flipoyo, 2024-10-14:
Add also a user guide for the climate chamber

Closed 2024-11-29.

Thread 73 (2024-10-18):

clean up the mcmc method in core.py

flipoyo, 2024-10-18:
Merge the mcmc method in core.py, especially with or without sigma. The replication of multiple instructions in different methods is not acceptable.

One way to do is to set sigma2=None when not required (ie by default and add a if sigma2 != None for specificities related to sigma2

flipoyo, 2024-10-21:
please pay attention to issue #90

flipoyo, 2024-10-21:
reprogram compute_mcmc  merging the 3 methods compute_dream_mcmc_without_sigma2, compute_mcmc_with_sigma2, compute_mcmc_without_sigma2.
The two last ones are a specific case of the first one.
The new method should be able to handle multiple MCMC. First, there is a burning phase for each chain. Then each iteration is divided into:
1 perturbation of the param sample
2  forward modelling
3 energy calculation
4. acceptance of the proposal
5. initialization of the prior for next step
6. storage of the forward models according to subsampling (iteration subsampling)

Once finished the last step is the quantile calculation

Please note that for the burning phase the perturbation is a classic random walk i think not using the DREAM perturbation, to be validated by thomas romary

tromary, 2024-10-22:
Actually, the dream perturbation is performed from the beginning. It helps entering faster the stationary regime, hence reducing the burn-in phase.

Closed 2024-11-15.

Thread 74 (2024-10-18):

replace class Time_series by class synthetic_MOLONARI

flipoyo, 2024-10-18:
In pyheatmy, the name of the class Time_series is inappropriate because it is not a time series. We must create a proper class time series in the src.
The current issue consist in replacing the class time_series by synthetic_MOLONARI, and rename time_series.py in synthetic_molonari.py. This is a refactoring task

Please think about modifying the 2 jupyter notebooks in pyheatme/research/generate_synthetic_case studies

Thread 81 (2024-10-18):

Problème de type lors du run de demo_val_direct

alexandrenoel20, 2024-10-18:
Problème de type dans l'ajout d'une perturbation à ts lors de l'initialisation des paramètres de Synthetic_MOLONARI (anciennement Time_series). Facile à résoudre (pour Martin)

Thread 90 (2024-10-21):

rename variables nb_layer, ncr in  compute_dream_mcmc_without_sigma2() in core.py

flipoyo, 2024-10-21:
the names are not explicit and confusing.
nb_layers is the number of MCMC.
ncr may be the number of chain that are used to mix the parameter proposals.
This is a refactoring.
I must also add vrugt in Moodle

Closed 2024-11-06.

Thread 93 (2024-10-21):

Creation of a notebook to verify whether temperature amplitude ratio is linear (or else) for purely diffusive case

alexandrenoel20, 2024-10-21:
Work on the 1D hypothesis - first step

alexandrenoel20, 2024-11-15:
done and implemented in research, using time_series_multiperiodic class methods

Thread 106 (2024-10-23):

Simplification of interactions between classes layers and priors

aurelie-cmyk, 2024-10-23:
By looking at layers.py and params.py we see multiple multiplication of the methods sample, perturb

MartinJessenne, 2024-10-25:
By factorizing Layers into being an attribute of the monolithic class Column, we can simplify the code and the calling of the different methods, at the expense of slightly modifying the way we define the column instances in the different notebooks. Namely by integrating the instances of the layers into the instance of the column, rather than making computation with two distinct objects evolving in parallel as it was the case before with the All_priors class.

Thread 107 (2024-10-25):

Cleaning Synthetic molorari with a verbose

colindrouineau, 2024-10-25:
Adding a verbose option to choose whether or not to print dictionary features and plot temperature(time) graphs in synthetic Molonari init and methods.

colindrouineau, 2024-10-25:
Corrected in branch [2024-94-adding_verbose_to_synthetic_molonari]

Closed 2024-10-25.

Thread 108 (2024-10-25):

create a monolithic class estimate that encompasses the inversion problem and the column

flipoyo, 2024-10-25:
Create a Monolithic class Estimate that will handle the inversion complexity MULTI CHAIN, MCMC, FORWD MODEL and possibly multiple columns

Estimate, also handles the parameters

Closed 2024-11-29.

Thread 116 (2024-10-30):

Errors in date allocation for points 46, 47, 48 of data_traité

alexandrenoel20, 2024-10-30:
some dates switch from %d-%m to %m-%d and reciprocally, makes it impossible to compute convertDates function for those point (hence we can note process MCMC for those points...)

alexandrenoel20, 2024-11-04:
waiting for pull request to be accepted, date allocation changed to days-month-years (enabling convertDates function to compute on those data)

Closed 2024-11-04.

Thread 118 (2024-10-30):

pb with resampling when using dream for a single MCMC

flipoyo, 2024-10-30:
pb if we want to use MCMC as a single case of DREAMS. In this case pb with delta = 0 because nb chains = 1

Closed 2024-11-15.

Thread 121 (2024-11-04):

introducing a non-uniform heat source

bonbonblond, 2024-11-04:
In branch 77, we introduced a heat source that is uniform in our column. We want it to be more complex, thus not uniform.

flipoyo, 2024-11-04:
Before doing that, please close the other issues linear system, introduce heat source, with proper pull requests

flipoyo, 2024-11-04:
Another step before programming non uniform heat source is to elaborate an assessment of the new software performances, with and without q for the inversion.

bonbonblond, 2024-11-06:
With the hypothesis that the lateral flow is moving from the column to the exterior.

Thread 124 (2024-11-04):

print sigma2 for mcmc with sigma2 obs

flipoyo, 2024-11-04:
as requested

Closed 2024-11-04.

Thread 125 (2024-11-04):

reintroduce burning for single chain MCMC

flipoyo, 2024-11-04:

Closed 2024-11-15.

Thread 131 (2024-11-06):

In plot_umbrella (core.py) the temperature is plotted in K but it is labelled in °C

bonbonblond, 2024-11-06:

StevenHurJim, 2024-11-15:
It was added in the issue temperature_at_sensors

Closed 2024-11-15.

Thread 134 (2024-11-08):

But : simuler exactement les conditions expérimentales et vérifier que seul le terme source peut expliquer la linéarité.

colindrouineau, 2024-11-08:
Tester de nouveaux cas et vérifier qu'il y a linéarité :

- amplitude sur une semaine avec un signal linéairement croissant
- signal qui vient de l'aquifère (l'aquifère peut-il avoir un signal à lui ? Mais avec modèle...)
- multi layer avec 2 couches

Puis : en collaboration avec le groupe terme source :
- voir si un terme source fait un truc non linéaire

alexandrenoel20, 2024-11-15:
Still work to do I guess, need to enhance the methods codded, maybe adding a definition of amplitude using Fourier Transformation. GL

Thread 136 (2024-11-08):

créer un fichier de test couplant demoGenData et demoPyHeatMy

bonbonblond, 2024-11-08:
Ce fichier permettrait de savoir si notre inversion est fonctionnelle en générant un jeu de données dont on connaîtrait les caractéristiques, et en les retrouvant (ou non) par l'inversion.

Closed 2024-11-15.

Thread 151 (2024-11-15):

Issue with the dependency of viscosity to water temperature

MartinJessenne, 2024-11-15:
Line 39 linear_system.py

Thread 154 (2024-11-15):

Pb with demoInversion.ipynb

flipoyo, 2024-11-15:
PR#150 closed too quickly

flipoyo, 2024-11-18:
i debugged the main. The two last cells of demoInversion.ipynb do not work. It is the link with demo_genData.ipynb
@bonbonblond please correct

bonbonblond, 2024-11-29:
Bonjour Monsieur,

J’étais en semaine ATHENS la semaine dernière et n’ai donc pas vu vos messages. J’ai regardé, et les erreurs étaient du à des merges faits après notre pull request dans la branche principale. Ce genre de problèmes pourrait être évité en mettant demoInversion dans les conditions de code à valider pendant les pull request, car sinon les nouveaux changements ne sont pas intégrés à demoInversion.
J’ai adapté les parties du code qui avaient changé, mais il reste un problème : la fonction de Column « get_best_params » ne fonctionne plus (sa sortie est juste None). J’ai mis en commentaire la ligne de code qui comparait les paramètres réels et ceux estimés, les graphiques au dessus permettant déjà de voir si l’inversion fonctionne. En effet, je n’ai pas travaillé sur get_best_params donc je ne sais pas pourquoi la fonction ne fonctionne plus.
J’ai fait un pull request.

Bonne journée,

Ombline

Le 18 nov. 2024 à 17:35, Nicolas Flipo ***@***.***> a écrit :

i debugged the main. The two last cells of demoInversion.ipynb do not work. It is the link with demo_genData.ipynb
@bonbonblond<https://github.com/bonbonblond> please correct

—
Reply to this email directly, view it on GitHub<https://github.com/flipoyo/MOLONARI1D/issues/154#issuecomment-2483548489>, or unsubscribe<https://github.com/notifications/unsubscribe-auth/BCLN5OLOVZXSKEDZRVZAWJT2BIJO3AVCNFSM6AAAAABR3UP34SVHI2DSMVQWIX3LMV43OSLTON2WKQ3PNVWWK3TUHMZDIOBTGU2DQNBYHE>.
You are receiving this because you were mentioned.Message ID: ***@***.***>

Closed 2024-11-29.

Thread 158 (2024-11-21):

Update and Reorganise hardware Programming documentation with MOLONARI2024 work

flipoyo, 2024-11-21:
The documentation section of hardware Programming is very unclear.
Files 1 to 6 must be reorganised for allowing a clear understanding of how to make MOLONARI hardware work.
A README file must be added to Documentation to explain what is contained in each file of the documentation. This file must be 1_getting started. It explained the building of the hardware is explained in 2_hardwareBuilding.md, the programming of the riverbed device is explained in 3_Riverbedhardware (you can create there subsection for the clock, the sending of the signal, the activation of the sensors, the organisation of the data....), and the relay functionning is explained in 4_relay. Finally the connexion to the gateway and the connection to the server should be explained in 5_backup in server.

The current files should be reorganise to match in the new structure

Closed 2024-12-02.

Thread 159 (2024-11-21):

Provide Field data 2024

flipoyo, 2024-11-21:
Please provide the field data of 2024.
The calibration law of the pressure sensor must also be provided in the data section as well as the png file

flipoyo, 2024-11-29:
please verify IPT in the svg files of point2024-1 and 2024-2.
I am adding Agnès Rivière to the checking process

Closed 2024-12-02.

Thread 172 (2024-12-04):

Verify param distribs from multi-chain MCMC

flipoyo, 2024-12-04:
Not sure that we plot the distrib for all chains. It can be only one chain. To be checked

Thread 176 (2025-03-27):

refactoring hardware programming in an object oriented manner

flipoyo, 2025-03-27:
see in the title

flipoyo, 2025-03-27:
Idea create a

class digital sensor

arguments
connection pin (A1, A2, ....)
powering pin (1)
type 0(pressure), 1 (temperature)

Idee classe conversion law recoit le mesurande secondaire et renvoie le mesurande primaire
class conversionLaw2paramLinear
offset
slope

class conversionLaw2parameterExponential
multiplicateur
attenuation

class noConversion (mesurande secondaire directe)

Nota pour la pression:
On doit toujours commencer par mesurande secondaire. On pourrait imaginer ensuite configurer les capteurs avec un fichier sur carte SD qui permettrait de définir une loi lineaire à 2 param pour transformer U en P sans integrer T, puis une loiDeconversion 3param bilineaire qui integre une temperature interne.

Question ouverte quel est le cout energetique du calcul de la mesurande primaire versus mesurande secondaire seule ?

flipoyo, 2025-03-27:
repartir du fichier Sensor_demo.ino dans Demo

Closed 2025-05-13.

Thread 177 (2025-05-13):

Error in CI due to sigma estimate in pyheatme

flipoyo, 2025-05-13:
I comment the lines concerning the sigma estimates in the jupyter notebook demoPyheatme.ipynb
I think this is a problem of initial estimate of sigma that leads to NaN values, but not sure about it.

[test-job (macos-latest, 3.11, pyheatmy)](https://github.com/flipoyo/MOLONARI1D/actions/runs/14104509531/job/39507876670#logs)
failed on Mar 27 in 2m 13s
Search logs
1s
3s
1s
8s
18s
14s
1m 22s
Run pytest --nbmake --nbmake-timeout=600 \
============================= test session starts ==============================
platform darwin -- Python 3.[1](https://github.com/flipoyo/MOLONARI1D/actions/runs/14104509531/job/39507876670#step:7:1)1.9, pytest-8.3.5, pluggy-1.5.0
rootdir: /Users/runner/work/MOLONARI1D/MOLONARI1D/pyheatmy
configfile: pyproject.toml
plugins: nbmake-1.5.5
collected 2 items

pyheatmy/demoPyheatmy.ipynb F                                            [ 50%]
pyheatmy/demo_genData.ipynb .                                            [100%]

=================================== FAILURES ===================================
_____ /Users/runner/work/MOLONARI1D/MOLONARI1D/pyheatmy/demoPyheatmy.ipynb _____
---------------------------------------------------------------------------
nb_chains=1

col.compute_mcmc(verbose=True, nb_chain = nb_chains, typealgo="estimesigma")

col.get_best_layers()
col.compute_solve_transi(verbose=False)
col.plot_all_param_pdf()
col.plot_all_results()
col.plot_darcy_flow_quantile()
col.plot_quantile_temperatures_sensors()
---------------------------------------------------------------------------
ValueError                                Traceback (most recent call last)
Cell In[22], line 3
      1 nb_chains=1
----> 3 col.compute_mcmc(verbose=True,nb_chain=nb_chains,typealgo="estimesigma")
      5 col.get_best_layers()
      6 col.compute_solve_transi(verbose=False)

File ~/work/MOLONARI1D/MOLONARI1D/pyheatmy/pyheatmy/checker.py:47, in checker.<locals>.wrapper.<locals>.new_wrapper(*args, **kwargs)
     44 @wraps(checked_meth)
     45 def new_wrapper(*args, **kwargs):
     46     setattr(self, chkd_name, True)
---> 47     return checked_meth(self,*args,**kwargs)

File ~/work/MOLONARI1D/MOLONARI1D/pyheatmy/pyheatmy/core.py:1185, in Column.compute_mcmc(self, quantile, verbose, typealgo, sigma2, nb_iter, nb_chain, nitmaxburning, delta, n_CR, c, c_star, n_sous_ech_time, n_sous_ech_space, threshold)
   1182     init_sigma2_temp = sigma2_temp_prior.sample()
   1184     # on lance le modèle direct et on stocke les résultats dans la classe state
-> 1185     self.compute_solve_transi(verbose=False)
   1186     self._states.append(
   1187         State(
   1188             layers=self.get_list_current_params(),
   (...)   1197         )
   1198     )
   [12](https://github.com/flipoyo/MOLONARI1D/actions/runs/14104509531/job/39507876670#step:7:13)00 # on garde uniquement le meilleur état

File ~/work/MOLONARI1D/MOLONARI1D/pyheatmy/pyheatmy/checker.py:47, in checker.<locals>.wrapper.<locals>.new_wrapper(*args, **kwargs)
     44 @wraps(checked_meth)
     45 def new_wrapper(*args, **kwargs):
     46     setattr(self, chkd_name, True)
---> 47     return checked_meth(self,*args,**kwargs)

File ~/work/MOLONARI1D/MOLONARI1D/pyheatmy/pyheatmy/core.py:652, in Column.compute_solve_transi(self, verbose)
    650 print(f"Issue for the following parameters : {self.get_list_current_params()}")
    651 print(f"Issue for the follwing number of layers : {len(self.all_layers)}")
--> 652 raise ValueError("NaN values in compute_solve_transi")

ValueError: NaN values in compute_solve_transi
----------------------------- Captured stderr call -----------------------------
/Library/Frameworks/Python.framework/Versions/3.11/lib/python3.11/multiprocessing/resource_tracker.py:254: UserWarning: resource_tracker: There appear to be 1 leaked semaphore objects to clean up at shutdown
  warnings.warn('resource_tracker: There appear to be %d '

* nbmake: Automate reading GitHub Actions logs with our bot: https://github.com/marketplace/treebeard-build

=========================== short test summary info ============================
FAILED pyheatmy/demoPyheatmy.ipynb::demoPyheatmy.ipynb - ValueError: NaN values in compute_solve_transi
==================== 1 failed, 1 passed in 81.99s (0:01:[21](https://github.com/flipoyo/MOLONARI1D/actions/runs/14104509531/job/39507876670#step:7:22)) ====================
Error: Process completed with exit code 1.

Thread 181 (2025-05-20):

Impossible to access the SDCard in Senso_demo.ino

flipoyo, 2025-05-20:
Aurélien : J'ai bien récupéré la branche 176, je charge dans la carte mais au lancement , j'ai l'erreur initialisation de la carte
Initialising SD card ... Failed
(Je l'inserts vide)

Thread 191 (2025-09-10):

emulates the MOLONARI1D LoraWan receiver in python

flipoyo, 2025-09-10:
From the newly developed pyheatmy/pyheatmy/lora_emitter.py creates a lora_receiver.py that receive the paquet transmitted by lora_emitter.py add its receiving timestamp to the dataflux and emits the updated package again with the LoraWan protocole towards the gateway. I also want to mimic in the POC the data transmission between the emitter and the receiver following the LoRaWan protocole and couple it with a mqtt approach if posible with arduino-based hardware.

Thread 193 (2025-09-10):

as an alternative to mqtt emulates in python the current Lora protocole between sensor and relay

flipoyo, 2025-09-10:
On top of the mqtt protocole, i would like to emulate in python the communication protocole currently followed by the arduino sensor and relay as implemented in Device/hardwareProgramming/'Tests Codes'/Relay_Lora and Sensor_Lora

Thread 195 (2025-09-11):

Reorganize the repo for a better ergonomy of the repo, especially for developpers and fablabs

flipoyo, 2025-09-11:
@copilot based on your instructions please propose a better organization of the repos oriented towards an easier co-development of the MOLONARI ecosystem by scientific computing team, hardware developpers, data security and quality, communication protocoles. Especially for the hardware programming restructure the internals among sub projects, and correct the arduino programs. Add CI for hardware programming, and transmission protocole. Don't forget to update the README.md or README.ipynb step by step. Report further initiatives that i would have forgotten
