flipoyo/MOLONARI1D/hardware/specs/v1-until-2024/distributedTemperatureSensor/shaft_2024version/TemperatureShaftDimension.pdf

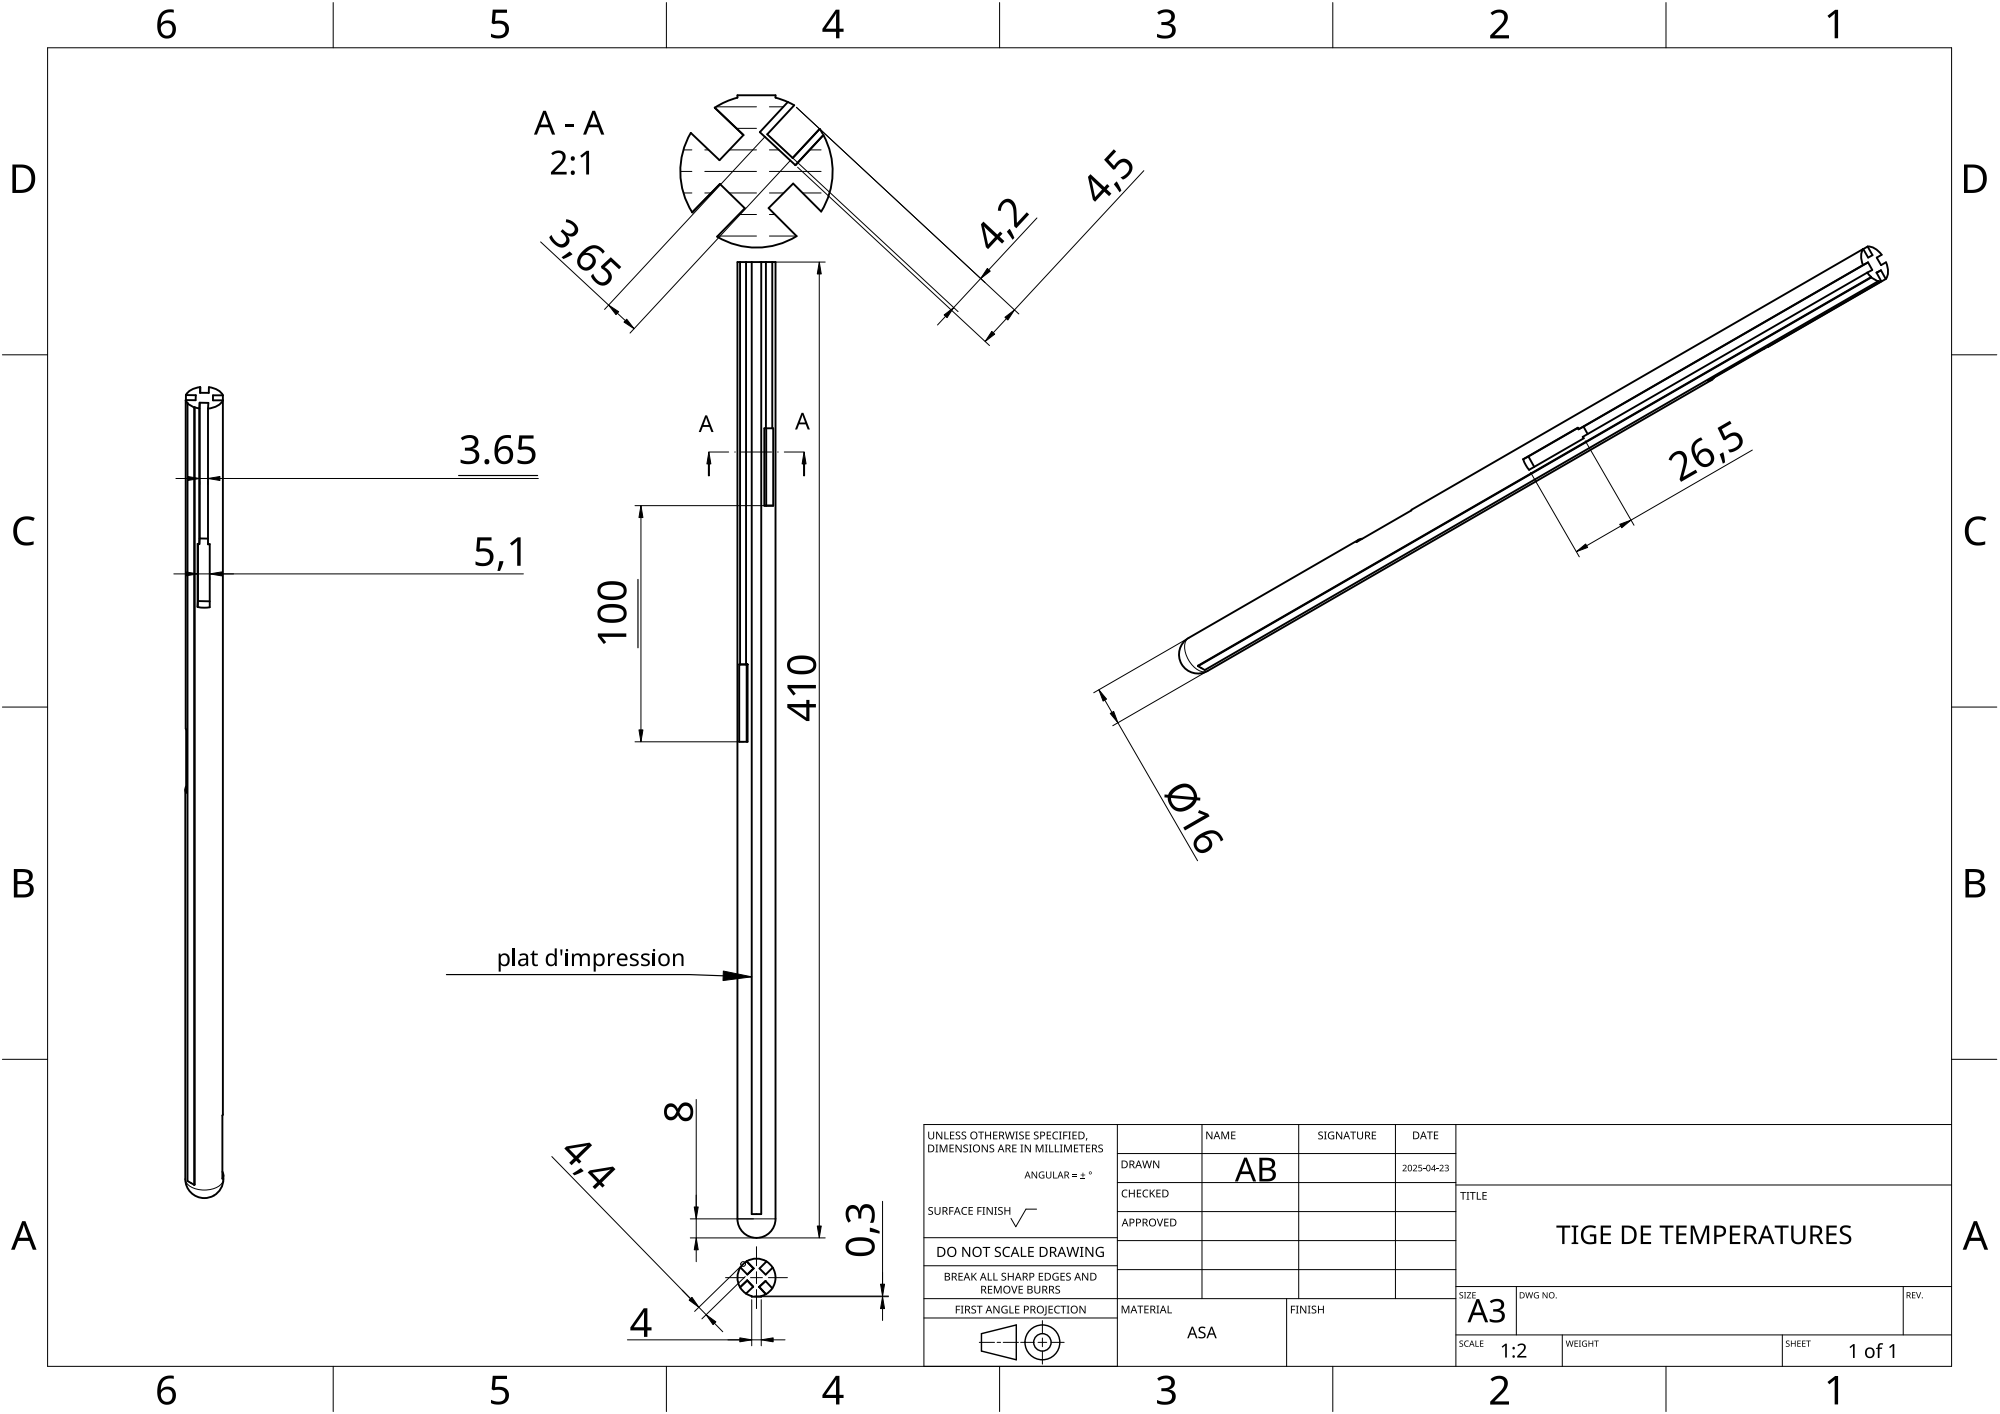
[picture p213: page 1]
