flipoyo/MOLONARI1D/hardware/shared/Writer.cpp

// This file defines the Writer class, which is used to write a serie of measurements to a CSV file.
// See internals/Writer.hpp for the class declarations.

// Check that this file is included only once
#ifndef WRITER_CLASS
#define WRITER_CLASS

#include "Writer.hpp"
#include "Time.cpp"

#include <String.h>
#include <SD.h>

#ifdef SD_DEBUG
#define SD_LOG(msg) Serial.print(msg)
#define SD_LOG_LN(msg) Serial.println(msg)
#else
#define SD_LOG(msg)
#define SD_LOG_LN(msg)
#endif

// Define a comma string for separating CSV columns
const String COMA = String(',');

// GetNextLine function: Returns the number of lines in the CSV file, representing the next ID.
// SHOULD BE CALLED ONLY ONCE to initialize next_id
unsigned int GetNextLine() {
  // TODO : Now, the function counts the number of lines. It would be more stable if it got the index of the last measurement.

  File readInfile = SD.open(filename); // Open the CSV file in read mode
  unsigned int number_of_lines = 0; // Counter for the lines
  if (readInfile) {
    while (readInfile.available()) {
      // read an entire csv line (which end is a \n)
      if (readInfile.read() == '\n') {
        number_of_lines++;
      }
    }
  }
  readInfile.close();
  return number_of_lines;
}

// ApplyCurrentTime function: Sets the current date and time in the Measure object
void ApplyCurrentTime(Measure* measure) {
    GetCurrentHour().toCharArray(measure->time, 9);
    GetCurrentDate().toCharArray(measure->date, 11);
}

//Class methods

// WriteInNewLine: Writes a new line to the CSV file with all the fields from a Measure object
void Writer::WriteInNewLine(Measure data){
    
    SD_LOG("Writing data ..."); // Debug log
    // Write measurement data as a single CSV line
    this->file.println(String(data.id)+ COMA + data.date + COMA + data.time + COMA + String(data.chanel1) + COMA + String(data.chanel2) + COMA + String(data.chanel3) + COMA + String(data.chanel4));
    SD_LOG_LN(" Done");

    SD_LOG("Flushing ..."); // Ensure data is saved immediately
    this->file.flush();
    SD_LOG_LN(" Done");
}

// ApplyContent: Fills a Measure object with raw data values for each channel
void Writer::ApplyContent(Measure* measure, MEASURE_T mesure1, MEASURE_T mesure2, MEASURE_T mesure3, MEASURE_T mesure4) {
    measure->chanel1 = mesure1;
    measure->chanel2 = mesure2;
    measure->chanel3 = mesure3;
    measure->chanel4 = mesure4;
}

// Reconnect: Attempts to re-establish connection to the SD card and reopen the CSV file in write mode
bool Writer::Reconnect() {
    this->file.close();
    if (!SD.begin(this->CSPin)) {
        return false;
    }
    this->file = SD.open(filename, FILE_WRITE);
    return this->file;
}


// EstablishConnection: Sets up initial connection to SD card and prepares file for writing
void Writer::EstablishConnection(const int CSpin) {
    this->CSPin = CSpin;
    this->next_id = GetNextLine();
    this->file = SD.open(filename, FILE_WRITE);
}

// LogData: Processes raw data, applies a timestamp, and writes it to the CSV file as a new entry
void Writer::LogData(MEASURE_T mesure1, MEASURE_T mesure2, MEASURE_T mesure3, MEASURE_T mesure4) {

    // Create a new Measure object
    Measure data;
    this->ApplyContent(&data, mesure1, mesure2, mesure3, mesure4); // Assign channel values
    ApplyCurrentTime(&data); // Assign current time and date
    data.id = this->next_id; // Set unique ID for the measurement

    // Check if the connection is still established
    bool is_connected = SD.begin(this->CSPin) && this->file;
    if (!is_connected) {
        SD_LOG_LN("SD connection lost.");
        SD_LOG_LN("Trying to reconnect ...");
        
        // Try to reconnect if lost
        is_connected = this->Reconnect();
        if (!is_connected) {
            SD_LOG_LN("Connection could not be established."); // Log failure if reconnect fails
            return; // Exit if reconnection fails
        }
    }

// Write data if connected
    if (is_connected) {
        this->WriteInNewLine(data); // Write data to a new CSV line
    }
    this->next_id++; // Increment ID for next measurement
}

// Dispose: Closes the connection to the CSV file, releasing the file resource
void Writer::Dispose() {
    this->file.close();
}

#endif
