flipoyo/MOLONARI1D/hardware/shared/FreeMemory.cpp

// Contains a function to measure the amount of RAM available on the Arduino
// TEST FILE FOR DEBUGGING PURPOSES ONLY

#ifdef __arm__
// should use uinstd.h to define sbrk but Due causes a conflict
extern "C" char* sbrk(int incr);
#else  // __ARM__
extern char *__brkval;
#endif  // __arm__

// Returns the number of bytes available on the RAM
int freeMemory() {
  char top;
#ifdef __arm__
  return &top - reinterpret_cast<char*>(sbrk(0));
#elif defined(CORE_TEENSY) || (ARDUINO > 103 && ARDUINO != 151)
  return &top - __brkval;
#else  // __arm__
  return __brkval ? &top - __brkval : &top - __malloc_heap_start;
#endif  // __arm__
}
