flipoyo/MOLONARI1D/hardwareProgramming/Mesures consomation electrique/Programmes de test/Radio_Reset/Radio_Reset.ino

#include <LoRa.h>
#include <ArduinoLowPower.h>

void setup() {
  // put your setup code here, to run once:
  LoRa.begin(868E6);
  LoRa.end();

  pinMode(LORA_RESET, OUTPUT);
  digitalWrite(LORA_RESET, LOW);
  
  LowPower.deepSleep();
}

void loop() {
  // put your main code here, to run repeatedly:
}
