flipoyo/MOLONARI1D/hardwareProgramming/Mesures consomation electrique/Programmes de test/Transmission_Lora/Transmission_Lora.ino

#include <SPI.h>
#include <LoRa.h>

int counter = 0;

void setup() {
  pinMode(LED_BUILTIN, OUTPUT);

  Serial.begin(9600);
  delay(4000);

  digitalWrite(LED_BUILTIN, HIGH);
  delay(1000);
  digitalWrite(LED_BUILTIN, LOW);

  Serial.println("LoRa Sender");

  if (!LoRa.begin(868E6)) {
    Serial.println("Starting LoRa failed!");
    while (1);
  }
}

void loop() {
  Serial.print("Sending packet: ");
  Serial.println(counter);

  // send packet
  digitalWrite(LED_BUILTIN, HIGH);
  LoRa.beginPacket();
  LoRa.print("hello ");
  LoRa.print(counter);
  LoRa.endPacket();
  digitalWrite(LED_BUILTIN, LOW);

  counter++;

  delay(5000);
}
