flipoyo/MOLONARI1D/(commit log)

2023-06-13 Initial repository
    [2022S1.csv, 2022T1.csv, P001.csv, P002.csv, P051-1.csv, P051-2.csv, P505.csv, P508.csv]
2023-09-21 Adding hardwareProgramming from https://github.com/wisskarrou/Arduino-capteurs-molonari
2023-10-21 colorbar + axes réparés pour les graphes2D
2023-10-22 graphe+sauvegarde labo
    [defaults.csv]
2023-10-25 Low power
2023-10-25 propagation erreur de mesure et suppression redondance du cas homogène
2023-10-25 Tweak low power
2023-10-25 suppression de lignes de codes inutilisées
2023-10-25 graph de température : récupération des données des capteurs. Il faut régler l'affichage.
2023-10-25 Mesure de temperature
2023-10-25 affichage des données de température des capteurs avec le modèle direct
2023-10-27 formatage et déplacement de certaines fonctions
2023-10-27 ajout de dream mcmc v0, pas d'intégration dans la fonction compute_mcmc
2023-10-27 zone de transition entre les strates
2023-10-27 correction de problèmes mineurs
2023-10-30 fin pb affichage sensors
2023-10-30 problème lié à la fermeture de l'appli réglé, seulement, celle-ci ne répond plus lorsqu'on la ferme.
2023-10-30 implémentation v0 de la classe State au sein de DREAM
2023-10-30 déplacement de fonctions vers utils.py
2023-10-30 ajout de commentaires
2023-11-03 intégration de DREAM dans compute_mcmc
2023-11-03 correction de bug dus au merge
2023-11-03 Revert "Merge branch 'main' of https://github.com/flipoyo/MOLONARI1D"
    This reverts commit 6dba99359fe77d1652d1b70d164a3d115a251b7c, reversing
    changes made to 5dcd48bdddbaf084ac04562431612cdac88213a3.
    [defaults.csv]
2023-11-03 Switch to ReadFromLoRa general function
2023-11-06 conversion de la température en degrés Celsius avec voltage carte finale
2023-11-08 fix le bug du changement de database
    [dialogOpenDatabase.py]
2023-11-08 link writer - time (does not work)
    [Reader.cpp, Time.cpp, Writer.cpp]
2023-11-08 fixed SD reconnection (to test)
    [Riviere_2023.ino, Writer.cpp]
2023-11-08 fenêtre d'import de point de mesure plus pratique
2023-11-08 Object oriented temperature sensor
2023-11-10 Ajout d'un titre au graph de flux d'eau
2023-11-10 export Data
    [cleanedPressuresPoint035.csv, cleanedTemperaturesPoint035.csv, defaults.csv]
2023-11-10 Bugfixes : RTC disabled and wrong measure ID
    [Reader.cpp, Riviere_2023.ino, Time.cpp]
2023-11-10 Addind calibration informations of pressure datalogger 051-1 and 052-2 used in 2022
    [P051-1.csv, P051-2.csv]
2023-11-10 Adding the raw data acquired during MOLONARI 2021 and 2022 editions: 047, 051-1 and 051-2
    [Point034_info.csv, Point047_info.csv, Point051-1_info.csv, Point051-2_info.csv, point034_P_measures.csv, point034_T_measures.csv, point047_P_measures.csv, point047_T_measures.csv]
2023-11-10 Low power overhaul
2023-11-10 Low power with header file
2023-11-11 délocalisation de fonctions dans utils.py
2023-11-13 Revert "Lora rewrite draft"
    This reverts commit c6f6fba38f8bac2bcaabdef253ba1f52a13e0b10.
    [Lora.cpp, Lora.hpp, Time.cpp]
2023-11-13 Rename flag to avoid conflicts
    [Time.cpp]
2023-11-15 Prepared relay for demonstration
2023-11-15 Prepare sensor firmware for demonstration
2023-11-15 Print macro renamed to Log
2023-11-15 Lora protocol stability enhancement
    [Lora.cpp, Rive_2023.ino, Riviere_2023.ino]
2023-11-15 MEASURE macro for the relay
2023-11-15 Bugfix : Corrected the index of the first measurement
    [Rive_2023.ino]
2023-11-15 Waiter for relay
2023-11-16 Solved RTC calibration issue
    [Time.cpp]
2023-11-16 fix (pls pls pls) reader
    [Reader.cpp]
2023-11-17 Relay caching
2023-11-17 Relay not using interrputs
2023-11-17 Sensor firmware with no interrupts & measure caching
2023-11-17 ajout notice et résultats de conso
2023-11-17 Adding new folders research, sensorCalib and dataAnalysi
2023-11-17 rename template into data
    [P001.csv, P002.csv, P051-1.csv, P051-2.csv, P505.csv, P508.csv, P520.csv, P531.csv]
2023-11-17 Update and rename data/Laboratory/pressure_sensors/sensorCalibration/apoub.txt to data/Laboratory/pressure_sensors/READ ME.txt
2023-11-17 Adding data Points 52 and 53 acquired in 2023
    [p529_06_11_23.csv, p538_06_11_23.csv, t529_06_11_23.csv, t538_06_11_23.csv]
2023-11-17 Mise en place côté émetteur dans la doc
2023-11-17 ajout fichiers terrains 2023
    [BOISSY-METEO_OCT.csv, Data_meteo.xlsx, P001.csv, P002.csv, P052.csv, P053.csv, P505.csv, P506.csv]
2023-11-17 rename data_analysis into dataAnalysis
    [BOISSY-METEO_OCT.csv, Data_meteo.xlsx, P001.csv, P002.csv, P052.csv, P053.csv, P505.csv, P506.csv]
2023-11-17 avancement notice : insérer les schémas
2023-11-18 Relay firmware cleaning and commenting
2023-11-18 Sensor firmware final adjustments
2023-11-18 Rapport sur les mesures de consommations
2023-11-22 final merge ?
    [2022S1.csv, 2022T1.csv, BOISSY-METEO_OCT.csv, Data_meteo.xlsx, P001.csv, P002.csv, P051-1.csv, P051-2.csv]
2023-11-29 cleaning up unecessary files such as __pycache__
    [pyvenv.cfg]
2023-11-29 Adding templateGV in data for a functional lab import in MolonaviZ
    [P001.csv, P002.csv, P505.csv, P508.csv, P520.csv, P531.csv, P533.csv, Point035_info.csv]
2024-09-03 Modifying data to fit with MOLONARI API
    [P001.csv, P002.csv, P051-1.csv, P051-2.csv, P505.csv, P508.csv, P520.csv, P531.csv]
2024-09-13 Molonaviz: Reinitialize threads
2024-09-27 rorganising the MOLONARI 2022 work and cleaning up the associated ipynb
    [defaults.csv]
2024-09-27 cleaning Labo2023 which was not working
    [P001.csv, P002.csv, P051-1.csv, P051-2.csv, P505.csv, P508.csv, P520.csv, P531.csv]
2024-09-27 Creation of demo_ge,Data.ipynb. It uses the methods of time_series and column classes from core.py and gen_test.py respectively. The global printing function of a column class (col.plot_CALC_results(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
2024-09-27 visualisation fonctions in column , exemple flows = col.get_flows_solve() unitLeg="m/s" title="Débits" col.plot_it_Zt(flows,title,unitLeg,1.04,2) Pb in demo_genData K is not accounted for
2024-09-30 Adding multiple methods in column (pyheatmy, core.py) to print a synthetic datasets of processed pressure head differences and temperature. Needs to be added to the API. Watch, multiple bugs in gen_t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
2024-09-30 Pyheatmy in core.py implementation of plot of temperature at sensors in the column class. creation of a periodic signal in utils.py. It is still bugged
2024-10-01 synthetic case generator works based on core.py and gen_test.py. demo_genData.ipynb is available in src/research. Few others ipynb need to be cleaned up
2024-10-01 refactoring temps replaced by temperatures when needed. This is a very boring refactoring but needed to avoid confusion. demo2023.ipynb still works as well as demo_genData.ipynb
2024-10-01 partial fix of issue #19 intrinsec k was used instead of K for water flows calculation in mono and multilayer configuration. The multilayer matrix was properly filled. I don't know yet the monolayer.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
    [dialogCompute.py]
2024-10-03 new generic printing facilities. Removal of demo_cas_test.ipynb and demo_gen_test.ipynb, both replaced by demo_genData.ipynb in research/synthetic_cases_generator
2024-10-03 -b NF printing virtual lab and Sampling point from Column
2024-10-03 minor bug in print virtual lab. It seems that I still have pb in molonaviz with the shaft at importation and also with the data P and T
2024-10-03 shaft is now properly printed, Printing properly P and T remains
2024-10-04 Fix issue #50 it was a false date format in print_in_file_processed_MOLONARI_dataset(), ''%d/%m/%y %I:%M:%S %p' changed in %m/%d/%y %I:%M:%S %p'
2024-10-09 Reloading direct parameters from the database (and fix Porosity and Thermal Conductivity)
    [SamplingPointViewer.py, dialogCompute.py]
2024-10-09 Good values when update layer + restore OK + delete params from db if reset
    [dialogCompute.py]
2024-10-09 Fix "mode sombre" in compute dialog + save params cleanup
    [SamplingPointViewer.py, dialogCompute.py, dialogsCleanup.py, subWindow.py]
2024-10-11 Fix MCMC parameters IO in database
    [SamplingPointViewer.py, dialogCompute.py]
2024-10-18 Change in the values printed during object init, to get along with class new name
2024-10-18 create userguide for climate chamber
2024-10-18 Création d'un fichier system_linear permettant l'initialisation des matrices de l'équation de diffusion et de l'équation de la chaleur.
2024-10-18 Storing calibration coefficients by adding two member variables to the TemperatureSensor class, which allows you to initialize them according to the needs of different sensors.
2024-10-21 update climate chamber parametre calculation
2024-10-21 last commit - function convert period to second added to the code - time in seconds, Temperature in celsius degree
2024-10-21 ajout du terme source dans les classes H_stratified et T_stratified du fichier système linéaire, ajout du terme source dans l'intialisation de la classe Column du fichier core
2024-10-21 using create_periodic_signal from utils date in x-axis
2024-10-23 Temperature decay simulation
2024-10-23 object column with multi_periodic signal as River Temperature
2024-10-23 profile temperature for a multiperiodic river temperature - without output
2024-10-23 From temperature matrices with different values of K, plot linear regression of ln(A_z / A_0) to assess the linearity even in diffusive cases
2024-10-23 adding functions and tests to plot log of temperature amplitude ratio
2024-10-23 The measurement time and low power mode are optimized. The sensor can now take measurements every 15 minutes, entering a low-power mode between two measurements to save power. Open LoRa at midnight e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
2024-10-23 Some corrections of last commit
    [Riviere_2023.ino, Time.cpp, Waiter.hpp]
2024-10-25 Suppression des fichiers DREAM.ipynb
2024-10-25 Version finale de la semaine, toujours buggée, mais avec un terme source provisoire dans Column
2024-10-28 Début du débuggage de MCMC
2024-10-28 recuperation de .gitignore du main
2024-10-30 added heat source and modified params, layers, core and utils
2024-10-30 Commit intermédiaire non fonctionnel pour permettre l'ajout d'un terme source et la discussion
2024-10-30 nouvelle fonction compute_mcmc_DREAM et notebook pour la tester, avec sigma2 pas encore optimal
2024-10-30 Commit intermédiaire - tri des arguments des classes de linear_system
2024-10-30 Commit intermédiaire pour introduire le heat-source dans l'inversion bayésienne
2024-10-30 Résolution des bugs de l'inversion bayésienne
2024-10-30 Échec du commit, essai de réduction de la taille des fichier
2024-10-30 creation of new files with formatted data on dates, ready to compute convertDates function
    [new_point46_pression_traité.csv, new_point46_temperature_traité.csv, new_point47_pression_traité.csv, new_point47_temperature_traité.csv, new_point48_pression_traité.csv, new_point48_temperature_traité.csv]
2024-10-30 Linear_system fonctionne avec un terme source à présent, il ne reste plus qu'à vérifier les équations avant de clore la branche
2024-11-04 deleting old files to replace them with new ones (that are correctly formatted)
    [point46_pression_traité.csv, point46_temperature_traité.csv, point47_pression_traité.csv, point47_temperature_traité.csv, point48_pression_traité.csv, point48_temperature_traité.csv]
2024-11-04 renaming new files as old ones
    [point46_pression_traité.csv, point46_temperature_traité.csv, point47_pression_traité.csv, point47_temperature_traité.csv, point48_pression_traité.csv, point48_temperature_traité.csv]
2024-11-04 Added heat source
2024-11-04 définitions des méthodes sample_random_walk et sampling_DREAM pour utilisation de la méthode compute_mcmc_DREAM avec nb_chain=1
2024-11-04 recoded the method to plot riverbed temperature during measurement period
2024-11-04 Résolution de soucis causés par le merge
2024-11-04 changed two_column_array function, enabling it to work with real data (stocking temp for each sensors)
2024-11-04 Soucis de typo résolus
2024-11-04 printing sigma2 T, sigma2 min max, default in config.py, verifying good functioning with 6, 10 and 20 chains
2024-11-04 Factorisation de la classe allpriors
2024-11-04 add acceptance print statement in demo notebook
2024-11-04 Effectif en monochain et correction de l'initialisation de toutes les couches après le burn in avant la marche aléatoire
2024-11-04 Error des equations
2024-11-05 Version finale de l'ajout du terme source et du passage à un fichier linear_system
2024-11-05 Heat source added in T_stratified
2024-11-06 Ajout de commentaire pour clarifier le code
2024-11-06 Première résolution des bugs du merge avec main
2024-11-06 burning single chain
2024-11-06 integration de PR130 in research/generate_synthetic_cases/demo_genData.ipynb
2024-11-07 generating temperature profile is working
    Solving the problem with the attribute setting of moins log k in layers_list
2024-11-08 Création d'un fichier demoInversion permettant de tester la validité de l'algorithme MCMC
2024-11-13 calibration process
2024-11-14 2 methods burning single chain and burning multiple chain defined within the class column
2024-11-14 adding a temperature dataset
    [point54_temperature_traité.csv]
2024-11-14 modifying a value
    [point54_temperature_traité.csv]
2024-11-15 adding dataset of pressure and temp for a given point
    [point55_pression_traité.csv, point55_temperature_traité.csv]
2024-11-15 changed the point + cleaned up some values
    [point55_pression_traité.csv, point55_temperature_traité.csv]
2024-11-15 erasing data added for presentation, need better treatment (and should be named accordingly to the sensor it represents)
    [point54_temperature_traité.csv, point55_pression_traité.csv, point55_temperature_traité.csv]
2024-11-15 Change dans core.py de plots de temperature à °C
2024-11-15 Changement de fautes d'orthographe dans les commentaires
2024-11-15 Changement de la valeur de q
2024-11-15 Update Calibration of pressure sensor
2024-11-15 sensor figure
2024-11-15 Arduino testing code for LoRaWAN connection is added
2024-11-15 correction d'une ligne de code
2024-11-15 update data
    [point2024-1_P_mesures.csv, point2024-1_T_mesures.csv]
2024-11-15 update data point3
    [point2024-3_P_mesures.csv, point2024-3_T_mesures.csv]
2024-11-15 update data point4
    [point2024-4_T_mesures.csv]
2024-11-15 update data point5
    [point2024-5_T_mesures.csv]
2024-11-15 calibration law 2024-2
2024-11-15 calibration law 2024-1
2024-11-15 Changement de mu dans linear system ligne 39.
2024-11-16 reduce computationnal time for demoPyheatmy.ipynb. Pb with burning and gelman rubin, as well as low quantile which has negative temperature
2024-11-18 demo_genData.ipynb debugged. It was a pb with the display. Better management of the temperature in the plot. Watch in demo_genData.ipynb, the multilayer case need to be validated
2024-11-18 correction of the temperature plot functions with an automatique set up of the temperature zero value based on the required unit K or C. I think there is a bug between nbchain and nb_iter (MCMC in th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
2024-11-25 quantile different for single chain multilayer (but pb in multilayer with the interface). quantile always the same for monolayer single chain. acceptance is 1. everywhere. To be secured
2024-11-28 update point info and notice
    [Point2024-1_info.csv, Point2024-2_info.csv, Point2024-3_info.csv, Point2024-4_info.csv, Point2024-5_info.csv, point2024-3_P_mesures.csv, point2024-3_T_mesures.csv, point2024-4_T_mesures.csv]
2024-11-29 Adaptation du code à la branche main
2024-11-29 mv README heat source
2024-11-30 Mise à jour des quantiles au bon endroit dans la boucle
2024-11-30 la mise à jour des vecteurs de saut dans la Dream MCMC est corrigée, elle est censée être faite après les perturbations sur toutes les chaînes
2024-11-30 rive to relay
2024-12-01 Rectification de la MCMC, les paramètres étaient inchangées tout au long de la MCMC dans les différentes chaînes car le modèle direct était décoré par le wrapper Checker qui gére mal les deepcopies, 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
2024-12-04 mise en facteur de la redéfinition du modèle direct sur les hard copies dans Column.compute_mcmc()
2024-12-04 Détection de NaN dans compute_solve_transi
2024-12-04 Suppression des typeMethods redondantes
2025-03-24 Extending arduino brief user guide to Makefile for linux and all procedure for windows
2025-03-27 Adding hardware folder for building the full device. To be completed
2025-04-29 Adding hardware building files. Need a few more such as the differential pressure measurment board
    [printTemperatureShaft.STL]
2025-04-29 hardware programming of the new proto in progress. Pb for memory allocation of the sensor per slot. Use copilot
2025-05-13 Sensor_demo.ino is compiling. The first npressure analog pins are for pressure differential sensors, while the ntemperature further ones are for temperature sensors. It is configurable before compila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
2025-05-20 adding a printing to see where is the pb
2025-05-20 printing a message in InitialiseLog
2025-05-20 printing messages to identify where the bug is
    [SD_Initializer.cpp]
2025-05-20 Update Device/hardwareProgramming/Presentation Demo/Sensor_demo/Sensor_demo.ino
2025-09-03 Implement LoRa/LoRaWAN emitter classes for CSV sensor data simulation
    [lorawan_sample_data.csv]
2025-09-10 moving olded archive
    [lorawan_sample_data.csv]
2025-09-12 Add comprehensive README files for Arduino sketches and fix CI include paths
    [Sensor_Lora.ino]
2025-09-12 Complete Device folder migration to hardware and fix CI workflows
    [printTemperatureShaft.STL]
2025-10-07 Revise README for clarity and installation steps
    Updated installation instructions and clarified components for Molonaviz and pyheatmy. Enhanced descriptions of data flow and scientific computing features.
2025-10-13 Ajout du notebook pour générer les signaux multi périodiques
2025-10-13 test de push
2025-10-13 Updating the notebook to retrieve alpha parameter
    Adding the FFT for the different sensors and log-fitting to retrieve the exponential decay.
2025-10-13 phase en fonction de la fréquence
2025-10-15 Ajout de features sur le notebook.
    Il reste à implémenter un bon traitement de la phase et à faire le fit sur le déphasage.
2025-10-16 Images Shaft Design
2025-10-16 Design V1.1 shaft - specs
2025-10-16 change location - new folder for Shaft 2025
2025-10-17 Adimensionnement charge hydraulique
2025-10-17 Avancées sur l'analyse des signaux réels (apagnan)
2025-10-17 Add frequency analysis module for temperature data
    Implement frequency domain analysis for temperature data, including methods for finding dominant periods, FFT computation, and estimating attenuation and phase decay coefficients.
2025-10-17 Ajout de la fonction automatique pour trouver les peaks.
    Détection automatique des peaks dans la rFFT avec scipy.signal.find_peaks.
2025-10-17 Refactor depth sensors and enhance data generation
    Updated depth sensor values and adjusted parameters for synthetic data generation. Added R^2 computation for fitting.
2025-10-17 test de pull request
2025-10-17 tentative de pull request
2025-10-17 galere de pull request
2025-10-17 Analyse fréquentielle des signaux reels - version du 17/10/2025
2025-10-17 archivage de l'année 2024
2025-10-17 resolution de merge conflict
2025-10-20 Script de génération de consigne AtmoCONTROL
2025-10-20 Script de génération de consigne AtmoCONTROL (fix)
2025-10-20 mise à jour de Time, Measure et main.cpp pour que tout compile
    [config.csv, config_relay.csv]
2025-10-20 suppr freq_minutes
    [config_sensor.csv]
2025-10-20 integration du rattrapage de clement
    [config_sensor.csv]
2025-10-20 verification de la procedure d_acknowledgement
2025-10-20 modif de relay avec clement
2025-10-20 implémentation de l'adimensionnement partie 2
2025-10-21 vérifications des résultats en cours
2025-10-23 Ajout de la classe et du notebook demo
2025-10-24 cherchons les erreurs
2025-10-24 Modification car il y avait une erreur
2025-10-24 Readme Sensor
2025-10-24 ajout du type de capteur dans config
    [config_sensor.csv]
2025-10-24 Simplified README.md and folder organization
    [printTemperatureShaft.STL]
2025-10-24 l'appellation q pour le terme source a été remplacé par q_s pour 'débit spécifique', et les appelations heatsource, heat_source et q_list ont été remplacées par q_s_list car elles désignaient le même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
2025-10-24 Documentation and sensor calibration
2025-10-24 Code fonctionnel comparant AICC et LRT
    [comparaison_LRT_AICC.csv]
2025-10-24 Refonte du terme source : modification des matrices dans linear_system.py
2025-10-26 schéma soudage circuit Arduino
2025-10-26 Déploiement de méthodes d'analyse des erreurs
    [H_comparaison.csv, H_res_1.csv, H_res_ADIM.csv, H_res_DIM.csv, T_res_1.csv, T_res_ADIM.csv, T_res_DIM.csv]
2025-10-27 ecriture des readme
2025-10-27 que dalle
2025-10-27 suppression offset et scale et idbox
    [config_sensor.csv]
2025-10-27 changement des grandeurs d'adimensionnement
    [H_res_10.csv, H_res_11.csv, H_res_2.csv, H_res_3.csv, H_res_4.csv, H_res_5.csv, H_res_6.csv, H_res_7.csv]
2025-10-27 Updated Measure lib for disactivable sensor power supply (through pin D1)
2025-10-27 modif readme sensor
    [config_relay.csv, config_sensor.csv]
2025-10-27 fin du readme global des librairies
2025-10-27 Ajouts de readme pour comprendre les calculs, suppression d'un fichier superflu
2025-10-27 ajout de paramètre dans le fichier configuration
    [config_sensor.csv]
2025-10-27 Modification pour mise à jour de tout le fich
    er config CSV
2025-10-27 Fixed and added debug in sensor_main
    [main.cpp]
2025-10-27 modif de main.cpp
2025-10-27 Changement de Time pour mise à jour données
2025-10-27 fixed SD.begin issue in lireConfigCSV by adressing CSPin issue
    [main.cpp]
2025-10-27 modif des noms des csv
    [conf_rel.csv, conf_sen.csv]
2025-10-27 partial changes to rename config sensor
2025-10-27 Explications sur les coefficients des conditions aux limites
2025-10-27 Mises des fonctions dans hpp
2025-10-27 Minor changes on notebook_demo_frequentiel. Clarified Stallman and added diference between est params and theo params
2025-10-27 supprimer les fichiers inutiles
2025-10-27 modification pour que main_sensor compile
2025-10-28 doc - components of Arduino card
2025-10-28 changement de format ipynb->md
2025-10-28 changement de dossier
2025-10-29 évolutions des fichiers de test de performances
    [H_res_1.csv, H_res_10.csv, H_res_11.csv, H_res_2.csv, H_res_3.csv, H_res_4.csv, H_res_5.csv, H_res_6.csv]
2025-10-29 Porous material characteristics (excl. specific heat capacity)
    [Caractéristiques matériaux labo.xlsx]
2025-10-29 configuration des intervalles, grosses modifs
    [conf_rel.csv, conf_sen.csv]
2025-10-29 ajout de la fonction 2D via une autre class
2025-10-29 ajout de commentaires sur la classe 2D
2025-10-29 Fixed 1G captor issue
    [main.cpp]
2025-10-29 tout va sarranger
    [config_relay.csv]
2025-10-29 travail de doc
    [config_relay.csv, config_sensor.csv]
2025-10-29 updated measure constructor and created sensor_demo environment
2025-10-29 elaboration fichier demo sensor
    [conf_sen.csv]
2025-10-29 Modification de l'algorithme MCMC pour permettre de fixer la valeur d'un paramètre. Il a fallu modifier certaines parties de l'algorithme pour s'assurer qu'il n'y avait pas de divisions par zéro liée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
2025-10-29 reparation du main de sensor pour corriger le bug de rattrapage
    [main.cpp]
2025-10-29 reaparé 😭 ?
2025-10-29 correction demo sensor
2025-10-29 ajout du reveil pour la prochaine communication
2025-10-29 enlevé les "while true" de l'année dernière
2025-10-29 Déplacement Excel
    [Caractéristiques matériaux labo.xlsx]
2025-10-31 correction du main sensor et relay
    [main.cpp]
2025-10-31 Modification de demoInversion.ipynb pour le rendre fonctionnel
2025-10-31 corrections lora et main
    [main.cpp]
2025-10-31 Ajustements des sigma des priors dans les fichiers de démo
2025-10-31 supression millis
2025-10-31 tout cassé
    [conf_sen.csv]
2025-10-31 recuperation du fichier config sur le sennsor
    [conf_sen.csv]
2025-10-31 correction demo_sensor_main avec fichierConfig
    [demo_sensor_main.cpp]
2025-10-31 enable pin set to 4 and updated Measure constructor
2025-10-31 ajout des fonctions Elyès (décodeur flux MQTT et logger)
2025-10-31 mise a jour git ignore et suite correction main_relay
    [main.cpp]
2025-10-31 Gros debugging pour bien comprendre ce qui fonctionnait ou non; les messages de debug n'apparaissent pas toujours
2025-10-31 Update file paths for Arduino validation checks
2025-10-31 ajout des classes gayteway et relay dans le fichier containers
2025-11-01 fusion des fichiers config et correction de bugs mineurs
    [conf.csv, conf_rel.csv, conf_sen.csv]
2025-11-01 switch folders
2025-11-01 chgt noms de fichiers pour valider workflows
2025-11-03 suite fusion config et transformation id_box en devEUI
    [conf.csv]
2025-11-03 chgt de dossier
    [Caractéristiques matériaux labo.xlsx, printTemperatureShaft.STL]
2025-11-03 Fix sensor Arduino file path in validation workflow
    Updated sensor Arduino file path to lowercase.
2025-11-03 Add README for Arduino sensors executable directory
2025-11-03 fixed problem in waiter (discarded delayUntill and startTimer) and cleaned some debug
    [demo_sensor_main.cpp, main.cpp]
2025-11-03 Add files via upload
    Code pour pouvoir lire les données de ce fichier.
2025-11-03 ajout du critere 2D de Babé
2025-11-03 Modification de la gestion des bornes dans l'algorithme MCMC. -si les bornes sont de même signe et ont sont d'ordres de grandeur différents, on transforme avec log10 -si les bornes sont de signe diff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
2025-11-03 ajustements adapt_nodered_mqtt (problèmes de gestion des configs TLS)
2025-11-03 correction de la place du curseur
    [main.cpp]
2025-11-03 Modifications des paramètres de snoteboooks de demo
2025-11-03 remi a toi de jouer
2025-11-03 adaptation pour la com entre relay et sensor
    [conf.csv, config_relay.csv]
2025-11-03 avancees dans la communication des devices
2025-11-03 Readme du sensor presque bouclé (à voir quand ça marchera)
    [conf.csv]
2025-11-03 avancee vers communication
    [conf.csv]
2025-11-03 PANIC COMMIT, DEV IN PROGRESS, SENSOR MAIN = DANGER ZONE
2025-11-03 deviceEUI failure fixed
2025-11-03 Ajouts Modifs moinslog10IntrinK
    [H_res_10.csv]
2025-11-03 change ERD_structure.sql to add relay, gateway and devices table
2025-11-03 map de la nouvelle database Molonaviz
2025-11-03 modif du relay
2025-11-03 VERY IMPORTANT FIX : enable Pin = 4 and not 1
    [demo_sensor_main.cpp]
2025-11-03 fin de reparation main relay
2025-11-03 modification de platform.ini
2025-11-03 small changes to main case
2025-11-03 adim sans qs
    [H_comparaison.csv, H_res_1.csv, H_res_2.csv, H_res_ADIM.csv, H_res_DIM.csv, T_res_1.csv, T_res_2.csv, T_res_ADIM.csv]
2025-11-03 test de handshake
2025-11-03 Resolved Panic commitS (created sendAllPacketsAndManageMemory and sendAllPackets, which is not used so far)!! commented Waiter::sleepUntill which seems to be useless updated main_sensor and demo_main
    [demo_sensor_main.cpp, main.cpp]
2025-11-05 Mise à jour de l'API pour suivre les dernières modifications Modification de certaines valeurs par défaut dans config.py pour la cohérence physique
2025-11-05 correction du handshake et ajout dans le code de sensor
    [demo_sensor_main.cpp, main.cpp]
2025-11-05 Revert "204 adimensionnement des équations"
    [lorawan_sample_data.csv]
2025-11-05 "mise a jour des methodesde StudyAndLabManager pour ajouter,selectionner et editer les gayteways,relais et devices"
2025-11-05 Correction alpha dans linear_system, et modification de la valeur dans config.py
2025-11-05 bon nombre de token dans le reader pour lire capteur
2025-11-05 Changement de \alpha dans le readme de linear system
2025-11-05 ajout de fonction test
2025-11-05 minor change (serial.print -> debug)
2025-11-05 correction frequence de communication
    [demo_sensor_main.cpp]
2025-11-05 supression de sleep relai
2025-11-05 debug intense (jenaimarre)
    [conf.csv]
2025-11-05 correction de sleepuntil a poursuivre
    [demo_sensor_main.cpp]
2025-11-05 Delete pyheatmy/frequentiel_real_data.ipynb
    Fichier qui posait problème pour pull request des résultats du groupe fréquentiel ; Fichier obsolète dont on a pas besoin
2025-11-05 6 incoming fields, theorical Molonaviz db insertion
2025-11-05 components for relay
2025-11-07 Functional actual database insertion
2025-11-07 modification de LoraCom pour des et adresse
2025-11-07 tentative de reparation de receivePacket
2025-11-07 reparation de receive packet
2025-11-07 "device configurator to add new gateway, realy and device to the database"
2025-11-07 galere de adresse
2025-11-07 "change the structure of the Thermometer table to add calibration parameters beta and V."
2025-11-07 "change SPointCoordinator to add thermometer calibration methods"
2025-11-07 Tested automatic database construction and filling
    [Datalogger.csv, Gateway.csv, Labo.csv, PressureSensor.csv, Relay.csv, SamplingPoint.csv, Shaft.csv, Study.csv]
2025-11-07 correction de AllPackets receive et send
    [main.cpp]
2025-11-07 correction envoie le bon payload de ack dans receiveAllPackets
2025-11-07 euh test debug toujours sur les memes fonctions
2025-11-07 "add the conversion from raw voltage to temperature before the insertion of payload"
2025-11-07 calcul auto des paramètres d'adim
2025-11-07 j'ai remis la fonction idle et j'ai crée demo_relay
    [conf.csv]
2025-11-07 demo relay dans le ini
2025-11-07 GUI to add virtual equipment
    [Labo.csv, SamplingPoint.csv, Thermometer.csv]
2025-11-07 creation d'une fonction logstring qui est l'equivalent de logdata pour le relais et modification d'une main_relay en conséquence
2025-11-07 include reader dans lorawan pour qu'il connaisse memory_line
2025-11-07 adaptation du main relay pour la nouvelle sendAllPacketsAndManageMemoryWAN
2025-11-07 demo sensor relay mis a jour
2025-11-10 ajout d'un parametre pour force la température d'aquiphère (nécessaire pour augmenter le réalisme de genData)
2025-11-10 probleme de curseur ouvert
    [demo_relay_main.cpp]
2025-11-10 "update Thermometercalibration functions in SPointCoordinator"
    [Thermometer.csv]
2025-11-10 essai de réparation de sendallpackets
2025-11-10 changements place des ipynb jusqu'à research
2025-11-10 modification du nom des variables
2025-11-10 Structure refactoring
    [Datalogger.csv, Gateway.csv, Labo.csv, PressureSensor.csv, Relay.csv, SamplingPoint.csv, Shaft.csv, Study.csv]
2025-11-10 reparation LoraWan ?
    [conf.csv]
2025-11-10 Tentative de reparation suivante
2025-11-10 Clarified debugs, reduced demo time intervals, fixed line duplication bug in logData, fixed rattrapage bug
    [conf.csv]
2025-11-10 ajout des sauts de ligne
2025-11-11 commentaires + suppression de toutes les focnctions inutiles dans le code adim
2025-11-12 j'ai oublié les modifs que j'avais faire
2025-11-12 debug de paul
2025-11-12 bon intervalle de temps pour commencer la comunication lora dans demo_sensor_main
2025-11-12 updateconfig en commentaire pour la démo
2025-11-12 changements avec plus de moinslog10IntrinK
2025-11-12 shorten demo intervals
    [conf.csv]
2025-11-12 probleme de SDoffset résolu en rajoutant un seek après l'ouverture du fichier
    [demo_sensor_main.cpp, main.cpp]
2025-11-12 changement de la convention pour DH_0
2025-11-12 modifs pour recevoir uid dans la gateway
2025-11-12 ajoute les champs necessaires a l'etalonnage des thermoetre dans l'interface de configuration des devices
2025-11-12 LED_BUILTIN blinks
2025-11-12 correction du meme probleme d'envoie double grace à un seek dans le relais aussi
    [demo_relay_main.cpp]
2025-11-13 netooyage/organisation des fichiers hardware
    [Bout tige.step, Bout tige.stl, Caractéristiques matériaux labo.xlsx, Embout tige.step, Embout tige.stl, Partie centrale.step, Partie centrale.stl, printTemperatureShaft.STL]
2025-11-14 transformation de field-code en firmware
    [conf.csv]
2025-11-14 deplacement de 2026
2025-11-14 readme général sur les fichiers demo/sensor/relay
2025-11-14 architecture git
    [Bout tige.step, Bout tige.stl, Embout tige.step, Embout tige.stl, Partie centrale.step, Partie centrale.stl, cover.stl, printTemperatureShaft.STL]
2025-11-14 Incoming data to Voltage, fix voltage to temperature formula
    [Thermometer.csv]
2025-11-14 plus de ide
2025-11-14 Fix Arduino file paths and comment out doc checks
    Updated file paths for Arduino files and commented out documentation checks.
2025-11-14 ceci est un commit de mise au propre de tous les programmes. ATTENTION Les programmes de ce commit n'ont pas été testés si ça ne compile pas bien revenez au GOLDEN COMMIT
2025-11-14 mise a jour des read me et merge avec le main
2025-11-14 Changements de lieu fichiers + changement nom GenData et GenData2024
2025-11-16 ReadMe + organistion dossiers
    [Bout tige.step, Bout tige.stl, Embout tige.step, Embout tige.stl, Partie centrale.step, Partie centrale.stl, printTemperatureShaft.STL, tige full (sans vis) - fichier à imprimer.stl]
2025-11-16 calibration temperature sensor
2025-11-16 doc pertes de charge
2025-11-16 new diagram circuit
2025-11-17 Hardware calibration 2025
2025-11-17 Hardware calibration 2025 updates
2025-11-19 shaft folder updated
2025-11-19 shaft updated
2025-11-23 updated relay folder VF
2025-11-23 temperature calibration VF
    [tests_beta_temperature.csv]
2025-11-23 pressure sensor README
2025-11-24 VF Readme Shaft
2025-11-26 Update README with sensor connection details
    Added information about sensor connections and electronics.
2025-11-26 Update sensor box description in README.md
    Removed the depth limitation detail for the sensor box.
2025-12-04 Fix battery life consistency and file path formatting in TRL assessment
2026-10-07 Clean CGS-MOLO branch for cgitsync admin
    [2022S1.csv, 2022T1.csv, BOISSY-METEO_OCT.csv, Bout tige.step, Bout tige.stl, Data_meteo.xlsx, Datalogger.csv, Embout tige.step]
2026-10-21 fix(cgs): branche par défaut CGS-MOLO pour tous les dépôts du banc
2026-10-30 feat(cgs): manifeste install-orx.cgs de la chaîne locale (T9)
    Monte les dépôts existants dans la structure cible, sans déplacer de code. Testé par cgitsync bootstrap dans un dossier vide.
2026-10-30 feat(demo): script de la chaîne complète sur Point034 (T13)
    scripts/demo_lundi.sh enchaîne bootstrap, lab build, run, report et requêtes au
    niveau user, compare ask et curl, et vérifie le refus hors périmètre. S'arrête à
    la première étape en échec. Refuse un port déjà occupé, pour ne pas interroger
    un autre serveur.
2026-10-30 fix(cgs): MOLONARI-TWIN n'est plus marqué privé (démo B)
    Le dépôt est public. Avec private = true, cgitsync le traitait en lecture seule :
    add, commit et push ne l'atteignaient pas, ce qu'exige la démo B.
2026-11-06 feat(demo): chaîne de la démo selon la disposition à 4 niveaux (T8)
    lab.yaml est dans le sous-dépôt description du lab. Le script contrôle les
    résultats et le registre par twin, generation.yaml écrit par report, puis suit
    le parcours de chaque niveau : reports list|show|chains et generate (user),
    twin de σ dans un operating space avec la graine du dev et rapport local
    --forward (dev), en vérifiant que public_reports/ n'a pas bougé et que la
    graine de référence n'est pas copiée. TWIN_CLI et PYTHON permettent d'essayer
    un autre code que celui de l'espace de travail. Le manifeste dit que la
    disposition de MOLONARI-TWIN est celle des futurs sous-dépôts.
2026-11-06 chore(demo): chemin de l'espace molonari_desk dans demo_lundi.sh
2026-11-07 chore(cgs): plus de pyheatmy dans l'espace de l'OPX
    Décision du 2026-11-07 : pyheatmy n'est plus monté dans l'operating
    space du twin. Le twin n'embarque que son moteur JAX. Le lot Y1 fige
    pyheatmy et bayesian_inversion par commit dans uv.lock de MOLONARI-API,
    pour les tests seulement ; les tests de pyheatmy vivent dans
    MOLONARI-computo.
    Retirés : le montage de MOLONARI-computo dans install-orx.cgs, le
    chemin éditable pyheatmy et ses tâches test-pyheatmy et test-notebooks
    dans pixi.toml, le job test-pyheatmy de la CI, et les commandes
    correspondantes dans INSTALL.md. pixi résout tous ses environnements,
    et un chemin éditable absent fait échouer même un environnement
    no-default-feat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
2026-11-08 feat(cgs): operating space simu-direct pour l'expérience SIMU (T11)
    But : reproduire au bit le twin direct de Point034 entre deux Mac M1.
    Chaque machine monte un espace neuf (simu-direct.cgs), calcule le twin,
    exporte le résultat dans le dépôt SIMU (reproduce --export), puis le
    compare aux exports des autres machines (reproduce --compare).
    Pas de pyheatmy ni de hardware dans l'espace. pixi gagne un
    environnement `simu` (uv seul) et une tâche `simu-direct` ; .gitignore
    ignore SIMU et .pixi/.
    `run` est lancé sans --strict : strict_problems refuse toute
    pré-version (E_STRICT_PRERELEASE), donc --strict échouerait toujours en
    0.9.0-alpha.N. Le script fait lui-même les contrôles utiles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
2026-11-11 MOLONARI1D-1.0.6: the molonari.io front page now says: low-tech stream-aquifer exchanges monitoring, from self-built sensors to multi-chain bayesian inversion memorized in always accessible git repos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
2026-11-11 MOLONARI1D-1.0.7: molosite push no longer fails on a page it created earlier and records the id of every page it creates; the front page tagline now reads: low-tech stream-aquifer exchange monitoring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
