flipoyo/MOLONARI1D/hardware/specs/v2-2025/electronic connexion/Images/circuit_sensors_back.jpg

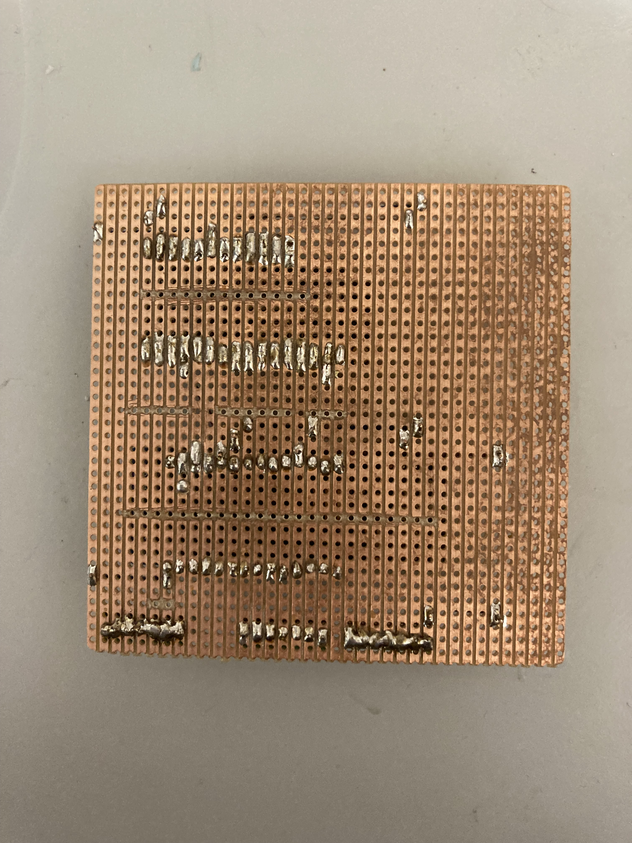
[picture p5: hardware/specs/v2-2025/electronic connexion/Images/circuit_sensors_back.jpg]
hardware/specs/v2-2025/electronic connexion/Images/circuit_sensors_back.jpg
