flipoyo/MOLONARI1D/hardware/specs/v2-2025/electronic connexion/Images/circuit_relai_back.jpg

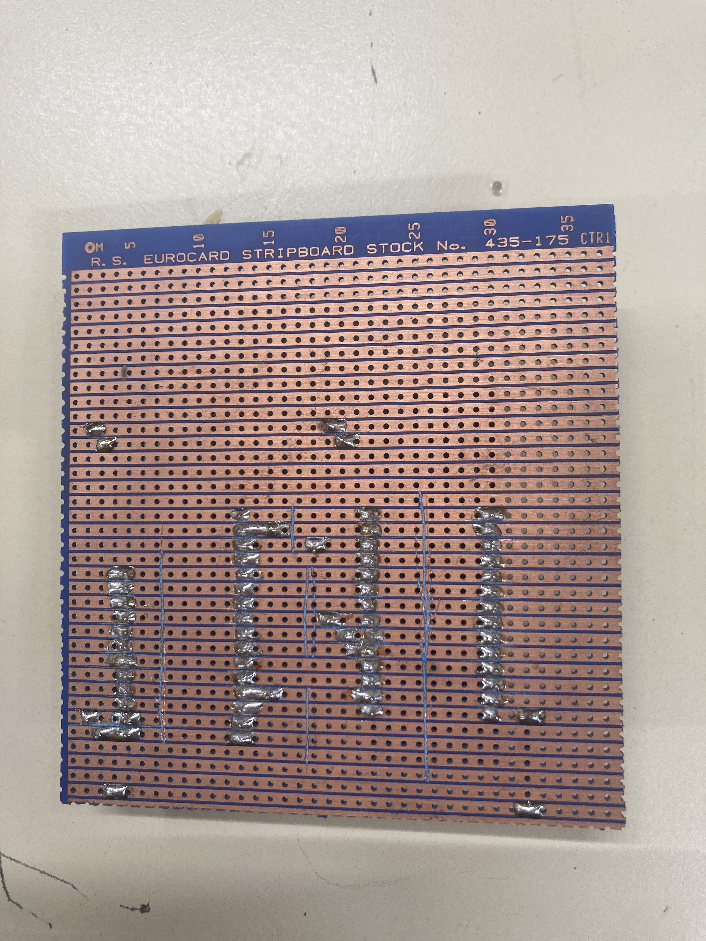
[picture p9: hardware/specs/v2-2025/electronic connexion/Images/circuit_relai_back.jpg]
hardware/specs/v2-2025/electronic connexion/Images/circuit_relai_back.jpg
